Weisni/BatterySentinel-N2K/hardware/altium-r5/enclosure/README.md

# Orion R5 enclosure

The current enclosure uses the 52 x 36 mm Orion R5 PCB, independent PCB supports, screw-fastened service covers, continuous TPU seals and a replaceable cable cartridge.

- [Printing, hardware, assembly and acceptance checks](sealed-print/README.md).
- [Prepared Bambu P2S four-plate project](sealed-print/Orion-R5-P2S-flush-colour.3mf) with a flush two-colour PETG lid and separate PETG/TPU trial plates.
- [Plate and filament setup](sealed-print/flush-colour/README.md).
- [Illustrated assembly manual](../../../output/pdf/Orion-R5-Enclosure-Assembly-Manual-EN.pdf).
- [Optional P2S process presets](sealed-print/awesome-ai-profiles/README.md).

## Progress and open checks

CAD and native slicing checks are complete. Confirm the purchased inserts and screws, measure the delivered cable, print the trial pieces, and check the actual board and USB plug fit. Test cable retention and the empty enclosure for the intended splash exposure before fitting electronics. Closed-case temperature, radio reception and repeated service cycles remain physical acceptance work. No IP rating is claimed.
