Weisni/BatterySentinel-N2K/hardware/altium-r5/procurement/README.md

# PCB customs payment evidence

The [original DHL invoice](2026-09-30-DHL-PCB-customs-invoice.pdf), dated 2026-09-30, was supplied by the user as evidence for the paid PCB customs charge. It describes the shipment as "Layer 2 Printed circuit board" and totals **EUR 23.85**:

- Customs duty: EUR 6.00.
- Duty Tax Processing: EUR 15.00 plus EUR 2.85 VAT, totaling EUR 17.85.

Payment is confirmed by the user's instruction; the PDF itself is an invoice and contains no separate payment confirmation. The original file is preserved unchanged and contains personal billing details.

The EUR 23.85 was already included in the project's **EUR 196.64** recorded costs and is counted once. Confirmed paid costs are now **EUR 122.27**; Amazon costs of EUR 74.37 remain payment-unconfirmed. See the [procurement record](../lcsc-order-2026-09-24.md) and [project cost table](../../../README.md#recorded-procurement-costs).

Completed: archived the original invoice, verified identical SHA-256 hashes, and reconciled payment status on 2026-09-30. No further task remains for this evidence attachment. Delivery inspection, assembly and physical acceptance remain tracked in the [hardware README](../README.md#open-work).
