Weisni/BatterySentinel-N2K/output/internal/engineering/README.md

# Internal engineering exports

These drawings are preserved design studies, not released product documentation or evidence of built hardware. Use the current Orion Bridge manuals under `output/pdf` for installation and assembly.

- [Initial interface and PCB drawing study](orion-bridge-schaltplan-pcb-entwurf.pdf).
- [Project-internal records](../../../docs/internal/README.md).

The drawing PDF was relocated without changing its contents. Its generator now writes here so future engineering runs keep it out of the user-manual folder.
