Weisni/BatterySentinel-N2K/output/firmware/1.1.0/README.md

# Project-internal firmware test archive — 1.1.0

This folder preserves an engineering test state. It is not a current user
release or a record of another hardware product. For installation, use the
[current Orion Bridge download](../1.1.4/README.md).

Preserves the SuperMini HTTPS OTA round-trip test build, including the original file hash and the recorded settings-retention checks.

- Archived SuperMini test artifact: [orion-dongle-1.1.0.bin](orion-dongle-1.1.0.bin).
- File size: 1,768,416 bytes.
- Local artifact checksum: [SHA256SUMS.txt](SHA256SUMS.txt).
- Exact original notes and checksum records: [internal archive index](../../internal/firmware/README.md).

```text
bd076a146cf98d6f0851fad0ee62fd6c4aa47f4bf6652cbbfb0eb98cb3d6e003
```

The original records were retained without editing. Any installation language or
hardware comparisons inside those snapshots are historical internal notes,
not current download instructions or evidence of existing alternative hardware.
