Weisni/BatterySentinel-N2K/output/firmware/1.1.1/README.md

# Project-internal firmware test archive — 1.1.1

This folder preserves an engineering test state. It is not a current user
release or a record of another hardware product. For installation, use the
[current Orion Bridge download](../1.1.4/README.md).

Preserves the SuperMini password-verification and portal-request scheduling test build, including the measured performance and installed-image record.

- Archived SuperMini test artifact: [orion-dongle-1.1.1.bin](orion-dongle-1.1.1.bin).
- File size: 1,773,216 bytes.
- Local artifact checksum: [SHA256SUMS.txt](SHA256SUMS.txt).
- Exact original notes and checksum records: [internal archive index](../../internal/firmware/README.md).

```text
8ff55342b3527455e586c338b41baa7d8ab720cb11f0bdb1c1ce43f1e6752552
```

The original records were retained without editing. Any installation language or
hardware comparisons inside those snapshots are historical internal notes,
not current download instructions or evidence of existing alternative hardware.
