Weisni/BatterySentinel-N2K/output/firmware/1.1.2/README.md

# Project-internal firmware test archive — 1.1.2

This folder preserves an engineering test state. It is not a current user
release or a record of another hardware product. For installation, use the
[current Orion Bridge download](../1.1.4/README.md).

Preserves the SuperMini local-address, certificate and service-Wi-Fi test build. Its recorded LED behavior belongs to that historical firmware state.

- Archived SuperMini test artifact: [orion-dongle-1.1.2.bin](orion-dongle-1.1.2.bin).
- File size: 1,804,992 bytes.
- Local artifact checksum: [SHA256SUMS.txt](SHA256SUMS.txt).
- Exact original notes and checksum records: [internal archive index](../../internal/firmware/README.md).

```text
1db128bc51b3b4618e80536fa53f0aa17adc7aeb643bdfc37645b8c0b04135cc
```

The original records were retained without editing. Any installation language or
hardware comparisons inside those snapshots are historical internal notes,
not current download instructions or evidence of existing alternative hardware.
