Weisni/BatterySentinel-N2K/output/firmware/1.1.3/README.md

# Project-internal firmware test archive — 1.1.3

This folder preserves an engineering test state. It is not a current user
release or a record of another hardware product. For installation, use the
[current Orion Bridge download](../1.1.4/README.md).

Preserves the SuperMini password-change, BOOT-confirmed recovery and service-readiness LED test build. Build-time verification statements remain in the original record; they are not a claim about later installation or acceptance.

- Archived SuperMini test artifact: [orion-dongle-1.1.3.bin](orion-dongle-1.1.3.bin).
- File size: 1,823,184 bytes.
- Local artifact checksum: [SHA256SUMS.txt](SHA256SUMS.txt).
- Exact original notes and checksum records: [internal archive index](../../internal/firmware/README.md).

```text
5c0800e8cf8a0f70b3c1b042846b375c4ac750d5371a18a419056f80fb97735e
```

The original records were retained without editing. Any installation language or
hardware comparisons inside those snapshots are historical internal notes,
not current download instructions or evidence of existing alternative hardware.
