Weisni/BatterySentinel-N2K/docs/enclosure-filament-colours.md

# Enclosure filament colour shortlist

Research date: 2026-09-25. These are purchase candidates, not recorded purchases. Prices below are the displayed web listings, include the listing's VAT and exclude shipping; cached listings and destination tax can differ from checkout. Stock has not been guaranteed.

## Project palette

The current palette in `src/BridgePortalUi.h` and `assets/battery-sentinel-orion-logo.svg` is navy `#071521`, mint/teal `#68E3D1`, light blue `#8ABFFD`, and near-white `#F1F7F8`.

Recommended two-colour arrangement: navy PETG body and lid, mint PETG flush logo and lettering. White is an alternative marking colour. The current lid groups logo and lettering into one contrasting material; independently colouring them would require another artwork split.

## Purchase candidates

All selected variants use 1.75 mm PETG. RAL references are manufacturer declarations, not conversions of the project's HEX codes or measured print matches.

| Role | Product and declared colour | Pack | Displayed price | Purchase link |
| --- | --- | --- | --- | --- |
| Body and lid | Extrudr PETG marine blue, RAL 5003 | 1.1 kg | EUR 19.50 promotional price on the Austrian listing, including Austrian VAT | [Exact manufacturer variant](https://www.extrudr.com/de/at/products/petg/?variant=UHJvZHVjdFZhcmlhbnQ6MTU4NQ%3D%3D) |
| Logo and lettering | Devil Design PETG Mint, RAL 6027 | 1 kg | EUR 21.90 | [Filamentoes](https://filamentoes.de/products/petg-mint-minze-1-kg-devil-design-filament-1-75-mm) |
| Alternative lettering | Devil Design PETG White, RAL 9003 | 1 kg | EUR 21.90 | [Filamentoes](https://filamentoes.de/products/petg-white-weiss-1-kg-devil-design-filament-1-75-mm) |

Extrudr's [German product page](https://extrudr.com/de/de/products/petg/) also offers the marine-blue selection; select marine blue, 1.75 mm and 1.1 kg. The exact Austrian variant identifies SKU 9010241023141. Its displayed price is not a confirmed German checkout total. The [Devil Design product card](https://devildesign.com/download/PET-G_-_product_card.pdf), page 2, identifies Mint as RAL 6027 and White as RAL 9003.

Marine blue and Mint are practical aesthetic approximations. Marine blue is brighter than the nearly black portal navy, and Mint is more muted than the luminous screen teal. No exact printed match is claimed and no unverified filament HEX values are assigned.

## Progress and open checks

- Palette checked against the current project source; manufacturer colour references and purchase listings located.
- Current 3MF remains unchanged. In the existing mapping, rigid PETG is slot 1, TPU is slot 2, and contrasting PETG is slot 3.
- Before printing the full lid, test the chosen PETG combination for adhesion, opacity through the existing 0.4 mm artwork depth, and purge settings. Keep the existing separate TPU gasket workflow.
- Physical colour, print fit, sealing and enclosure acceptance remain unverified.
