Weisni/BatterySentinel-N2K/output/releases/RELEASE-STATUS.md

# Project-internal hardware export archive

This directory contains historical engineering ZIP exports and verification
records for the unbuilt R4 WROOM design. These files are not user downloads,
manufacturing instructions for the actual device, or evidence of an existing or
previously released hardware product. Do not order or assemble these archives.
The ZIP files, checksum list and verification record remain unchanged.

## Current Orion Bridge status — 2026-10-10

Parts were ordered and PCB manufacture commissioned on 2026-09-25. The user
reported the first Orion-R5 assembled on 2026-10-10, with USB, service Wi-Fi and
portal setup working. Initial 12 V operation without CAN is reported; complete
power/isolation, enclosure and NMEA/Garmin acceptance remain open.
See the [current hardware record](../../hardware/altium-r5/README.md) and
[procurement report](../../hardware/altium-r5/lcsc-order-2026-09-24.md).

[Firmware 1.2.0 is officially published](https://github.com/Weisni/BatterySentinel-N2K/releases/tag/v1.2.0)
as Latest; [its publication record](../../docs/releases/1.2.0-verification.md)
records exact-commit CI and six verified public downloads. Software publication
does not complete hardware commissioning. The [current issue status](../../docs/internal/backlog-status-2026-10-10.md)
distinguishes remaining work from superseded concepts. None of this alters or
approves the archived hardware ZIPs.

## Preserved historical status

The exact previous text is retained in
[RELEASE-STATUS-before-cleanup-2026-09-26.txt](RELEASE-STATUS-before-cleanup-2026-09-26.txt).
Its references to withdrawn packages and ongoing planning are historical
internal notes. They must not be read as the current procurement state or as a
list of actual hardware products.
