Weisni/BatterySentinel-N2K/assets/branding/battery-sentinel.png

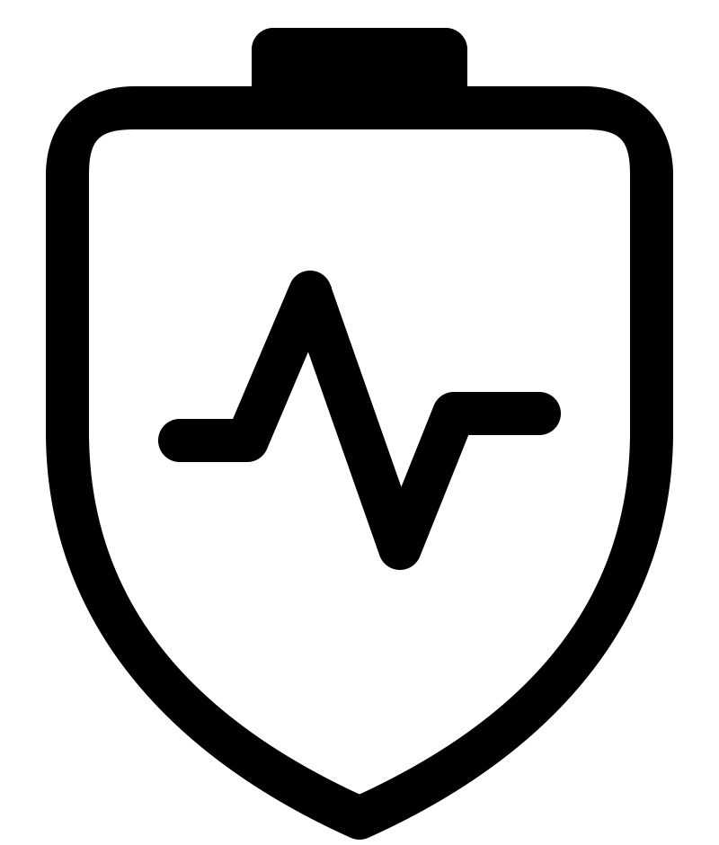
assets/branding/battery-sentinel.png
