Weisni/BatterySentinel-N2K/assets/branding/branding-preview.png

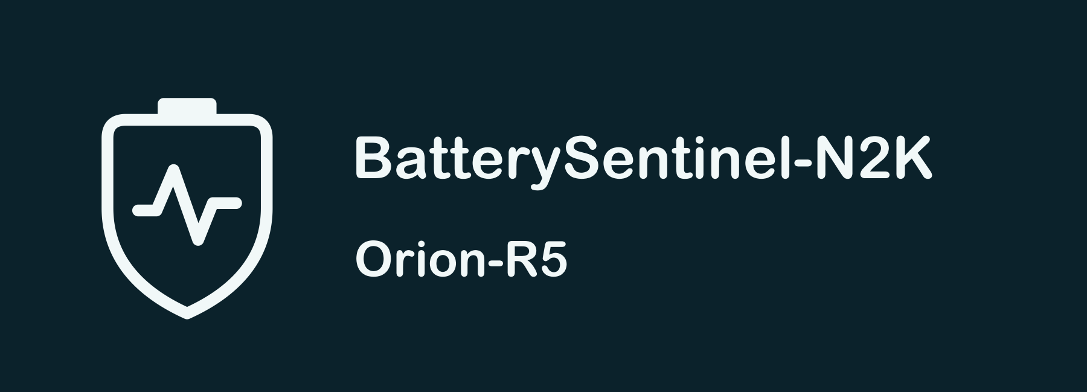
assets/branding/branding-preview.png
