Weisni/BatterySentinel-N2K/docs/manual-assets/portal-overview.png

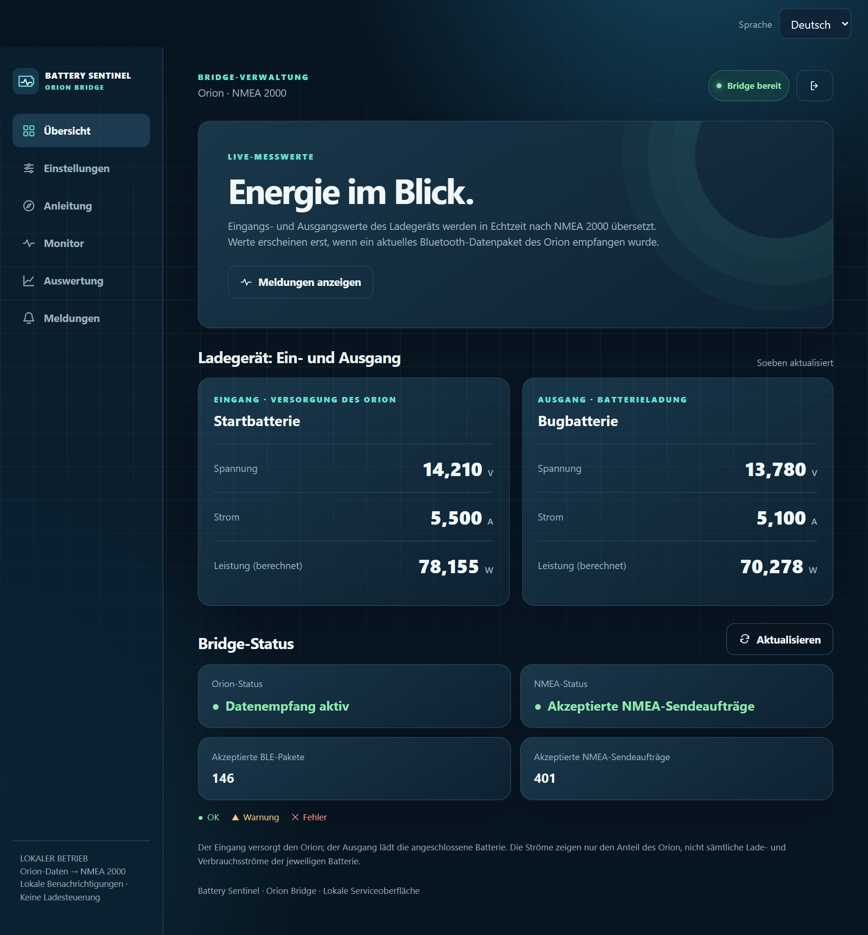
docs/manual-assets/portal-overview.png
