Weisni/BatterySentinel-N2K/hardware/altium-r2/Schaltplan-R2-Vorschau.png

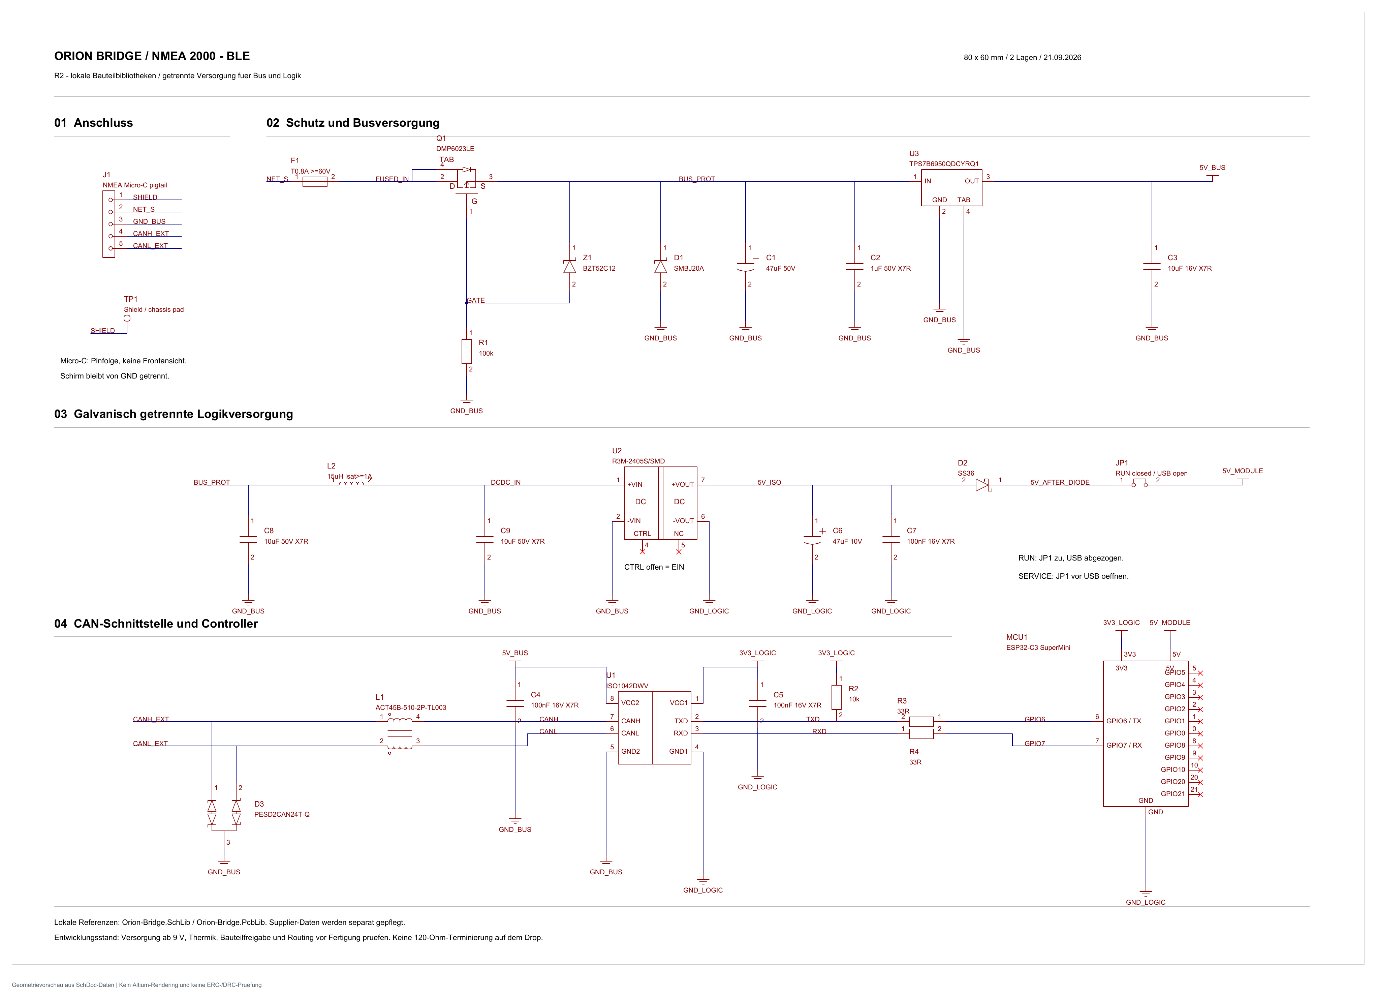
hardware/altium-r2/Schaltplan-R2-Vorschau.png
