Weisni/BatterySentinel-N2K/hardware/altium-r3/Altium-Schaltplan-PCB-Abgleich.png

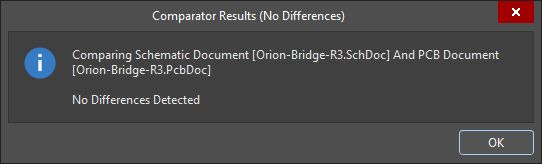
hardware/altium-r3/Altium-Schaltplan-PCB-Abgleich.png
