Weisni/BatterySentinel-N2K/hardware/altium-r3/Leiterplatte-R3-Kupfer.png

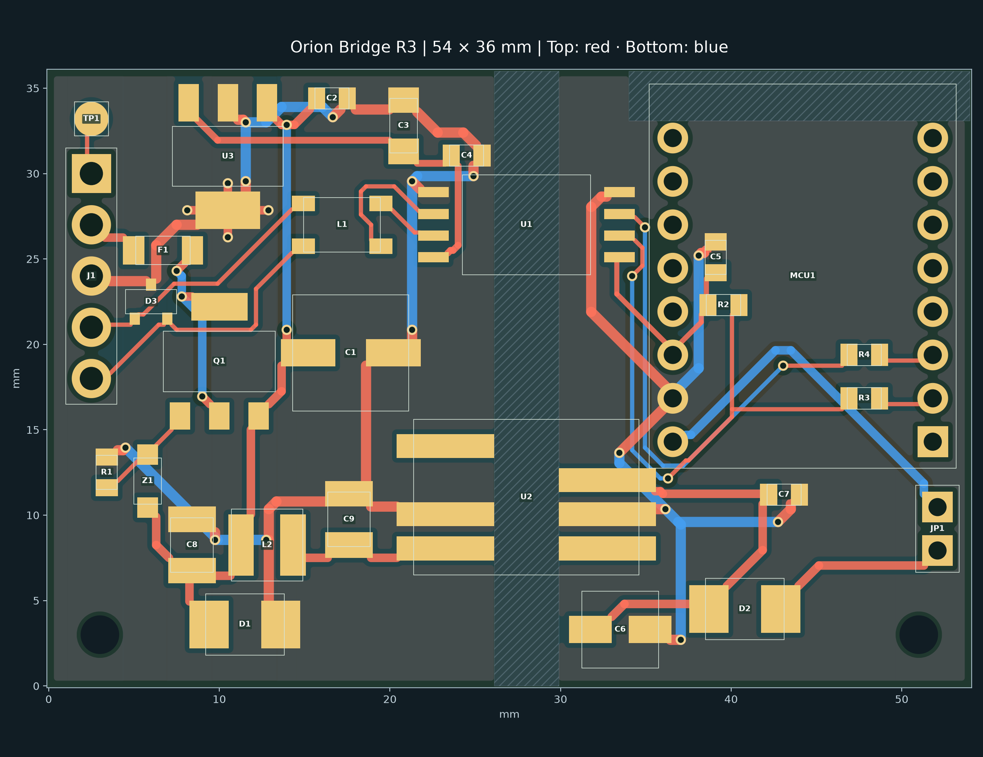
hardware/altium-r3/Leiterplatte-R3-Kupfer.png
