Weisni/BatterySentinel-N2K/hardware/altium-r3/PCB-R3-3D-Draufsicht.png

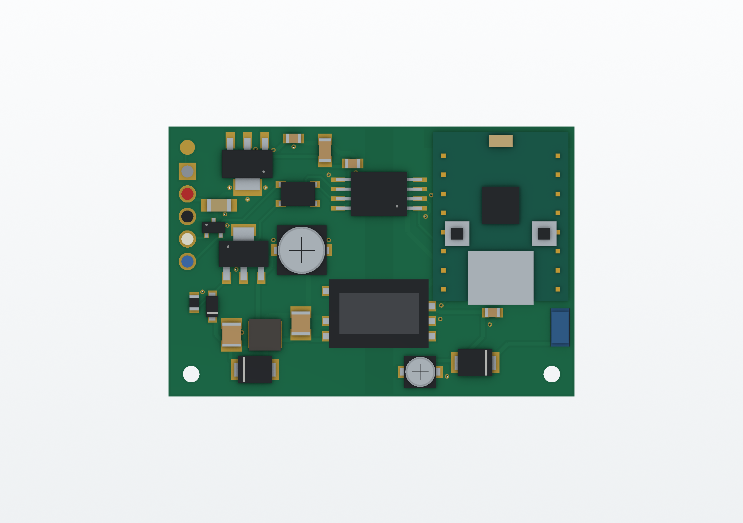
hardware/altium-r3/PCB-R3-3D-Draufsicht.png
