Weisni/BatterySentinel-N2K/hardware/altium-r3/PCB-R3-3D-Unterseite.png

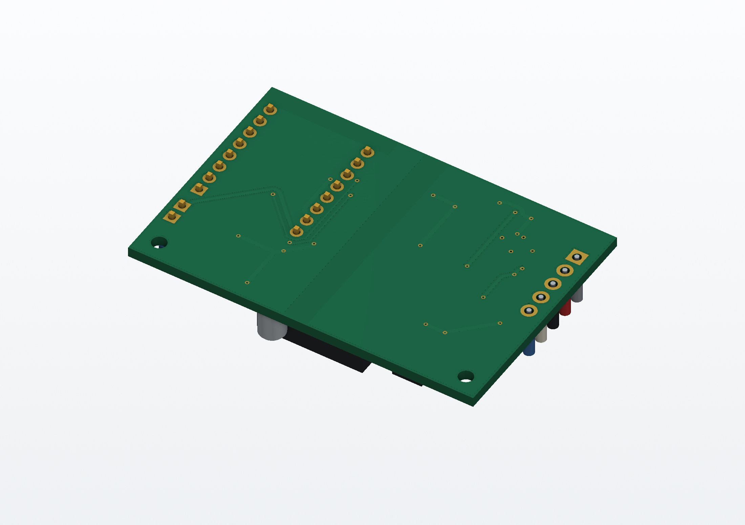
hardware/altium-r3/PCB-R3-3D-Unterseite.png
