Weisni/BatterySentinel-N2K/hardware/altium-r4/3d-views/PCB-R4-3D-Unterseite.png

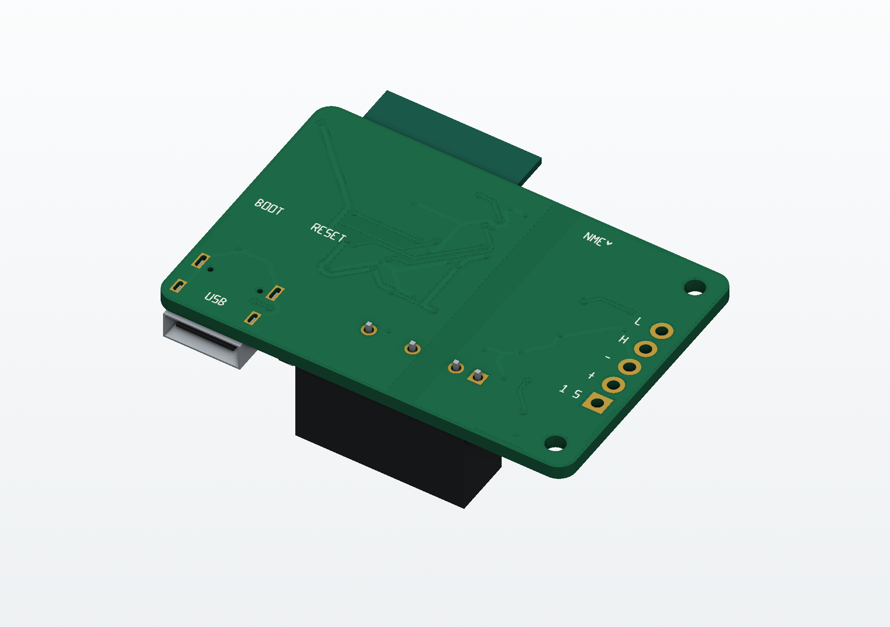
hardware/altium-r4/3d-views/PCB-R4-3D-Unterseite.png
