Weisni/BatterySentinel-N2K/hardware/altium-r4/Schaltplan-R4-Logic.png

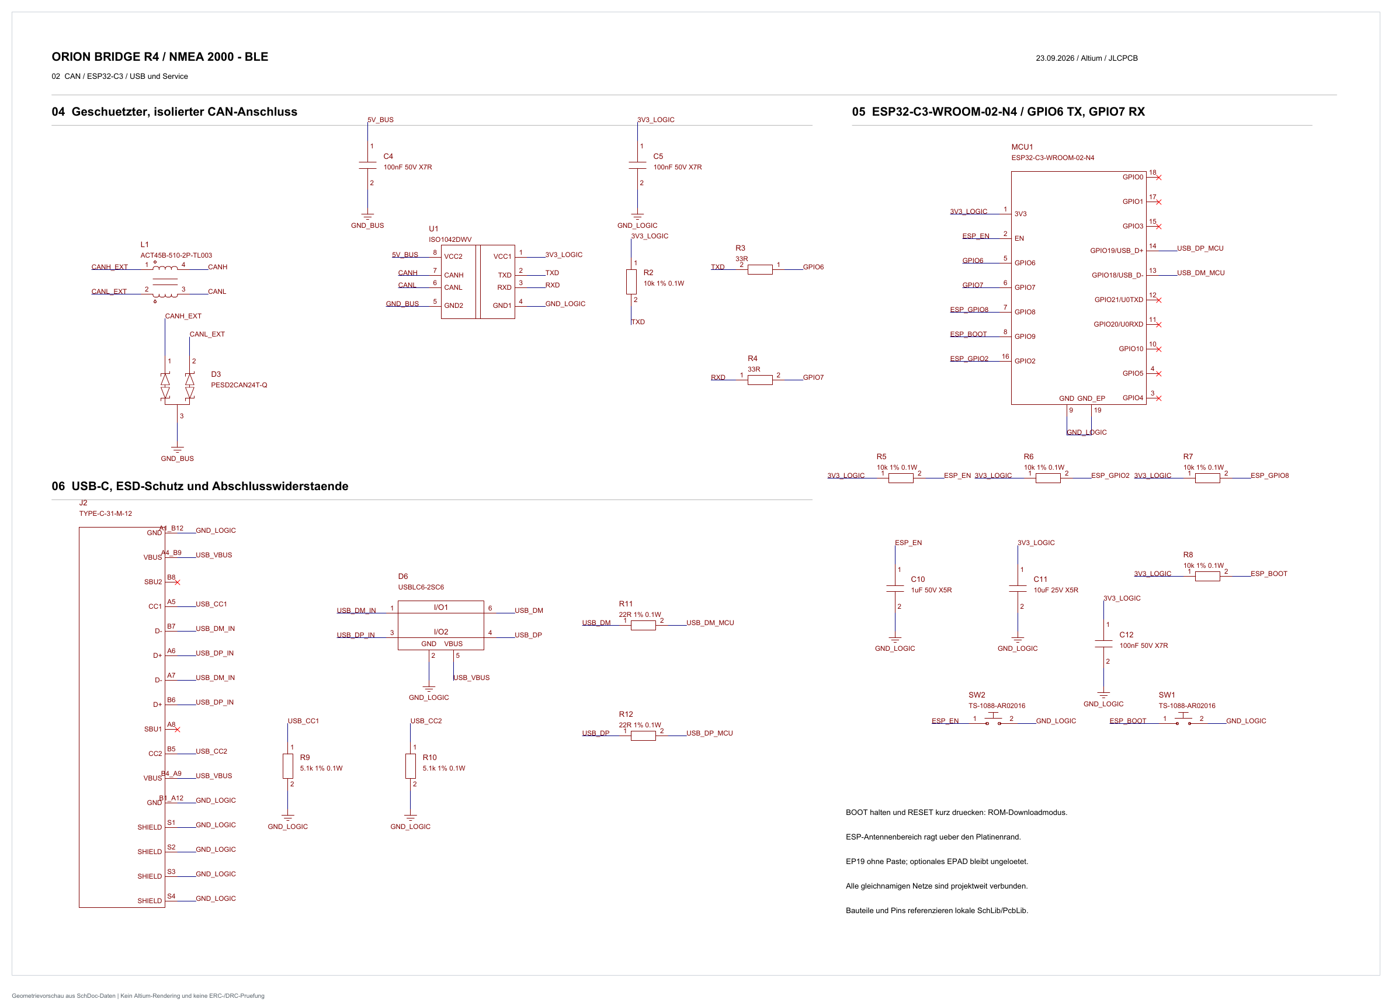
hardware/altium-r4/Schaltplan-R4-Logic.png
