Weisni/BatterySentinel-N2K/hardware/altium-r4/Schaltplan-R4-Power.png

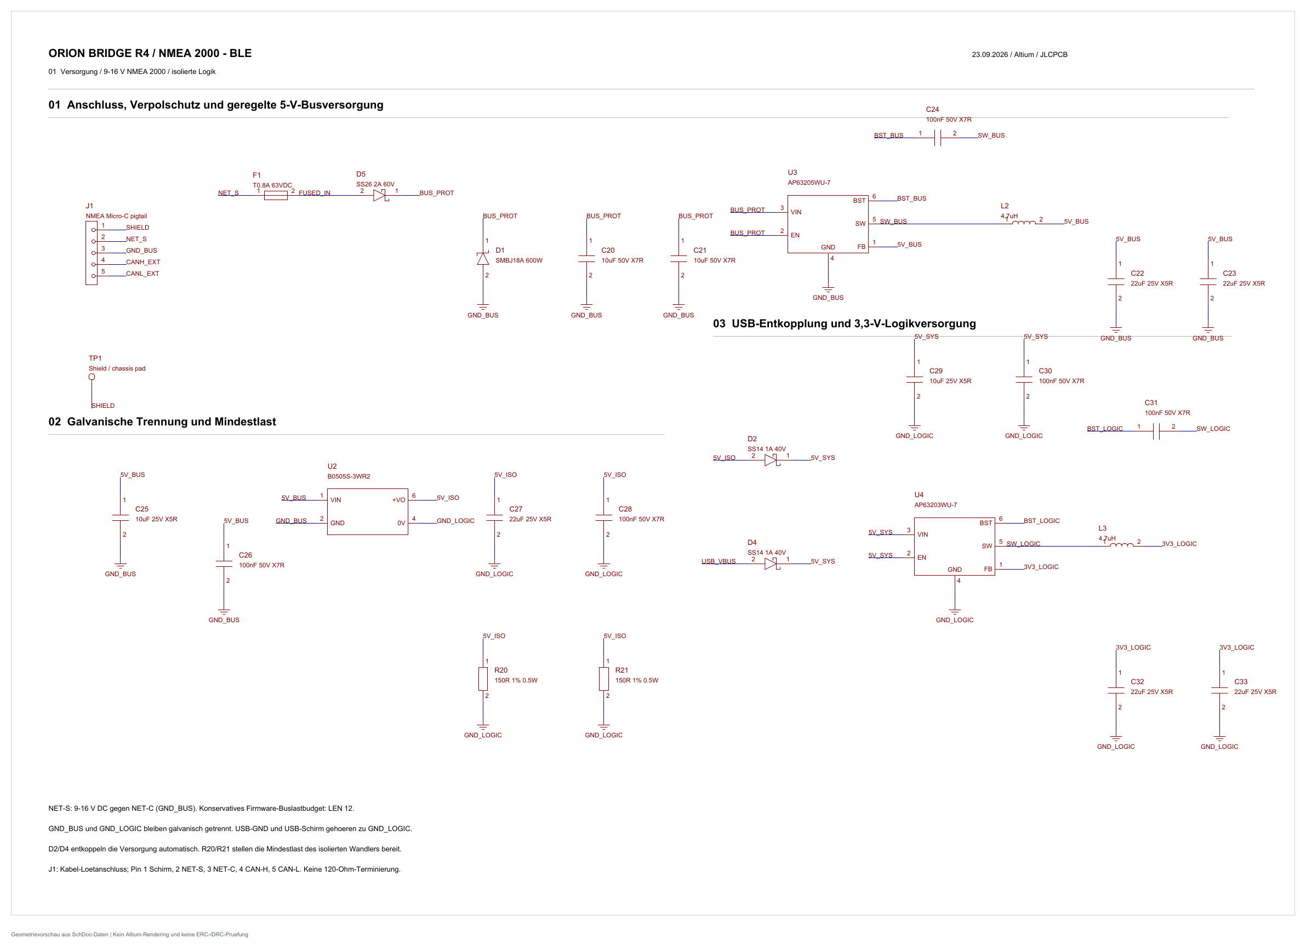
hardware/altium-r4/Schaltplan-R4-Power.png
