Weisni/BatterySentinel-N2K/hardware/altium-r5/enclosure/enclosure-closed.png

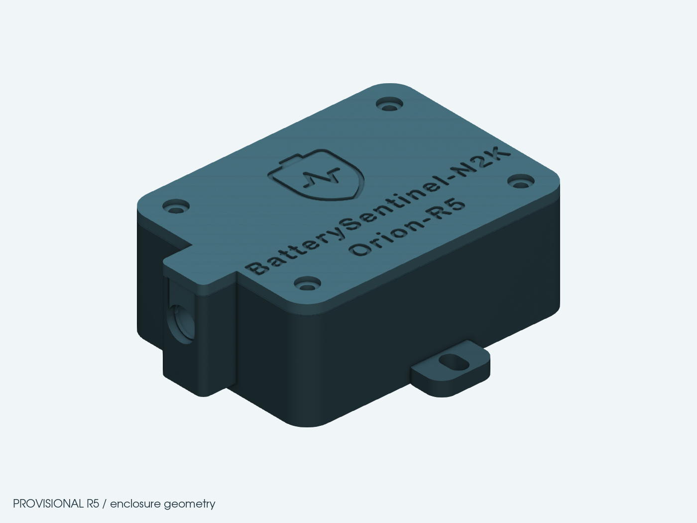
hardware/altium-r5/enclosure/enclosure-closed.png
