Weisni/BatterySentinel-N2K/hardware/altium-r5/enclosure/enclosure-exploded.png

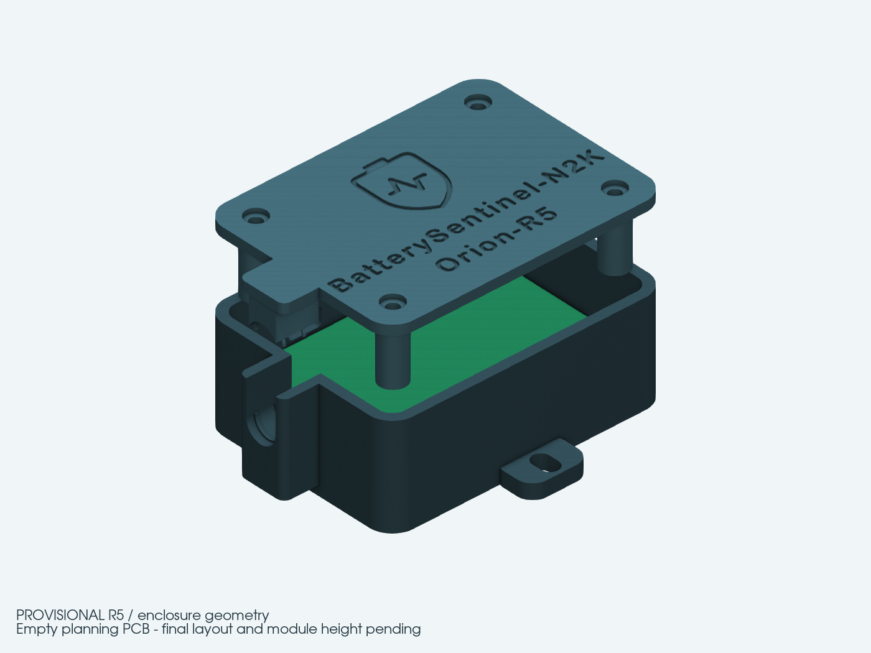
hardware/altium-r5/enclosure/enclosure-exploded.png
