Weisni/BatterySentinel-N2K/hardware/altium-r5/enclosure/enclosure-ports.png

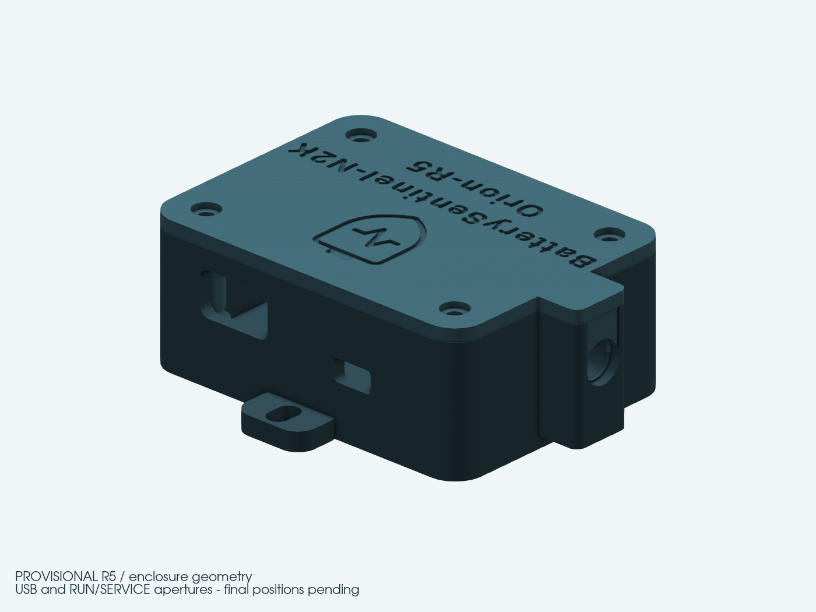
hardware/altium-r5/enclosure/enclosure-ports.png
