Weisni/BatterySentinel-N2K/hardware/altium-r5/references/amazon-B0FN4F6244-main.jpg

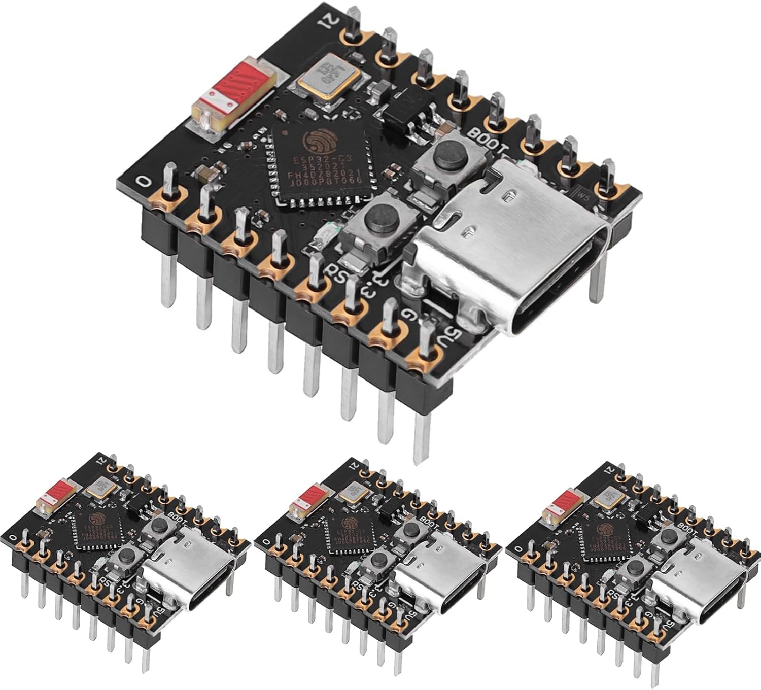
hardware/altium-r5/references/amazon-B0FN4F6244-main.jpg
