Weisni/BatterySentinel-N2K/hardware/altium-r5/references/amazon-B0FN4F6244-rejected-S3-pinout.jpg

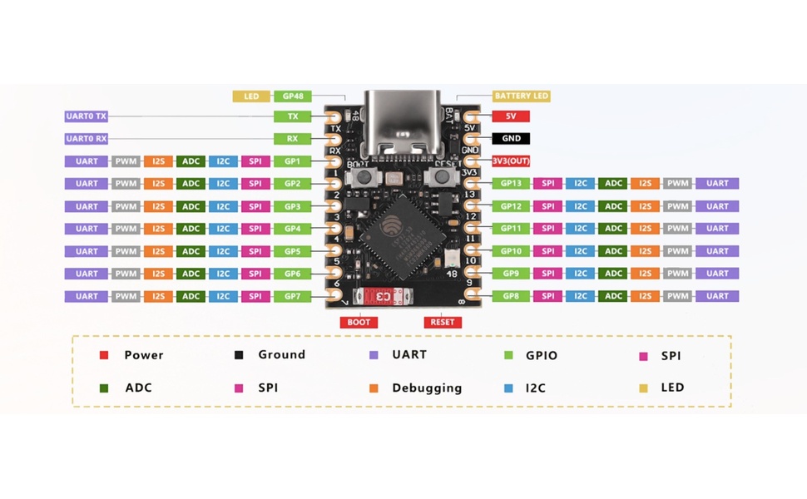
hardware/altium-r5/references/amazon-B0FN4F6244-rejected-S3-pinout.jpg
