Weisni/BatterySentinel-N2K/hardware/altium/PCB-Vorschau.png

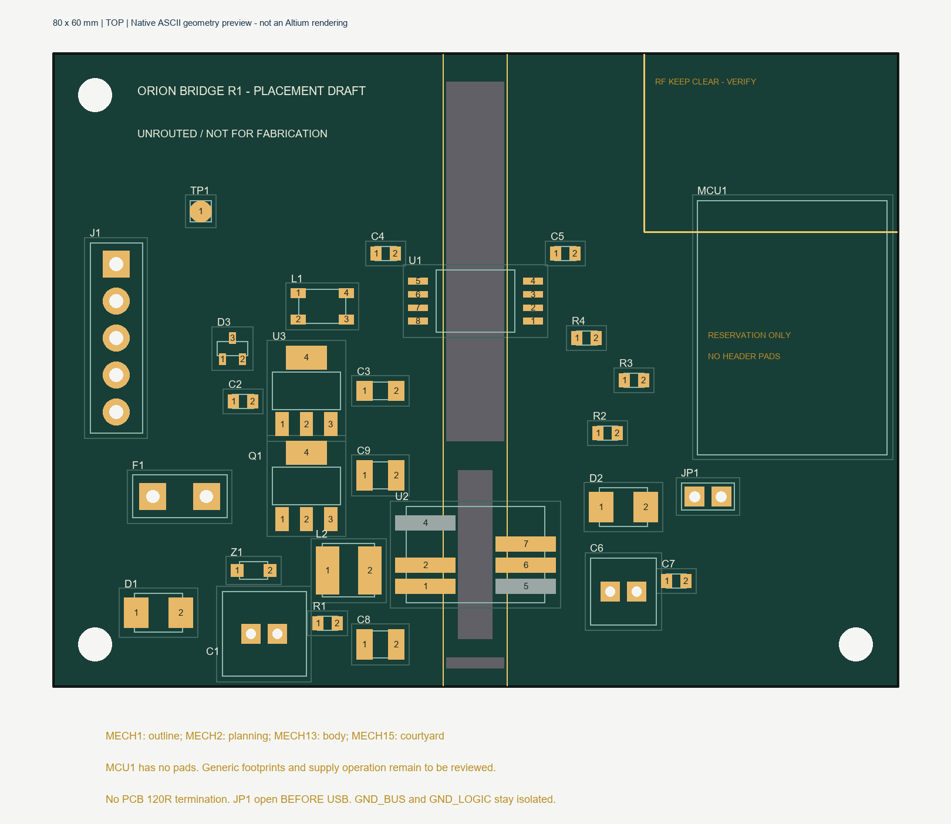
hardware/altium/PCB-Vorschau.png
