Weisni/BatterySentinel-N2K/hardware/altium/Schaltplan-Vorschau.png

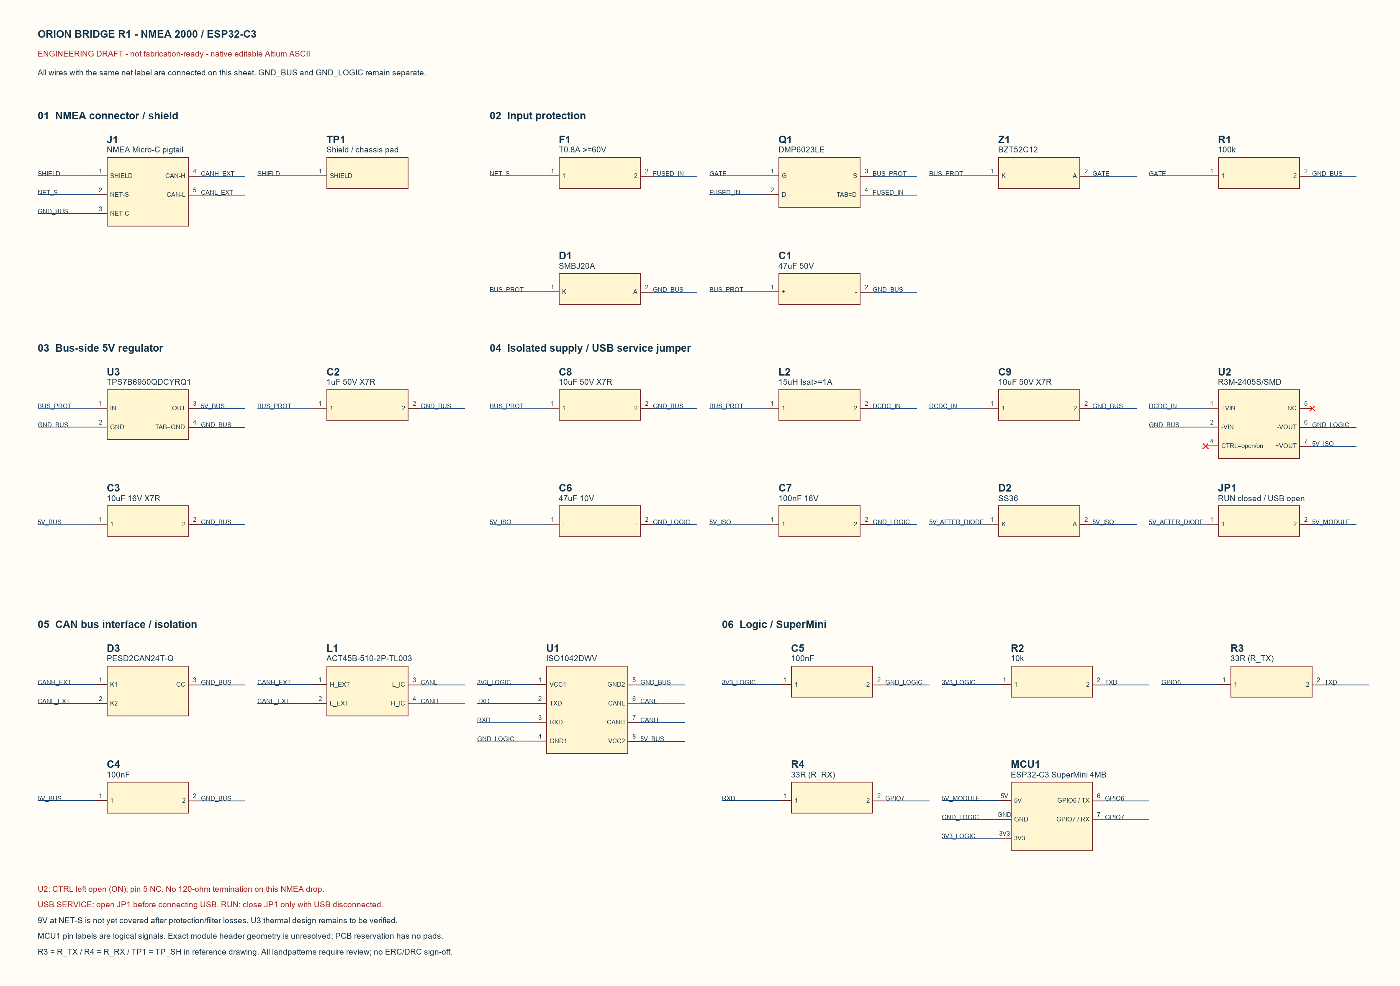
hardware/altium/Schaltplan-Vorschau.png
