Weisni/BatterySentinel-N2K/hardware/orion-dongle-nmea2000-schematic.png

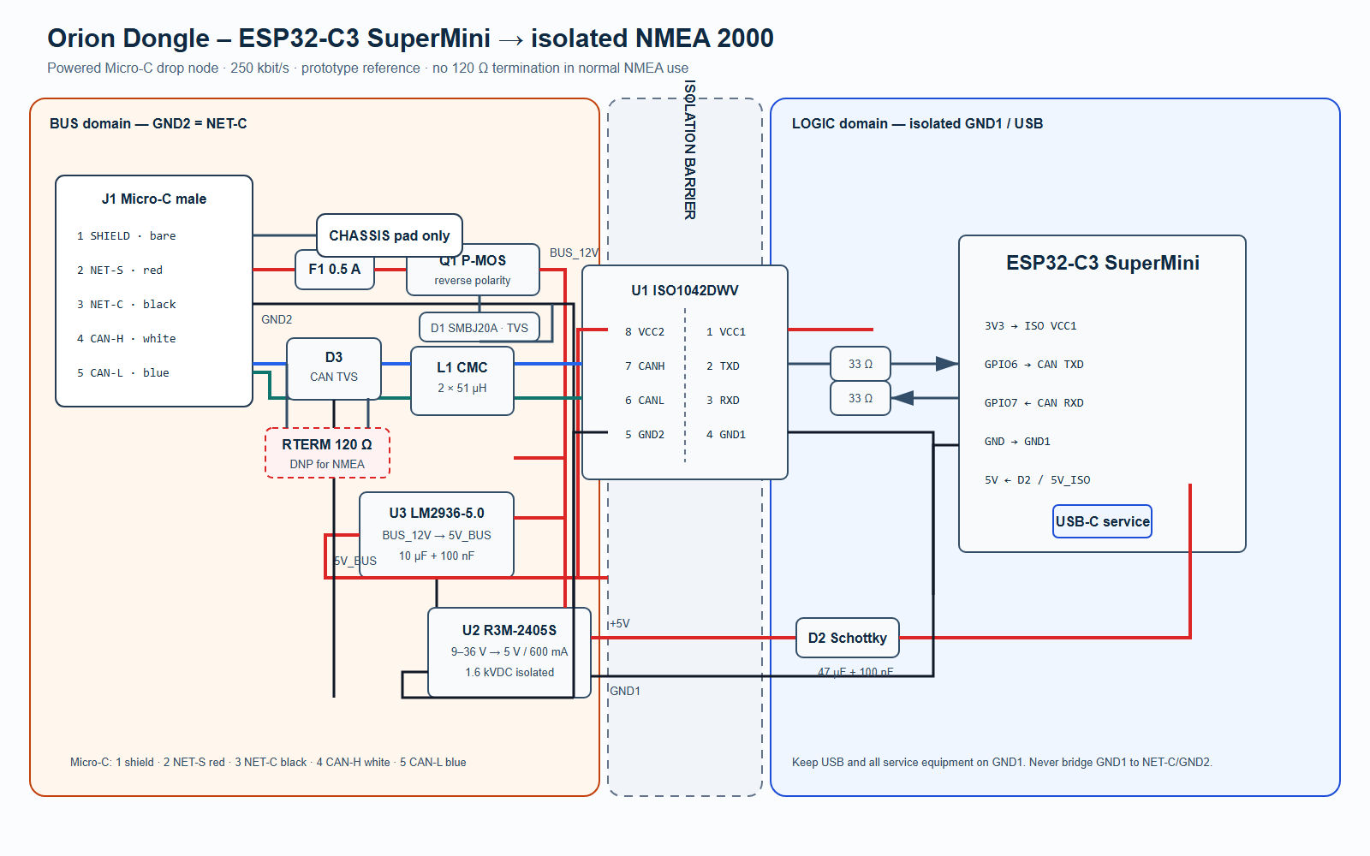
hardware/orion-dongle-nmea2000-schematic.png
