Weisni/BatterySentinel-N2K/output/Kabeltuelle_und_Klemmoberteil_Korrigiert.png

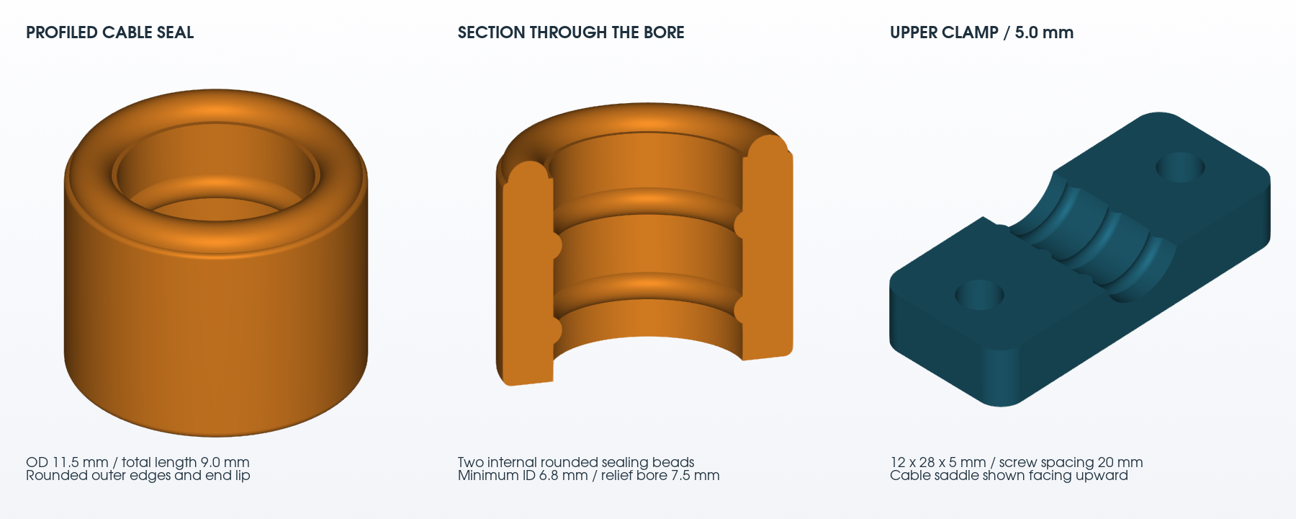
output/Kabeltuelle_und_Klemmoberteil_Korrigiert.png
