Weisni/BatterySentinel-N2K/output/Orion-Enclosure-V2.2-Preview.png

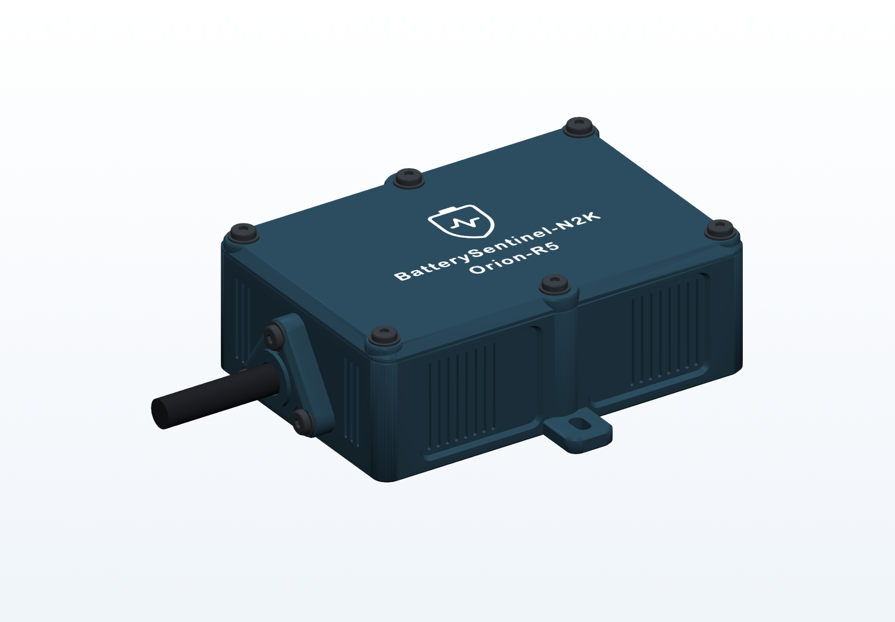
output/Orion-Enclosure-V2.2-Preview.png
