Weisni/BatterySentinel-N2K/output/releases/Orion-Bridge-R4-PCBA/JLCPCB-Panel/Panel-70x70.png

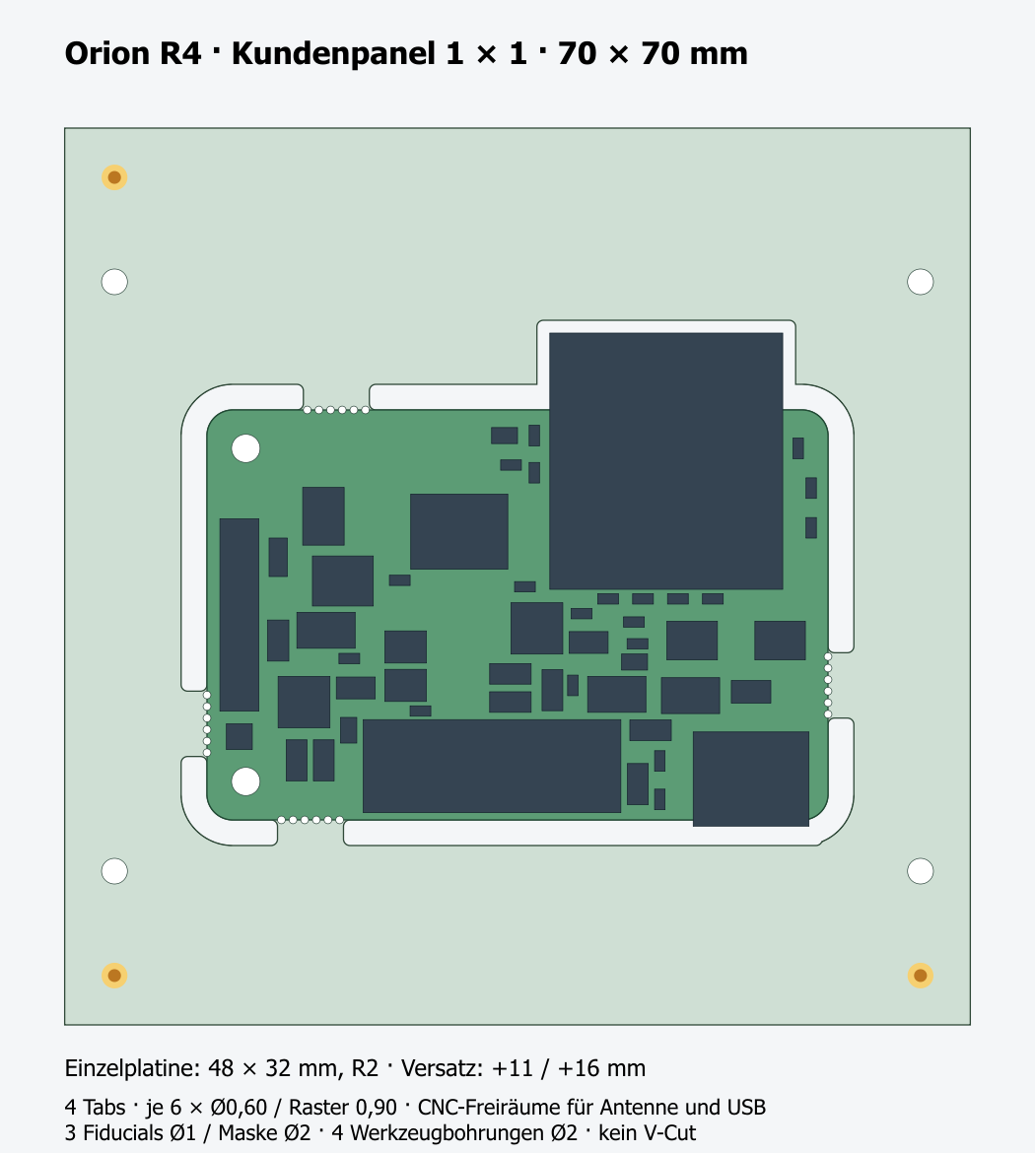
output/releases/Orion-Bridge-R4-PCBA/JLCPCB-Panel/Panel-70x70.png
