Weisni/BatterySentinel-N2K/hardware/altium-r4/manufacturing/BOM-JLCPCB.csv

Comment | Designator | Footprint | LCSC Part #
100nF 50V X7R | C4,C5,C24,C26,C28,C30,C31,C12 | C0603 | C14663
10k 1% 0.1W | R2,R5,R6,R7,R8 | R0603 | C25804
10uF 25V X5R | C25,C29,C11 | C0805 | C15850
10uF 50V X7R | C20,C21 | C1210 | C138687
150R 1% 0.5W | R20,R21 | R1206 | C4258541
1uF 50V X5R | C10 | C0603 | C15849
22R 1% 0.1W | R11,R12 | R0603 | C23345
22uF 25V X5R | C22,C23,C27,C32,C33 | C1206 | C12891
33R | R3,R4 | R0603 | C23140
4.7uH | L2,L3 | SUNLORD_SWPA4030 | C57269
5.1k 1% 0.1W | R9,R10 | R0603 | C23186
ACT45B-510-2P-TL003 | L1 | ACT45B | C76584
AP63203WU-7 | U4 | TSOT26_DIODES | C780769
AP63205WU-7 | U3 | TSOT26_DIODES | C2071056
B0505S-3WR2 | U2 | EVISUN_B0505S_3WR2 | C7500927
ESP32-C3-WROOM-02-N4 | MCU1 | ESP32_C3_WROOM_02 | C2934560
ISO1042DWV | U1 | SOIC8_DWV | C2671714
PESD2CAN24T-Q | D3 | SOT23_NEXPERIA_REFLOW | C28933048
SMBJ18A 600W | D1 | SMB | C152104
SS14 1A 40V | D2,D4 | SMA | C2480
SS26 2A 60V | D5 | SMA | C14238
T0.8A 63VDC | F1 | BOURNS_SF1206S | C3032873
TS-1088-AR02016 | SW1,SW2 | SW_XUNPU_TS1088_AR | C720477
TYPE-C-31-M-12 | J2 | USB_C_HRO_TYPE_C_31_M_12_2020 | C165948
USBLC6-2SC6 | D6 | SOT23_6_ST_USBLC6 | C7519
