Weisni/BatterySentinel-N2K/hardware/altium-r4/manufacturing/BOM-EXCLUDED.csv

Designator | Comment | Reason
J1 | NMEA Micro-C pigtail | Explicitly excluded from assembly
TP1 | Shield / chassis pad | Explicitly excluded from assembly
