Weisni/BatterySentinel-N2K/hardware/altium-r5/Project Outputs/Hand Assembly/source-references/Bill of Materials-BatterySentinel-N2K-Orion-R5.xlsx

Name | Description | Designator | Footprint | LibRef | Quantity
100nF 50V X7R | 100nF 16V X7R - generic specification; manufacturer/MPN not selected, 100nF 50V X7R | C4, C5, C24, C26, C28, C30, C31 | C0603 | R5_C4_100nF, R5_C5_100nF, R5_C24_100nF, R5_C26_100nF, R5_C28_100nF, R5_C30_100nF, R5_C31_100nF | 7
10uF 50V X7R | 10uF 50V X7R | C20, C21 | C1210 | R5_C20_10uF, R5_C21_10uF | 2
22uF 25V X5R | 22uF 25V X5R | C22, C23, C27, C32, C33 | C1206 | R5_C22_22uF, R5_C23_22uF, R5_C27_22uF, R5_C32_22uF, R5_C33_22uF | 5
10uF 25V X5R | 10uF 25V X5R, 10uF local module5V reservoir after RUN/SERVICE switch | C25, C29, C34 | C0805 | R5_C25_10uF, R5_C29_10uF, R5_C34_10uF | 3
SMBJ18A 600W | SMBJ18A 600W | D1 | SMB | R5_D1_SMBJ18A | 1
PESD2CAN24T-Q | PESD2CAN24T-Q | D3 | SOT23_NEXPERIA_REFLOW | R5_D3_PESD2CAN24T_Q | 1
SS26 2A 60V | SS26 2A 60V | D5 | SMA | R5_D5_SS26 | 1
T0.8A 63VDC | 0.8 A slow-blow SMD ceramic fuse, 63 VDC, 50 A interrupt rating | F1 | BOURNS_SF1206S | R5_F1_T0.8A | 1
NMEA Micro-C pigtail | Five direct wire-solder pads for a separately selected Micro-C cable; this is a PCB interface, not an invented connector MPN or face view | J1 | PIGTAIL_5_P3_D1P3 | R5_J1_NMEA | 1
ACT45B-510-2P-TL003 | ACT45B-510-2P-TL003 | L1 | ACT45B | R5_L1_ACT45B_510_2P_TL003 | 1
4.7uH | 4.7uH | L2, L3 | SUNLORD_SWPA4030 | R5_L2_4.7uH, R5_L3_4.7uH | 2
ESP32-C3 SuperMini | User-selected C3 SuperMini; original onboard USB/BOOT/RESET; direct castellated solder mounting | MCU1 | SUPERC3_B0FN4F6244_CAST16_SMD | R5_MCU1_ESP32_C3 | 1
10k 1% 0.1W | 10k - generic specification; manufacturer/MPN not selected | R2 | R0603 | R5_R2_10k | 1
33R | 33R - generic specification; manufacturer/MPN not selected | R3, R4 | R0603 | R5_R3_33R, R5_R4_33R | 2
150R 1% 0.5W | 150R 1% 0.5W | R20, R21 | R1206 | R5_R20_150R, R5_R21_150R | 2
RUN / SERVICE | Side-actuated SPDT service supply disconnect, 1A at6V, original SuperMini USB service | SW3 | GSWITCH_MK12C02_G020 | R5_SW3_RUN | 1
Shield / chassis pad | Shield / chassis pad - generic specification; manufacturer/MPN not selected | TP1 | TESTPOINT_2MM | R5_TP1_Shield | 1
ISO1042DWV | ISO1042DWV | U1 | SOIC8_DWV | R5_U1_ISO1042DWV | 1
B0505S-3WR2 | B0505S-3WR2 | U2 | EVISUN_B0505S_3WR2 | R5_U2_B0505S_3WR2 | 1
AP63205WU-7 | AP63205WU-7, Isolated-side 5V buck / high-duty pass-through, feeding physical RUN/SERVICE disconnect | U3, U4 | TSOT26_DIODES | R5_U3_AP63205WU_7, R5_U4_AP63205WU_7 | 2
