Weisni/BatterySentinel-N2K/hardware/altium-r5/Project Outputs/Hand Assembly/Release-Pad-Netlist.csv

Reference | Pad | Net | X mm | Y mm | Hole mm | Layer | Plated
J1 | 1 | SHIELD | 2.5000 | 10.0000 | 1.3000 | MULTILAYER | TRUE
J1 | 2 | NET_S | 2.5000 | 13.0000 | 1.3000 | MULTILAYER | TRUE
J1 | 3 | GND_BUS | 2.5000 | 16.0000 | 1.3000 | MULTILAYER | TRUE
J1 | 4 | CANH_EXT | 2.5000 | 19.0000 | 1.3000 | MULTILAYER | TRUE
J1 | 5 | CANL_EXT | 2.5000 | 22.0000 | 1.3000 | MULTILAYER | TRUE
U2 | 1 | 5V_BUS | 14.4200 | 6.8000 | 1.0000 | MULTILAYER | TRUE
U2 | 2 | GND_BUS | 16.9600 | 6.8000 | 1.0000 | MULTILAYER | TRUE
U2 | 4 | GND_LOGIC | 22.0400 | 6.8000 | 1.0000 | MULTILAYER | TRUE
U2 | 6 | 5V_ISO | 27.1200 | 6.8000 | 1.0000 | MULTILAYER | TRUE
Board mounting | Mechanical hole | NC | 3.0000 | 3.0000 | 2.2000 | MULTILAYER | FALSE
Board mounting | Mechanical hole | NC | 3.0000 | 33.0000 | 2.2000 | MULTILAYER | FALSE
Board mounting | Mechanical hole | NC | 49.0000 | 3.0000 | 2.2000 | MULTILAYER | FALSE
Board mounting | Mechanical hole | NC | 49.0000 | 33.0000 | 2.2000 | MULTILAYER | FALSE
SW3 | Mechanical hole | NC | 37.5000 | 33.5000 | 1.0000 | MULTILAYER | FALSE
SW3 | Mechanical hole | NC | 40.5000 | 33.5000 | 1.0000 | MULTILAYER | FALSE
TP1 | 1 | SHIELD | 3.0000 | 27.0000 | 0.0000 | TOP | TRUE
D3 | 1 | CANH_EXT | 6.5000 | 19.5500 | 0.0000 | TOP | TRUE
D3 | 2 | CANL_EXT | 6.5000 | 21.4500 | 0.0000 | TOP | TRUE
D3 | 3 | GND_BUS | 4.5000 | 20.5000 | 0.0000 | TOP | TRUE
L1 | 1 | CANH_EXT | 7.7500 | 21.4250 | 0.0000 | TOP | TRUE
L1 | 2 | CANL_EXT | 10.2500 | 21.4250 | 0.0000 | TOP | TRUE
L1 | 3 | CANL | 10.2500 | 25.9750 | 0.0000 | TOP | TRUE
L1 | 4 | CANH | 7.7500 | 25.9750 | 0.0000 | TOP | TRUE
U1 | 1 | 3V3_LOGIC | 24.9500 | 20.5950 | 0.0000 | TOP | TRUE
U1 | 2 | TXD | 24.9500 | 21.8650 | 0.0000 | TOP | TRUE
U1 | 3 | RXD | 24.9500 | 23.1350 | 0.0000 | TOP | TRUE
U1 | 4 | GND_LOGIC | 24.9500 | 24.4050 | 0.0000 | TOP | TRUE
U1 | 5 | GND_BUS | 14.0500 | 24.4050 | 0.0000 | TOP | TRUE
U1 | 6 | CANL | 14.0500 | 23.1350 | 0.0000 | TOP | TRUE
U1 | 7 | CANH | 14.0500 | 21.8650 | 0.0000 | TOP | TRUE
U1 | 8 | 5V_BUS | 14.0500 | 20.5950 | 0.0000 | TOP | TRUE
C4 | 1 | 5V_BUS | 14.1250 | 18.7000 | 0.0000 | TOP | TRUE
C4 | 2 | GND_BUS | 15.6750 | 18.7000 | 0.0000 | TOP | TRUE
C5 | 1 | 3V3_LOGIC | 23.8000 | 18.2000 | 0.0000 | TOP | TRUE
C5 | 2 | GND_LOGIC | 25.3500 | 18.2000 | 0.0000 | TOP | TRUE
R2 | 1 | 3V3_LOGIC | 25.2250 | 30.9000 | 0.0000 | TOP | TRUE
R2 | 2 | TXD | 26.7750 | 30.9000 | 0.0000 | TOP | TRUE
R3 | 1 | GPIO6 | 28.2250 | 30.9000 | 0.0000 | TOP | TRUE
R3 | 2 | TXD | 29.7750 | 30.9000 | 0.0000 | TOP | TRUE
R4 | 1 | RXD | 31.2250 | 32.2000 | 0.0000 | TOP | TRUE
R4 | 2 | GPIO7 | 32.7750 | 32.2000 | 0.0000 | TOP | TRUE
U3 | 1 | 5V_BUS | 10.5500 | 9.2000 | 0.0000 | TOP | TRUE
U3 | 2 | BUS_PROT | 11.5000 | 9.2000 | 0.0000 | TOP | TRUE
U3 | 3 | BUS_PROT | 12.4500 | 9.2000 | 0.0000 | TOP | TRUE
U3 | 4 | GND_BUS | 12.4500 | 11.4000 | 0.0000 | TOP | TRUE
U3 | 5 | SW_BUS | 11.5000 | 11.4000 | 0.0000 | TOP | TRUE
U3 | 6 | BST_BUS | 10.5500 | 11.4000 | 0.0000 | TOP | TRUE
U4 | 1 | 5V_REG | 39.3000 | 5.2500 | 0.0000 | TOP | TRUE
U4 | 2 | 5V_ISO | 40.2500 | 5.2500 | 0.0000 | TOP | TRUE
U4 | 3 | 5V_ISO | 41.2000 | 5.2500 | 0.0000 | TOP | TRUE
U4 | 4 | GND_LOGIC | 41.2000 | 7.4500 | 0.0000 | TOP | TRUE
U4 | 5 | SW_LOGIC | 40.2500 | 7.4500 | 0.0000 | TOP | TRUE
U4 | 6 | BST_LOGIC | 39.3000 | 7.4500 | 0.0000 | TOP | TRUE
L2 | 1 | SW_BUS | 9.0000 | 9.2000 | 0.0000 | TOP | TRUE
L2 | 2 | 5V_BUS | 6.0000 | 9.2000 | 0.0000 | TOP | TRUE
L3 | 1 | SW_LOGIC | 37.7500 | 7.4500 | 0.0000 | TOP | TRUE
L3 | 2 | 5V_REG | 34.7500 | 7.4500 | 0.0000 | TOP | TRUE
C20 | 1 | BUS_PROT | 13.7500 | 10.5000 | 0.0000 | TOP | TRUE
C20 | 2 | GND_BUS | 16.9500 | 10.5000 | 0.0000 | TOP | TRUE
C21 | 1 | BUS_PROT | 13.7500 | 13.5000 | 0.0000 | TOP | TRUE
C21 | 2 | GND_BUS | 16.9500 | 13.5000 | 0.0000 | TOP | TRUE
C22 | 1 | 5V_BUS | 6.9250 | 6.1500 | 0.0000 | TOP | TRUE
C22 | 2 | GND_BUS | 6.9250 | 3.1500 | 0.0000 | TOP | TRUE
C23 | 1 | 5V_BUS | 9.0250 | 6.1500 | 0.0000 | TOP | TRUE
C23 | 2 | GND_BUS | 9.0250 | 3.1500 | 0.0000 | TOP | TRUE
C24 | 1 | BST_BUS | 10.2250 | 12.6000 | 0.0000 | TOP | TRUE
C24 | 2 | SW_BUS | 11.7750 | 12.6000 | 0.0000 | TOP | TRUE
C25 | 1 | 5V_BUS | 10.9500 | 6.0500 | 0.0000 | TOP | TRUE
C25 | 2 | GND_BUS | 10.9500 | 7.9500 | 0.0000 | TOP | TRUE
C26 | 1 | 5V_BUS | 15.7250 | 8.5000 | 0.0000 | TOP | TRUE
C26 | 2 | GND_BUS | 17.2750 | 8.5000 | 0.0000 | TOP | TRUE
C27 | 1 | 5V_ISO | 26.7000 | 8.6250 | 0.0000 | TOP | TRUE
C27 | 2 | GND_LOGIC | 26.7000 | 11.6250 | 0.0000 | TOP | TRUE
C28 | 1 | 5V_ISO | 28.3250 | 9.2000 | 0.0000 | TOP | TRUE
C28 | 2 | GND_LOGIC | 29.8750 | 9.2000 | 0.0000 | TOP | TRUE
C29 | 1 | 5V_ISO | 42.8500 | 4.8250 | 0.0000 | TOP | TRUE
C29 | 2 | GND_LOGIC | 44.7500 | 4.8250 | 0.0000 | TOP | TRUE
C30 | 1 | 5V_ISO | 43.2500 | 6.2500 | 0.0000 | TOP | TRUE
C30 | 2 | GND_LOGIC | 44.8000 | 6.2500 | 0.0000 | TOP | TRUE
C31 | 1 | BST_LOGIC | 38.9250 | 8.6000 | 0.0000 | TOP | TRUE
C31 | 2 | SW_LOGIC | 40.4750 | 8.6000 | 0.0000 | TOP | TRUE
C32 | 1 | 5V_REG | 32.8000 | 3.9000 | 0.0000 | TOP | TRUE
C32 | 2 | GND_LOGIC | 35.8000 | 3.9000 | 0.0000 | TOP | TRUE
C33 | 1 | 5V_REG | 32.8000 | 1.7000 | 0.0000 | TOP | TRUE
C33 | 2 | GND_LOGIC | 35.8000 | 1.7000 | 0.0000 | TOP | TRUE
R20 | 1 | 5V_ISO | 22.1000 | 11.8000 | 0.0000 | TOP | TRUE
R20 | 2 | GND_LOGIC | 25.1000 | 11.8000 | 0.0000 | TOP | TRUE
R21 | 1 | 5V_ISO | 22.1000 | 14.4000 | 0.0000 | TOP | TRUE
R21 | 2 | GND_LOGIC | 25.1000 | 14.4000 | 0.0000 | TOP | TRUE
D1 | 1 | BUS_PROT | 12.5000 | 18.6500 | 0.0000 | TOP | TRUE
D1 | 2 | GND_BUS | 8.5000 | 18.6500 | 0.0000 | TOP | TRUE
D5 | 1 | BUS_PROT | 11.1650 | 14.8000 | 0.0000 | TOP | TRUE
D5 | 2 | FUSED_IN | 7.2350 | 14.8000 | 0.0000 | TOP | TRUE
F1 | 1 | NET_S | 5.5000 | 12.2750 | 0.0000 | TOP | TRUE
F1 | 2 | FUSED_IN | 5.5000 | 15.7250 | 0.0000 | TOP | TRUE
C34 | 1 | 5V_MODULE | 45.8500 | 7.8000 | 0.0000 | TOP | TRUE
C34 | 2 | GND_LOGIC | 47.7500 | 7.8000 | 0.0000 | TOP | TRUE
SW3 | 1 | 5V_REG | 36.7500 | 31.4250 | 0.0000 | TOP | TRUE
SW3 | 2 | 5V_MODULE | 38.2500 | 31.4250 | 0.0000 | TOP | TRUE
SW3 | 3 | NC | 41.2500 | 31.4250 | 0.0000 | TOP | TRUE
SW3 | 4 | GND_LOGIC | 35.2000 | 34.6350 | 0.0000 | TOP | TRUE
SW3 | 5 | GND_LOGIC | 35.2000 | 32.3650 | 0.0000 | TOP | TRUE
SW3 | 6 | GND_LOGIC | 42.8000 | 34.6350 | 0.0000 | TOP | TRUE
SW3 | 7 | GND_LOGIC | 42.8000 | 32.3650 | 0.0000 | TOP | TRUE
MCU1 | 5 | NC | 49.7006 | 28.6000 | 0.0000 | TOP | TRUE
MCU1 | 6 | GPIO6 | 47.1606 | 28.6000 | 0.0000 | TOP | TRUE
MCU1 | 7 | GPIO7 | 44.6206 | 28.6000 | 0.0000 | TOP | TRUE
MCU1 | 8 | NC | 42.0806 | 28.6000 | 0.0000 | TOP | TRUE
MCU1 | 9 | NC | 39.5406 | 28.6000 | 0.0000 | TOP | TRUE
MCU1 | 10 | NC | 37.0006 | 28.6000 | 0.0000 | TOP | TRUE
MCU1 | 20 | NC | 34.4606 | 28.6000 | 0.0000 | TOP | TRUE
MCU1 | 21 | NC | 31.9206 | 28.6000 | 0.0000 | TOP | TRUE
MCU1 | 5V | 5V_MODULE | 49.7006 | 11.4000 | 0.0000 | TOP | TRUE
MCU1 | GND | GND_LOGIC | 47.1606 | 11.4000 | 0.0000 | TOP | TRUE
MCU1 | 3V3 | 3V3_LOGIC | 44.6206 | 11.4000 | 0.0000 | TOP | TRUE
MCU1 | 4 | NC | 42.0806 | 11.4000 | 0.0000 | TOP | TRUE
MCU1 | 3 | NC | 39.5406 | 11.4000 | 0.0000 | TOP | TRUE
MCU1 | 2 | NC | 37.0006 | 11.4000 | 0.0000 | TOP | TRUE
MCU1 | 1 | NC | 34.4606 | 11.4000 | 0.0000 | TOP | TRUE
MCU1 | 0 | NC | 31.9206 | 11.4000 | 0.0000 | TOP | TRUE
