Weisni/BatterySentinel-N2K/docs/enclosure-manual-assets/cad/parts/base.png

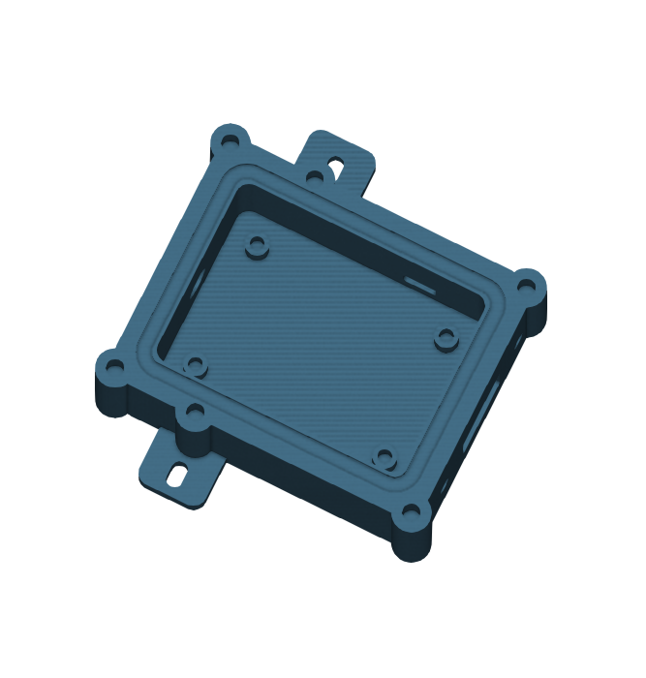
docs/enclosure-manual-assets/cad/parts/base.png
