Weisni/BatterySentinel-N2K/docs/enclosure-manual-assets/cad/parts/cable_blank.png

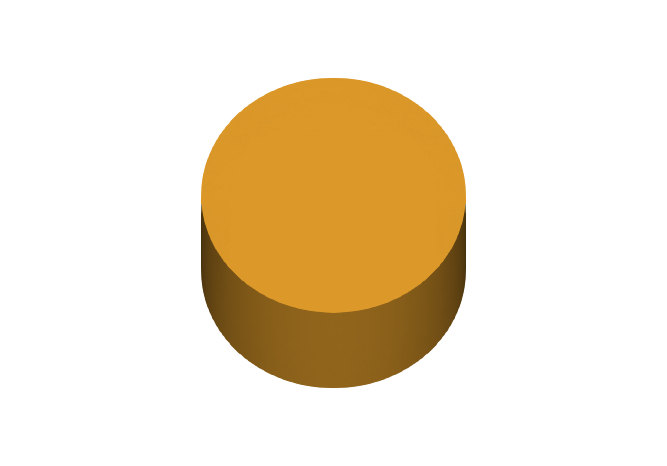
docs/enclosure-manual-assets/cad/parts/cable_blank.png
