Weisni/BatterySentinel-N2K/docs/enclosure-manual-assets/cad/parts/cable_pressure_cap.png

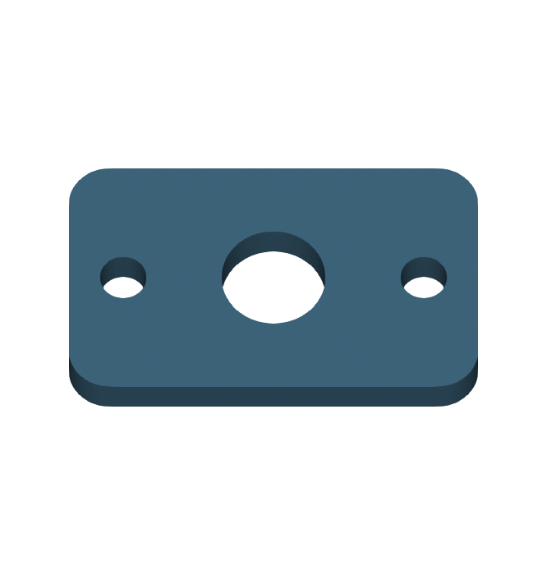
docs/enclosure-manual-assets/cad/parts/cable_pressure_cap.png
