Weisni/BatterySentinel-N2K/docs/enclosure-manual-assets/cad/parts/fit_coupon.png

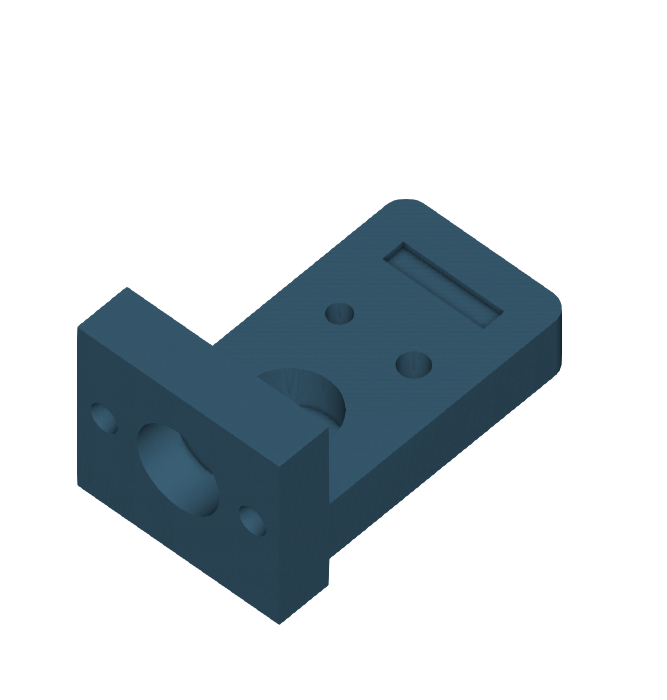
docs/enclosure-manual-assets/cad/parts/fit_coupon.png
