Weisni/BatterySentinel-N2K/docs/enclosure-manual-assets/cad/parts/lid.png

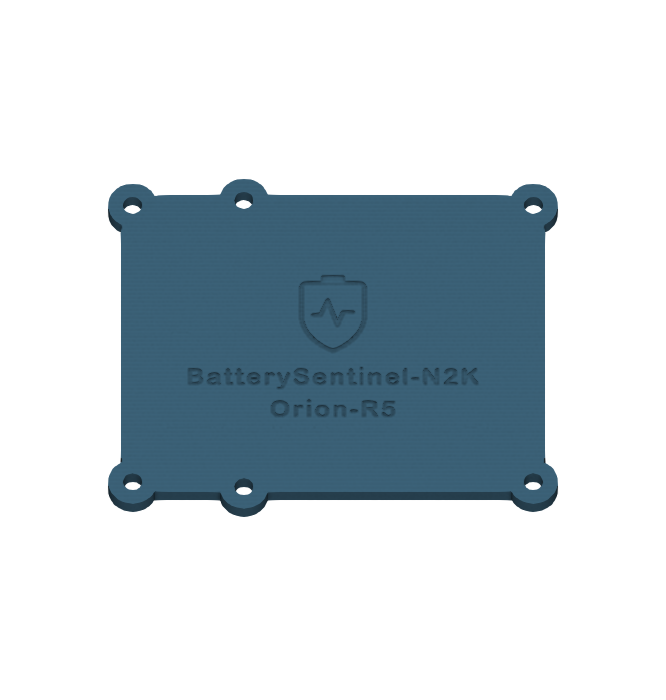
docs/enclosure-manual-assets/cad/parts/lid.png
