Weisni/BatterySentinel-N2K/docs/enclosure-manual-assets/cad/parts/lid_gasket.png

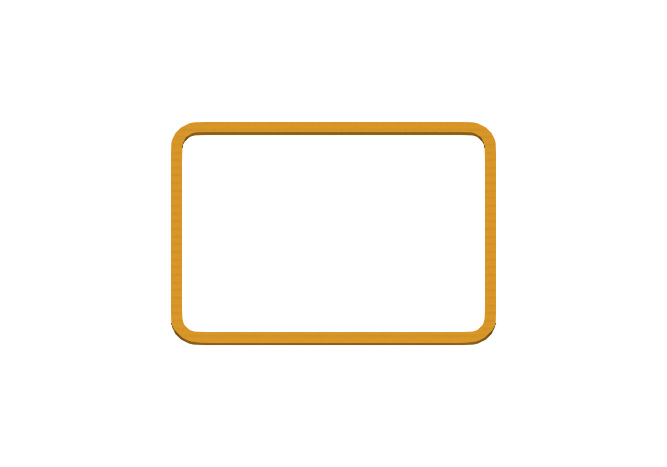
docs/enclosure-manual-assets/cad/parts/lid_gasket.png
