Weisni/BatterySentinel-N2K/docs/enclosure-manual-assets/cad/parts/service_switch_cover.png

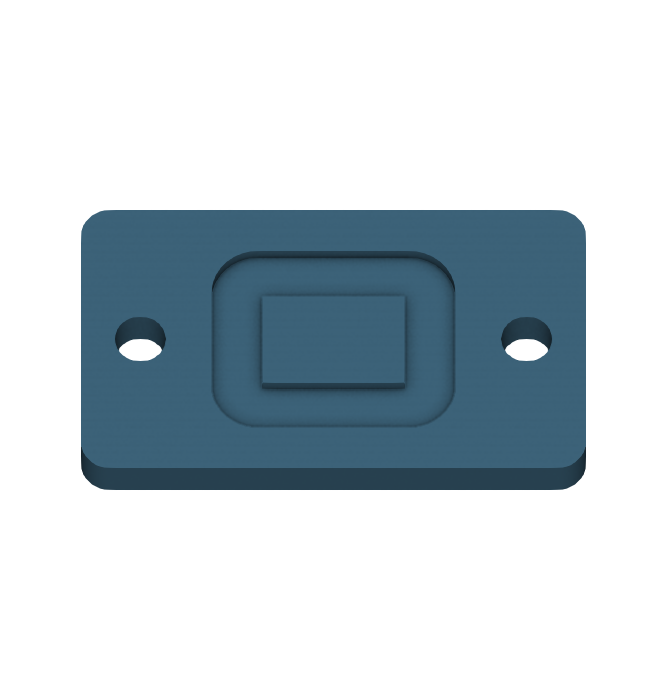
docs/enclosure-manual-assets/cad/parts/service_switch_cover.png
