Weisni/BatterySentinel-N2K/docs/enclosure-manual-assets/cad/parts/service_switch_gasket.png

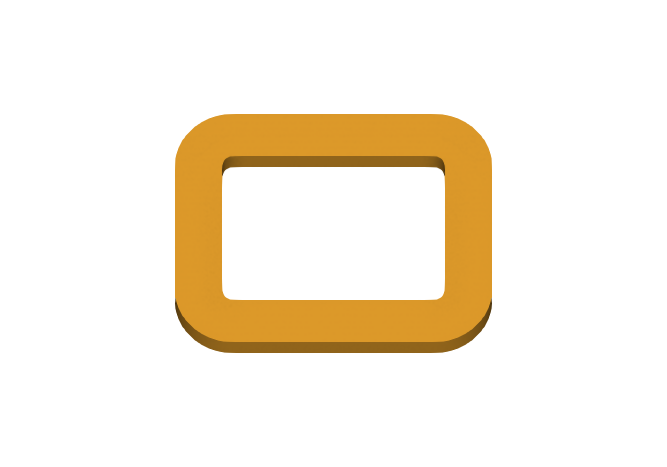
docs/enclosure-manual-assets/cad/parts/service_switch_gasket.png
