Weisni/BatterySentinel-N2K/docs/enclosure-manual-assets/cad/parts/usb_cover.png

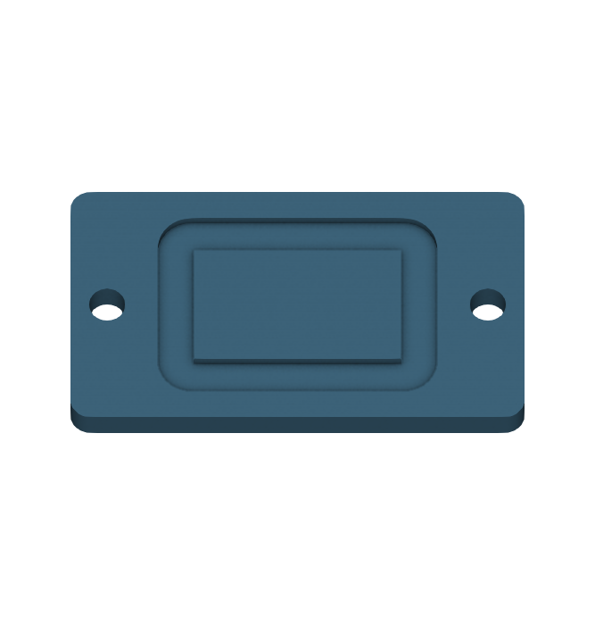
docs/enclosure-manual-assets/cad/parts/usb_cover.png
