Weisni/BatterySentinel-N2K/hardware/altium-r5/enclosure/sealed-v2/preview-parts.png

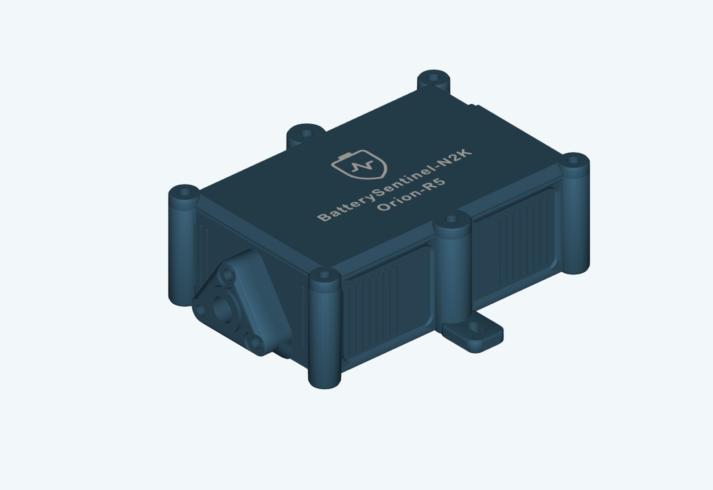
hardware/altium-r5/enclosure/sealed-v2/preview-parts.png
