Weisni/BatterySentinel-N2K/hardware/altium-r5/enclosure/sealed-print/Orion-R5-sealed-assembly.step

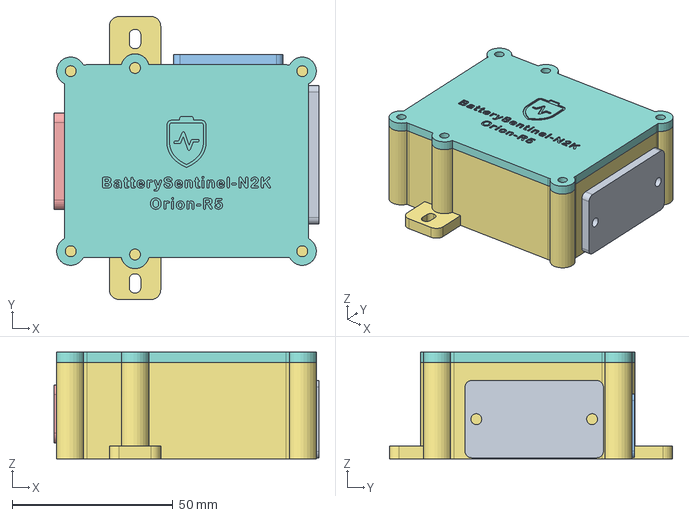
[picture p46: CAD file, 2026-10-10]
hardware/altium-r5/enclosure/sealed-print/Orion-R5-sealed-assembly.step
82.4 x 88.0 x 33.2 mm
