Weisni/BatterySentinel-N2K/output/Orion-Enclosure-V2-Print-Package/enclosure/Orion-Enclosure-V2-assembly.step

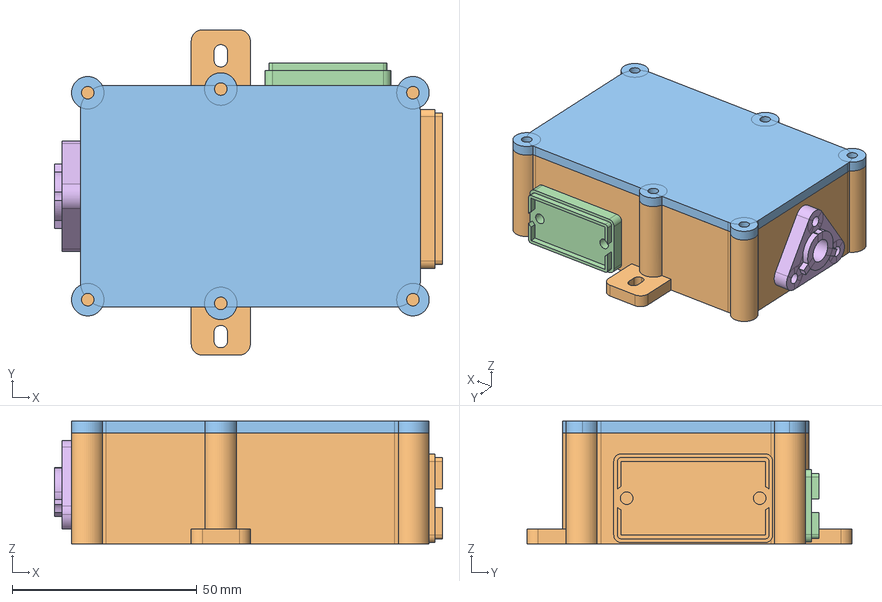
[picture p47: CAD file, 2026-10-10]
output/Orion-Enclosure-V2-Print-Package/enclosure/Orion-Enclosure-V2-assembly.step
105.0 x 88.0 x 33.2 mm
