Weisni/BatterySentinel-N2K/hardware/altium-r5/enclosure/sealed-v2/Orion-V2-Complete-P2S.3mf

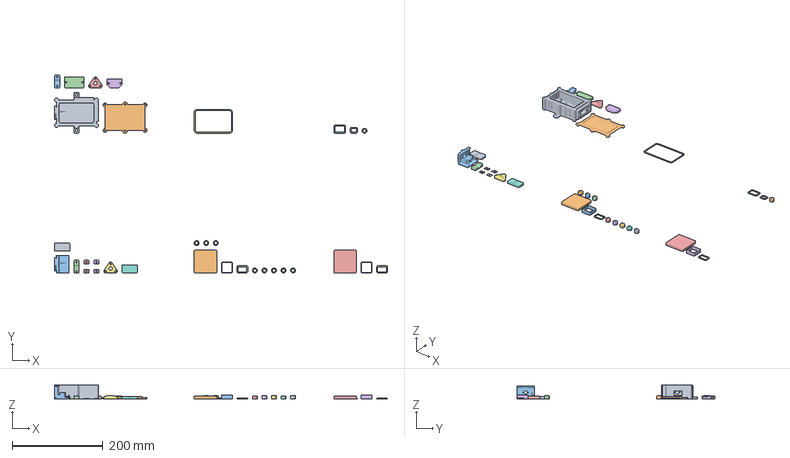
[picture p48: CAD file, 2026-10-10]
hardware/altium-r5/enclosure/sealed-v2/Orion-V2-Complete-P2S.3mf
732.4 x 435.2 x 30.0 mm
base
lid_body
strain_relief_upper x 2
usb_cover
cable_pressure_cap x 2
service_switch_cover
lid_gasket
usb_gasket
service_switch_gasket
cable_seal_b6p8_L6p8
entry_fit_coupon
clamp_shims_0p2
clamp_shims_0p4
face_stop_coupon_1p4
face_stop_coupon_1p6
shore_comparison_pad x 2
flow_wall_coupon x 2
face_test_gasket x 2
cable_seal_b6p7_L6p6
cable_seal_b6p7_L6p8
cable_seal_b6p7_L7p0
cable_seal_b6p8_L6p6
cable_seal_b6p8_L7p0
cable_seal_b6p9_L6p6
cable_seal_b6p9_L6p8
cable_seal_b6p9_L7p0
