Weisni/BatterySentinel-N2K/hardware/altium-r3/models/Orion-Bridge-assembly.step

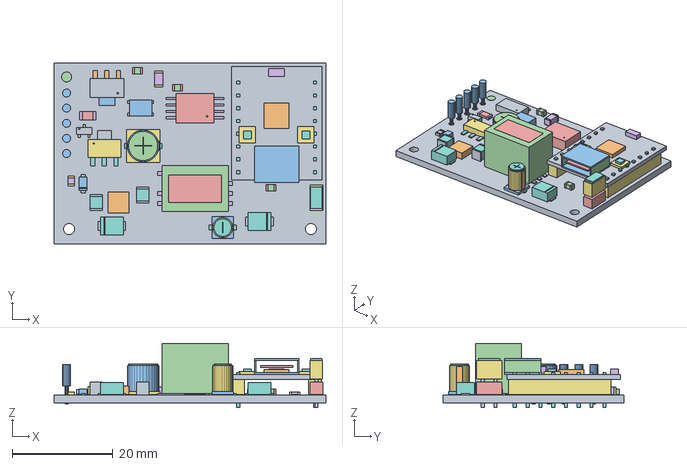
[picture p49: CAD file, 2026-10-10]
hardware/altium-r3/models/Orion-Bridge-assembly.step
54.0 x 36.0 x 12.7 mm
