Weisni/BatterySentinel-N2K/hardware/altium-r5/enclosure/sealed-v2/Orion-Enclosure-V2-assembly.step

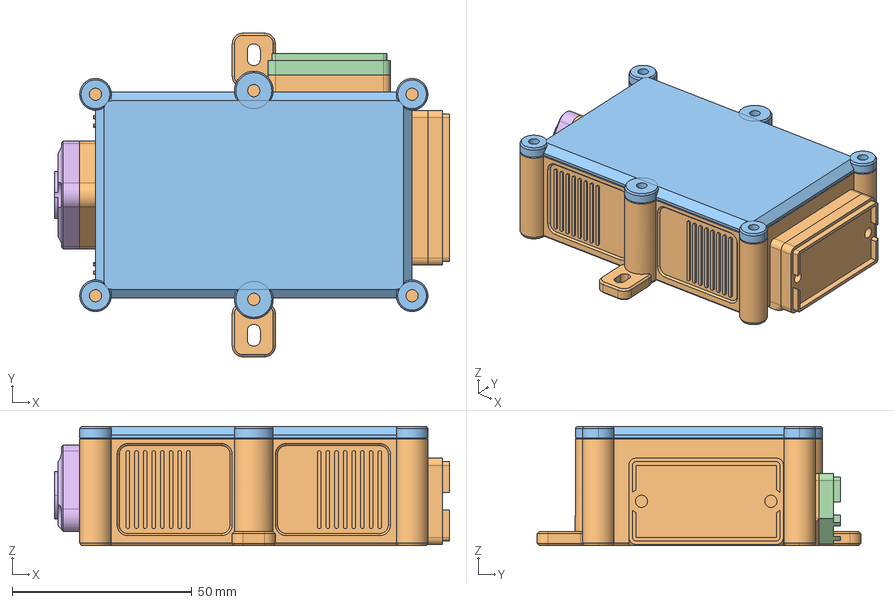
[picture p50: CAD file, 2026-10-10]
hardware/altium-r5/enclosure/sealed-v2/Orion-Enclosure-V2-assembly.step
109.8 x 90.0 x 33.2 mm
