Weisni/BatterySentinel-N2K/hardware/altium-r5/enclosure/sealed-print/Orion-R5-P2S-complete.3mf

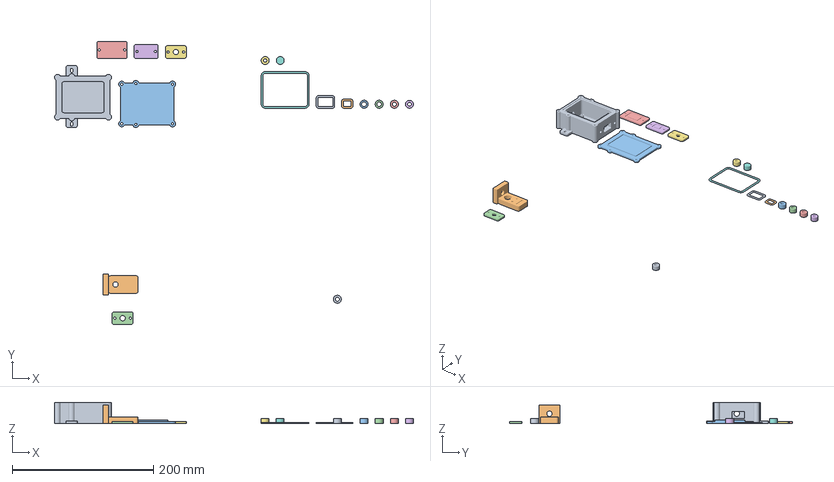
[picture p51: CAD file, 2026-10-10]
hardware/altium-r5/enclosure/sealed-print/Orion-R5-P2S-complete.3mf
508.6 x 401.0 x 30.0 mm
base
fit_coupon
lid
cable_pressure_cap x 2
usb_cover
service_switch_cover
lid_gasket
usb_gasket
service_switch_gasket
cable_seal_7p0mm
cable_seal_6p5mm
cable_seal_6p0mm x 2
cable_seal_5p5mm
cable_seal_5p0mm
cable_blank
