Weisni/BatterySentinel-N2K/hardware/altium-r4/models/Orion-Bridge-assembly.step

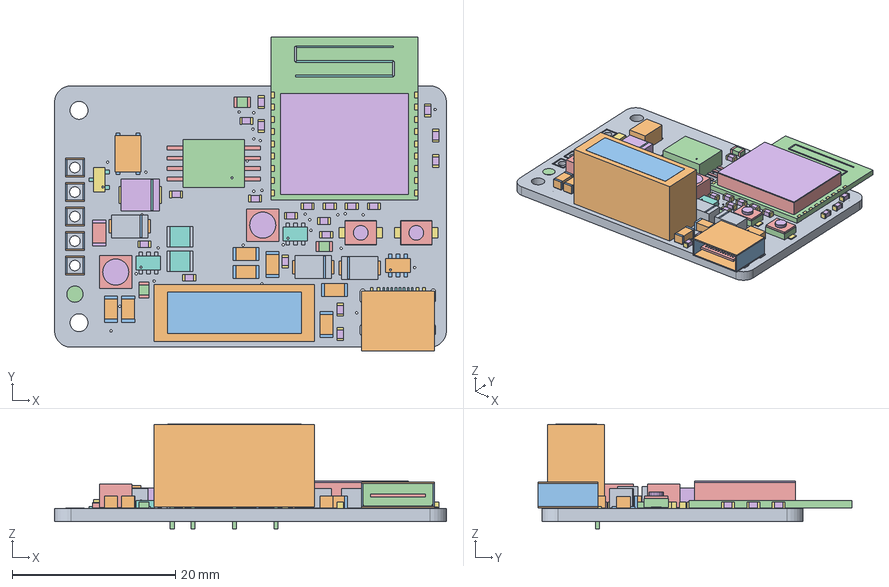
[picture p52: CAD file, 2026-10-10]
hardware/altium-r4/models/Orion-Bridge-assembly.step
48.0 x 38.5 x 12.8 mm
