Weisni/BatterySentinel-N2K/hardware/altium-r3/models/D3.step

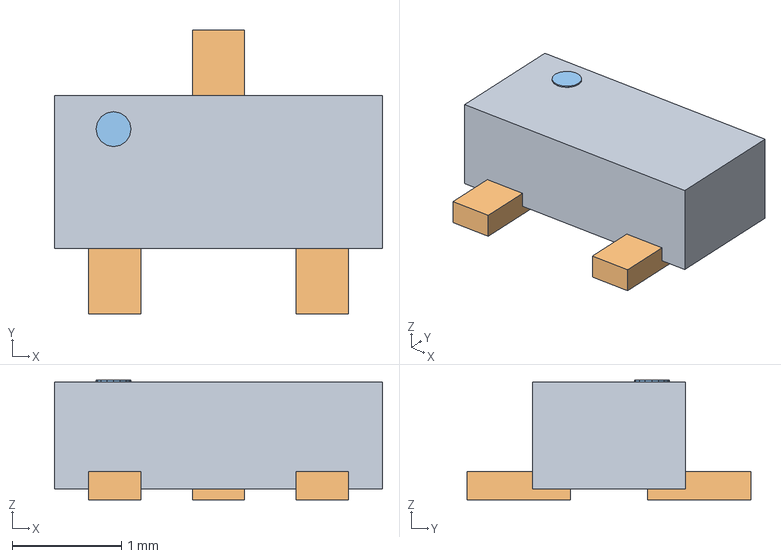
[picture p53: CAD file, 2026-10-10]
hardware/altium-r3/models/D3.step
3.00 x 2.60 x 1.09 mm
