Weisni/BatterySentinel-N2K/hardware/altium-r4/models/C30.step

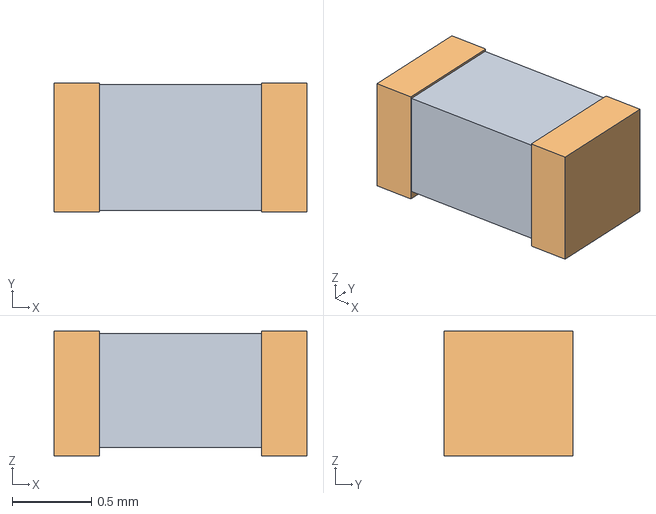
[picture p54: CAD file, 2026-10-10]
hardware/altium-r4/models/C30.step
1.60 x 0.815 x 0.79 mm
