Weisni/BatterySentinel-N2K/hardware/altium-r5/BatterySentinel-N2K-Orion-R5.step

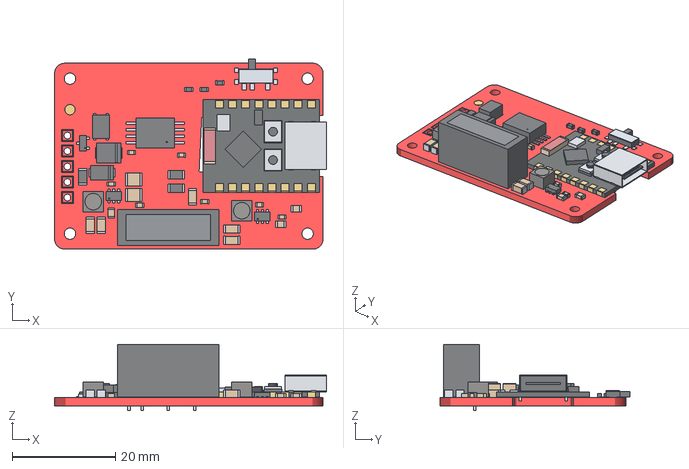
[picture p55: CAD file, 2026-10-10]
hardware/altium-r5/BatterySentinel-N2K-Orion-R5.step
52.6 x 36.8 x 12.8 mm
