Weisni/BatterySentinel-N2K/hardware/altium-r5/enclosure/PROVISIONAL-enclosure.FCStd

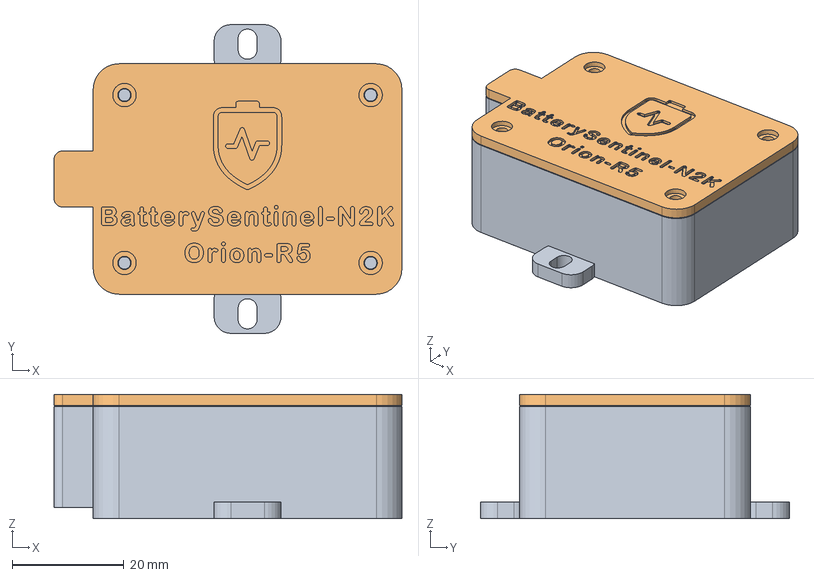
[picture p56: CAD file, 2026-10-10]
hardware/altium-r5/enclosure/PROVISIONAL-enclosure.FCStd
62.2 x 55.2 x 22.3 mm
Base
Lid
Pcb
