Weisni/BatterySentinel-N2K/hardware/altium-r5/enclosure/sealed-print/awesome-ai-profiles/validation/quack-012/validation.3mf

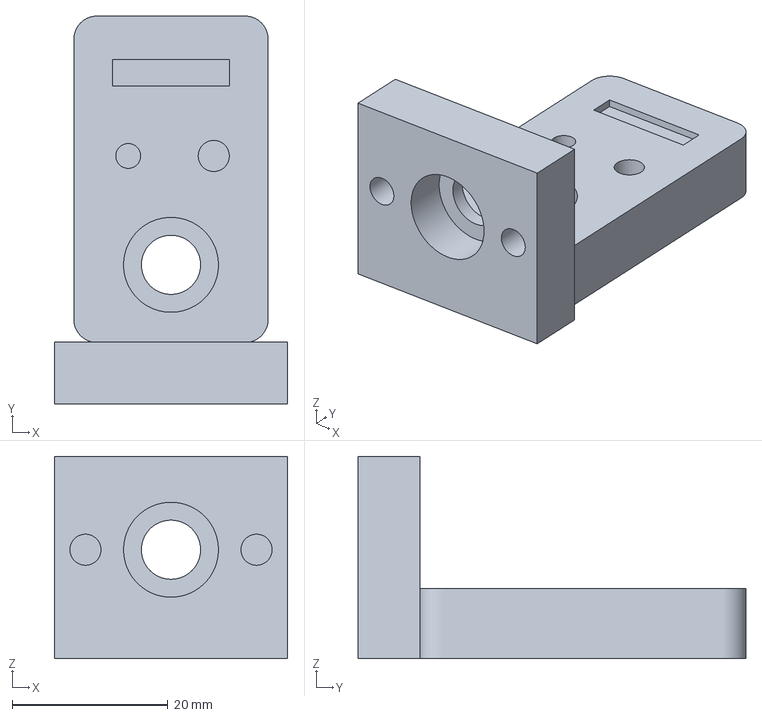
[picture p57: CAD file, 2026-10-10]
hardware/altium-r5/enclosure/sealed-print/awesome-ai-profiles/validation/quack-012/validation.3mf
30.0 x 49.9 x 26.0 mm
