Weisni/BatterySentinel-N2K/hardware/altium-r5/enclosure/sealed-print/flush-colour/Orion-R5-flush-enclosure.FCStd

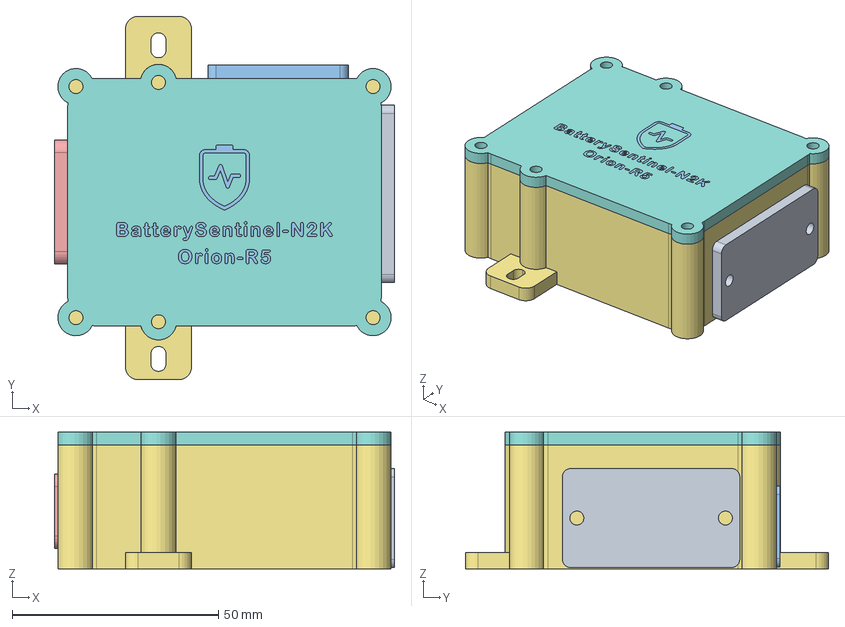
[picture p58: CAD file, 2026-10-10]
hardware/altium-r5/enclosure/sealed-print/flush-colour/Orion-R5-flush-enclosure.FCStd
82.4 x 88.0 x 33.2 mm
usb cover
usb gasket
service switch cover
service switch gasket
cable pressure cap
cable blank
base
lid
lid gasket
PCB
Component 0 J1
Component 1 J1
Component 2 J1
Component 3 J1
Component 4 J1
Component 5 J1
Component 6 J1
Component 7 J1
Component 8 J1
Component 9 J1
Component 10 J1
Component 11 J1
Component 12 J1
Component 13 J1
Component 14 J1
Component 15 J1
Component 16 J1
Component 17 J1
Component 18 J1
Component 19 J1
Component 20 TP1
Component 21 D3
Component 22 D3
Component 23 D3
Component 24 D3
Component 25 D3
Component 26 L1
Component 27 L1
Component 28 L1
Component 29 L1
Component 30 L1
Component 31 U1
Component 32 U1
Component 33 U1
Component 34 U1
Component 35 U1
Component 36 U1
Component 37 U1
Component 38 U1
Component 39 U1
Component 40 U1
Component 41 C4
Component 42 C4
Component 43 C4
Component 44 C5
Component 45 C5
Component 46 C5
Component 47 R2
Component 48 R2
Component 49 R2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
