Weisni/BatterySentinel-N2K/hardware/altium-r5/enclosure/sealed-print/flush-colour/slicer-baseline-compatible/disposable-baseline.3mf

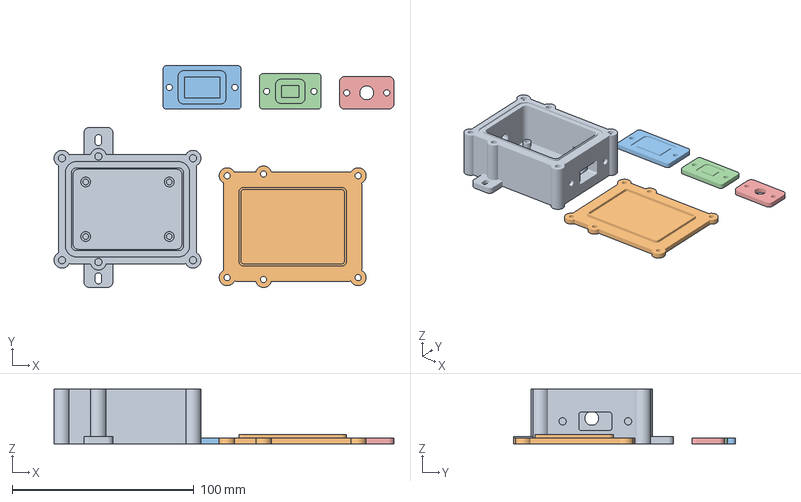
[picture p59: CAD file, 2026-10-10]
hardware/altium-r5/enclosure/sealed-print/flush-colour/slicer-baseline-compatible/disposable-baseline.3mf
186.9 x 122.0 x 30.0 mm
base
lid
usb_cover
service_switch_cover
cable_pressure_cap
