Weisni/BatterySentinel-N2K/hardware/altium-r5/enclosure/sealed-print/lid.stl

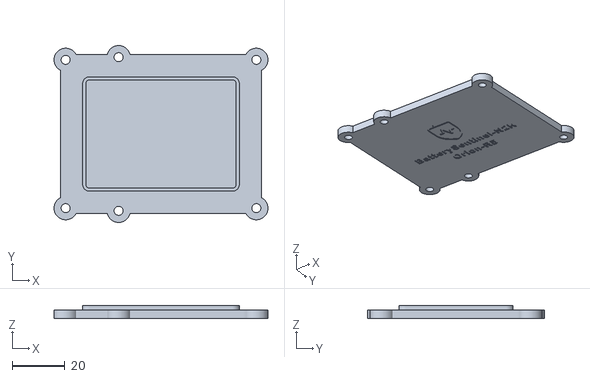
[picture p60: CAD file, 2026-10-10]
hardware/altium-r5/enclosure/sealed-print/lid.stl
80.8 x 66.8 x 5.00
