Weisni/BatterySentinel-N2K/hardware/altium-r5/enclosure/sealed-v2/cable_seal_b6p8_L6p8.stl

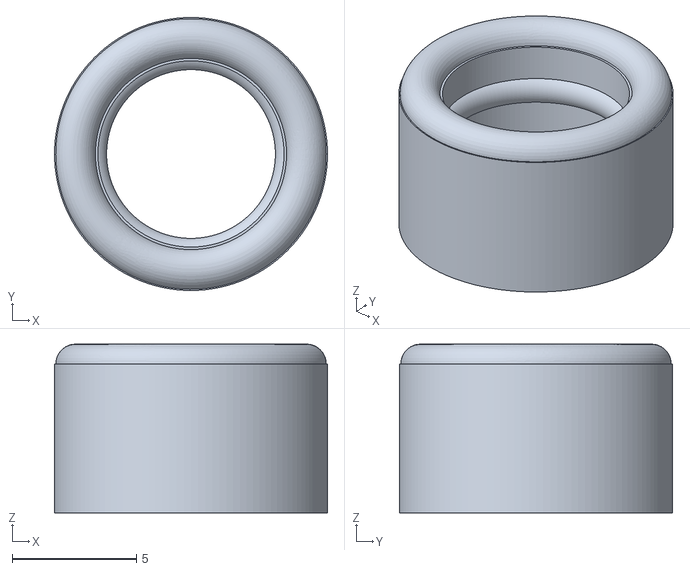
[picture p61: CAD file, 2026-10-10]
hardware/altium-r5/enclosure/sealed-v2/cable_seal_b6p8_L6p8.stl
11.0 x 11.0 x 6.80
