Weisni/BatterySentinel-N2K/hardware/altium-r5/enclosure/sealed-v2/combined-validation/input-1.3mf

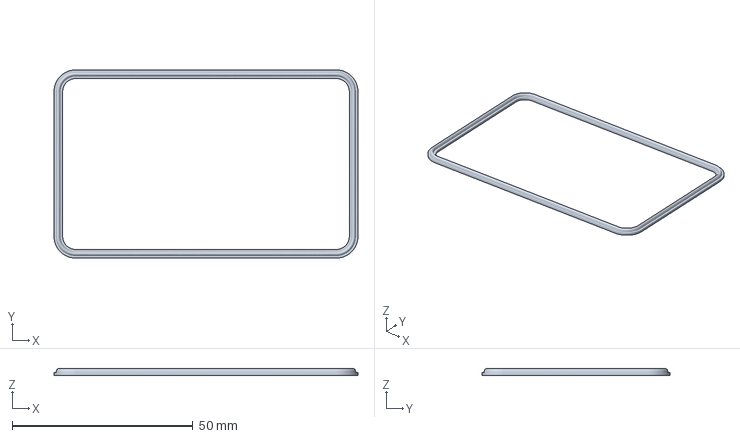
[picture p62: CAD file, 2026-10-10]
hardware/altium-r5/enclosure/sealed-v2/combined-validation/input-1.3mf
84.0 x 52.0 x 1.80 mm
