Weisni/BatterySentinel-N2K/hardware/altium-r5/enclosure/sealed-v2/native-validation/Orion-V2-PETG-Coupons/verified.3mf

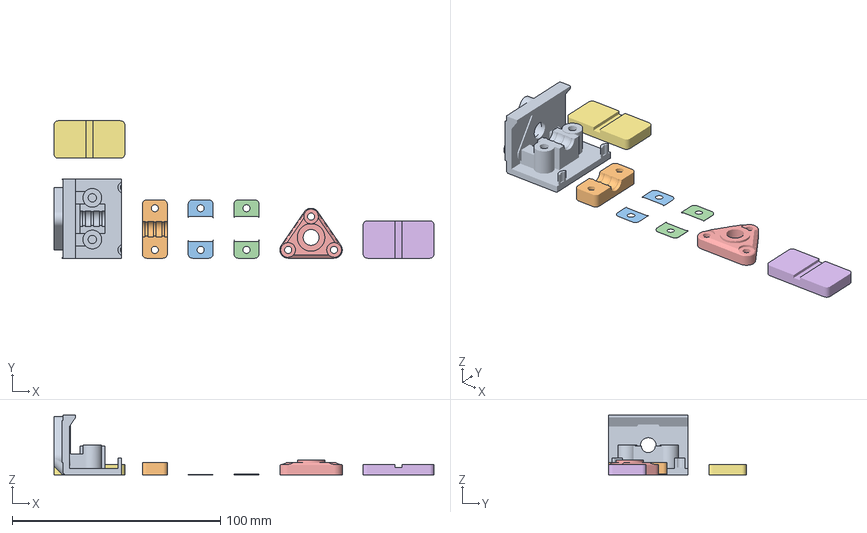
[picture p63: CAD file, 2026-10-10]
hardware/altium-r5/enclosure/sealed-v2/native-validation/Orion-V2-PETG-Coupons/verified.3mf
182.4 x 66.0 x 28.6 mm
entry_fit_coupon
strain_relief_upper
clamp_shims_0p2
clamp_shims_0p4
cable_pressure_cap
face_stop_coupon_1p4
face_stop_coupon_1p6
