Weisni/BatterySentinel-N2K/hardware/altium-r5/enclosure/sealed-v2/native-validation/Orion-V2-PETG/verified.3mf

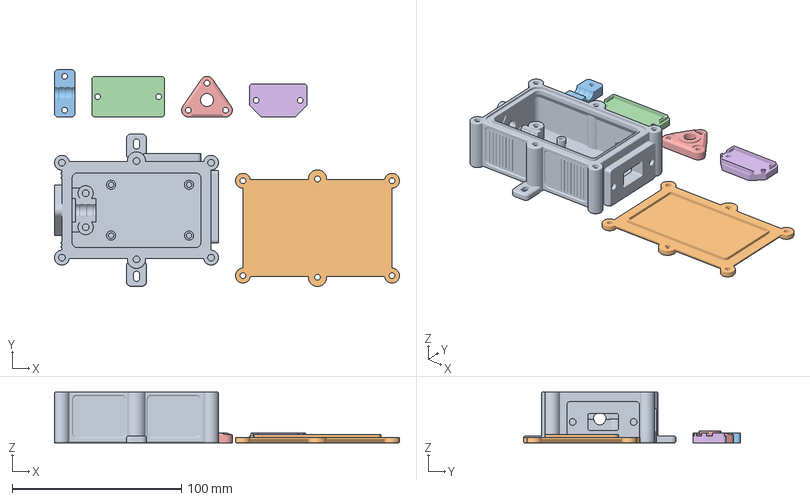
[picture p64: CAD file, 2026-10-10]
hardware/altium-r5/enclosure/sealed-v2/native-validation/Orion-V2-PETG/verified.3mf
203.6 x 128.0 x 30.0 mm
base
lid_body
strain_relief_upper
usb_cover
cable_pressure_cap
service_switch_cover
