Weisni/BatterySentinel-N2K/hardware/altium-r5/enclosure/sealed-v2/native-validation/Orion-V2-TPU-Air-235C/verified.3mf

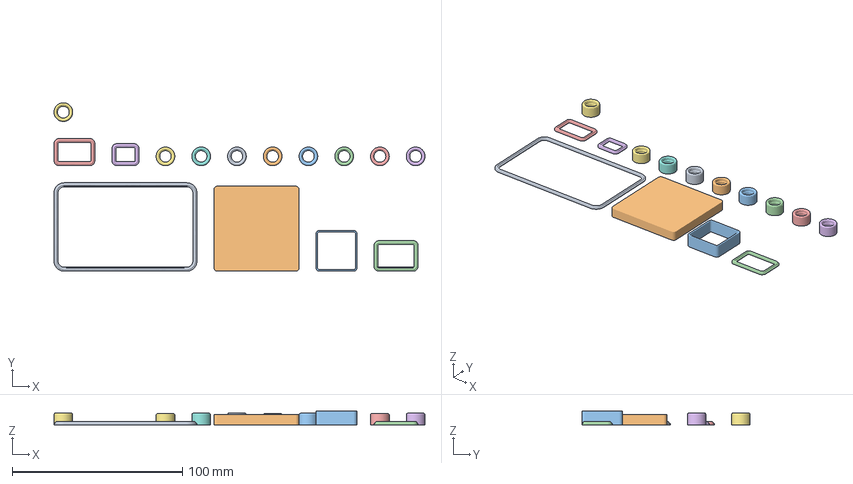
[picture p65: CAD file, 2026-10-10]
hardware/altium-r5/enclosure/sealed-v2/native-validation/Orion-V2-TPU-Air-235C/verified.3mf
218.0 x 99.0 x 8.00 mm
lid_gasket
shore_comparison_pad
flow_wall_coupon
usb_gasket
face_test_gasket
service_switch_gasket
cable_seal_b6p7_L6p6
cable_seal_b6p7_L6p8
cable_seal_b6p7_L7p0
cable_seal_b6p8_L6p6
cable_seal_b6p8_L6p8
cable_seal_b6p8_L7p0
cable_seal_b6p9_L6p6
cable_seal_b6p9_L6p8
cable_seal_b6p9_L7p0
