Weisni/BatterySentinel-N2K/hardware/altium-r5/enclosure/sealed-v2/step-probe/strain_relief_upper.step

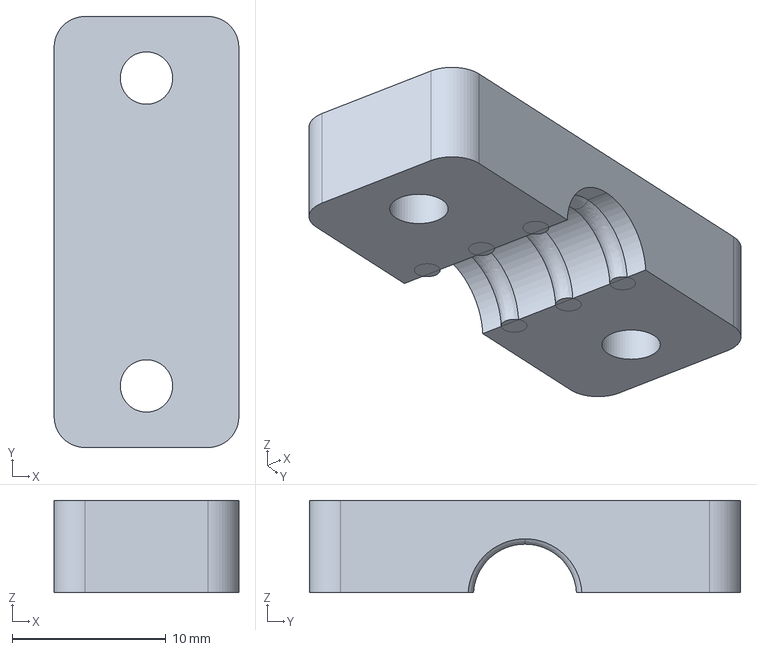
[picture p66: CAD file, 2026-10-10]
hardware/altium-r5/enclosure/sealed-v2/step-probe/strain_relief_upper.step
12.0 x 28.0 x 6.00 mm
