Weisni/BatterySentinel-N2K/output/Orion-Enclosure-V2.3-Onshape/latest-variants/cable_seal_ID6p8_OD11p5_L9mm_profiled.step

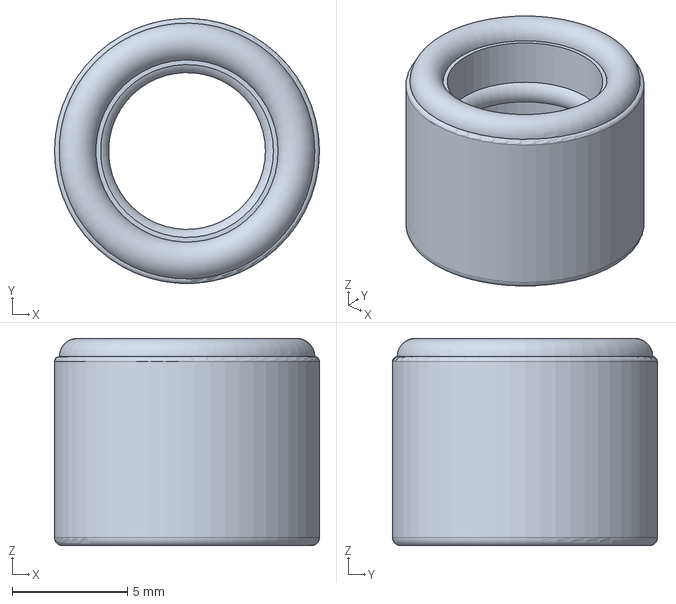
[picture p68: CAD file, 2026-10-10]
output/Orion-Enclosure-V2.3-Onshape/latest-variants/cable_seal_ID6p8_OD11p5_L9mm_profiled.step
11.5 x 11.5 x 9.00 mm
