Weisni/BatterySentinel-N2K/hardware/altium-r3/models/TP1.step

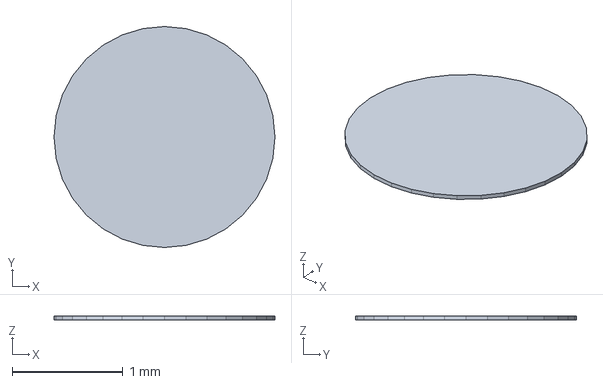
[picture p69: CAD file, 2026-10-10]
hardware/altium-r3/models/TP1.step
2.00 x 2.00 x 0.035 mm
