Weisni/BatterySentinel-N2K/hardware/altium-r4/models/C23.step

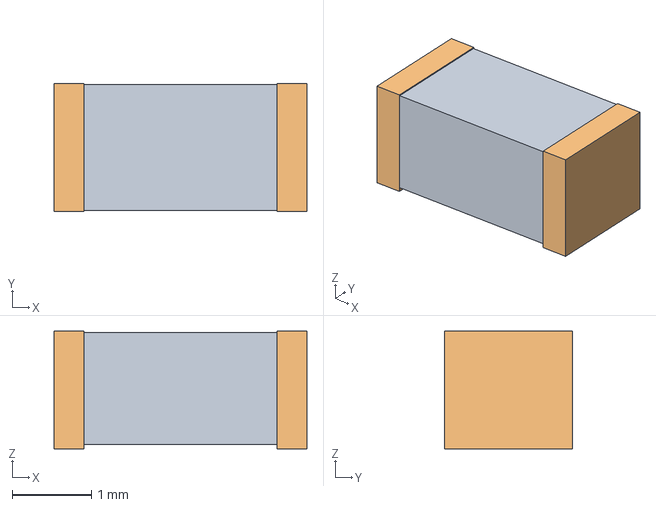
[picture p70: CAD file, 2026-10-10]
hardware/altium-r4/models/C23.step
3.20 x 1.61 x 1.49 mm
