Weisni/BatterySentinel-N2K/hardware/altium-r5/enclosure/sealed-print/usb_cover.stl

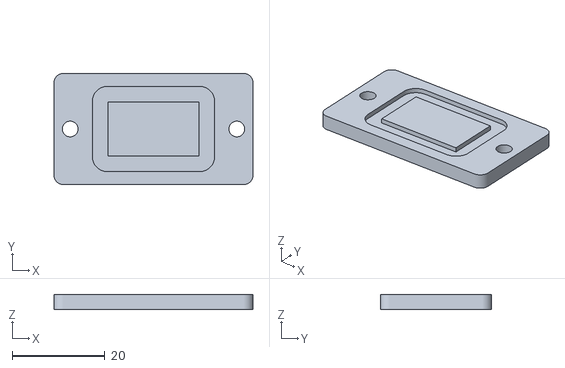
[picture p71: CAD file, 2026-10-10]
hardware/altium-r5/enclosure/sealed-print/usb_cover.stl
43.0 x 24.0 x 3.20
