Weisni/BatterySentinel-N2K/hardware/altium-r5/enclosure/sealed-v2/combined-validation/input-2.3mf

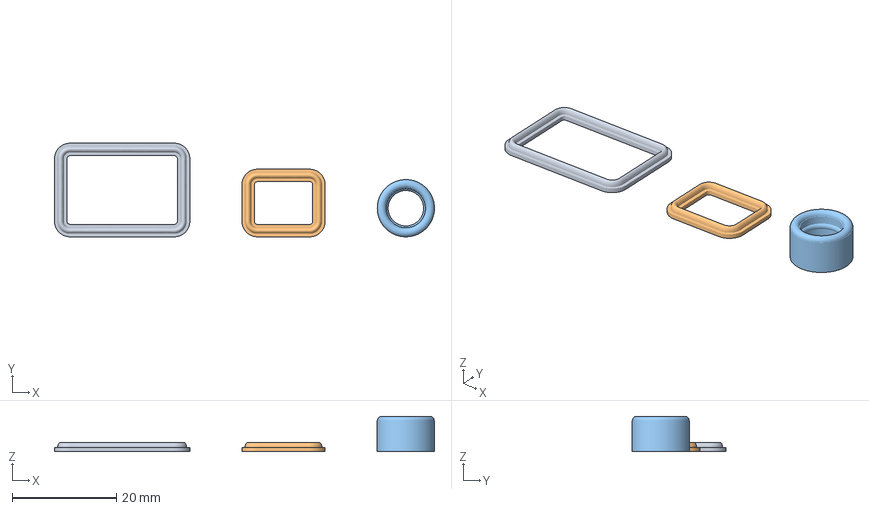
[picture p72: CAD file, 2026-10-10]
hardware/altium-r5/enclosure/sealed-v2/combined-validation/input-2.3mf
73.0 x 18.0 x 6.80 mm
usb_gasket
service_switch_gasket
cable_seal_b6p8_L6p8
