Weisni/BatterySentinel-N2K/hardware/altium-r5/enclosure/sealed-v2/step-probe/cable_pressure_cap-import.step

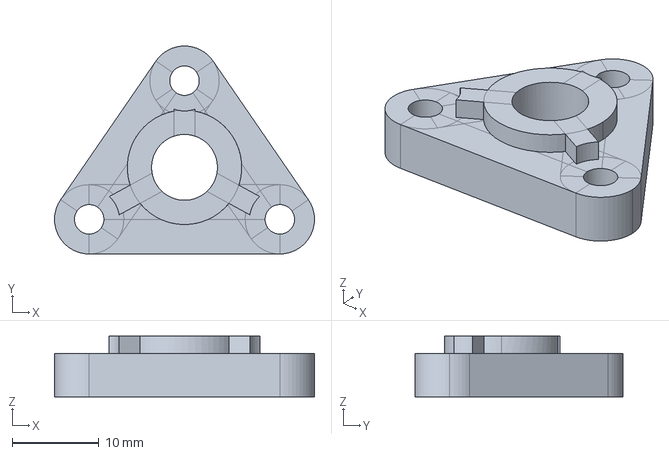
[picture p73: CAD file, 2026-10-10]
hardware/altium-r5/enclosure/sealed-v2/step-probe/cable_pressure_cap-import.step
30.0 x 24.0 x 7.00 mm
