Weisni/BatterySentinel-N2K/hardware/altium-r5/enclosure/sealed-v2/usb_gasket.stl

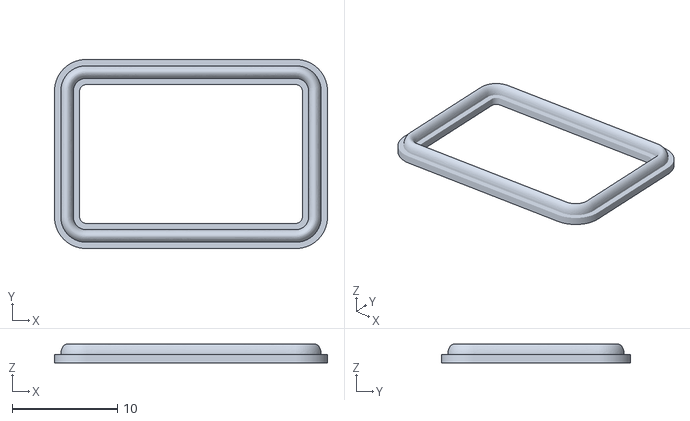
[picture p74: CAD file, 2026-10-10]
hardware/altium-r5/enclosure/sealed-v2/usb_gasket.stl
26.0 x 18.0 x 1.80
