Weisni/BatterySentinel-N2K/output/Kabeldichtung_ID6p8_AD11p5_L9mm.stl

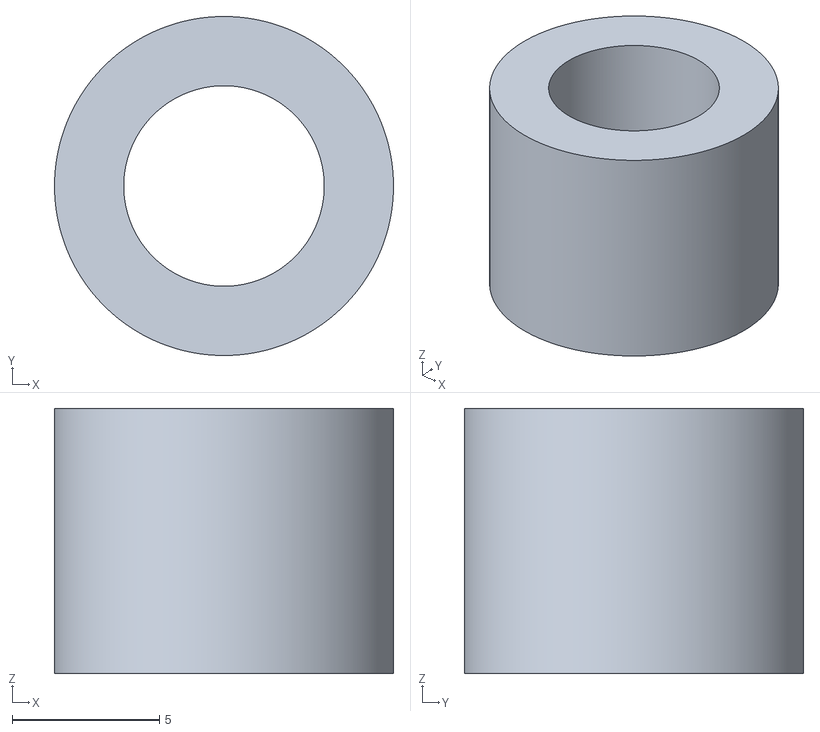
[picture p75: CAD file, 2026-10-10]
output/Kabeldichtung_ID6p8_AD11p5_L9mm.stl
11.5 x 11.5 x 9.00
