Weisni/BatterySentinel-N2K/output/Orion-Enclosure-V2-Print-Package/enclosure/service_switch_cover.stl

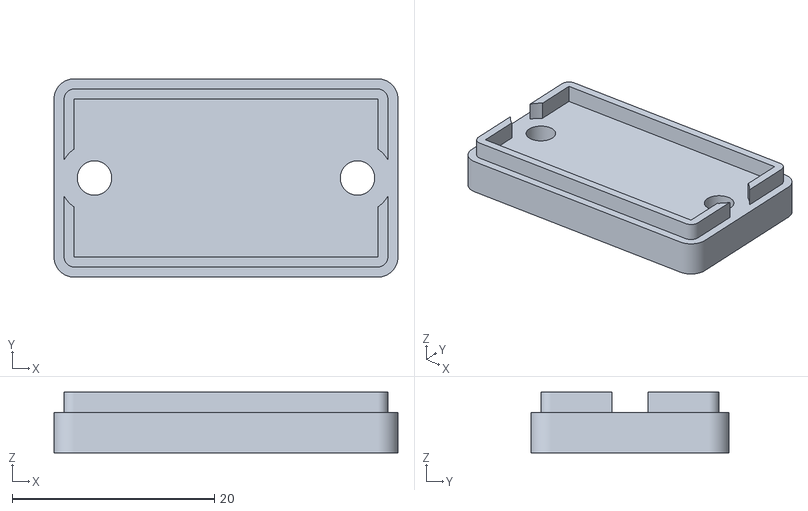
[picture p76: CAD file, 2026-10-10]
output/Orion-Enclosure-V2-Print-Package/enclosure/service_switch_cover.stl
34.0 x 19.6 x 6.00
