Weisni/BatterySentinel-N2K/output/Orion-Enclosure-V2.3-Onshape/latest-variants/strain_relief_upper_5mm.step

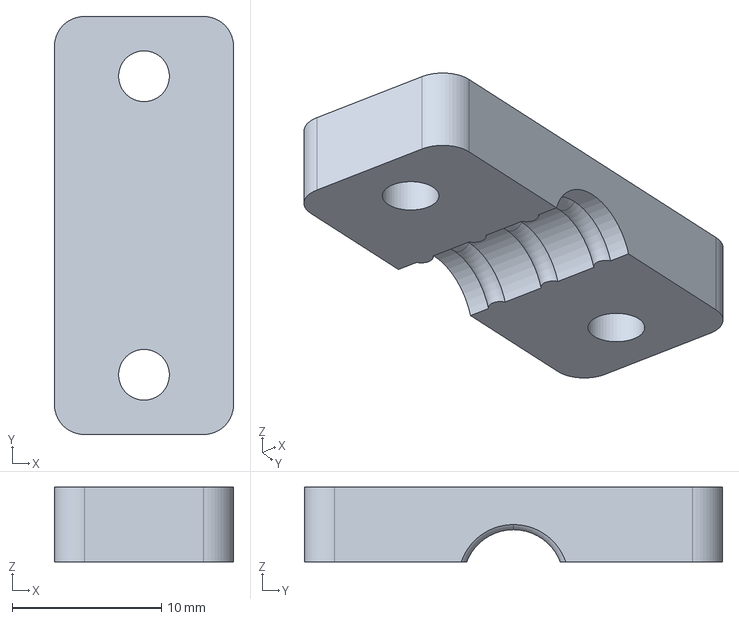
[picture p77: CAD file, 2026-10-10]
output/Orion-Enclosure-V2.3-Onshape/latest-variants/strain_relief_upper_5mm.step
12.0 x 28.0 x 5.00 mm
