Weisni/BatterySentinel-N2K/output/Orion-Enclosure-V2.3-Onshape/parts/usb_cover.step

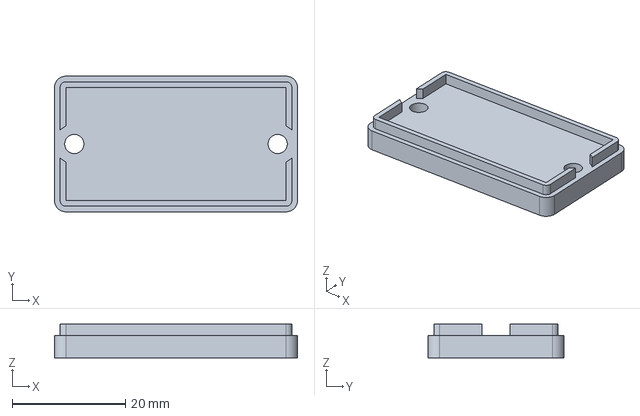
[picture p78: CAD file, 2026-10-10]
output/Orion-Enclosure-V2.3-Onshape/parts/usb_cover.step
43.0 x 24.0 x 6.00 mm
