Weisni/BatterySentinel-N2K/hardware/altium-r3/models/L2.step

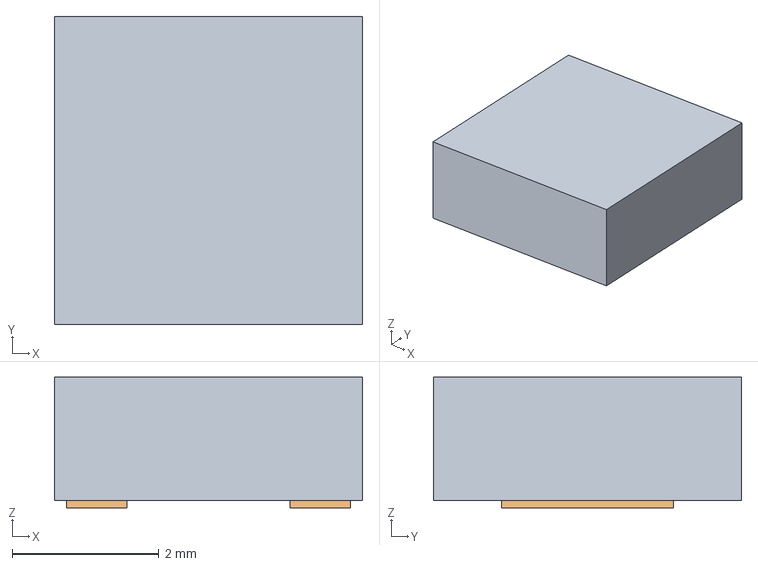
[picture p79: CAD file, 2026-10-10]
hardware/altium-r3/models/L2.step
4.20 x 4.20 x 1.78 mm
