Weisni/BatterySentinel-N2K/hardware/altium-r5/enclosure/sealed-print/flush-colour/lid_markings.stl

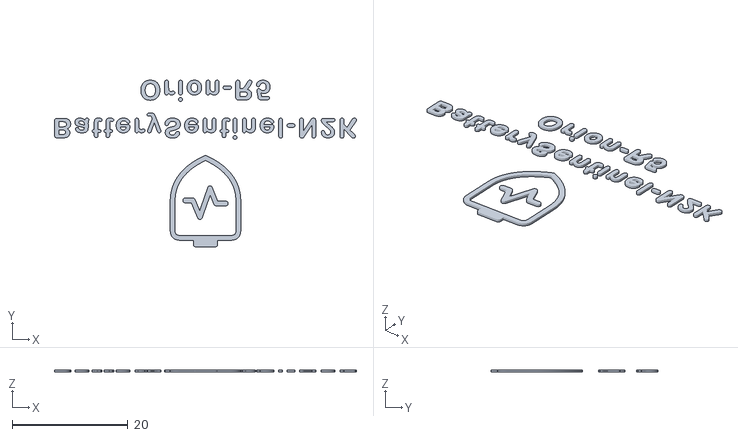
[picture p80: CAD file, 2026-10-10]
hardware/altium-r5/enclosure/sealed-print/flush-colour/lid_markings.stl
52.2 x 28.8 x 0.4
