Weisni/BatterySentinel-N2K/hardware/altium-r5/enclosure/sealed-v2/combined-validation/input-5.3mf

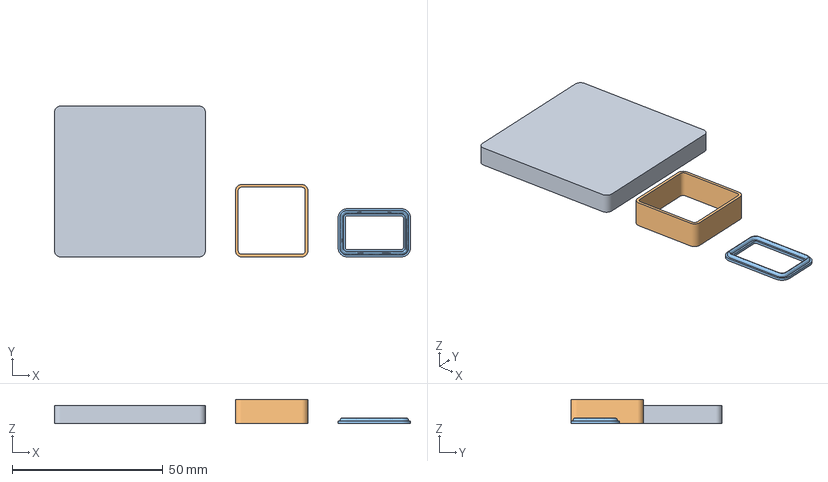
[picture p81: CAD file, 2026-10-10]
hardware/altium-r5/enclosure/sealed-v2/combined-validation/input-5.3mf
118.0 x 50.0 x 8.00 mm
shore_comparison_pad
flow_wall_coupon
face_test_gasket
