Weisni/BatterySentinel-N2K/hardware/altium-r5/enclosure/sealed-v2/Orion-Enclosure-V2.FCStd

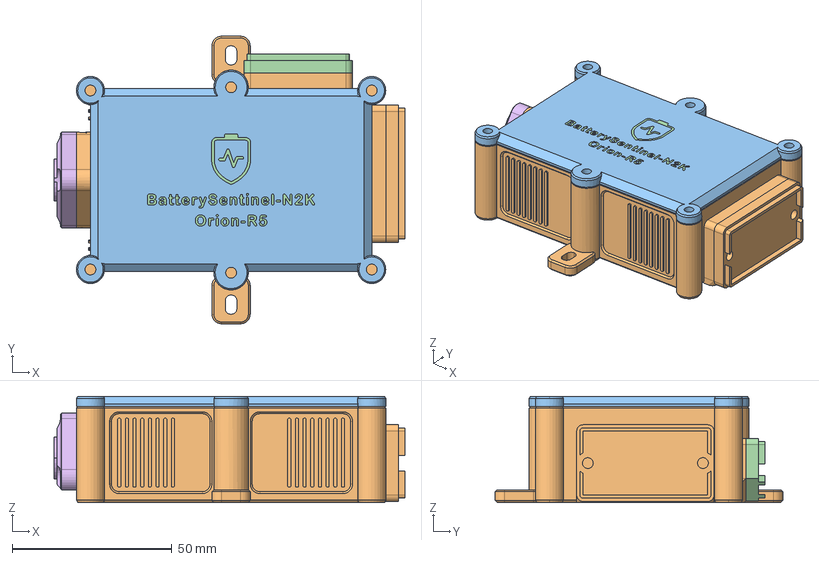
[picture p82: CAD file, 2026-10-10]
hardware/altium-r5/enclosure/sealed-v2/Orion-Enclosure-V2.FCStd
109.8 x 90.0 x 33.2 mm
lid_gasket
usb_cover
usb_gasket
service_switch_cover
service_switch_gasket
cable_pressure_cap
cable_seal_b6p8_L6p8
strain_relief_upper
clamp_shims
base
lid_body
lid_markings
PCB
Component_0_J1
Component_1_J1
Component_2_J1
Component_3_J1
Component_4_J1
Component_5_J1
Component_6_J1
Component_7_J1
Component_8_J1
Component_9_J1
Component_10_J1
Component_11_J1
Component_12_J1
Component_13_J1
Component_14_J1
Component_15_J1
Component_16_J1
Component_17_J1
Component_18_J1
Component_19_J1
Component_20_TP1
Component_21_D3
Component_22_D3
Component_23_D3
Component_24_D3
Component_25_D3
Component_26_L1
Component_27_L1
Component_28_L1
Component_29_L1
Component_30_L1
Component_31_U1
Component_32_U1
Component_33_U1
Component_34_U1
Component_35_U1
Component_36_U1
Component_37_U1
Component_38_U1
Component_39_U1
Component_40_U1
Component_41_C4
Component_42_C4
Component_43_C4
Component_44_C5
Component_45_C5
Component_46_C5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
