Weisni/BatterySentinel-N2K/output/Orion-Enclosure-V2-Print-Package/enclosure/shore_comparison_pad.stl

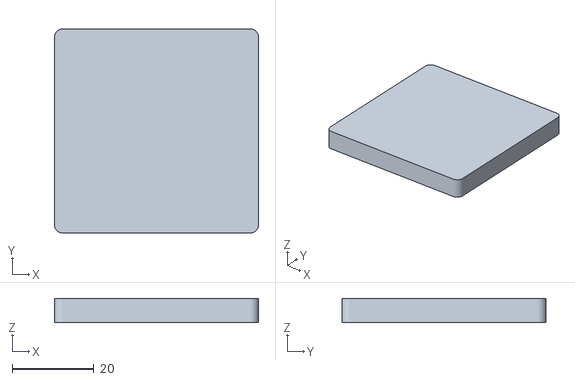
[picture p83: CAD file, 2026-10-10]
output/Orion-Enclosure-V2-Print-Package/enclosure/shore_comparison_pad.stl
50.0 x 50.0 x 6.00
