Weisni/BatterySentinel-N2K/output/strain_relief_upper_flat_0p4mm.stl

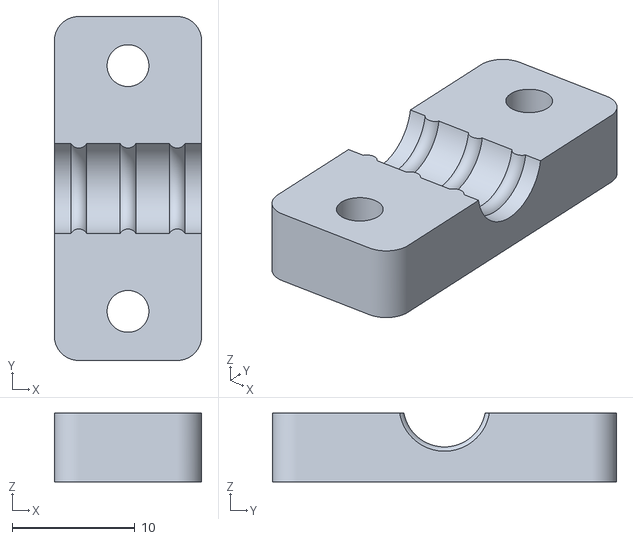
[picture p84: CAD file, 2026-10-10]
output/strain_relief_upper_flat_0p4mm.stl
12.0 x 28.0 x 5.60
