Weisni/BatterySentinel-N2K/hardware/altium-r3/models/D1.step

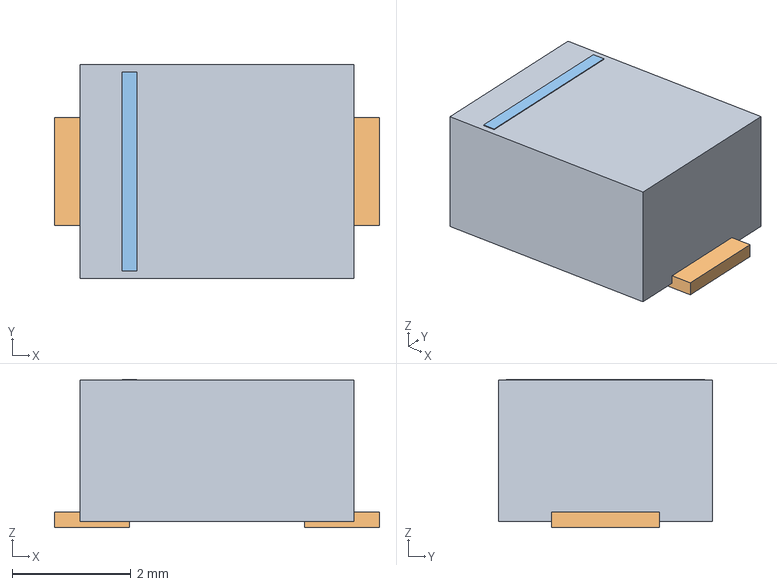
[picture p85: CAD file, 2026-10-10]
hardware/altium-r3/models/D1.step
5.46 x 3.60 x 2.50 mm
