Weisni/BatterySentinel-N2K/hardware/altium-r4/models/J1.step

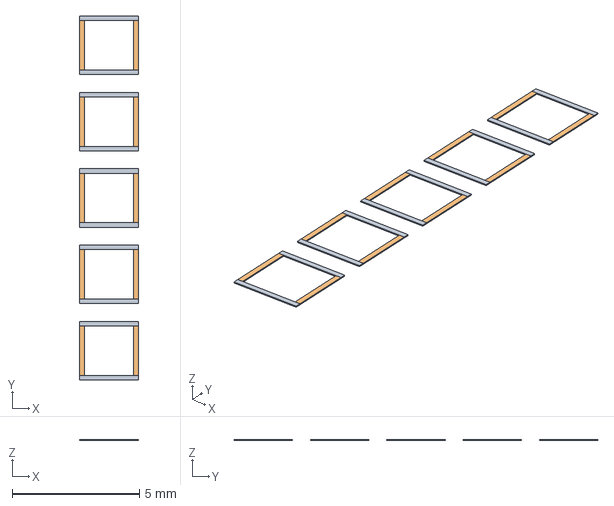
[picture p86: CAD file, 2026-10-10]
hardware/altium-r4/models/J1.step
2.30 x 14.3 x 0.035 mm
