Weisni/BatterySentinel-N2K/hardware/altium-r5/enclosure/sealed-print/Orion-R5-plate-1-PETG-portable.3mf

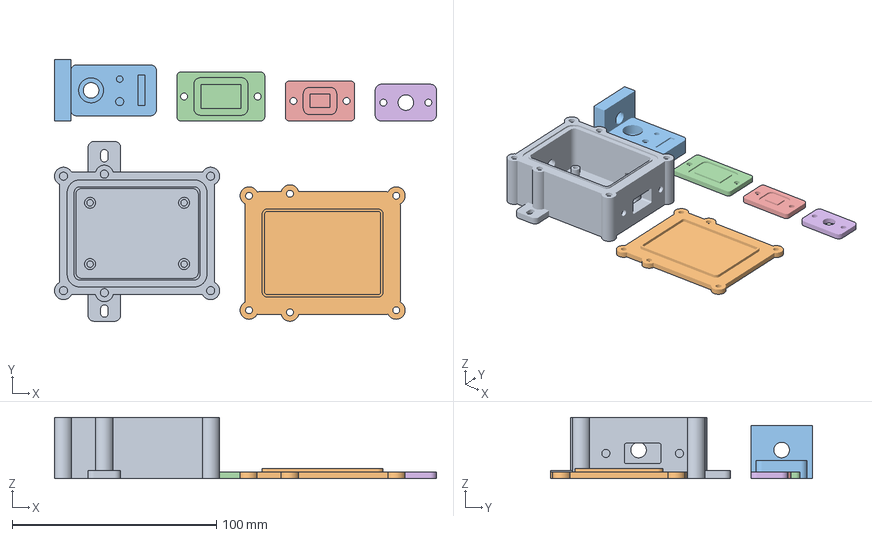
[picture p87: CAD file, 2026-10-10]
hardware/altium-r5/enclosure/sealed-print/Orion-R5-plate-1-PETG-portable.3mf
186.9 x 128.0 x 30.0 mm
base
lid
fit_coupon
usb_cover
service_switch_cover
cable_pressure_cap
