Weisni/BatterySentinel-N2K/output/Orion-Enclosure-V2-Print-Package/enclosure/face_stop_coupon_1p6.stl

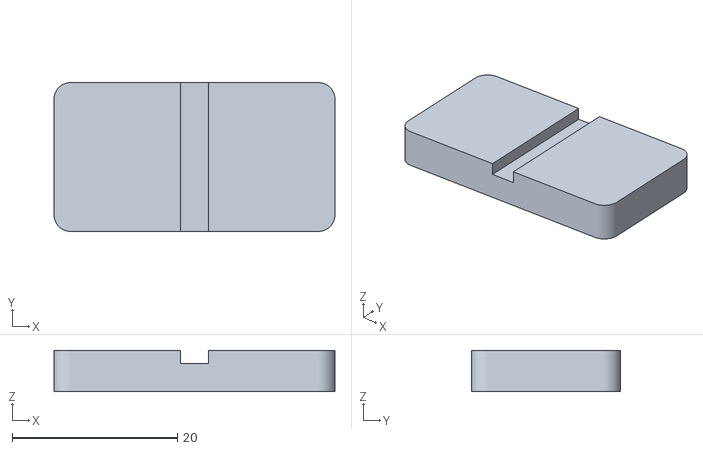
[picture p88: CAD file, 2026-10-10]
output/Orion-Enclosure-V2-Print-Package/enclosure/face_stop_coupon_1p6.stl
34.0 x 18.0 x 5.00
