Weisni/BatterySentinel-N2K/output/Orion-Enclosure-V2.3-P2S.3mf

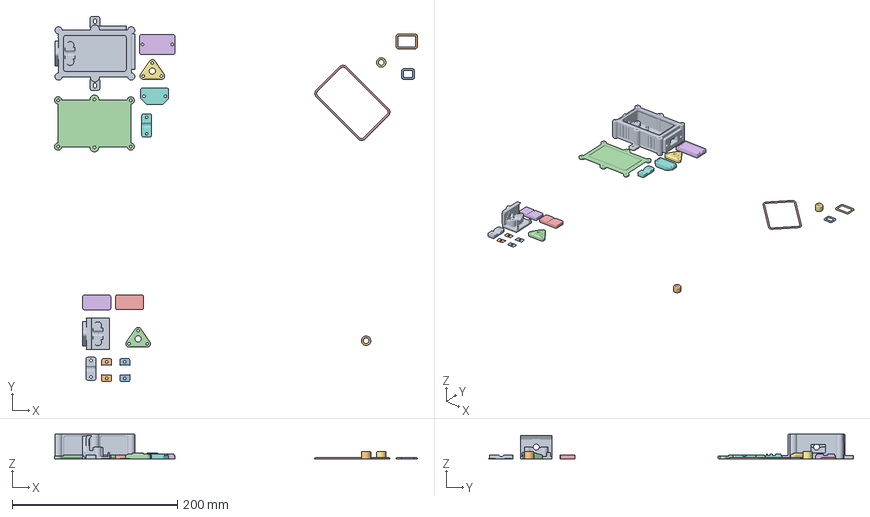
[picture p89: CAD file, 2026-10-10]
output/Orion-Enclosure-V2.3-P2S.3mf
439.9 x 442.8 x 30.0 mm
base
usb_gasket
service_switch_gasket
lid_body
lid_gasket
usb_cover
cable_pressure_cap x 2
service_switch_cover
entry_fit_coupon
clamp_shims_0p2
clamp_shims_0p4
face_stop_coupon_1p4
face_stop_coupon_1p6
Kabeltuelle_ID6p8_AD11p5_L9mm_Profiliert.stl x 2
strain_relief_upper_5mm.stl x 2
