Weisni/BatterySentinel-N2K/hardware/altium-r3/models/C1.step

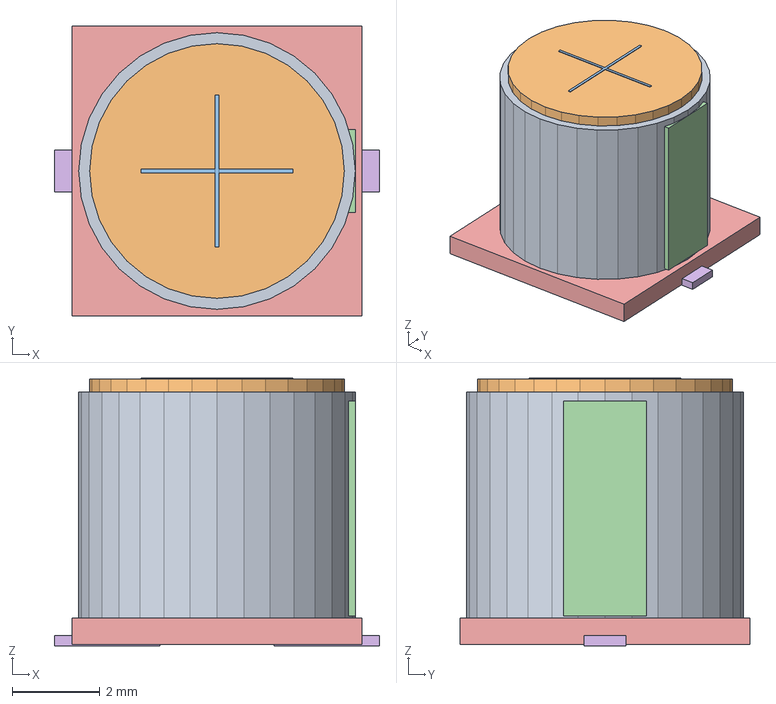
[picture p90: CAD file, 2026-10-10]
hardware/altium-r3/models/C1.step
7.40 x 6.60 x 6.10 mm
