Weisni/BatterySentinel-N2K/hardware/altium-r5/enclosure/sealed-print/service_switch_cover.stl

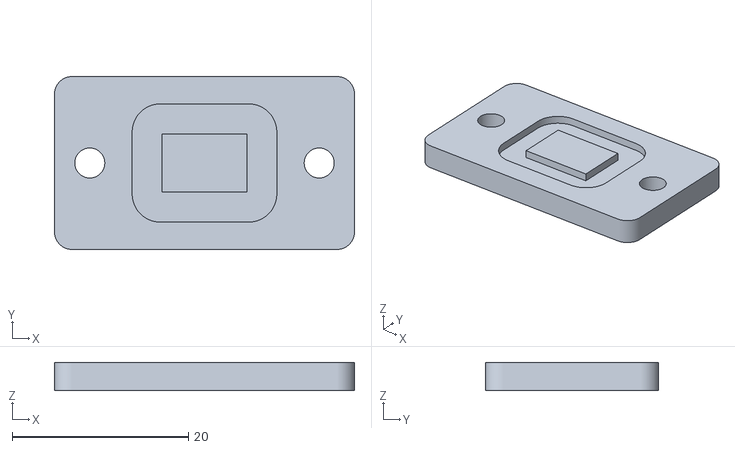
[picture p91: CAD file, 2026-10-10]
hardware/altium-r5/enclosure/sealed-print/service_switch_cover.stl
34.0 x 19.6 x 3.20
