Weisni/BatterySentinel-N2K/hardware/altium-r5/enclosure/sealed-v2/cable_seal_b6p7_L6p6.stl

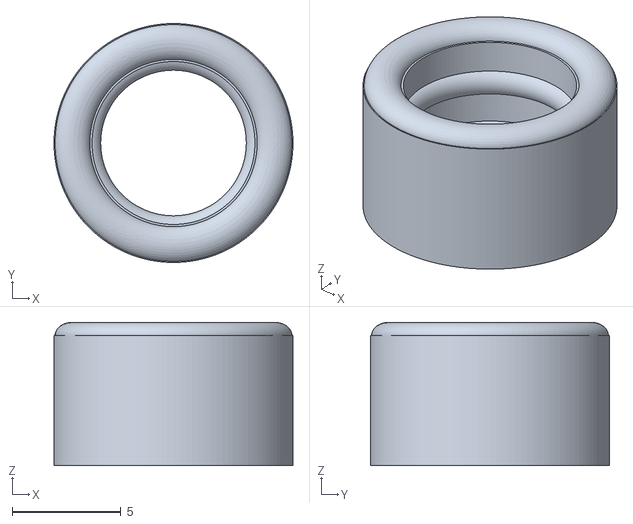
[picture p92: CAD file, 2026-10-10]
hardware/altium-r5/enclosure/sealed-v2/cable_seal_b6p7_L6p6.stl
11.0 x 11.0 x 6.60
