Weisni/BatterySentinel-N2K/hardware/altium-r5/enclosure/sealed-v2/combined-validation/input-4.3mf

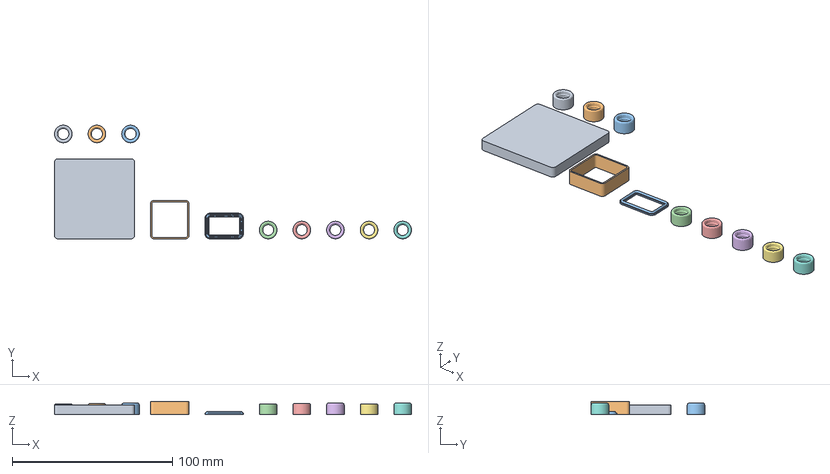
[picture p93: CAD file, 2026-10-10]
hardware/altium-r5/enclosure/sealed-v2/combined-validation/input-4.3mf
223.0 x 71.0 x 8.00 mm
shore_comparison_pad
flow_wall_coupon
face_test_gasket
cable_seal_b6p7_L6p6
cable_seal_b6p7_L6p8
cable_seal_b6p7_L7p0
cable_seal_b6p8_L6p6
cable_seal_b6p8_L7p0
cable_seal_b6p9_L6p6
cable_seal_b6p9_L6p8
cable_seal_b6p9_L7p0
