Weisni/BatterySentinel-N2K/output/Kabeltuelle_ID6p8_AD11p5_L9mm_Profiliert.stl

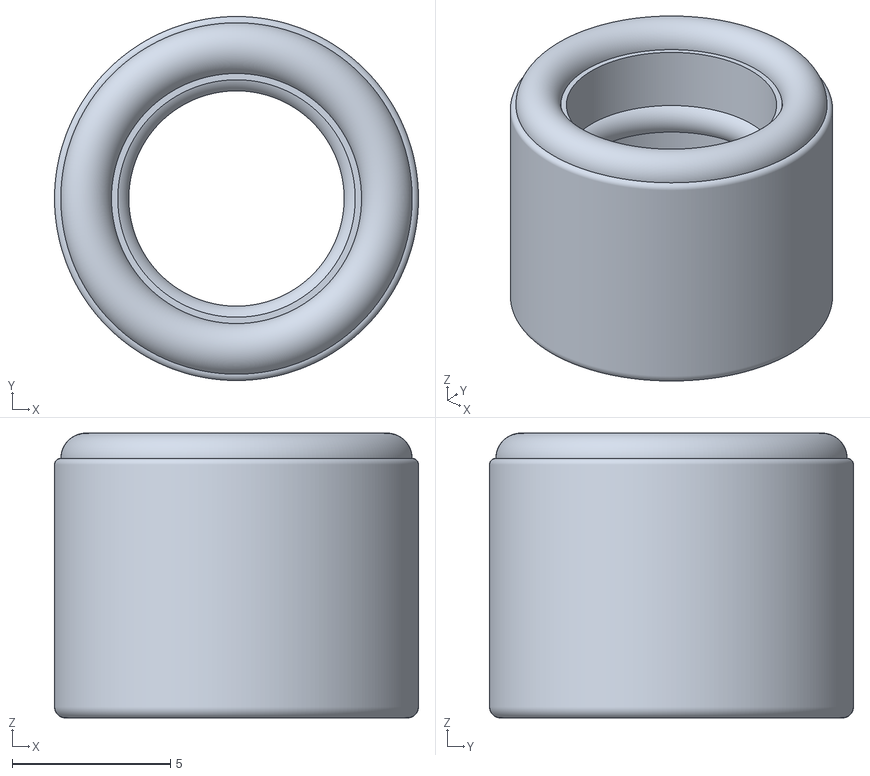
[picture p94: CAD file, 2026-10-10]
output/Kabeltuelle_ID6p8_AD11p5_L9mm_Profiliert.stl
11.5 x 11.5 x 9.00
