Weisni/BatterySentinel-N2K/output/Orion-Enclosure-V2-Print-Package/enclosure/cable_seal_b6p8_L7p0.stl

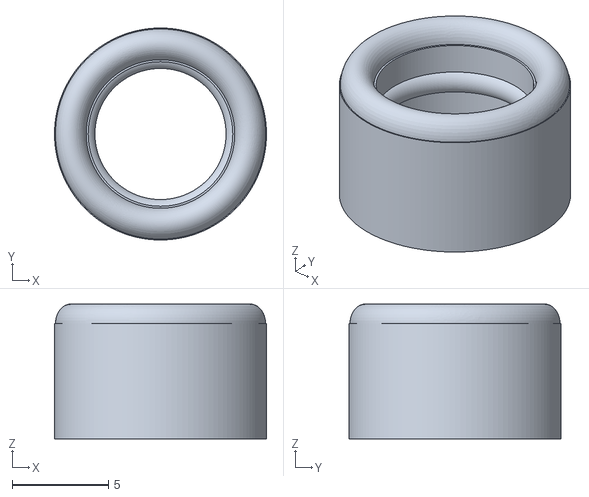
[picture p95: CAD file, 2026-10-10]
output/Orion-Enclosure-V2-Print-Package/enclosure/cable_seal_b6p8_L7p0.stl
11.0 x 11.0 x 7.00
