Weisni/BatterySentinel-N2K/hardware/altium-r3/models/J1.step

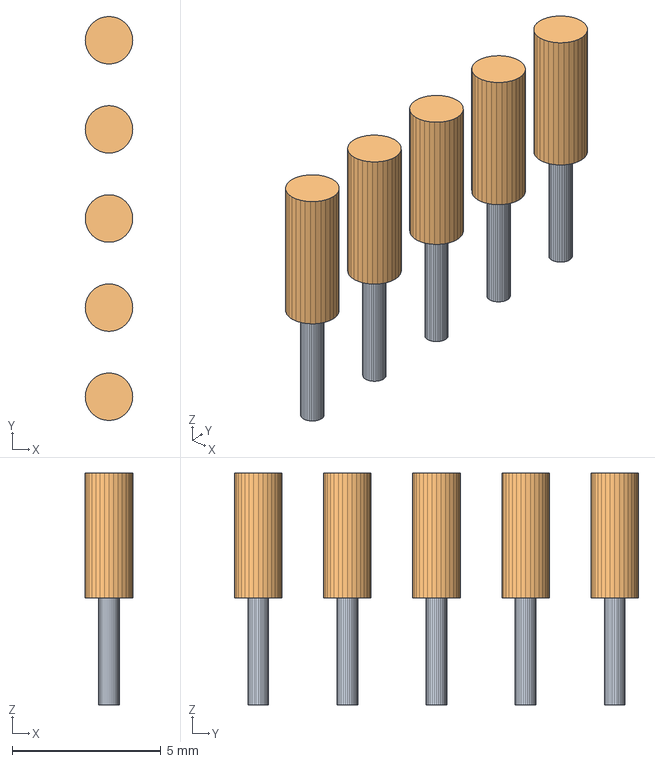
[picture p96: CAD file, 2026-10-10]
hardware/altium-r3/models/J1.step
1.60 x 13.6 x 7.80 mm
