Weisni/BatterySentinel-N2K/hardware/altium-r4/models/L1.step

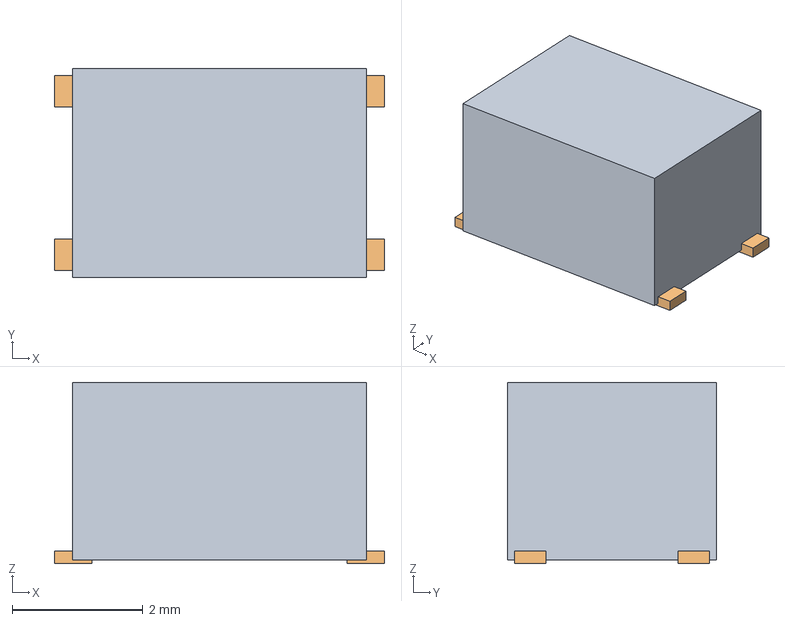
[picture p97: CAD file, 2026-10-10]
hardware/altium-r4/models/L1.step
5.05 x 3.20 x 2.77 mm
