Weisni/BatterySentinel-N2K/output/Orion-Enclosure-V2.3-Onshape/parts/cable_pressure_cap.step

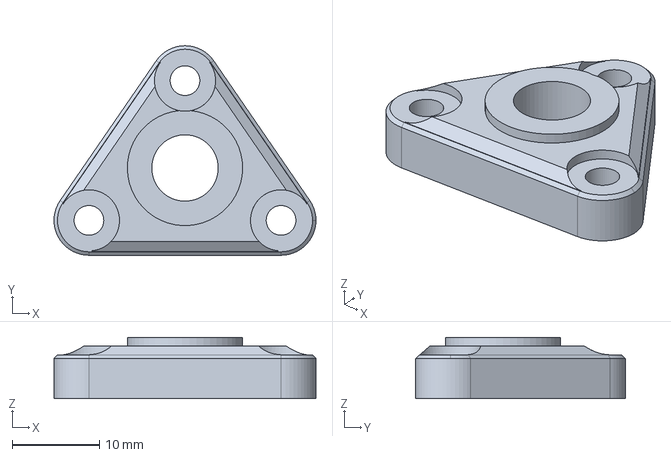
[picture p99: CAD file, 2026-10-10]
output/Orion-Enclosure-V2.3-Onshape/parts/cable_pressure_cap.step
30.0 x 24.0 x 7.00 mm
