Weisni/BatterySentinel-N2K/hardware/altium-r3/models/R2.step

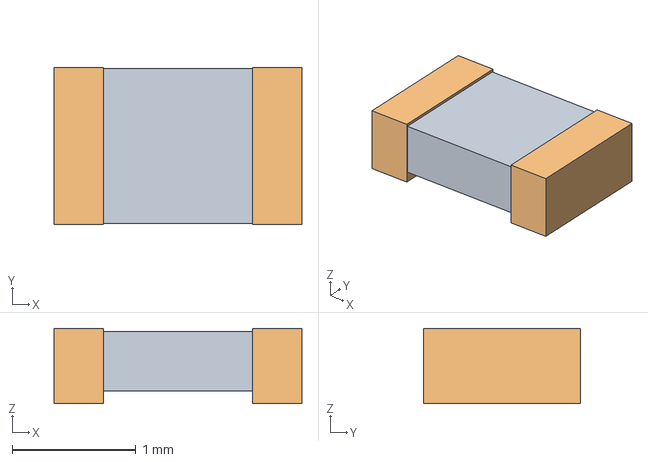
[picture p100: CAD file, 2026-10-10]
hardware/altium-r3/models/R2.step
2.00 x 1.27 x 0.605 mm
