Weisni/BatterySentinel-N2K/output/Orion-Enclosure-V2.3-Onshape/parts/entry_fit_coupon.step

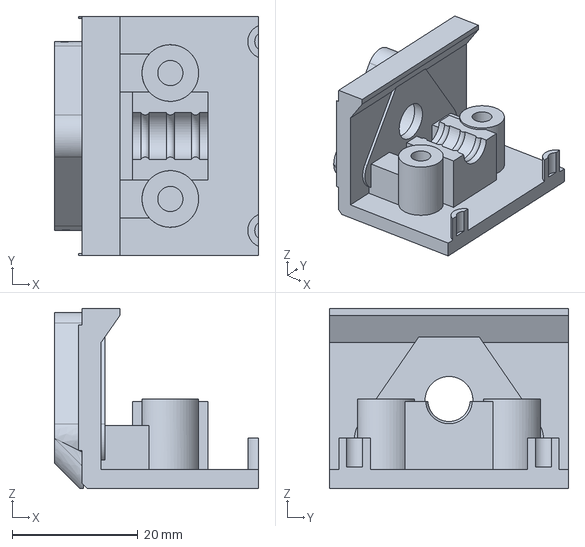
[picture p102: CAD file, 2026-10-10]
output/Orion-Enclosure-V2.3-Onshape/parts/entry_fit_coupon.step
32.4 x 38.0 x 28.6 mm
