Weisni/BatterySentinel-N2K/hardware/altium-r3/models/U2.step

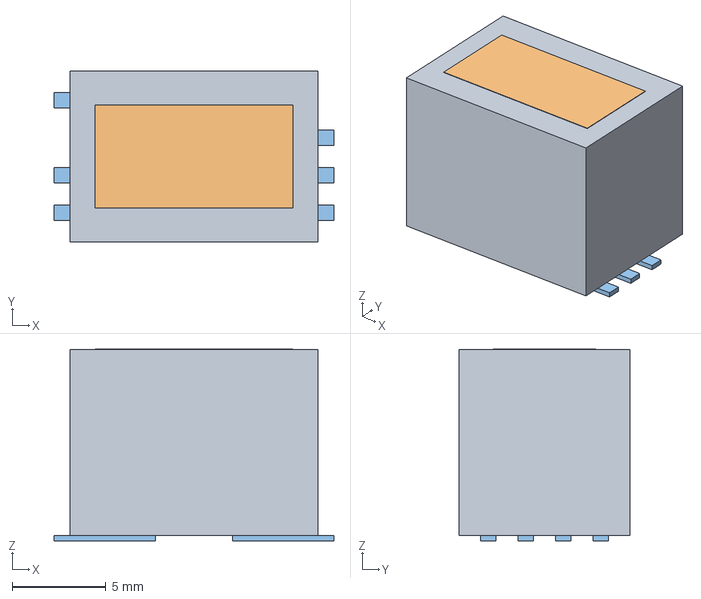
[picture p103: CAD file, 2026-10-10]
hardware/altium-r3/models/U2.step
14.9 x 9.10 x 10.2 mm
