Weisni/BatterySentinel-N2K/hardware/altium-r5/enclosure/sealed-print/base.stl

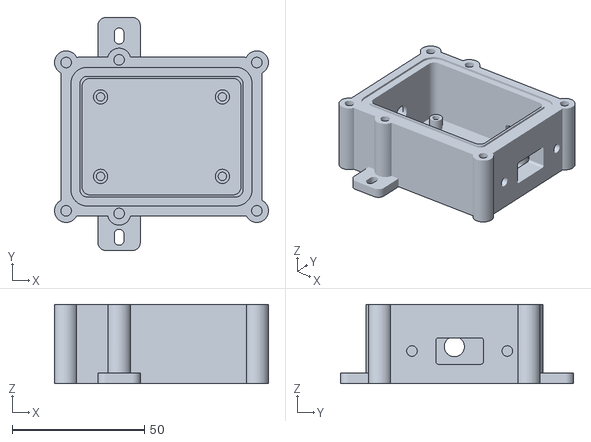
[picture p104: CAD file, 2026-10-10]
hardware/altium-r5/enclosure/sealed-print/base.stl
80.8 x 88.0 x 30.0
