Weisni/BatterySentinel-N2K/output/Orion-Enclosure-V2-Print-Package/enclosure/entry_fit_coupon.stl

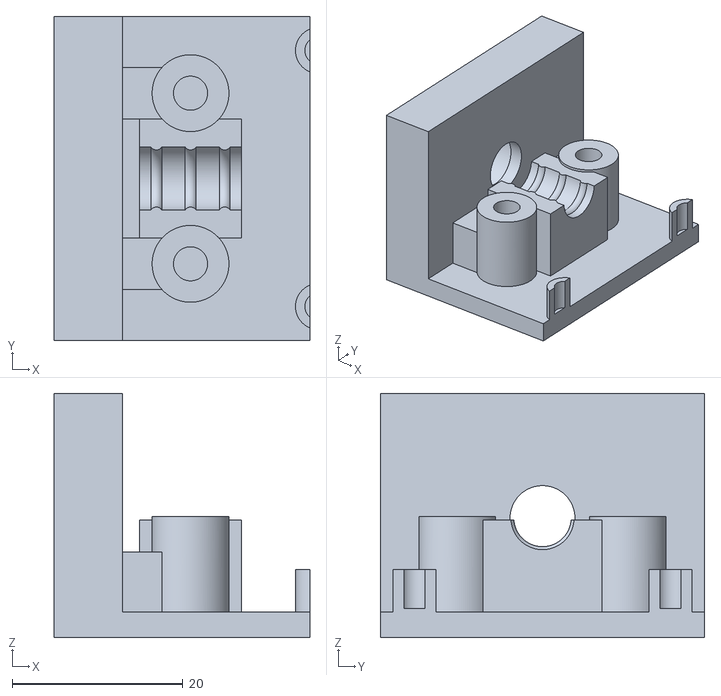
[picture p105: CAD file, 2026-10-10]
output/Orion-Enclosure-V2-Print-Package/enclosure/entry_fit_coupon.stl
30.0 x 38.0 x 28.6
