Weisni/BatterySentinel-N2K/output/Orion-Enclosure-V2.3-Onshape/parts/clamp_shims_0p4.step

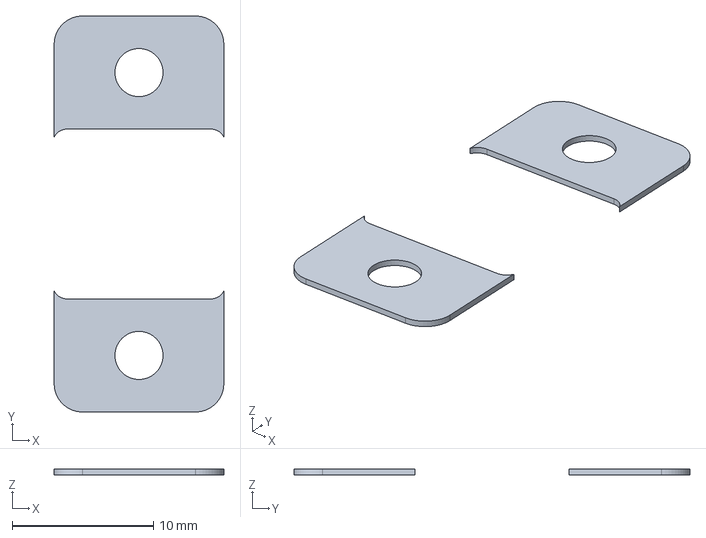
[picture p106: CAD file, 2026-10-10]
output/Orion-Enclosure-V2.3-Onshape/parts/clamp_shims_0p4.step
12.0 x 28.0 x 0.4 mm
