Weisni/BatterySentinel-N2K/hardware/altium-r3/models/Q1.step

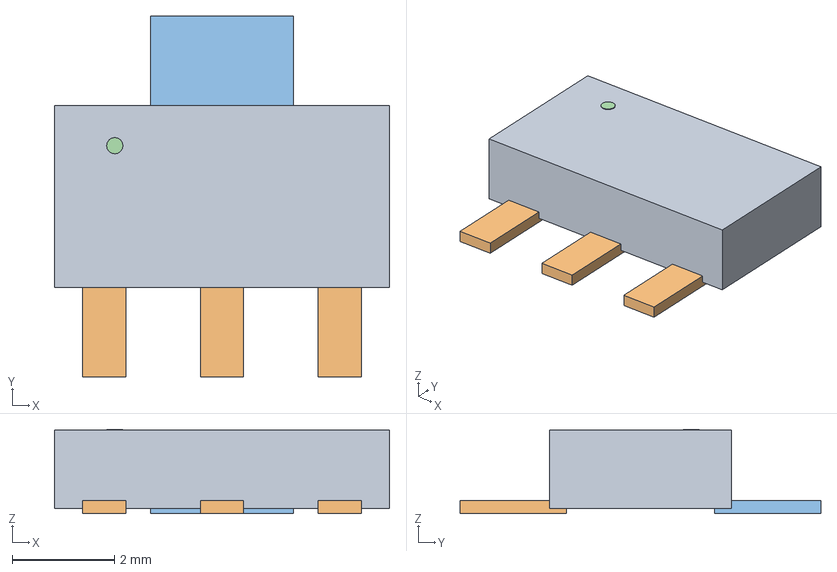
[picture p107: CAD file, 2026-10-10]
hardware/altium-r3/models/Q1.step
6.55 x 7.05 x 1.65 mm
