Weisni/BatterySentinel-N2K/hardware/altium-r4/models/D1.step

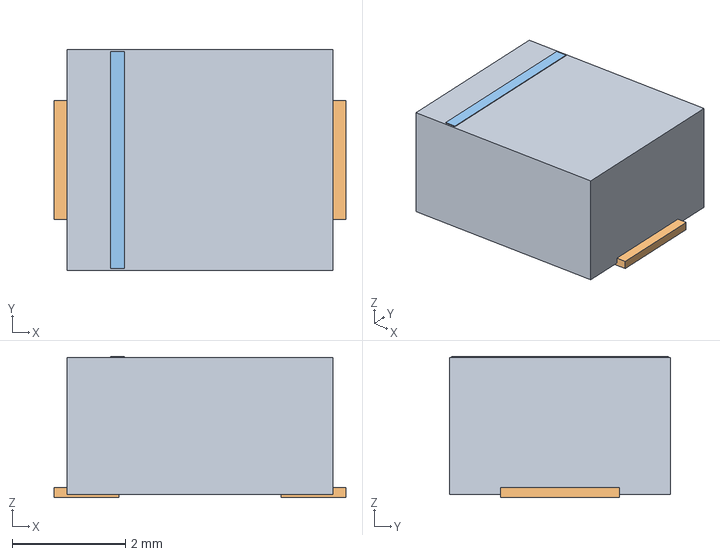
[picture p108: CAD file, 2026-10-10]
hardware/altium-r4/models/D1.step
5.15 x 3.90 x 2.49 mm
