Weisni/BatterySentinel-N2K/hardware/altium-r5/enclosure/sealed-print/Orion-R5-all-parts-portable.3mf

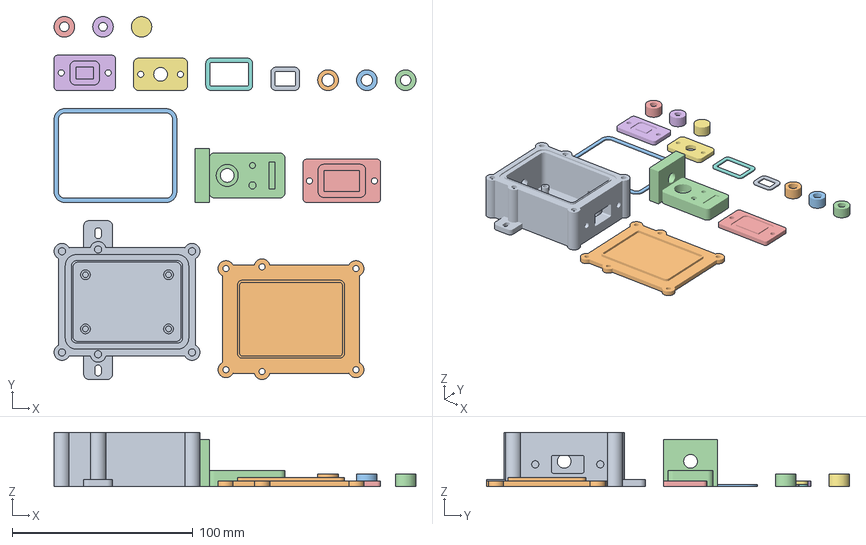
[picture p109: CAD file, 2026-10-10]
hardware/altium-r5/enclosure/sealed-print/Orion-R5-all-parts-portable.3mf
200.4 x 201.0 x 30.0 mm
base
lid
lid_gasket
fit_coupon
usb_cover
service_switch_cover
cable_pressure_cap
usb_gasket
service_switch_gasket
cable_seal_7p0mm
cable_seal_6p5mm
cable_seal_6p0mm
cable_seal_5p5mm
cable_seal_5p0mm
cable_blank
