Weisni/BatterySentinel-N2K/hardware/altium-r3/models/C6.step

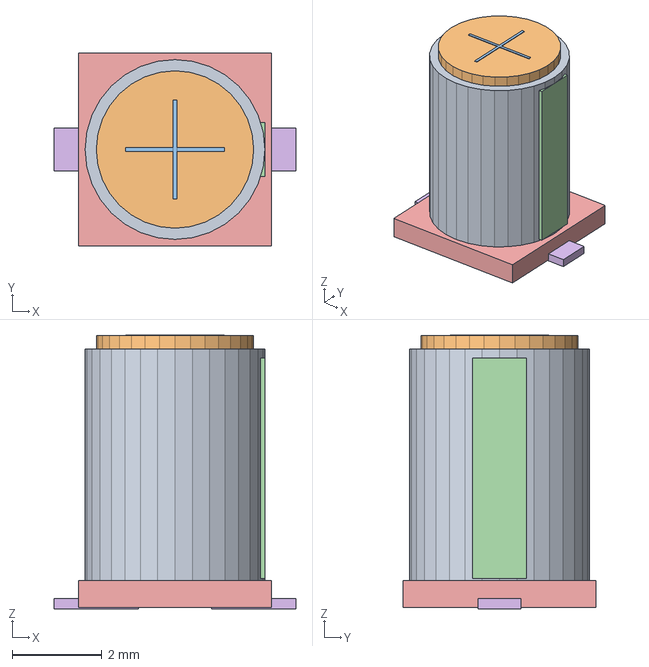
[picture p110: CAD file, 2026-10-10]
hardware/altium-r3/models/C6.step
5.38 x 4.30 x 6.10 mm
