Weisni/BatterySentinel-N2K/hardware/altium-r5/enclosure/sealed-print/cable_seal_5p0mm.stl

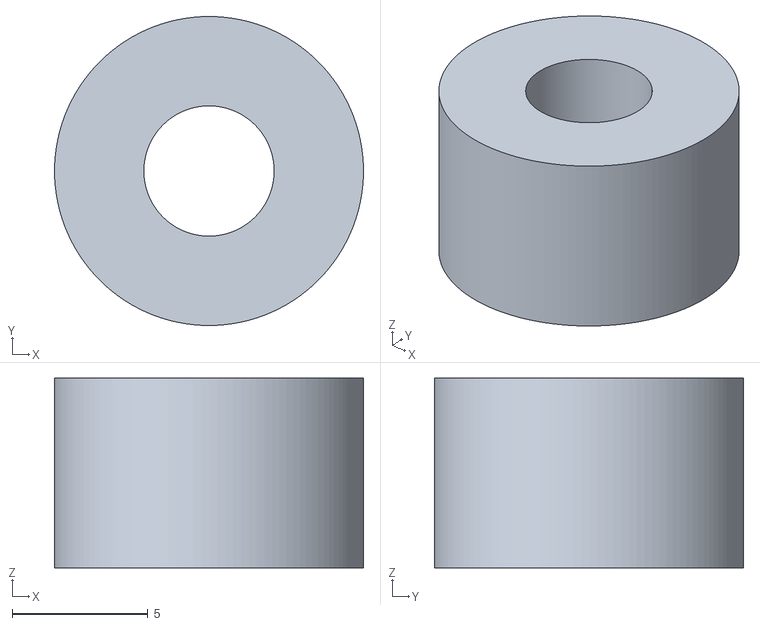
[picture p111: CAD file, 2026-10-10]
hardware/altium-r5/enclosure/sealed-print/cable_seal_5p0mm.stl
11.4 x 11.4 x 7.00
