Weisni/BatterySentinel-N2K/output/Orion-Enclosure-V2-Print-Package/enclosure/lid_body.stl

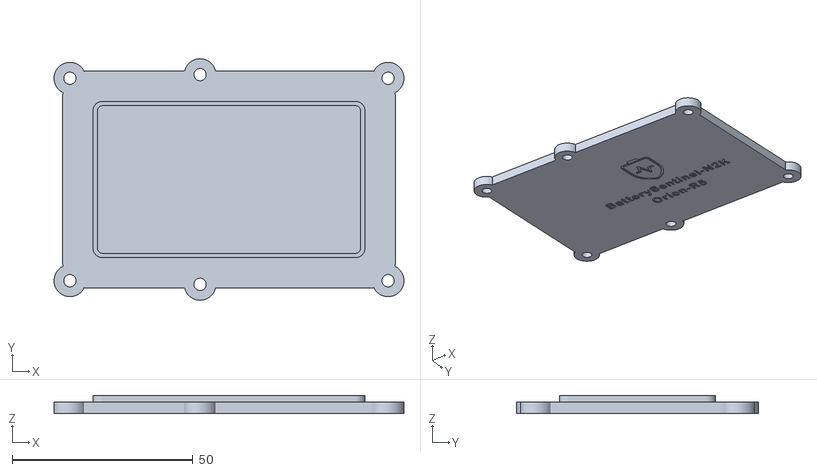
[picture p112: CAD file, 2026-10-10]
output/Orion-Enclosure-V2-Print-Package/enclosure/lid_body.stl
96.8 x 66.8 x 5.00
