Weisni/BatterySentinel-N2K/hardware/altium-r3/models/Z1.step

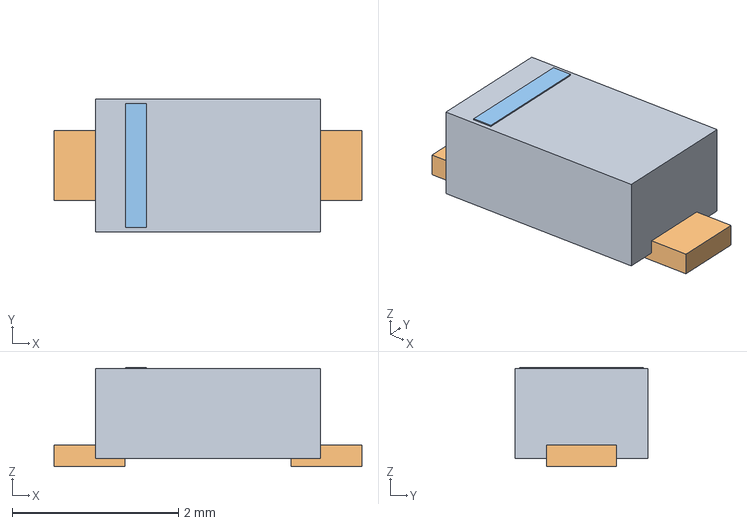
[picture p113: CAD file, 2026-10-10]
hardware/altium-r3/models/Z1.step
3.70 x 1.60 x 1.20 mm
