Weisni/BatterySentinel-N2K/hardware/altium-r5/enclosure/sealed-print/Orion-R5-plate-2-TPU-portable.3mf

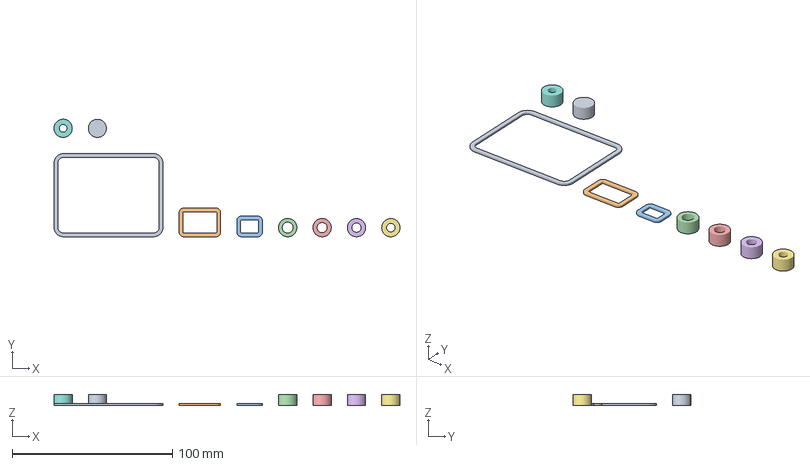
[picture p114: CAD file, 2026-10-10]
hardware/altium-r5/enclosure/sealed-print/Orion-R5-plate-2-TPU-portable.3mf
215.8 x 73.4 x 7.00 mm
lid_gasket
usb_gasket
service_switch_gasket
cable_seal_7p0mm
cable_seal_6p5mm
cable_seal_6p0mm
cable_seal_5p5mm
cable_seal_5p0mm
cable_blank
