Weisni/BatterySentinel-N2K/hardware/altium-r5/enclosure/sealed-v2/cable_seal_b6p9_L7p0.stl

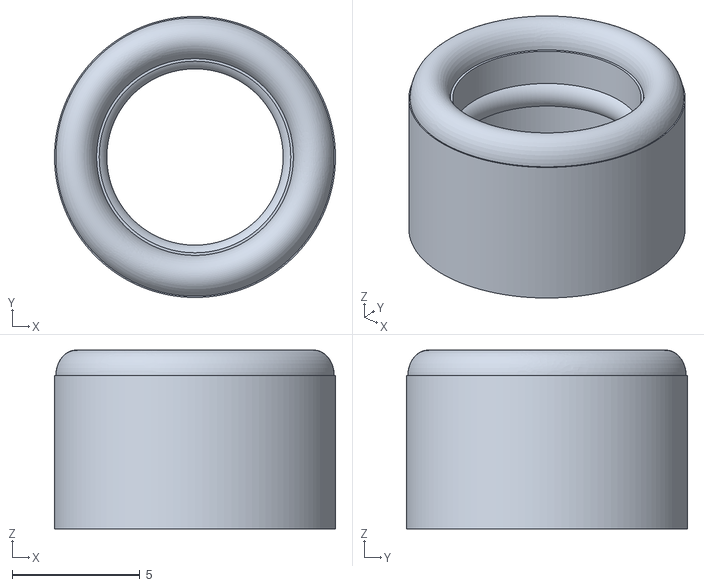
[picture p115: CAD file, 2026-10-10]
hardware/altium-r5/enclosure/sealed-v2/cable_seal_b6p9_L7p0.stl
11.0 x 11.0 x 7.00
