Weisni/BatterySentinel-N2K/output/Orion-Enclosure-V2-Print-Package/enclosure/base.stl

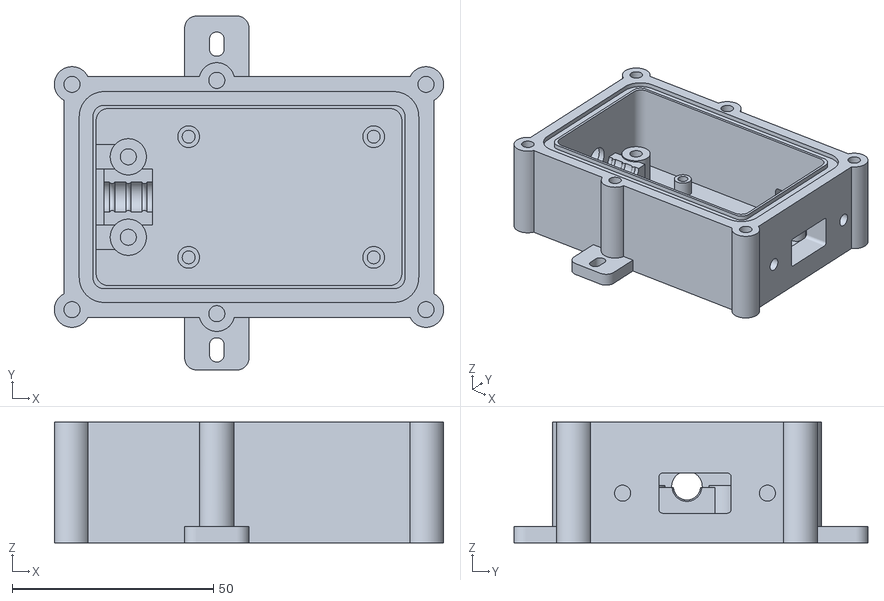
[picture p116: CAD file, 2026-10-10]
output/Orion-Enclosure-V2-Print-Package/enclosure/base.stl
96.8 x 88.0 x 30.0
