Weisni/BatterySentinel-N2K/hardware/altium-r5/enclosure/sealed-v2/service_switch_cover.stl

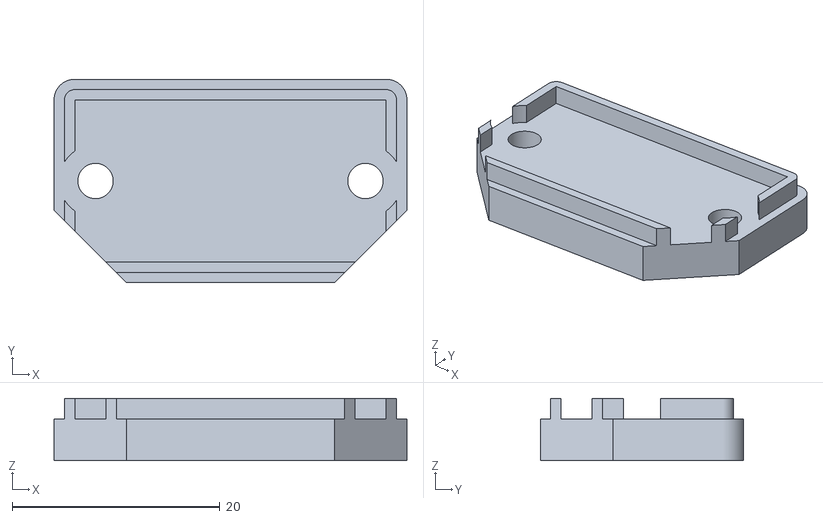
[picture p117: CAD file, 2026-10-10]
hardware/altium-r5/enclosure/sealed-v2/service_switch_cover.stl
34.0 x 19.6 x 6.00
