Weisni/BatterySentinel-N2K/hardware/altium-r3/models/MCU1.step

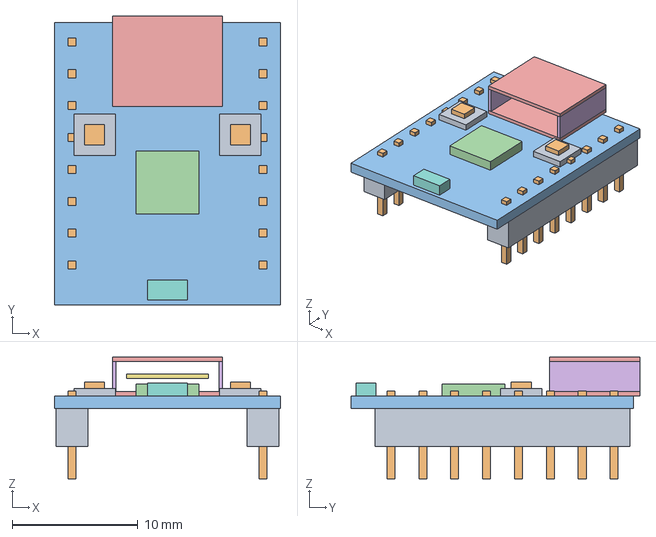
[picture p118: CAD file, 2026-10-10]
hardware/altium-r3/models/MCU1.step
18.0 x 23.0 x 9.70 mm
