Weisni/BatterySentinel-N2K/hardware/altium-r5/enclosure/sealed-print/cable_blank.stl

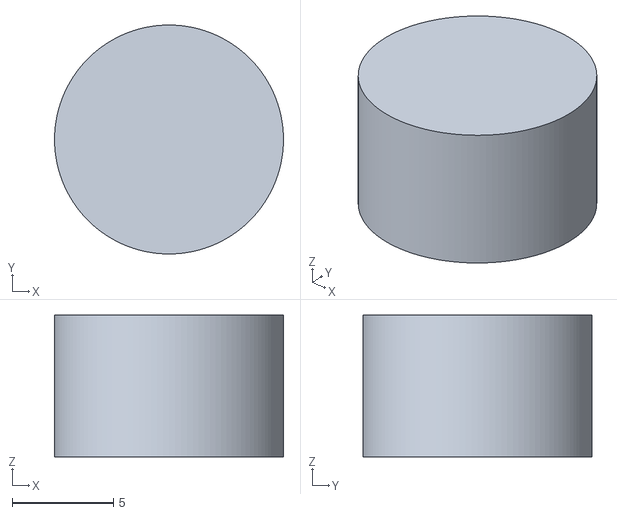
[picture p119: CAD file, 2026-10-10]
hardware/altium-r5/enclosure/sealed-print/cable_blank.stl
11.3 x 11.3 x 7.00
