Weisni/BatterySentinel-N2K/hardware/altium-r3/models/U3.step

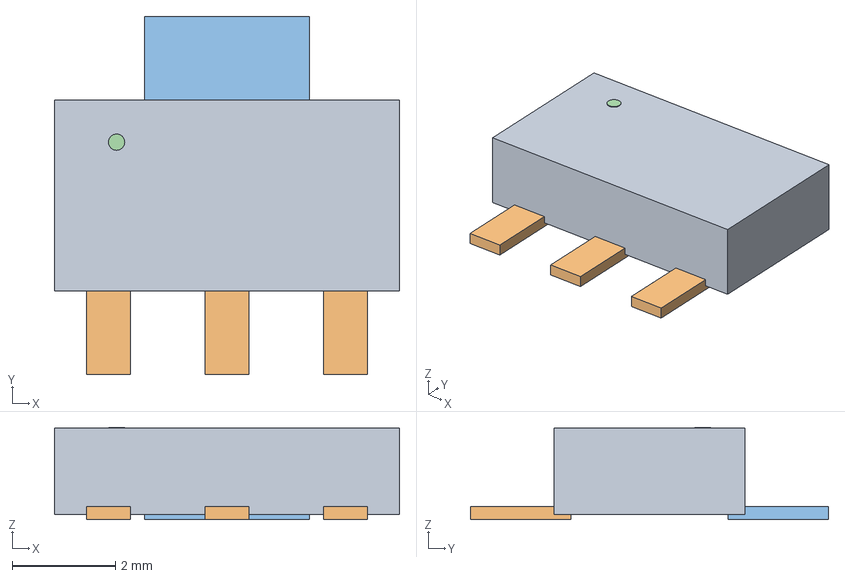
[picture p120: CAD file, 2026-10-10]
hardware/altium-r3/models/U3.step
6.70 x 6.95 x 1.79 mm
