Weisni/BatterySentinel-N2K/hardware/altium-r4/models/D6.step

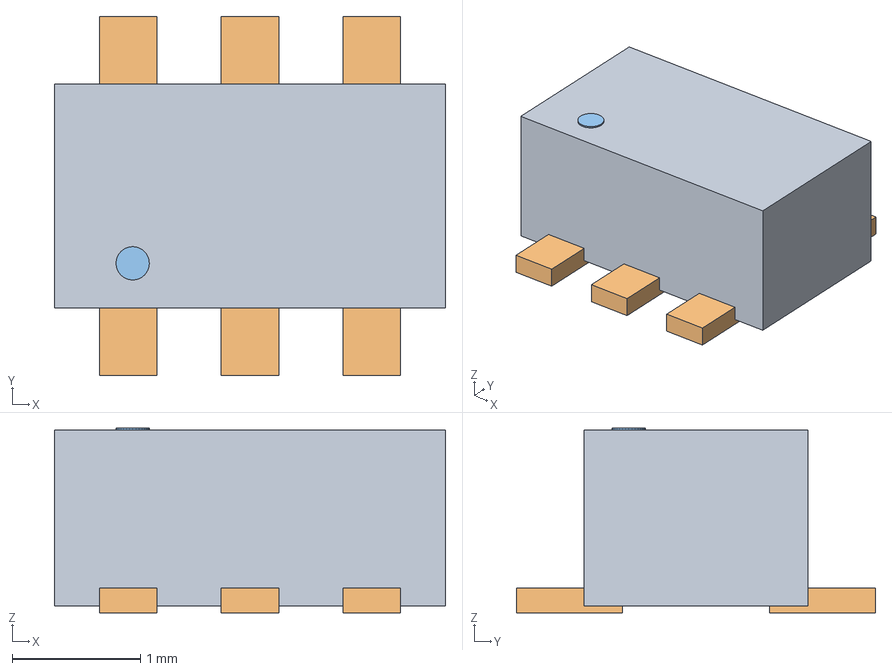
[picture p121: CAD file, 2026-10-10]
hardware/altium-r4/models/D6.step
3.05 x 2.80 x 1.44 mm
