Weisni/BatterySentinel-N2K/hardware/altium-r5/enclosure/sealed-v2/service_switch_gasket.stl

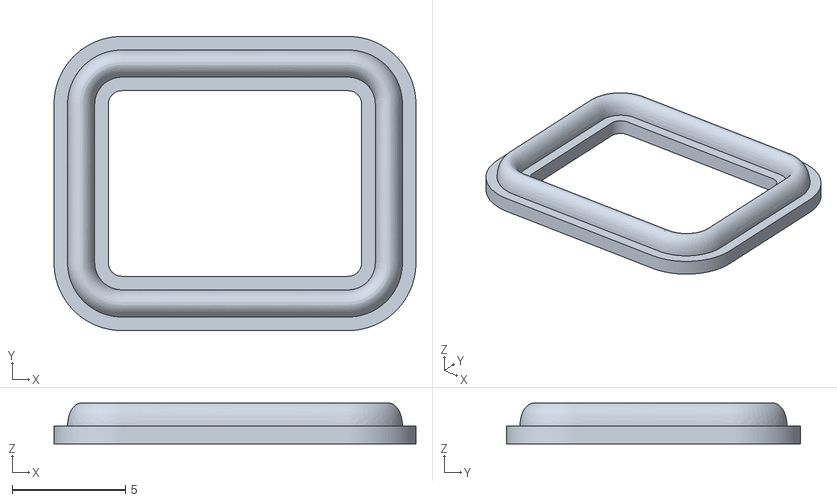
[picture p122: CAD file, 2026-10-10]
hardware/altium-r5/enclosure/sealed-v2/service_switch_gasket.stl
16.0 x 13.0 x 1.80
