Weisni/BatterySentinel-N2K/output/Orion-Enclosure-V2.3-Onshape/parts/flow_wall_coupon.step

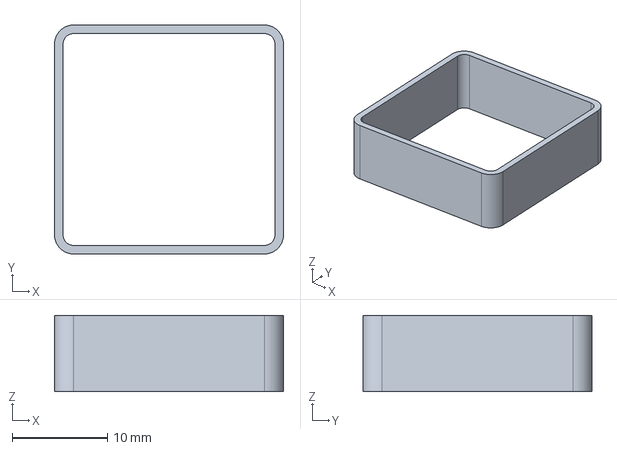
[picture p123: CAD file, 2026-10-10]
output/Orion-Enclosure-V2.3-Onshape/parts/flow_wall_coupon.step
24.0 x 24.0 x 8.00 mm
