Weisni/BatterySentinel-N2K/hardware/altium-r5/enclosure/sealed-print/Orion-R5-P2S-flush-colour.3mf

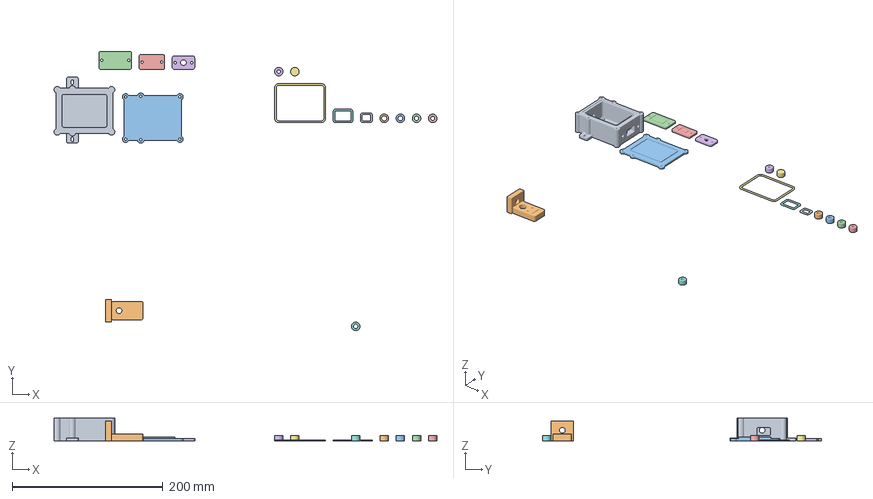
[picture p124: CAD file, 2026-10-10]
hardware/altium-r5/enclosure/sealed-print/Orion-R5-P2S-flush-colour.3mf
508.6 x 370.9 x 30.0 mm
base
fit_coupon
lid
usb_cover
service_switch_cover
cable_pressure_cap
lid_gasket
usb_gasket
service_switch_gasket
cable_seal_7p0mm
cable_seal_6p5mm
cable_seal_6p0mm x 2
cable_seal_5p5mm
cable_seal_5p0mm
cable_blank
