Weisni/BatterySentinel-N2K/output/Orion-Enclosure-V2-Print-Package/enclosure/clamp_shims_0p2.stl

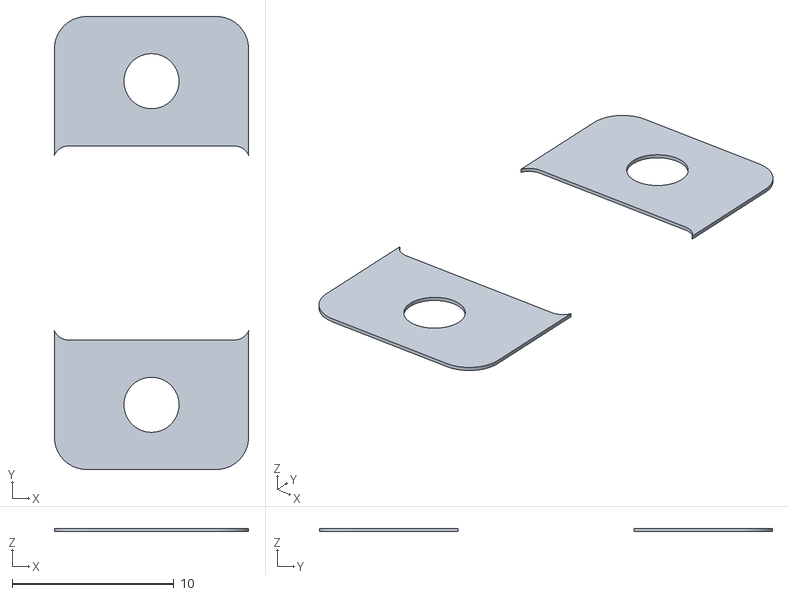
[picture p125: CAD file, 2026-10-10]
output/Orion-Enclosure-V2-Print-Package/enclosure/clamp_shims_0p2.stl
12.0 x 28.0 x 0.2
