Weisni/BatterySentinel-N2K/hardware/altium-r3/models/JP1.step

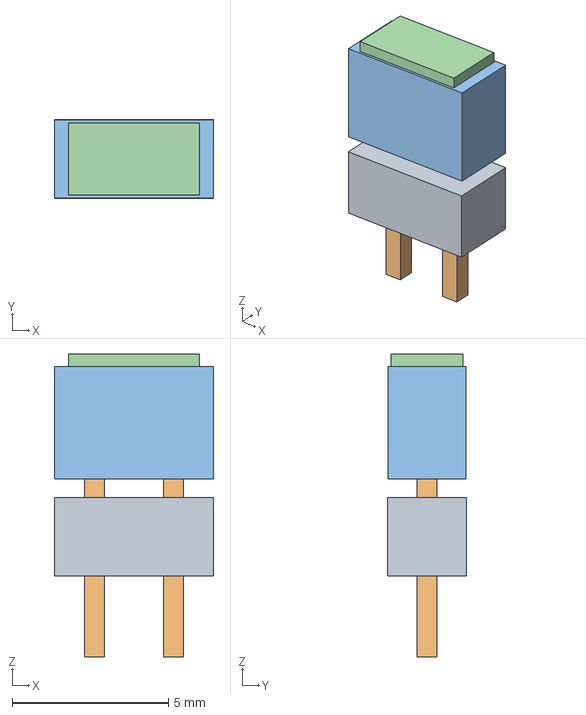
[picture p126: CAD file, 2026-10-10]
hardware/altium-r3/models/JP1.step
5.10 x 2.54 x 9.70 mm
