Weisni/BatterySentinel-N2K/hardware/altium-r4/models/MCU1.step

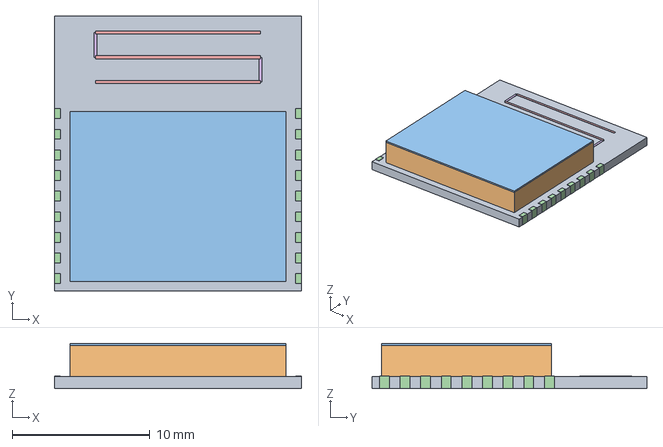
[picture p127: CAD file, 2026-10-10]
hardware/altium-r4/models/MCU1.step
18.0 x 20.0 x 3.29 mm
