Weisni/BatterySentinel-N2K/hardware/altium-r5/enclosure/sealed-print/lid_gasket.stl

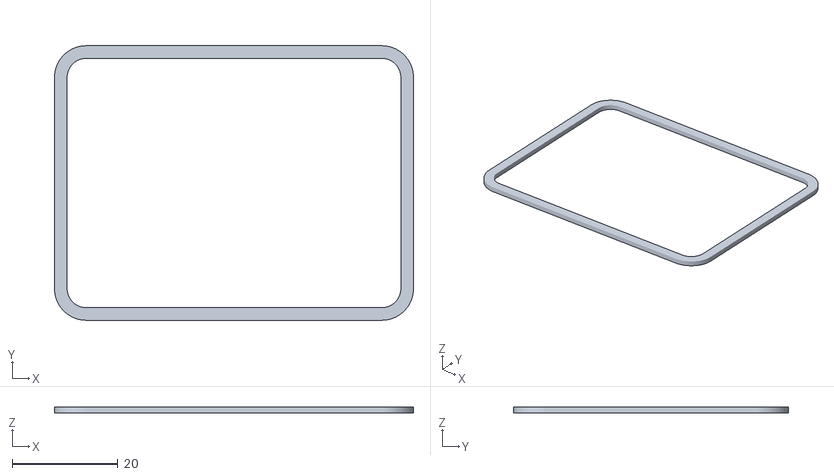
[picture p128: CAD file, 2026-10-10]
hardware/altium-r5/enclosure/sealed-print/lid_gasket.stl
68.0 x 52.0 x 1.20
