Weisni/BatterySentinel-N2K/hardware/altium-r3/models/C8.step

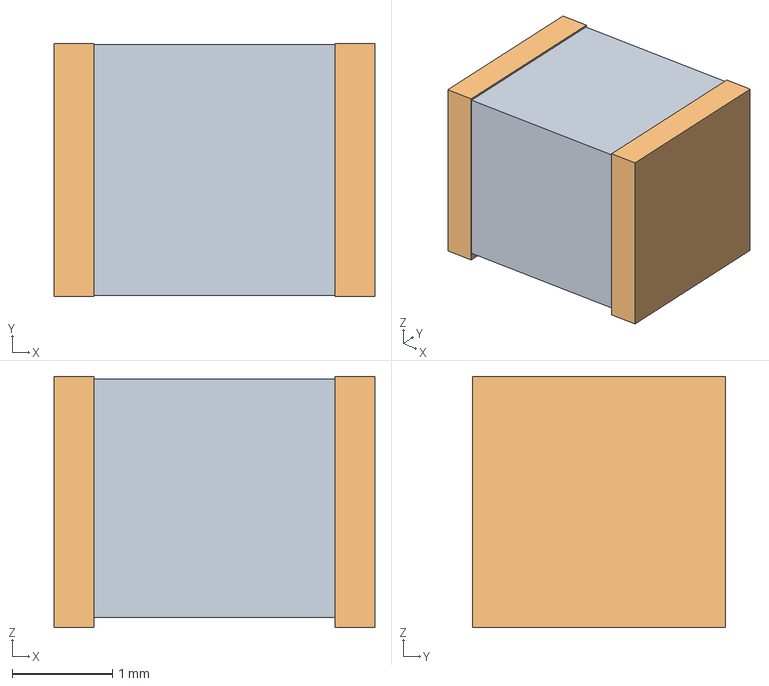
[picture p129: CAD file, 2026-10-10]
hardware/altium-r3/models/C8.step
3.20 x 2.52 x 2.50 mm
