Weisni/BatterySentinel-N2K/hardware/altium-r4/models/L3.step

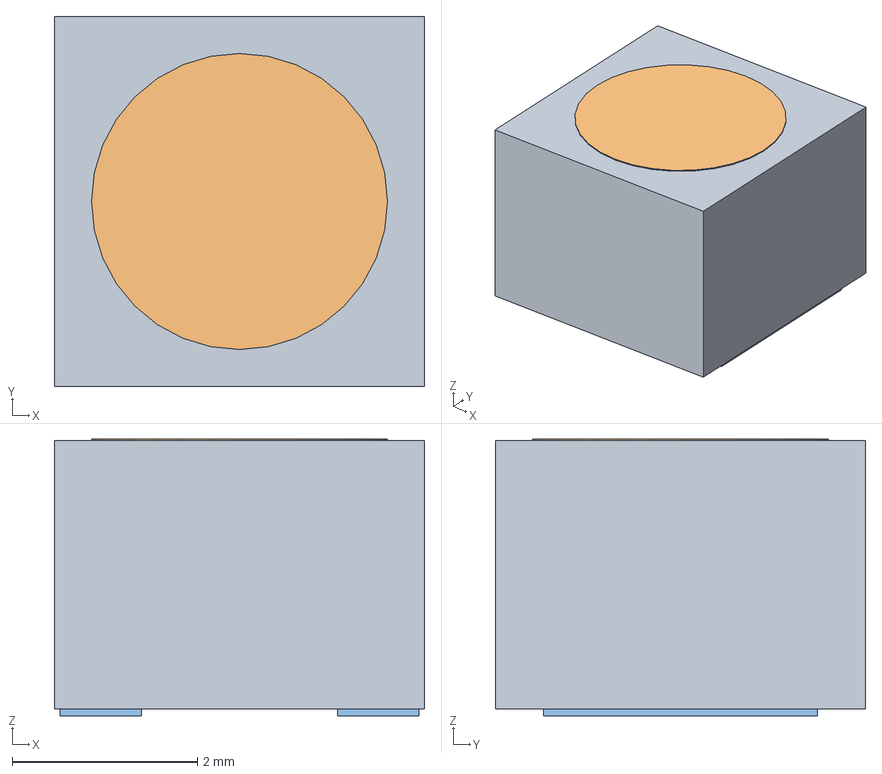
[picture p130: CAD file, 2026-10-10]
hardware/altium-r4/models/L3.step
4.00 x 4.00 x 2.99 mm
