Weisni/BatterySentinel-N2K/hardware/altium-r5/enclosure/sealed-print/cable_pressure_cap.stl

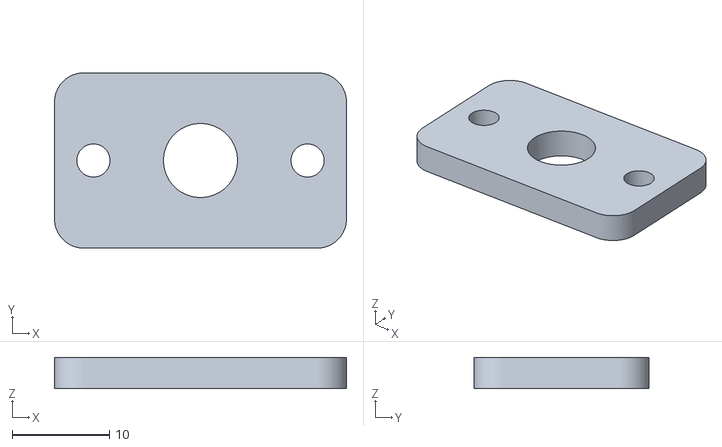
[picture p131: CAD file, 2026-10-10]
hardware/altium-r5/enclosure/sealed-print/cable_pressure_cap.stl
30.0 x 18.0 x 3.20
