Weisni/BatterySentinel-N2K/output/Orion-Enclosure-V2.3-Onshape/parts/cable_seal_b6p9_L6p8.step

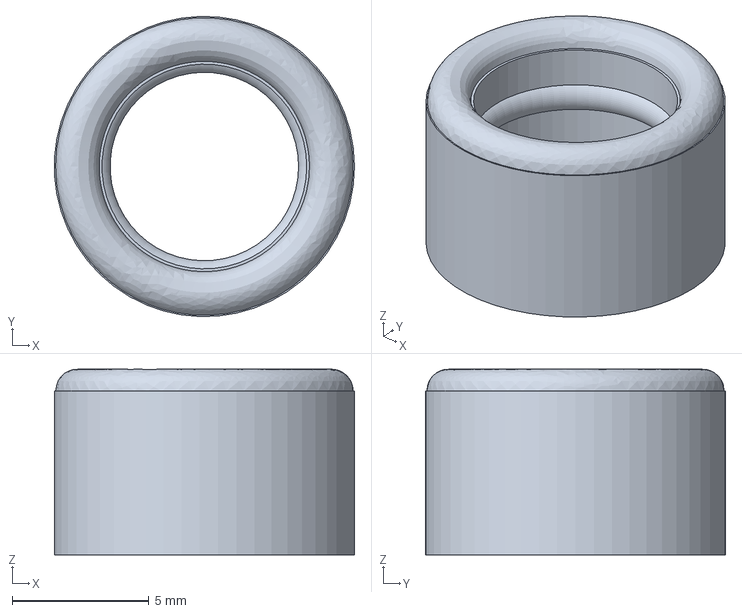
[picture p132: CAD file, 2026-10-10]
output/Orion-Enclosure-V2.3-Onshape/parts/cable_seal_b6p9_L6p8.step
11.0 x 11.0 x 6.80 mm
