Weisni/BatterySentinel-N2K/hardware/altium-r5/enclosure/sealed-print/cable_seal_7p0mm.stl

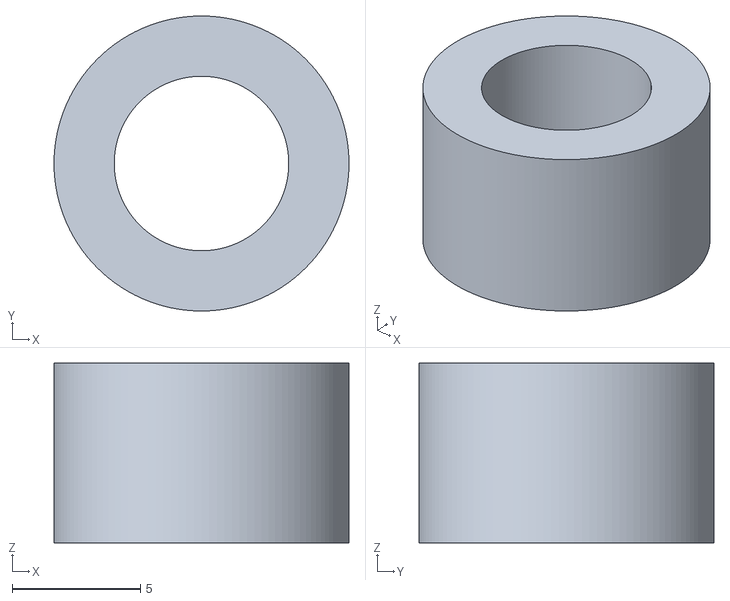
[picture p133: CAD file, 2026-10-10]
hardware/altium-r5/enclosure/sealed-print/cable_seal_7p0mm.stl
11.5 x 11.5 x 7.00
