Weisni/BatterySentinel-N2K/output/Orion-Enclosure-V2-Print-Package/enclosure/face_test_gasket.stl

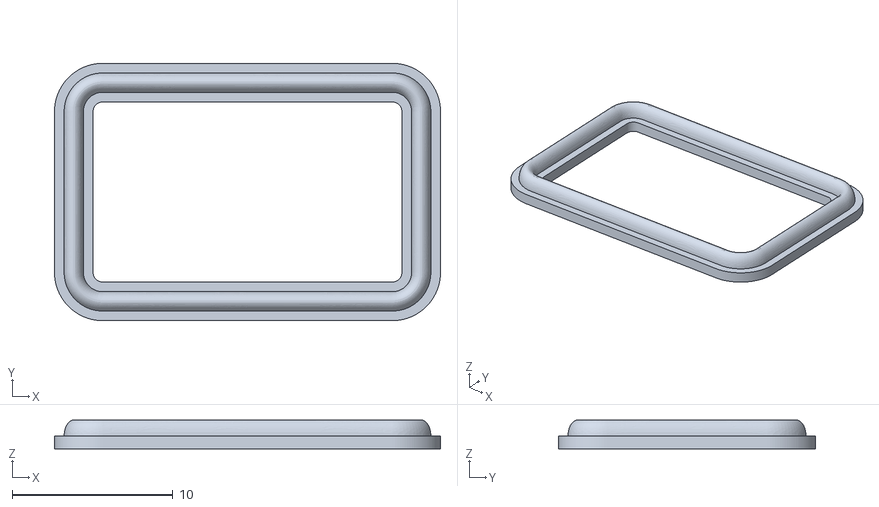
[picture p134: CAD file, 2026-10-10]
output/Orion-Enclosure-V2-Print-Package/enclosure/face_test_gasket.stl
24.0 x 16.0 x 1.80
