Weisni/BatterySentinel-N2K/output/Orion-Enclosure-V2.3-Onshape/parts/base.step

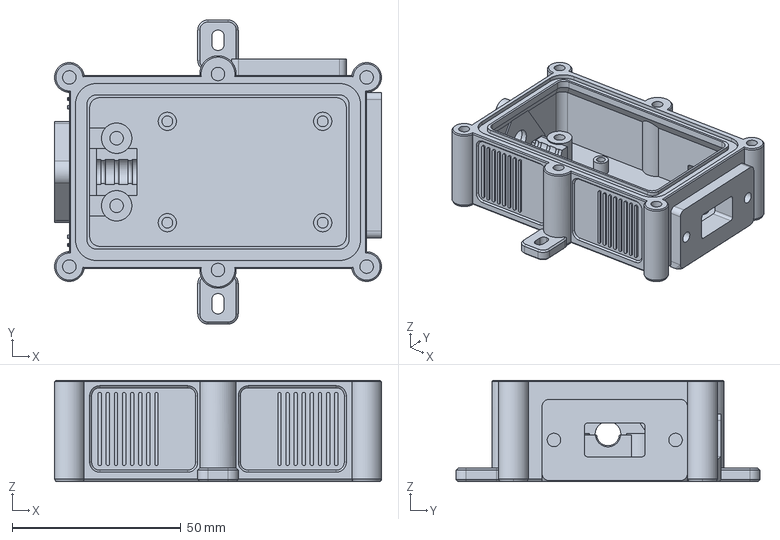
[picture p135: CAD file, 2026-10-10]
output/Orion-Enclosure-V2.3-Onshape/parts/base.step
96.8 x 90.0 x 30.0 mm
