Weisni/BatterySentinel-N2K/hardware/altium-r3/models/C5.step

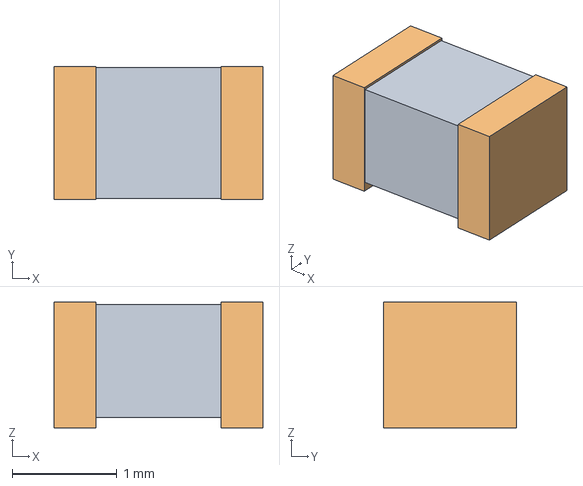
[picture p136: CAD file, 2026-10-10]
hardware/altium-r3/models/C5.step
2.00 x 1.27 x 1.21 mm
