Weisni/BatterySentinel-N2K/hardware/altium-r4/models/U1.step

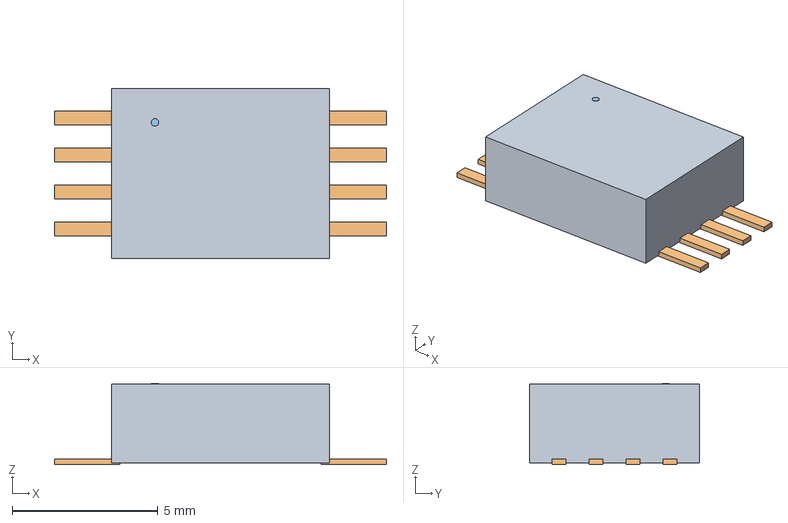
[picture p137: CAD file, 2026-10-10]
hardware/altium-r4/models/U1.step
11.4 x 5.85 x 2.79 mm
