Weisni/BatterySentinel-N2K/(list of files, cad)

Other CAD files:
hardware/altium-r5/enclosure/sealed-print/awesome-ai-profiles/validation/quack-020/validation.3mf
hardware/altium-r5/enclosure/sealed-print/flush-colour/native-reopen/disposable-reopened.3mf
hardware/altium-r5/enclosure/sealed-print/flush-colour/native-validation/disposable-native.3mf
hardware/altium-r5/enclosure/sealed-print/native-validation/packaging-input.3mf
hardware/altium-r5/enclosure/sealed-v2/native-validation/Orion-V2-TPU-Air-245C/verified.3mf
hardware/altium-r5/enclosure/sealed-v2/native-validation/Orion-V2-TPU-Air-255C/verified.3mf
output/Orion-Enclosure-V2.3-Onshape/parts/cable_seal_b6p8_L6p8.step
hardware/altium-r5/enclosure/sealed-print/flush-colour/lid_body.stl
hardware/altium-r5/enclosure/sealed-print/native-validation/Orion-R5-enclosure-P2S-verified.3mf
hardware/altium-r4/models/R12.step
hardware/altium-r5/enclosure/sealed-v2/step-probe/cable_pressure_cap.step
output/Orion-Enclosure-V2.3-Onshape/parts/strain_relief_upper.step
hardware/altium-r5/enclosure/sealed-v2/combined-validation/input-0.3mf
hardware/altium-r5/enclosure/sealed-v2/Orion-V2-TPU-Air-255C.3mf
hardware/altium-r5/enclosure/sealed-v2/step-probe/strain_relief_upper-import.step
output/Orion-Enclosure-V2.3-Onshape/parts/shore_comparison_pad.step
hardware/altium-r4/models/C27.step
output/Orion-Enclosure-V2.3-Onshape/parts/cable_seal_b6p7_L7p0.step
hardware/altium-r5/enclosure/sealed-v2/combined-validation/combined-input.3mf
hardware/altium-r5/enclosure/sealed-v2/Orion-V2-PETG-Coupons.3mf
output/strain_relief_upper_5mm.stl
hardware/altium-r4/models/C5.step
hardware/altium-r5/enclosure/sealed-v2/combined-validation/roundtrip.3mf
hardware/altium-r5/enclosure/sealed-v2/lid_gasket.stl
output/Orion-Enclosure-V2-Print-Package/enclosure/face_stop_coupon_1p4.stl
hardware/altium-r4/models/C22.step
hardware/altium-r5/enclosure/sealed-v2/cable_seal_b6p9_L6p6.stl
hardware/altium-r5/enclosure/sealed-v2/combined-validation/input-3.3mf
output/Orion-Enclosure-V2-Print-Package/enclosure/cable_seal_b6p7_L7p0.stl
output/Orion-Enclosure-V2.3-Onshape/parts/cable_seal_b6p8_L7p0.step
hardware/altium-r4/models/C33.step
hardware/altium-r5/enclosure/sealed-v2/entry_fit_coupon.stl
output/Orion-Enclosure-V2.3-Onshape/parts/usb_gasket.step
hardware/altium-r4/models/R9.step
output/Orion-Enclosure-V2.3-Onshape/parts/cable_seal_b6p7_L6p6.step
hardware/altium-r4/models/C12.step
hardware/altium-r5/enclosure/sealed-print/fit_coupon.stl
output/Orion-Enclosure-V2-Print-Package/enclosure/Orion-V2-TPU-Air-245C.3mf
output/Orion-Enclosure-V2.3-Onshape/parts/lid_markings.step
hardware/altium-r4/models/C31.step
hardware/altium-r5/enclosure/sealed-v2/cable_seal_b6p7_L6p8.stl
output/Orion-Enclosure-V2-Print-Package/enclosure/Orion-V2-TPU-Air-255C.3mf
output/Orion-Enclosure-V2.3-Onshape/parts/face_stop_coupon_1p6.step
hardware/altium-r5/enclosure/sealed-print/cable_seal_6p5mm.stl
output/Orion-Enclosure-V2-Print-Package/enclosure/usb_cover.stl
hardware/altium-r3/models/R3.step
hardware/altium-r4/models/R4.step
hardware/altium-r5/enclosure/sealed-v2/flow_wall_coupon.stl
output/Orion-Enclosure-V2.3-Onshape/parts/cable_seal_b6p8_L6p6.step
hardware/altium-r5/enclosure/sealed-v2/Orion-V2-TPU-Air-235C.3mf
output/Orion-Enclosure-V2-Print-Package/enclosure/cable_pressure_cap.stl
output/Orion-Enclosure-V2.3-Onshape/parts/clamp_shims_0p2.step
hardware/altium-r5/enclosure/sealed-v2/cable_seal_b6p8_L6p6.stl
output/Orion-Enclosure-V2-Print-Package/enclosure/strain_relief_upper.stl
hardware/altium-r3/models/R1.step
hardware/altium-r4/models/C26.step
hardware/altium-r5/enclosure/sealed-v2/cable_seal_b6p9_L6p8.stl
hardware/altium-r3/models/C2.step
hardware/altium-r3/models/C3.step
hardware/altium-r3/models/C4.step
hardware/altium-r3/models/C7.step
hardware/altium-r3/models/C9.step
hardware/altium-r3/models/D2.step
hardware/altium-r3/models/F1.step
hardware/altium-r3/models/L1.step
hardware/altium-r3/models/R4.step
hardware/altium-r3/models/U1.step
hardware/altium-r4/models/C10.step
hardware/altium-r4/models/C11.step
hardware/altium-r4/models/C20.step
hardware/altium-r4/models/C21.step
hardware/altium-r4/models/C24.step
hardware/altium-r4/models/C25.step
hardware/altium-r4/models/C28.step
hardware/altium-r4/models/C29.step
hardware/altium-r4/models/C32.step
hardware/altium-r4/models/C4.step
hardware/altium-r4/models/D2.step
hardware/altium-r4/models/D3.step
hardware/altium-r4/models/D4.step
hardware/altium-r4/models/D5.step
hardware/altium-r4/models/F1.step
hardware/altium-r4/models/J2.step
hardware/altium-r4/models/L2.step
hardware/altium-r4/models/R10.step
hardware/altium-r4/models/R11.step
hardware/altium-r4/models/R2.step
hardware/altium-r4/models/R20.step
hardware/altium-r4/models/R21.step
hardware/altium-r4/models/R3.step
hardware/altium-r4/models/R5.step
hardware/altium-r4/models/R6.step
hardware/altium-r4/models/R7.step
hardware/altium-r4/models/R8.step
hardware/altium-r4/models/SW1.step
hardware/altium-r4/models/SW2.step
hardware/altium-r4/models/TP1.step
hardware/altium-r4/models/U2.step
hardware/altium-r4/models/U3.step
hardware/altium-r4/models/U4.step
hardware/altium-r5/enclosure/sealed-print/Orion-R5-sealed-enclosure.FCStd
hardware/altium-r5/enclosure/sealed-print/cable_seal_5p5mm.stl
hardware/altium-r5/enclosure/sealed-print/usb_gasket.stl
hardware/altium-r5/enclosure/sealed-v2/Orion-V2-PETG.3mf
hardware/altium-r5/enclosure/sealed-v2/Orion-V2-TPU-Air-245C.3mf
hardware/altium-r5/enclosure/sealed-v2/base.stl
hardware/altium-r5/enclosure/sealed-v2/cable_pressure_cap.stl
hardware/altium-r5/enclosure/sealed-v2/clamp_shims_0p4.stl
hardware/altium-r5/enclosure/sealed-v2/lid_body.stl
hardware/altium-r5/enclosure/sealed-v2/lid_markings.stl
output/Orion-Enclosure-V2-Print-Package/enclosure/Orion-V2-PETG-Coupons.3mf
output/Orion-Enclosure-V2-Print-Package/enclosure/Orion-V2-PETG.3mf
output/Orion-Enclosure-V2-Print-Package/enclosure/Orion-V2-TPU-Air-235C.3mf
output/Orion-Enclosure-V2-Print-Package/enclosure/lid_markings.stl
output/Orion-Enclosure-V2.2-P2S.3mf
output/Orion-Enclosure-V2.3-Onshape/parts/cable_seal_b6p7_L6p8.step
output/Orion-Enclosure-V2.3-Onshape/parts/cable_seal_b6p9_L6p6.step
output/Orion-Enclosure-V2.3-Onshape/parts/cable_seal_b6p9_L7p0.step
output/Orion-Enclosure-V2.3-Onshape/parts/face_stop_coupon_1p4.step
output/Orion-Enclosure-V2.3-Onshape/parts/face_test_gasket.step
output/Orion-Enclosure-V2.3-Onshape/parts/lid_body.step
output/Orion-Enclosure-V2.3-Onshape/parts/lid_gasket.step
output/Orion-Enclosure-V2.3-Onshape/parts/service_switch_cover.step
output/Orion-Enclosure-V2.3-Onshape/parts/service_switch_gasket.step
