Weisni/BatterySentinel-N2K/WORKING_GUIDELINES.md

# Working guidelines

- The 2026-10-10 issue-status update is documentation only. Reconcile GitHub issue descriptions/status and current Markdown with verified Orion Bridge 1.2.0 behavior. Preserve original issue requirements as history; distinguish completed work, superseded concepts, duplicates and remaining work. Do not implement features, change firmware/hardware/build workflows, regenerate released artifacts or move the published tag for this request.

- The user explicitly authorized official publication of Orion Bridge 1.2.0 and separate release-candidate/official channels. Publish `vX.Y.Z-rc.N` as a prerelease, never Latest; publish `vX.Y.Z` as official Latest. Require exact tag/version/source matching, complete CI success, verified uploaded/downloaded draft assets and preserved NVS layout. Do not overwrite published tags/assets or include internal debug images, discarded experiments or private Wi-Fi access labels. Preserve standard Wi-Fi/BLE/CPU behavior; physical commissioning remains separate from release status.

- The user's final thermal assessment on 2026-10-10 supersedes the earlier investigation: Wi-Fi causes the observed heating, and cooling after shutdown takes considerable time. The user reports no improvement from the reduced-power test and explicitly discards that version, accepting the existing behavior. Retain the standard firmware and remove the experimental build/artifacts from the current project. Record this as the user's practical finding and decision, not a calibrated temperature or completed closed-case/boat acceptance. Do not continue radio-free diagnostic work or change BLE/CPU behavior for this resolved concern.

- The first Orion-R5 assembly was reported complete on 2026-10-10. Record this as user-reported assembly, not electrical, thermal or boat-network acceptance. Before boat connection, distinguish isolated-board resistance from powered behavior and terminated-backbone resistance. Preserve galvanic isolation when measuring with USB, supplies and an oscilloscope.
- Service Wi-Fi QR labels must contain the actual device SSID and stored individual AP password. A generic portal URL QR does not join Wi-Fi. Keep private labels outside tracked/public artifacts; do not replace the random device password or use a shared default to simplify setup. End users can set up without a console only after installer provisioning of their device label.

- For the R5 hand-assembly package, use the user's `hardware/altium-r5/Project Outputs/BatterySentinel-N2K-Orion-R5.zip` as the release authority for placement, pad numbering and connectivity. Preserve the archive and native design. Apply the documented purchased L1 and L2/L3 replacements only in a separately labelled manual-assembly BOM; distinguish J1 wire termination and bare TP1 from purchased components. Include top-view orientation, polarity, module mounting, cable mapping, assembly checklists and outstanding physical acceptance in the package README.

- Archive supplied procurement evidence unchanged and link it from the project records. The 2026-09-30 PCB customs payment of EUR 23.85 was already included in recorded costs; adding its invoice must not count it again. Distinguish user-confirmed payment from invoice evidence.

- Write software and project documentation in English unless explicitly requested otherwise.
- Maintain a project README with open tasks, progress, and findings.
- Persist working guidelines in this file and consider them for every command.
- The requested OLED debug firmware is a separate 4 MB ESP32-C3 target for Amazon ASIN B0FP81HMYB. Its built-in display uses SDA5/SCL6; move debug CAN TX to GPIO4 and retain RX7, with separate wiring rather than a carrier-board substitution. Keep connectivity visible above diagnostic pages that advance every 2 seconds without a page delay. Use actual service readiness, recent bus reception and fresh Orion records; queued sends do not prove connectivity or Garmin delivery. Keep OLED failure bounded and independent of bridge operation, and mark unverified controller/geometry and physical acceptance explicitly.
- For the enclosure seal revision, account for the user's failed 95A TPU trial (insufficient cable grip and bending pressure plate) and the confirmed 7 mm cable jacket diameter. Develop separate internal jacket strain relief and an independently compressed seal with a stiff three-screw pressure plate. SainSmart Flex TPU Air 77A–93A is ordered; distinguish proposed calibration settings from verified hardness and sealing. Keep concept drawings separate from released CAD/3MF and preserve existing test plates and profiles.
- The approved V2 enclosure implementation includes assembly and manufacturing instructions, with per-seal Shore A trial targets and SainSmart TPU Air print/calibration settings. Keep measured hardness distinct from engineering targets and temperature trials; use a separate hardness specimen and physical sealing/creep checks. Deliver the new revision separately from the previous user project.
- Enclosure printing targets the user's Bambu P2S. Check the project's purchased-item records before asking for cable or connector details. Close service openings with removable screw-fastened covers and continuous seals; keep mounting and lid fasteners outside the sealed cavity where possible. Deliver print-oriented rigid and TPU parts in a prepared 3MF, with digital checks and outstanding physical sealing/fit tests recorded separately.
- Preserve user-added test plates and slicer settings when revising the enclosure project. Lid lettering and logo use contrasting filament with a flush outer surface, not raised or recessed lettering. Record purchases at the evidenced order total; do not invent per-item prices or assume substitute hardware matches the designed inserts.
- When merging print profiles, identify the exact same-name source variant, preserve the user's successful enclosure core settings, and copy its chosen surface settings into separately named process presets. Keep filament calibration independent, preserve physical shell thickness when changing layer height, and distinguish native slicing checks from physical surface/fit validation.
- Always compare against the profile actually loaded by the user's currently used installed slicer version. Verify the executable/version, active data directory and account, and resolve inheritance from that installation before comparing or merging. A matching profile name in another installation, default folder, account or snapshot is not sufficient evidence. Include applicable project/object overrides when comparing effective print settings; if the active source cannot be verified, clarify it rather than selecting a different copy by assumption.
- Enclosure assembly instructions use the final sealed-print model and include generated illustrations. Use CAD-derived views for part positions and sealing details, keep illustrative product images distinct from dimensional evidence, thread the unsplit cable cartridge before soldering, and complete wet tests with the electronics removed. Document physical acceptance separately from digital validation.
- Preserve the user's completed Altium design and unrelated changes. Verify replacement components against electrical requirements, pinout, and the existing footprint before selecting them.
- The German operating and installation manual targets Orion-R5 / Orion Bridge, not the original shunt battery monitor. Match the portal palette and battery/shield/lightning identity, explain operation for beginners, and distinguish verified firmware behavior from pending physical acceptance checks.
- For R5 documentation, use the current module-selection and power-review records rather than superseded R1/R4 supply notes: SERVICE before USB, USB disconnected before RUN; do not invent switch travel direction or enclosure protection ratings.
- Orion portal OTA updates use a firmware file already stored on the phone, require administrator authentication and CSRF protection, and validate device compatibility and complete image integrity before activating the inactive application slot. Keep firmware and documentation in English, with German portal translations. Record hardware-only acceptance checks explicitly.
- The Orion service Wi-Fi indicator uses the SuperMini's active-low blue LED on GPIO8, excluding the R4 WROOM board. Keep local service discovery and certificate names consistent, preserve direct HTTPS IP access as a fallback, and stop discovery when the service Wi-Fi closes.
- Administrator password changes and physical BOOT-confirmed recovery must preserve all saved data and assignments. Recovery uses the randomly generated default published in the user manual, never a factory reset. Keep the default and instructions synchronized with firmware. Drive the blue Wi-Fi LED from actual access-point/service readiness, initialize it off before lengthy startup work, and never replace status feedback with a fixed delay.
- For the one-slot Orion HTTPS server, match advertised connection closure with actual transport cleanup after the complete response. Keep login/reload routes usable, prevent duplicate credential submissions, and distinguish browser-preview checks from physical radio/TLS acceptance.
- User-facing documentation, manuals, portal text and firmware download instructions describe only the current Orion Bridge built around the ESP32-C3 SuperMini. Do not mention R4 or earlier hardware revisions, or compare against the never-built shunt/measurement variant. Those designs, source targets, historical artifacts and engineering comparisons remain project-internal; they are not existing or previously released products. Keep current operating limits, setup instructions and physical-acceptance status accurate. Preserve internal engineering history without exposing it as alternate products in user guides.
- Implement the explicitly authorized Orion observations and configurable notifications, including a configurable 12 V warning. Distinguish Orion channel current from complete battery current; do not invent SOC, internal resistance, remaining runtime or service life from incomplete measurements. Treat charging and post-charge relaxation separately from battery assessment, while keeping configured voltage warnings active. Use monotonic time for calculations and validated network UTC only for calendar timestamps, backdating log entries from the current boot when time becomes available. Preserve settings and assignments during updates. Verify Garmin delivery independently of local alert generation; document unsupported receiver features and physical acceptance separately.

- Deliver the V2 enclosure also as one multi-plate 3MF with embedded P2S profiles, material assignments and preserved print orientations. Keep optional fit/calibration plates distinct from the enclosure set; validate reopening and slicing with embedded settings alone. TPU Air flow and Shore hardness remain physically uncalibrated.

- Centre the complete lid logo/text group on the current lid face after enclosure size changes. Translate the inlay and matching cutout together; verify equal artwork margins and preserve flush two-colour registration.
- For the enclosure styling revision, centre both middle lid/base screw axes and opposing mounting tabs on the current body midpoint. Develop chamfers, rounded transitions and restrained external rib texture while preserving sealing, separate strain relief and flush centred branding. Treat the requested styling preview as a proposal until CAD and printability are verified.

- The user approved the styling preview for implementation. Integrate the boss envelope into the shell, centre fasteners/tabs, add modest printable bevels and external rib texture, and update the CAD, six-plate 3MF and manuals. Verify sealing lands, washer seats and extended service access. Preserve the preceding package as a separate snapshot.
- After the V2.1 visual mismatch, match the approved preview with actual geometry: broad 2.4 mm lid bevel, distinct rounded screw shoulders, recessed side fields with visible rib bands, and a smooth cable-cap shoulder. Compare real CAD renders to the reference before delivery; lighting alone is not a design correction.
- Reduce the unnecessarily continuous 11.4 mm enclosure walls. Use nominal 3 mm free wall fields, with shallow external texture and visibly projecting symmetric screw bosses. Retain extra material only locally for the continuous lid sealing rim, blind inserts, cable sealing shoulder and clamp load paths. Verify actual CAD wall sections, seal support and the regenerated six-plate project; preserve the V2.2 package.
- The corrected cable-seal request specifies a standalone STL retaining the original profiled shape: two internal sealing beads, rounded outer edges and an annular rounded end bead. The 6.8 mm bore is the minimum at the internal bead crests; maximum outer diameter is 11.5 mm and overall free length including the end bead is 9 mm. The plain tube was an incorrect simplification and is superseded. Do not silently resize the sample to the existing enclosure pocket.
- The separately requested flatter strain_relief_upper should increase cable compression while retaining the existing lower clamp. Change the upper contact profile relative to its mounting seats, preserve screw alignment and roof strength, and export a separate STL. A thinner outer roof alone does not increase clamping pressure; report reduced clearance separately from unmeasured contact force.
- The latest requested strain_relief_upper total height is exactly 5.0 mm, superseding the 5.6 mm trial. Retain the lower clamp and verify the resulting local rib gap and screw engagement without claiming a measured clamp force.
- For the Onshape export, use the actual V2.3 CAD boundary representation to create STEP solids with native planes and curved surfaces; never convert the STL/3MF mesh into faceted solids. Supply separate named parts and one combined editing layout, retain the original lid/inlay geometry, and distinguish imported-solid editing from a native parametric feature history. Include the latest 5 mm clamp and 6.8/11.5/9 mm profiled sleeve as separate variants without silently replacing the V2.3 assembly. Reimport exported STEP files locally and report any unverified Onshape-specific behavior.
- The latest Onshape instruction supersedes the loose production-part layout: deliver one STEP with the V2.3 enclosure fully assembled and all element variants clearly named. Preserve a coherent primary assembly and put mutually exclusive free variants in separate named groups beside it, rather than overlapping them in installed positions. STEP is not a native configurable Onshape document; explain the named assembly/variant groups and retained free versus seated seal states.
