Weisni/BatterySentinel-N2K/docs/german-manual-production.md

> **Project-internal engineering record.** Historical designs, unbuilt concepts and test targets in this file are development material, not existing or released product variants. Use the current operating and assembly guides for the Orion Bridge. [Internal index](internal/README.md).

# German Orion-R5 manual: production and verification

Output: `output/pdf/BatterySentinel-N2K-Orion-R5-Betriebs-und-Installationsanleitung-DE.pdf`.

Edition 1.5, 2026-10-10, for firmware 1.2.0; 30 A4 pages, German, aimed at nontechnical owners of the Orion Bridge with the ESP32-C3 SuperMini and R5 assembly. The PDF uses the portal palette with light body pages for printing, readable portal detail captures, vector connection diagrams and a document-specific shield/lightning mark based on the project's shield silhouette. Existing brand assets, the page 22 handover form and unrelated chapters were preserved. The enclosure PDF is unchanged.

Edition 1.5 adds QR setup on page 28 and bench/fault guidance on pages 29-30. Pages 8-9 point owners to the supplied device access page for setup without a console. The generic manual contains only a working portal URL QR; actual Wi-Fi credentials are inserted into a separate private device manual by `tools/create_service_wifi_manual.py`. The appended page preserves interactive handover fields and existing page references. See `docs/service-wifi-qr.md` and `docs/orion-r5-commissioning.md`. User-reported assembly and USB/Wi-Fi setup do not close bus-side acceptance.

Edition 1.4 adds three pages covering channel observations, notification settings and local acknowledgment, network UTC and experimental Garmin delivery. Existing capability, Monitor and update instructions were reconciled with firmware 1.2.0. The appendix explains gaps and covered integration, resets on boot, actual defaults and delays, same-boot event backdating, and receiver acceptance still needed. Plotter clearing is never confirmed by local send acceptance; shutdown withdrawal attempts are bounded. The portal capacity warning is not a general delivery-receipt report.

Edition 1.3 is a documentation-only revision that keeps the published instructions focused on the actual product. Scope, update-file selection and source explanations describe the current assembly directly. Internal hardware history and unrealized product concepts are not part of the user manual. Actual Orion voltage/current telemetry, derived power, and truthful capability limits remain documented.

Edition 1.2 updates firmware/version references after the login follow-up fix. The access troubleshooting table tells readers to wait for credential checking without repeated submission, then reload once or open the portal root if the next page is temporarily unavailable. It does not expose HTTP implementation details. The user's observation that firmware 1.1.3 exposes Wi-Fi earlier is recorded by the release documentation; physical acceptance of the new 1.1.4 login behavior remains separate.

The revision documents changing the signed-in administrator's password, the login-page recovery form with explicit confirmation and BOOT held from submission until the response, and the fixed randomly generated recovery password. Recovery changes only the administrator password and ends existing sessions; the username, Wi-Fi credentials, TLS identity, Orion key, aliases, NMEA assignments and saved data remain intact. Page 10 contains the full procedure and public recovery default, followed by the instruction to choose a personal password immediately. Pages 18-19 no longer recommend erasing NVS for a forgotten password. Pages 7 and 9 explain event-based blue LED readiness and the separate phone scan refresh. Page 12 also corrects stale key-handling instructions: an unchanged Orion MAC can retain its stored key when the field is left empty.

## Rebuild

- `tools/build_german_manual.py` contains the complete German copy and deterministic ReportLab layout. It uses installed Segoe UI fonts without distributing font files.
- `tools/capture_manual_portal.cjs` captures the real portal with synthetic data and headless Edge. It starts and stops its own preview server on an available local port. Set `MANUAL_PREVIEW_URL` to use an existing preview. Requires Playwright; override its package path with `MANUAL_PLAYWRIGHT` if needed.
- Run the builder with the Codex bundled Python runtime containing ReportLab, Pillow and pypdf.
- Render with `pdftoppm -scale-to 1100 -png output/pdf/BatterySentinel-N2K-Orion-R5-Betriebs-und-Installationsanleitung-DE.pdf tmp/pdfs/manual`.
- Run `tools/check_german_manual.py`, then inspect the five contact sheets and detailed page PNGs under `tmp/pdfs/`.

All screenshots are synthetic and labeled accordingly. No private credentials, device keys or personal boat data were used. The published recovery default is deliberately public. Captures in `docs/manual-assets/` include updated overview/Monitor details and the new Insights, notification settings and active-incident views. The Insights capture uses a continuous, bounded history; the main preview's intentional gap fixture is a rendering test, not an example of retained firmware history across gaps. The builder writes SHA-256 references for locally inspected sources, production scripts and used screenshots to `docs/manual-assets/source-manifest.json`; source files can contain uncommitted changes. Notification, observation, clock and NMEA alert sources are included alongside the recovery and version headers.

## Verification completed

- Current snapshot, 2026-10-10: thermal records reflect the user-accepted Wi-Fi heating and slow cooling; the reduced-power trial is discarded. All four standard/internal firmware profiles build, 165 native cases pass, and Python plus production C++ validators accept the current images. The refreshed standard SuperMini download is 1,902,064 bytes with 64,016 bytes of slot headroom; complete-file SHA-256 `8f14e3480ce6b0f8768657601d1f04fda5600d0f1214d4cf547e867e3599e979`. Earlier local build figures below remain historical.

- Edition 1.5: 30 pages rendered with Poppler and visually reviewed in five contact sheets; QR/setup page 28, hardware pages 29-30 and the synthetic private access page were also reviewed at full render size. No clipping or overlap was found. Extraction reports 7,504 words, 30 outline entries, 15 preserved interactive fields on page 22, zero replacement glyphs, valid text bounds and 36 matching source hashes.
- `tools/check_service_wifi_manual.py --decoder-dir tmp/qr-qa` generated a 31-page private manual with synthetic credentials and verified all 15 original form fields and 31 outline entries. Independent zxing-cpp decoding recovered both device-page QR payloads and the generic portal QR, including reserved-character escaping. Existing-file refusal, invalid credentials and private Git ignore rules passed. Actual phone association and portal access remain physical handover tests.
- The manual checker now selects the normal firmware-version branch in `BridgeFirmwareIdentity.h`; the first definition belongs to the separate OLED debug target and is not the version described by this manual. Firmware is unchanged.

- Edition 1.1: 24 pages rendered with Poppler and visually reviewed in four contact sheets; revised pages 7, 9, 10, 12, 18, 19 and 24 additionally reviewed at full render size. Edition 1.2: all pages rendered again; the changed cover, orientation, access troubleshooting and document-status pages received detailed visual review.
- Edition 1.3: all 24 pages rendered; the changed cover, scope, update instructions, technical summary and source page visually reviewed. Extracted-text checks reject out-of-scope hardware history and unrealized product references.
- Edition 1.4: all 27 pages rendered with Poppler and reviewed in five contact sheets. Changed pages 4, 13, 15, 18, 24 and appendix pages 25-27 were also inspected at full render size. Final page images were regenerated after the final PDF build; no clipping, overlap or unreadable blocks were found.
- Consistent page headers/footers, readable tables, no overlapping blocks or clipped text. Builder fails on content overflow.
- Edition 1.4 extraction reports 27 nonempty pages and 6,672 words, with embedded German text and no replacement glyphs. All 32 source hashes match the final manifest.
- The QA script extracts the recovery default and firmware version directly from the C++ headers and requires them in the PDF. It also checks for the byte-based password limit, preservation/session wording, and absence of the obsolete destructive recovery directions.
- pypdf validates 27 navigation outline entries and 15 interactive fields: six blank text fields and nine unchecked checkboxes, all on page 22. Every widget has an appearance stream and agrees with the canonical AcroForm field value. The checker also validates current source hashes and the appendix's essential settings and limitations.
- pdfplumber confirms all text character bounds stay within page bounds.
- External Garmin and Victron instructions were checked against manufacturer documentation. The PDF includes clickable sources on pages 24 and 27; project implementation remains authoritative for device behavior.
- Firmware 1.2.0 validation is recorded in the release package: 147 native cases, 175 extracted HTTP-handler checks with two regression mutations, the portal/preview/OTA and Edge browser checks, final builds and independent Python/production C++ image checks passed. The packaged SuperMini image is 1,901,648 bytes with 64,432 bytes of application-slot headroom. Document production does not install it on hardware.

## Findings and physical acceptance still open

- Follow the R5 power-review/module-selection data. SERVICE must physically disconnect the external module-positive supply before USB; disconnect USB before selecting RUN. Do not invent a left/right switch direction or an enclosure IP rating.
- Phone-file OTA is included on page 18. Older installed firmware may lack that section or the password controls added in 1.1.3. Real device upload/abort/restart acceptance is not asserted by this manual.
- Password change/recovery and blue LED timing require physical acceptance on the target hardware. The indicator follows AP-start state, a usable local IP and the HTTPS task, with no artificial readiness delay. A phone's Wi-Fi scan refresh and ROM/bootloader behavior before application setup are outside this indication.
- The R5 hardware plan reserves 12 LEN; the `orion_dongle` firmware currently uses `0xff` in `include/config.h`. The manual describes 12 as a planning budget, not a verified bus declaration. Reconcile this before a hardware release.
- No finished-board electrical/thermal, isolation, enclosure fit, RF or Garmin acceptance was performed during document creation. The handover form records these remaining checks without implying certification.
- Actual voltage warning timing, missing-data recovery, network UTC acquisition/conflicts and Garmin activation, repeats, local acknowledgment, clearing, interruption and restart require physical acceptance. The built-in Garmin Unit Voltage alarm does not establish separate warnings for arbitrary received battery instances.
- Recheck content, screenshots, source hashes and the completed hardware when releasing a new manual edition. Firmware and CAD changes remain outside this documentation task.
