Weisni/BatterySentinel-N2K/docs/enclosure-manual-assets/image-generation.md

# Enclosure manual cover image

Mode: built-in image generation tool, reference-based product illustration.

Output: `cover-generated.png`.

Reference: `hardware/altium-r5/enclosure/sealed-print/preview-assembled.png`.

The illustration is used on the cover. Instructional part placement and sealing dimensions use CAD-derived renders and vector diagrams. The generated cover is not dimensional evidence.

## Prompt

Use case: product-mockup. Asset type: cover illustration for an accurate English assembly manual for the BatterySentinel-N2K Orion-R5 enclosure. Use the input CAD render as the exact design reference, not as a loose concept. Create a beautiful clean studio product illustration of this same deep navy FDM-printed enclosure on a pale cool gray background. Preserve the exact proportions, six cylindrical lid screw lobes, two separate rectangular service covers with two screw positions each, and the external mounting ears as depicted. Same three-quarter camera angle. Include small flush-looking stainless button head M3 screws only in the existing six lid holes and four visible service cover holes; never add holes or openings. Keep the closed seams subtle; do not expose orange gaskets. Finely visible PETG layer texture, smooth corners, soft directional studio illumination that clearly reveals all faces and the actual engraved logo. Improve the brightness and form legibility of the reference without redesigning the object. Center the enclosure with generous clean margins, landscape 3:2 composition. Remove all reference caption text. No added labels, dimensions, people, tools, scenery, splashing water, connector or cable. The image is illustrative and not a new CAD design.
