Weisni/BatterySentinel-N2K/docs/enclosure-manual-assets/cad/base-inserts.png

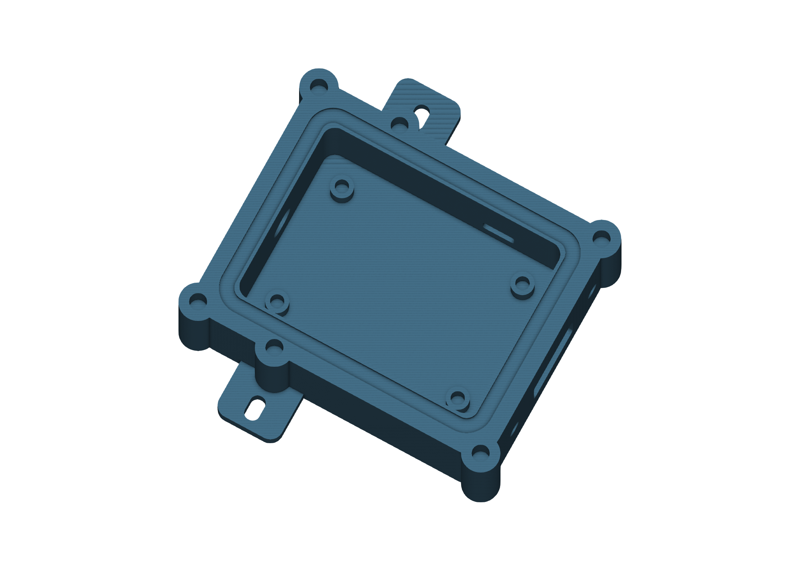
docs/enclosure-manual-assets/cad/base-inserts.png
