Weisni/BatterySentinel-N2K/docs/enclosure-manual-assets/cad/cable-exploded.png

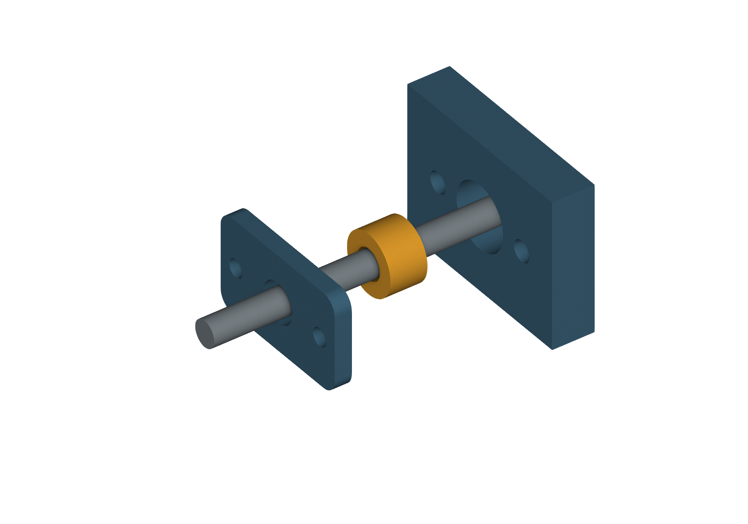
docs/enclosure-manual-assets/cad/cable-exploded.png
