Weisni/BatterySentinel-N2K/docs/enclosure-manual-assets/cad/flexible-kit.png

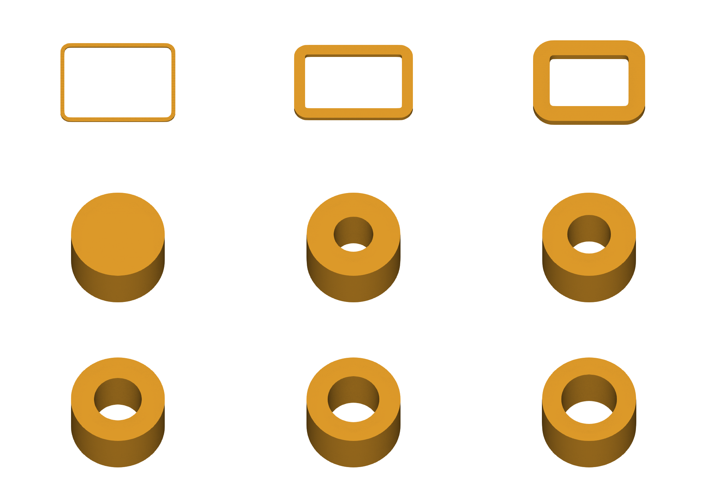
docs/enclosure-manual-assets/cad/flexible-kit.png
