Weisni/BatterySentinel-N2K/docs/enclosure-manual-assets/cad/lid-exploded.png

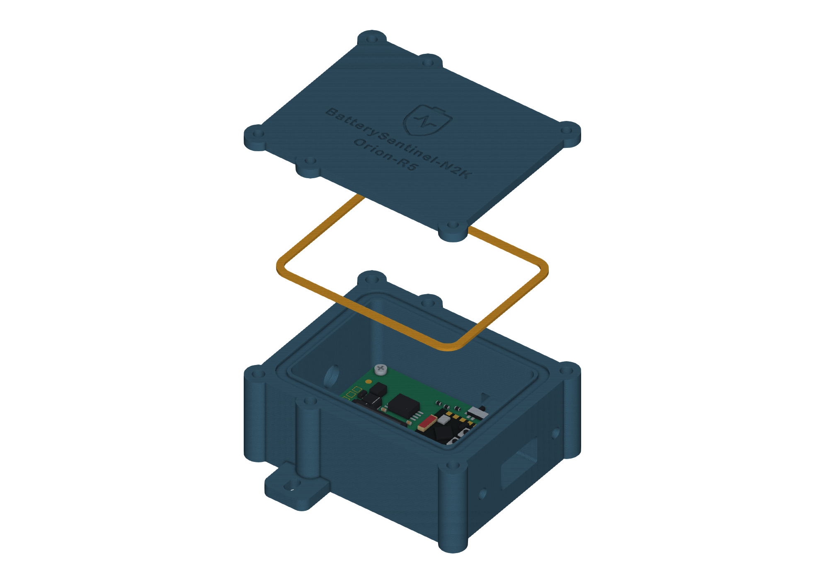
docs/enclosure-manual-assets/cad/lid-exploded.png
