Weisni/BatterySentinel-N2K/docs/enclosure-manual-assets/cad/rigid-kit.png

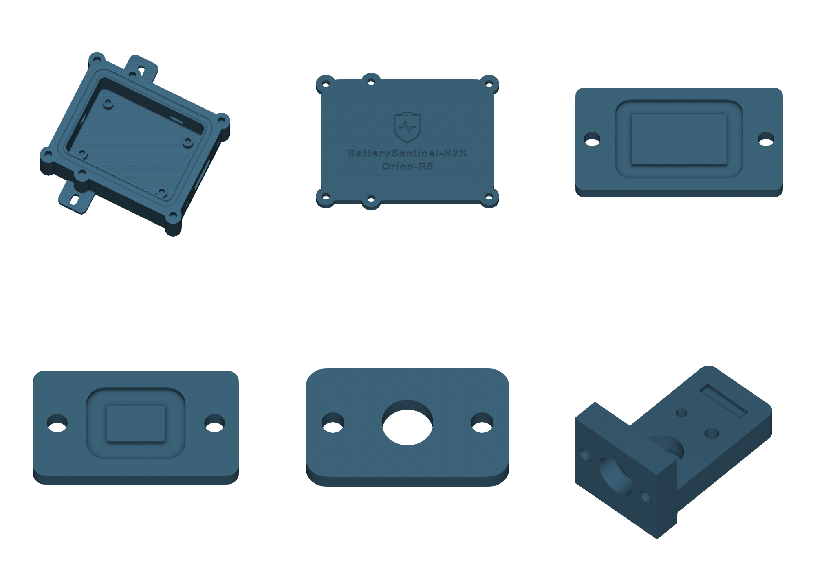
docs/enclosure-manual-assets/cad/rigid-kit.png
