Weisni/BatterySentinel-N2K/docs/manual-assets/portal-channels.png

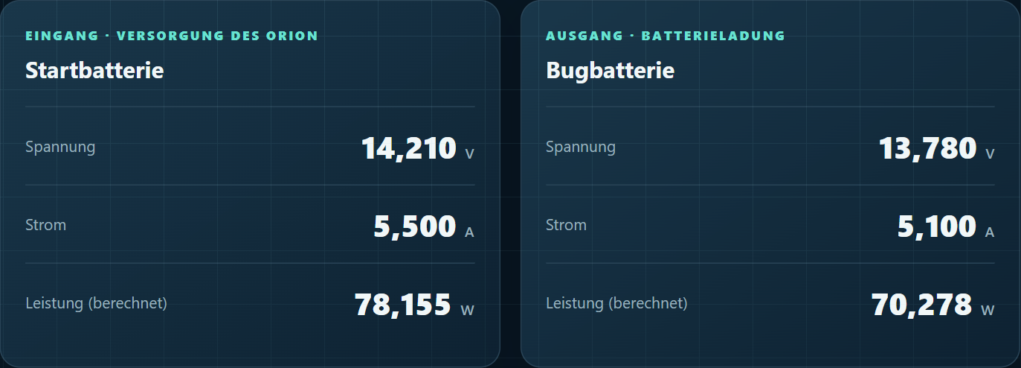
docs/manual-assets/portal-channels.png
