Weisni/BatterySentinel-N2K/docs/manual-assets/portal-monitor.png

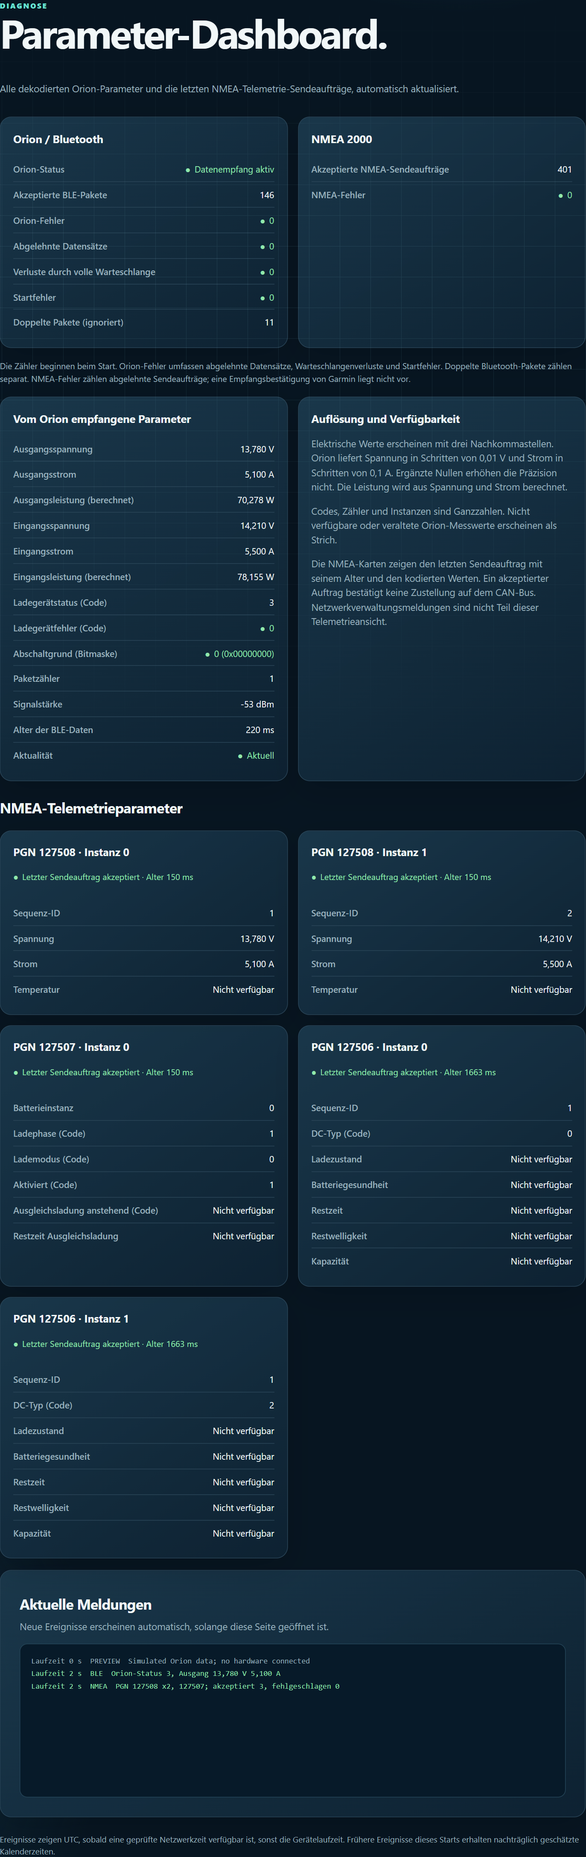
docs/manual-assets/portal-monitor.png
