Weisni/BatterySentinel-N2K/docs/manual-assets/portal-notification-settings.png

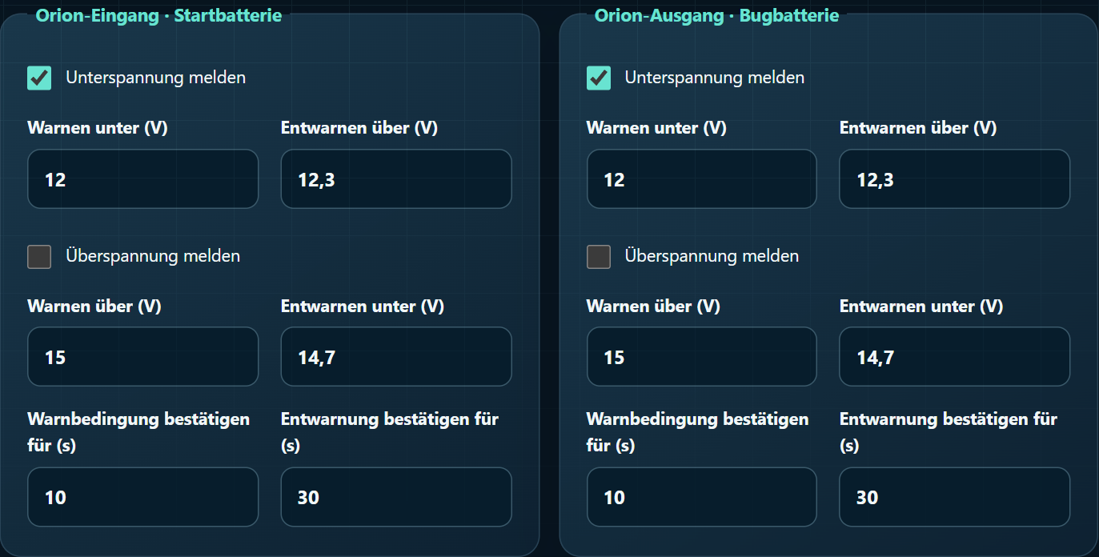
docs/manual-assets/portal-notification-settings.png
