Weisni/BatterySentinel-N2K/docs/manual-assets/portal-setup.png

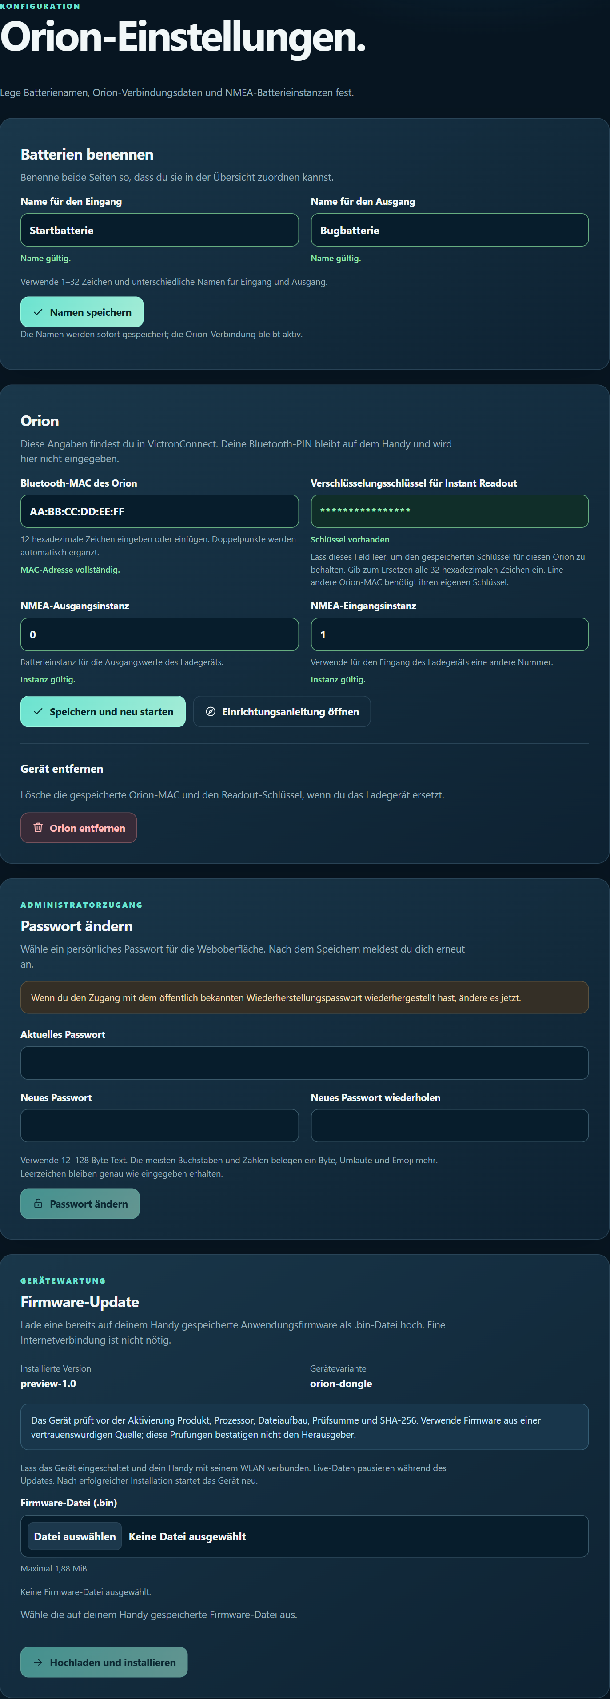
docs/manual-assets/portal-setup.png
