Weisni/BatterySentinel-N2K/hardware/altium-r5/enclosure/sealed-print/flush-colour/lid-flush-preview.png

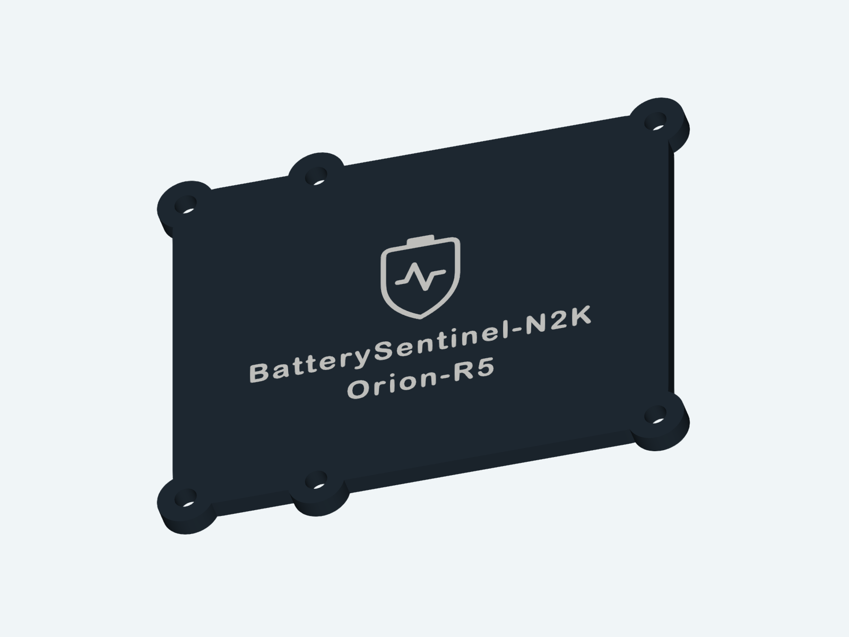
hardware/altium-r5/enclosure/sealed-print/flush-colour/lid-flush-preview.png
