Weisni/BatterySentinel-N2K/hardware/altium-r5/enclosure/sealed-print/preview-assembled.png

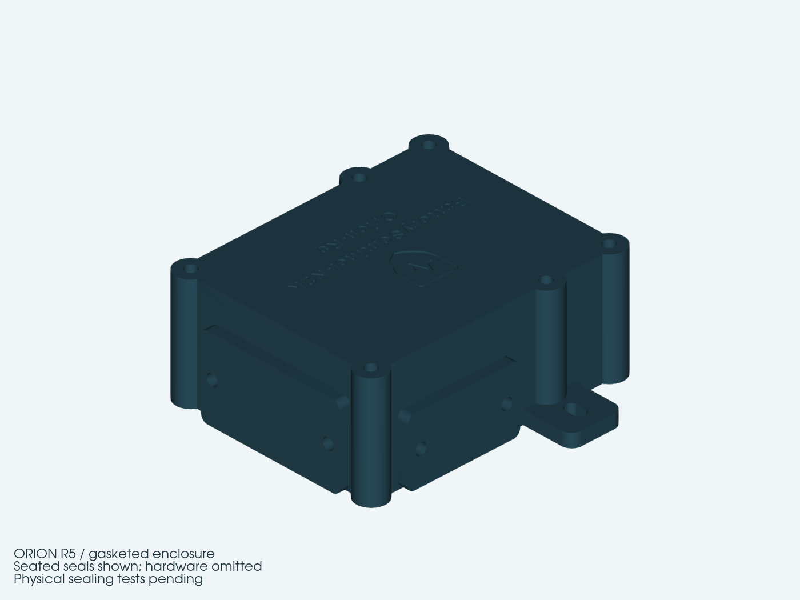
hardware/altium-r5/enclosure/sealed-print/preview-assembled.png
