Weisni/BatterySentinel-N2K/hardware/altium-r5/enclosure/sealed-print/preview-exploded.png

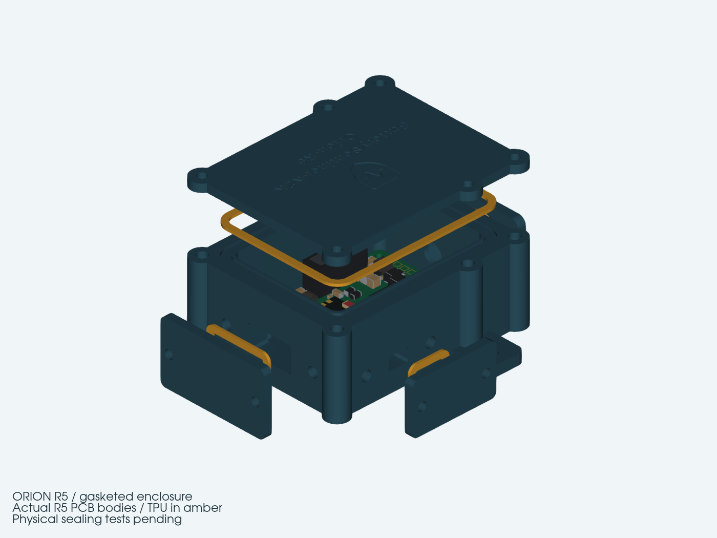
hardware/altium-r5/enclosure/sealed-print/preview-exploded.png
