Weisni/BatterySentinel-N2K/hardware/altium-r5/enclosure/sealed-print/print-plate-1-PETG.png

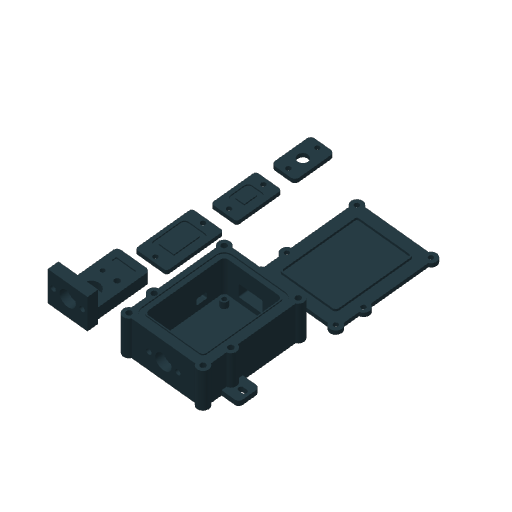
hardware/altium-r5/enclosure/sealed-print/print-plate-1-PETG.png
