Weisni/BatterySentinel-N2K/hardware/altium-r5/enclosure/sealed-print/print-plate-2-TPU.png

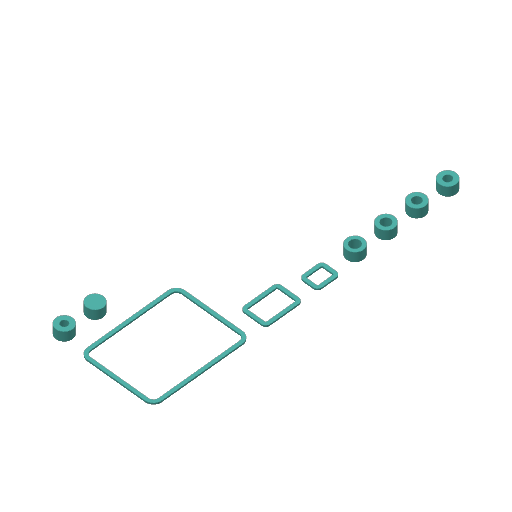
hardware/altium-r5/enclosure/sealed-print/print-plate-2-TPU.png
