Weisni/BatterySentinel-N2K/hardware/altium-r5/enclosure/sealed-v2/assembly-overview.png

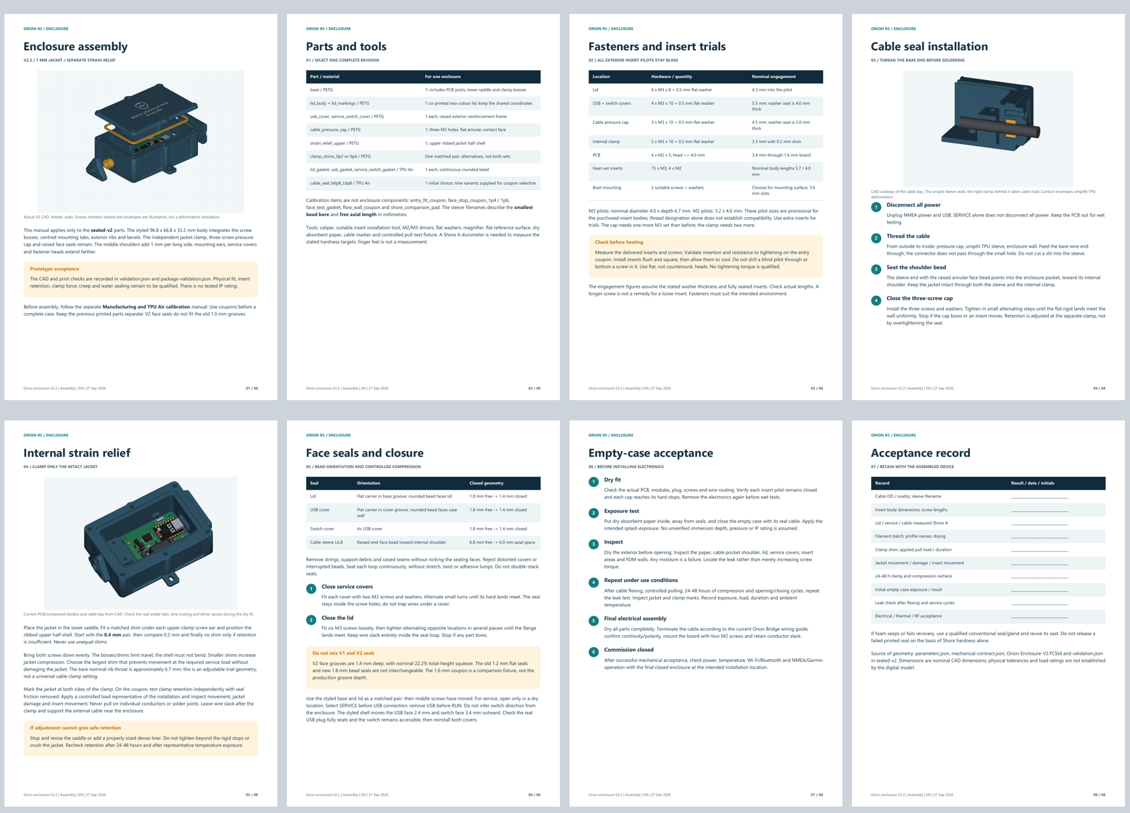
hardware/altium-r5/enclosure/sealed-v2/assembly-overview.png
