Weisni/BatterySentinel-N2K/hardware/altium-r5/enclosure/sealed-v2/manufacturing-overview.png

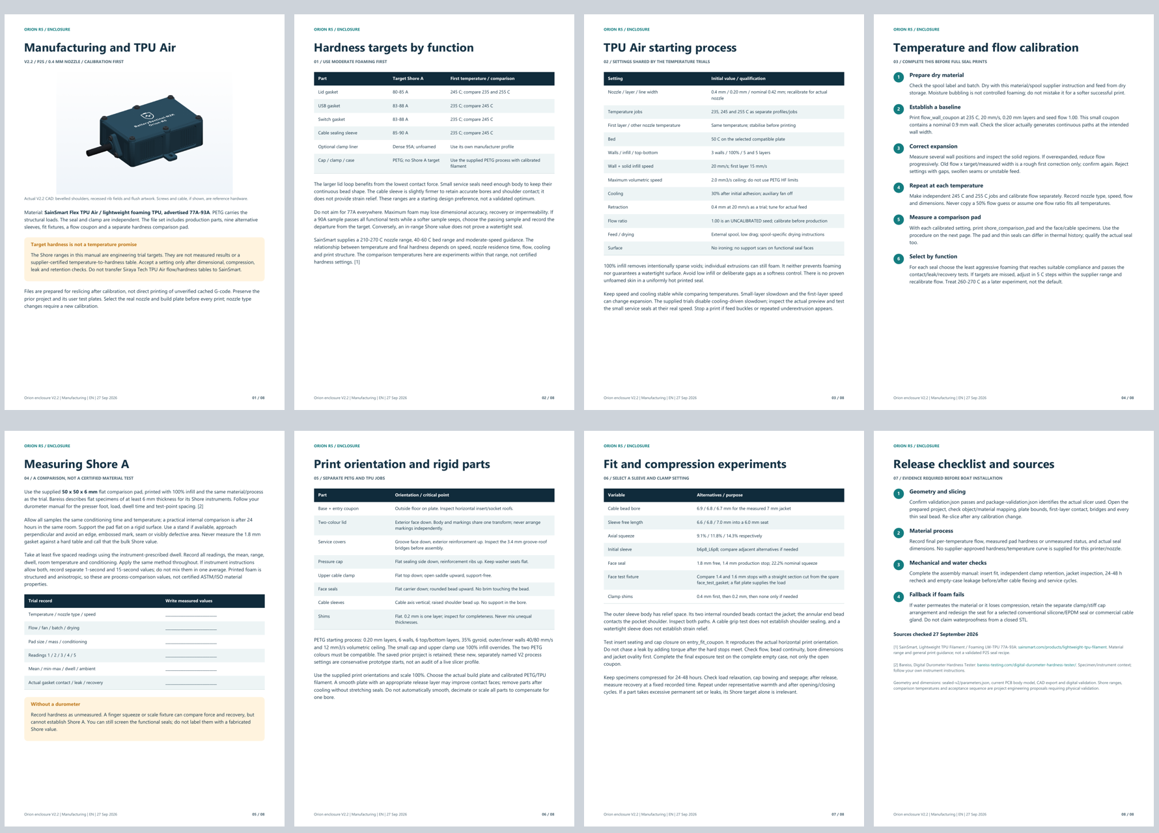
hardware/altium-r5/enclosure/sealed-v2/manufacturing-overview.png
