Weisni/BatterySentinel-N2K/hardware/altium-r5/enclosure/sealed-v2/manufacturing-page-5.png

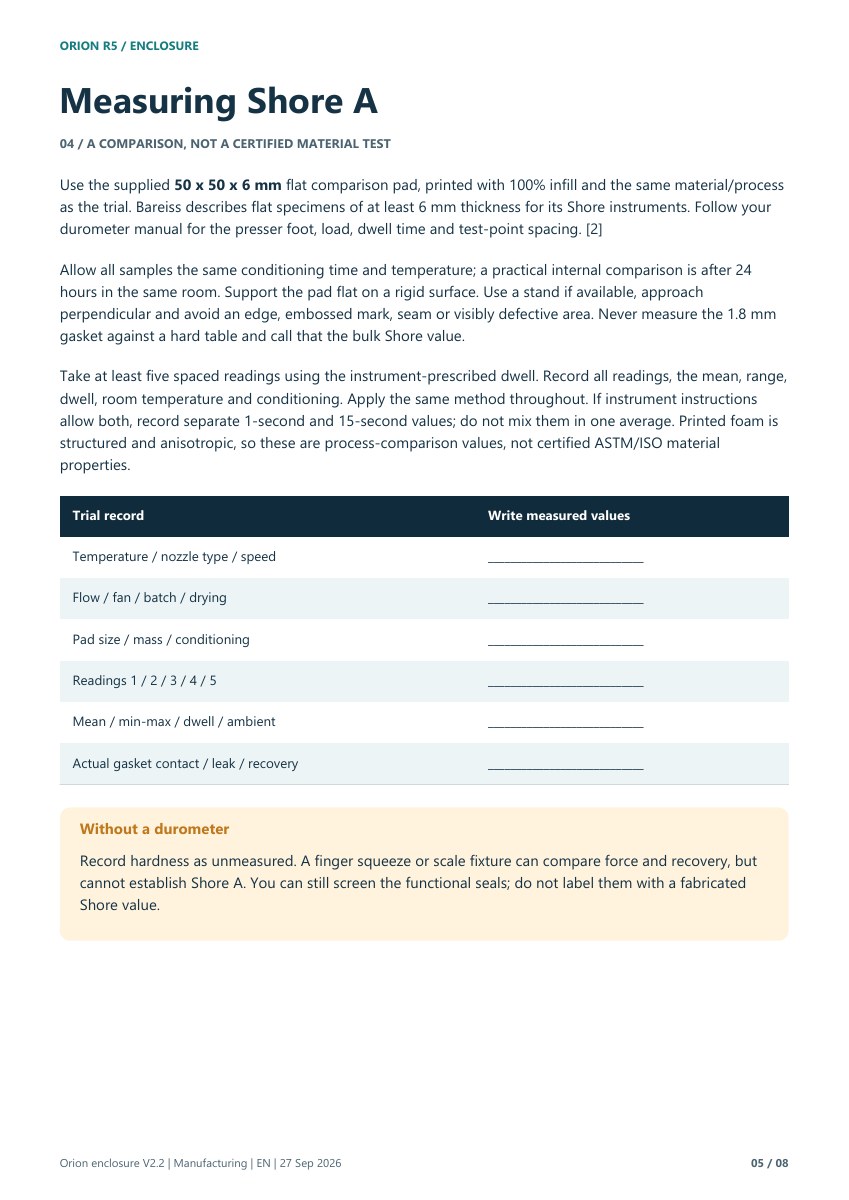
hardware/altium-r5/enclosure/sealed-v2/manufacturing-page-5.png
