Weisni/BatterySentinel-N2K/hardware/altium-r5/enclosure/sealed-v2/manufacturing-page-6.png

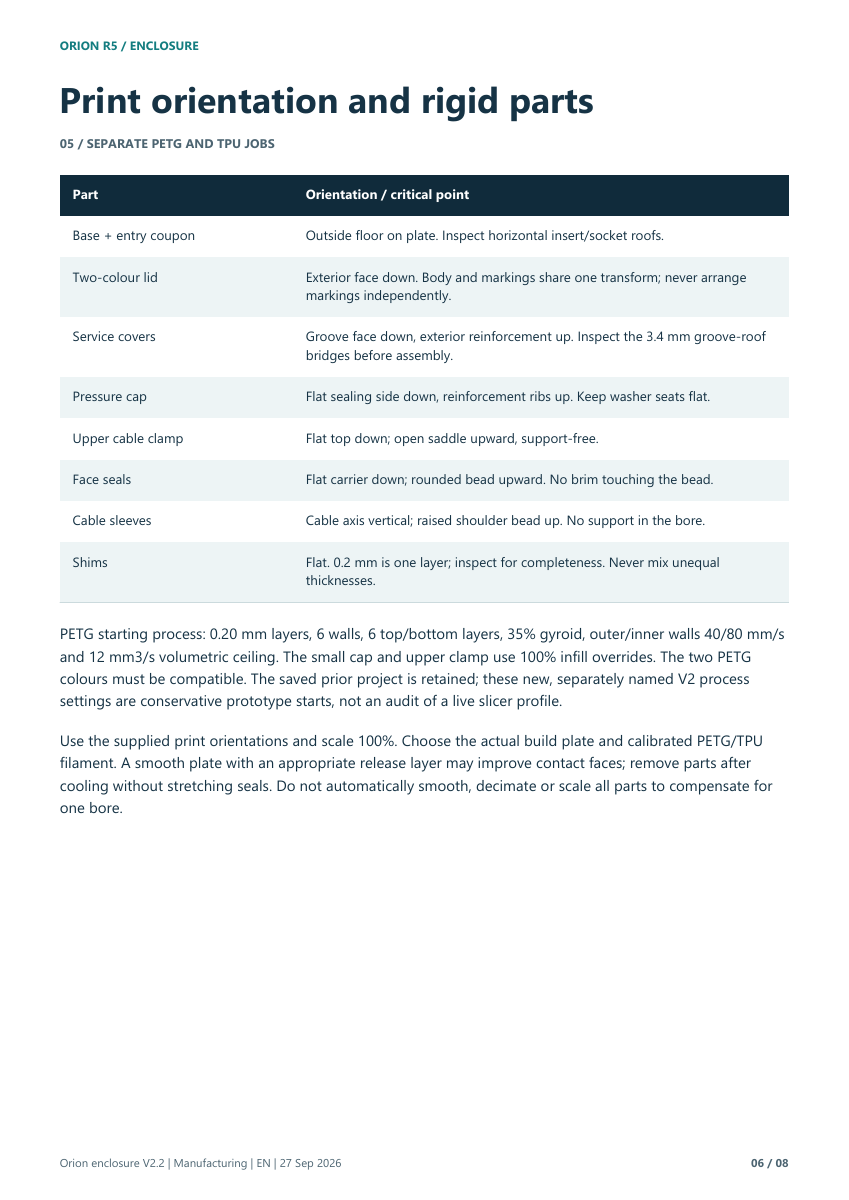
hardware/altium-r5/enclosure/sealed-v2/manufacturing-page-6.png
