Weisni/BatterySentinel-N2K/output/releases/Orion-Bridge-R4-PCBA/assembly/Bestueckung-R4.png

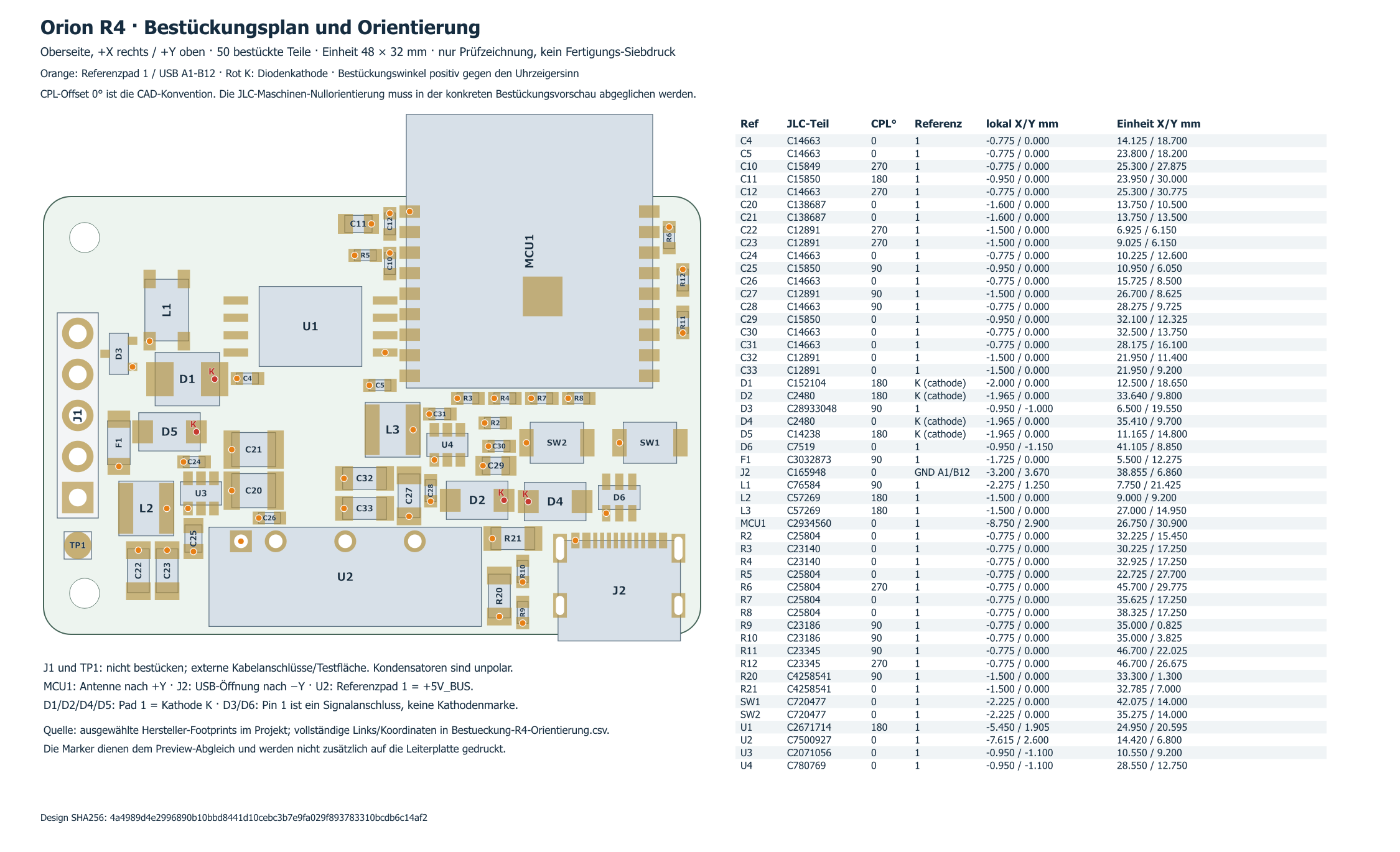
output/releases/Orion-Bridge-R4-PCBA/assembly/Bestueckung-R4.png
