Weisni/BatterySentinel-N2K/docs/releases/1.2.0-verification.md

# Orion Bridge 1.2.0 publication verification

Verified on 2026-10-10 after publication. The official release is public, is not
a prerelease or draft, and is GitHub's Latest release.

- [Official release](https://github.com/Weisni/BatterySentinel-N2K/releases/tag/v1.2.0), release ID `409020516`.
- Published at `2026-10-10T15:07:22Z`.
- Tag `v1.2.0` resolves to `b01e69173c046cca40553fc73405ac5defc018ee`.
- [Main CI](https://github.com/Weisni/BatterySentinel-N2K/actions/runs/38061665892) passed at that exact commit before tagging.
- [Release CI and publication](https://github.com/Weisni/BatterySentinel-N2K/actions/runs/38062062476) passed at the same commit. The publisher downloaded and verified every draft asset before publishing.
- A separate post-publication download confirmed all six asset names, sizes and
  SHA-256 digests against GitHub metadata and the packaged checksum list.

The application is `orion-dongle` version `1.2.0`, 1,901,952 bytes, within the
1,966,080-byte OTA slot. Both the independent Python image inspector and the
production C++ OTA validator accepted the downloaded image. The USB ZIP contains
the same application and verified partition/offset metadata; its segments do not
overlap the saved NVS settings partition. The downloaded German PDF is byte-for-byte
identical to the validated project manual.

## Published asset digests

These are SHA-256 hashes of complete download files, including the ESP image's
embedded digest when applicable.

| Asset | Bytes | SHA-256 |
| --- | ---: | --- |
| `orion-dongle-1.2.0.bin` | 1901952 | `0650ed92a309dff93e67cd7961057979829afc200fdd51228fc38fbcc8269143` |
| `orion-dongle-1.2.0-usb.zip` | 1059990 | `b17cd877067038b086cae5e1a940f0d027d2ae83f84fa0bb17c9f507428e61b1` |
| `BatterySentinel-N2K-Orion-R5-Betriebs-und-Installationsanleitung-DE.pdf` | 925842 | `0b641fc8e6de0172f96bf6ffebd1a742a999b380012350621e8b6b8c8b397da7` |
| `RELEASE-NOTES.md` | 2570 | `ce7047ba2aa77bb6f18eb9c92dc5f2d026188b1fb096ba15f5fc5bce283a5bdf` |
| `release-manifest.json` | 967 | `d774a4e36d6bf5e83fe6075a7345fcbd3b079f0bcd502005f1fa682d394ed7ee` |
| `SHA256SUMS.txt` | 491 | `8a57762b21e6ea67f99ea88532595276d2d7c385229cb5aee18cce077052202b` |

Standard Wi-Fi settings remain in the release. The discarded reduced-power
experiment and internal debug images are excluded. Publication did not flash a
device; hardware and boat commissioning retain their separately tracked status.

This verification record was committed after publication. The release tag and
published assets remain fixed at the source commit recorded above.
