Weisni/BatterySentinel-N2K/hardware/altium-r3/models/step-validation.txt

{"components": 28, "valid_solids": 153, "assembly": "Orion-Bridge-assembly.step"}
