Weisni/BatterySentinel-N2K/output/firmware/debug-oled/1.2.0-debug.1/oled-preview.gif

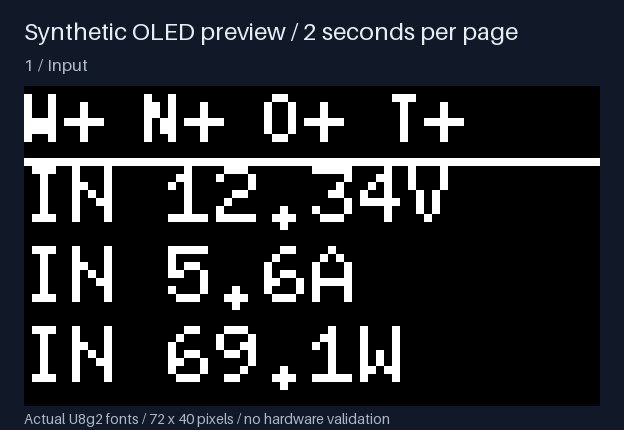
output/firmware/debug-oled/1.2.0-debug.1/oled-preview.gif
