Weisni/BatterySentinel-N2K/hardware/altium-r2/Schaltplan-R2-Vorschau.pdf

# ORION BRIDGE / NMEA 2000 - BLE

01 Anschluss | 02 Schutz und Busversorgung

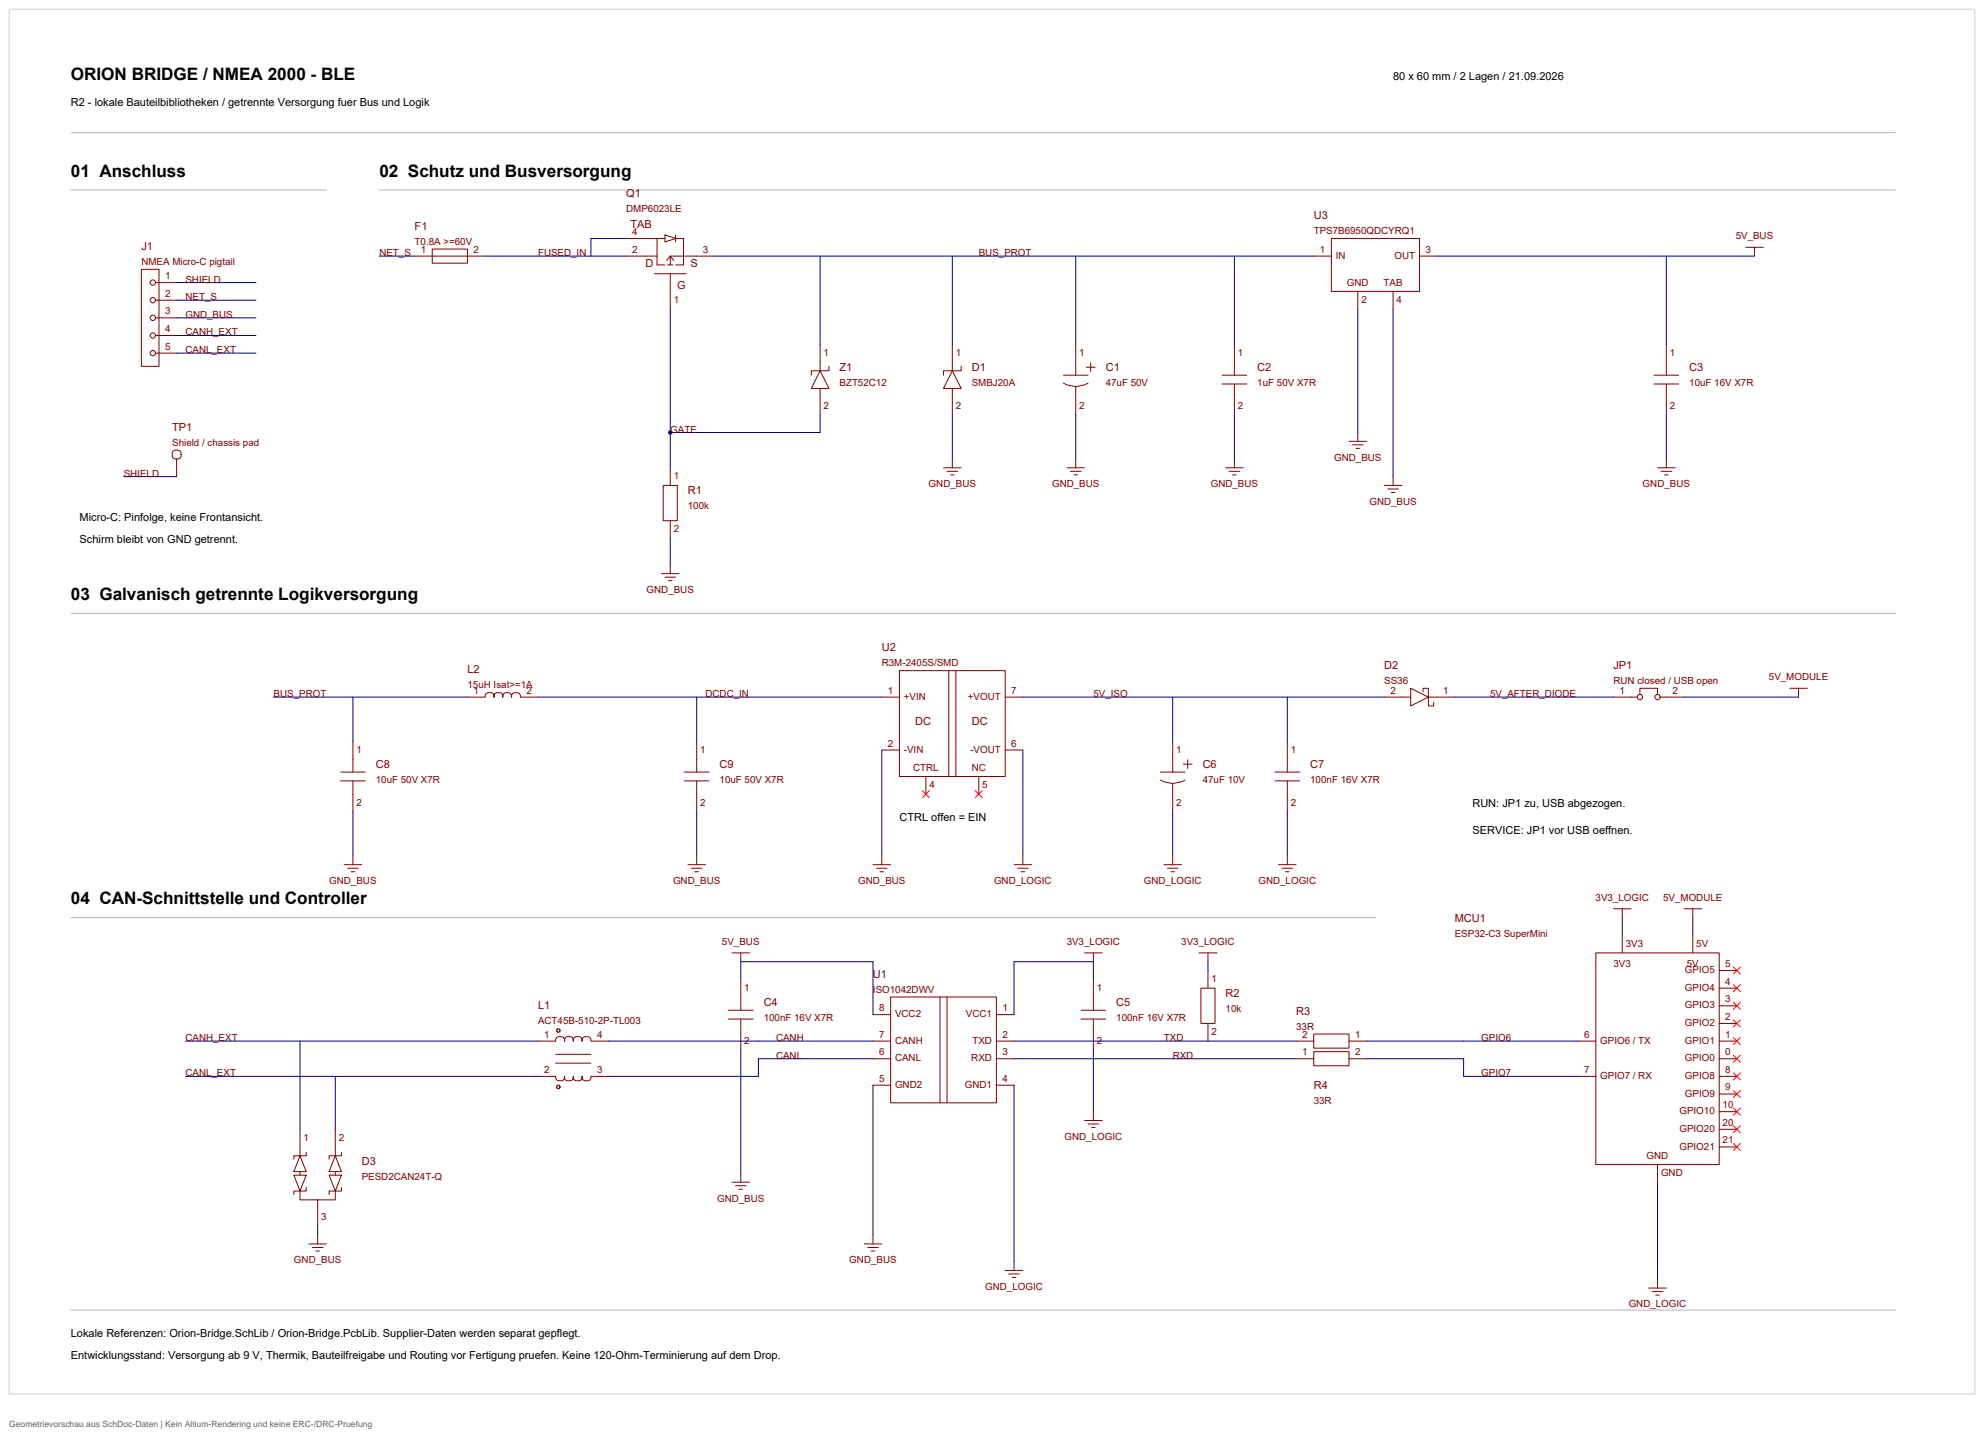
[picture p233: page 1]

R2 - lokale Bauteilbibliotheken / getrennte Versorgung fuer Bus und Logik

Micro-C: Pinfolge, keine Frontansicht.

Schirm bleibt von GND getrennt.

RUN closed / USB open

RUN: JP1 zu, USB abgezogen.

SERVICE: JP1 vor USB oeffnen.

04 CAN-Schnittstelle und Controller

Lokale Referenzen: Orion-Bridge.SchLib / Orion-Bridge.PcbLib. Supplier-Daten werden separat gepflegt.

Entwicklungsstand: Versorgung ab 9 V, Thermik, Bauteilfreigabe und Routing vor Fertigung pruefen. Keine 120-Ohm-Terminierung auf dem Drop.

Geometrievorschau aus SchDoc-Daten | Kein Altium-Rendering und keine ERC-/DRC-Pruefung
