Weisni/BatterySentinel-N2K/hardware/altium-r4/Schaltplan-R4-Logic.pdf

# ORION BRIDGE R4 / NMEA 2000 - BLE

04 Geschuetzter, isolierter CAN-Anschluss | 05 ESP32-C3-WROOM-02-N4 / GPIO6 TX, GPIO7 RX

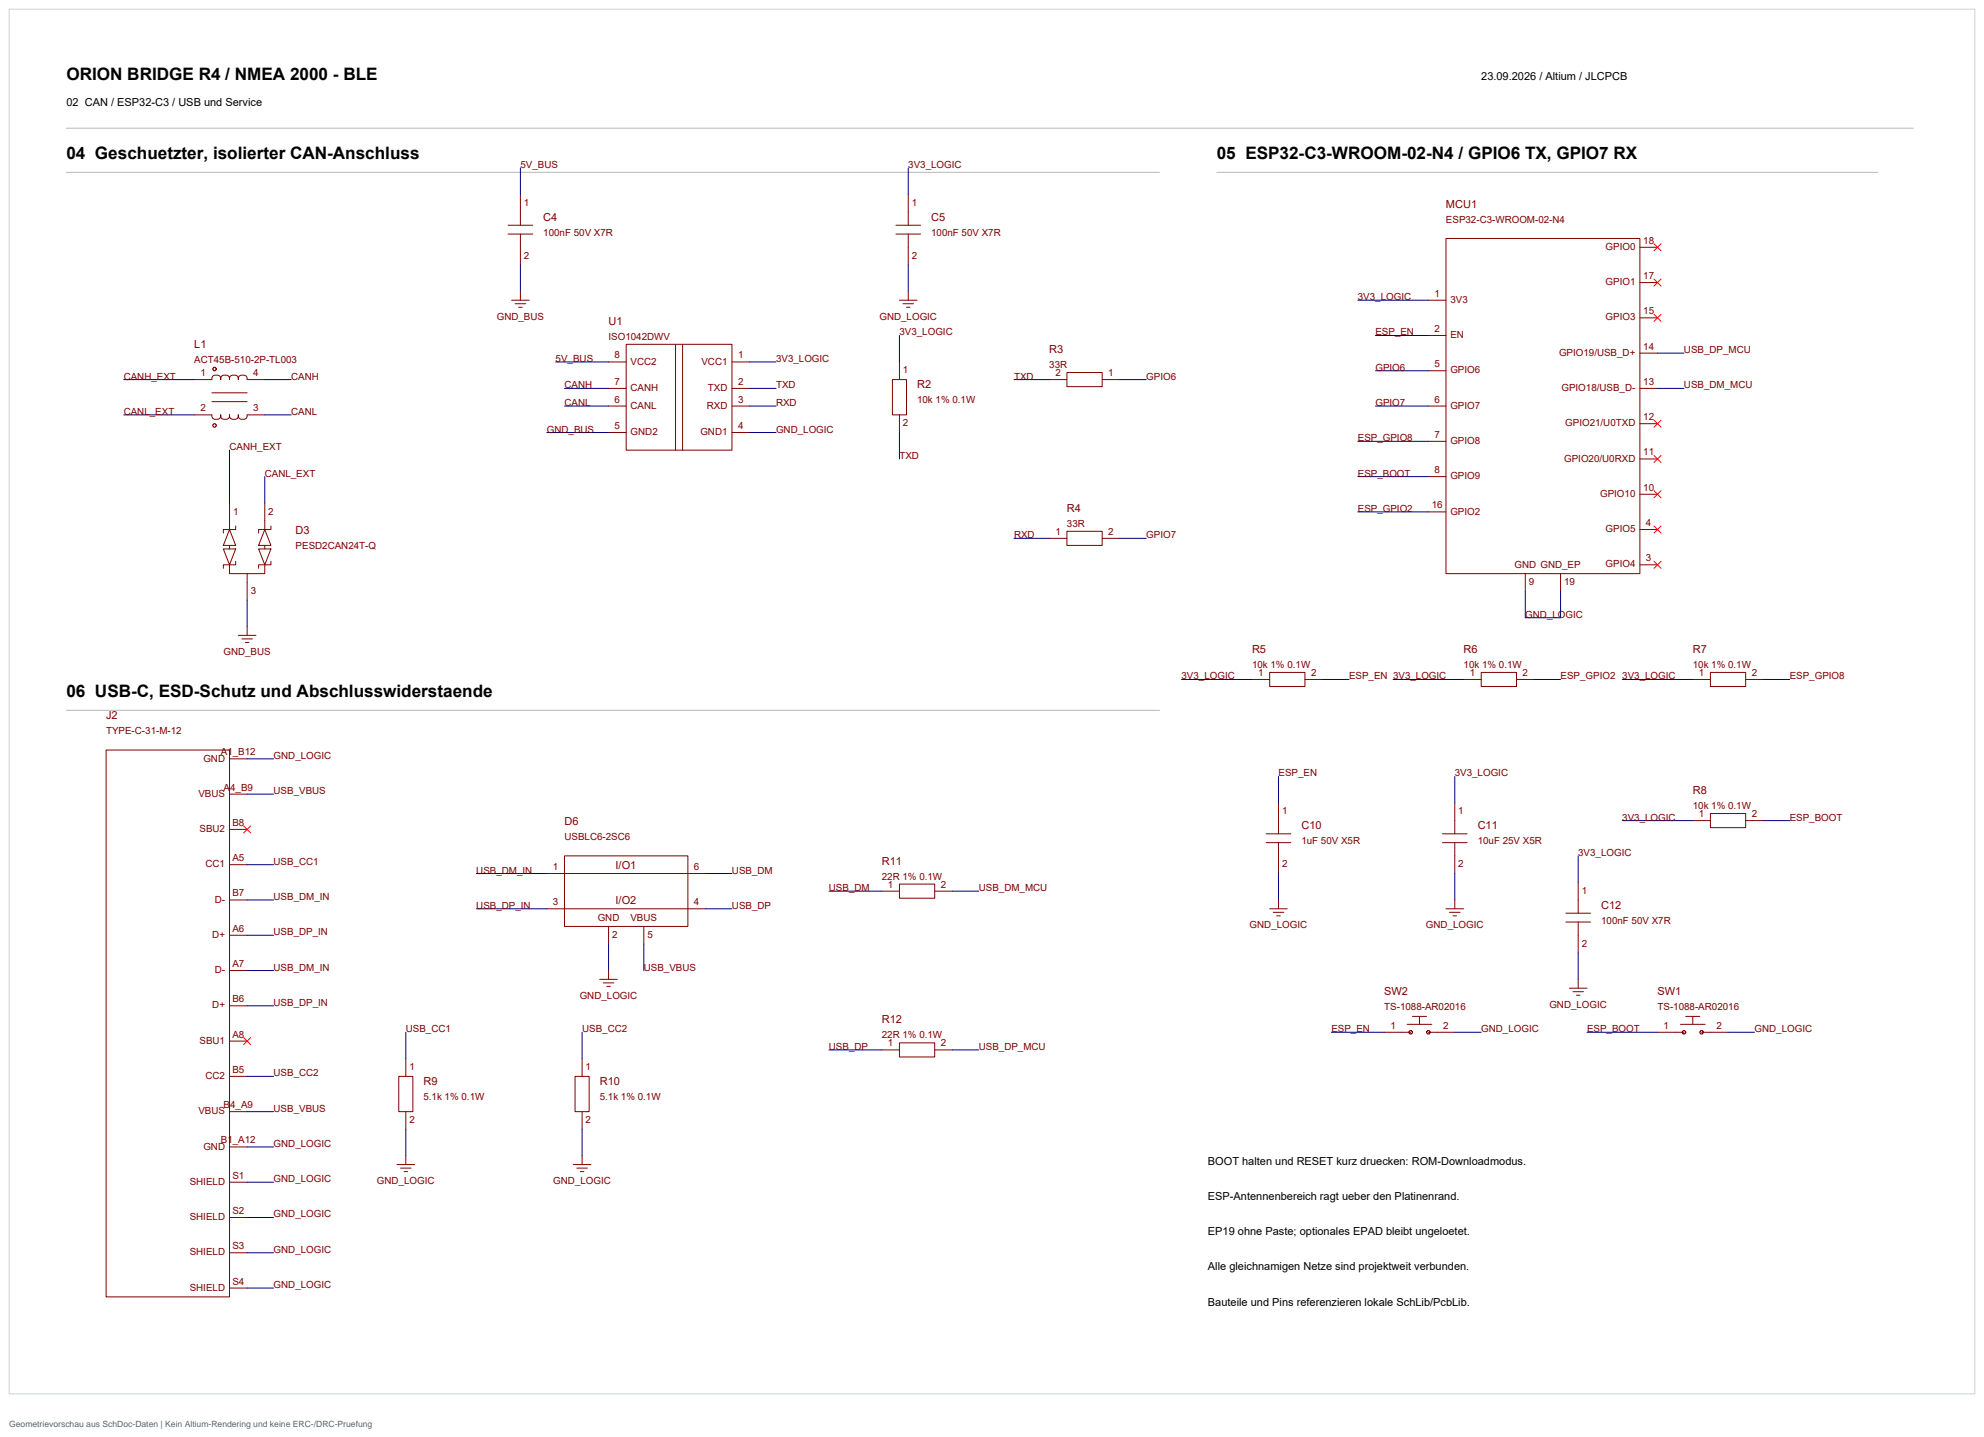
[picture p234: page 1]

02 CAN / ESP32-C3 / USB und Service

06 USB-C, ESD-Schutz und Abschlusswiderstaende

BOOT halten und RESET kurz druecken: ROM-Downloadmodus.

ESP-Antennenbereich ragt ueber den Platinenrand.

EP19 ohne Paste; optionales EPAD bleibt ungeloetet.

Alle gleichnamigen Netze sind projektweit verbunden.

Bauteile und Pins referenzieren lokale SchLib/PcbLib.

Geometrievorschau aus SchDoc-Daten | Kein Altium-Rendering und keine ERC-/DRC-Pruefung
