Weisni/BatterySentinel-N2K/output/internal/engineering/orion-bridge-schaltplan-pcb-entwurf.pdf

# Schaltplan 01 - Versorgung und Schutz

### A NET-S / Verpolung / Transienten

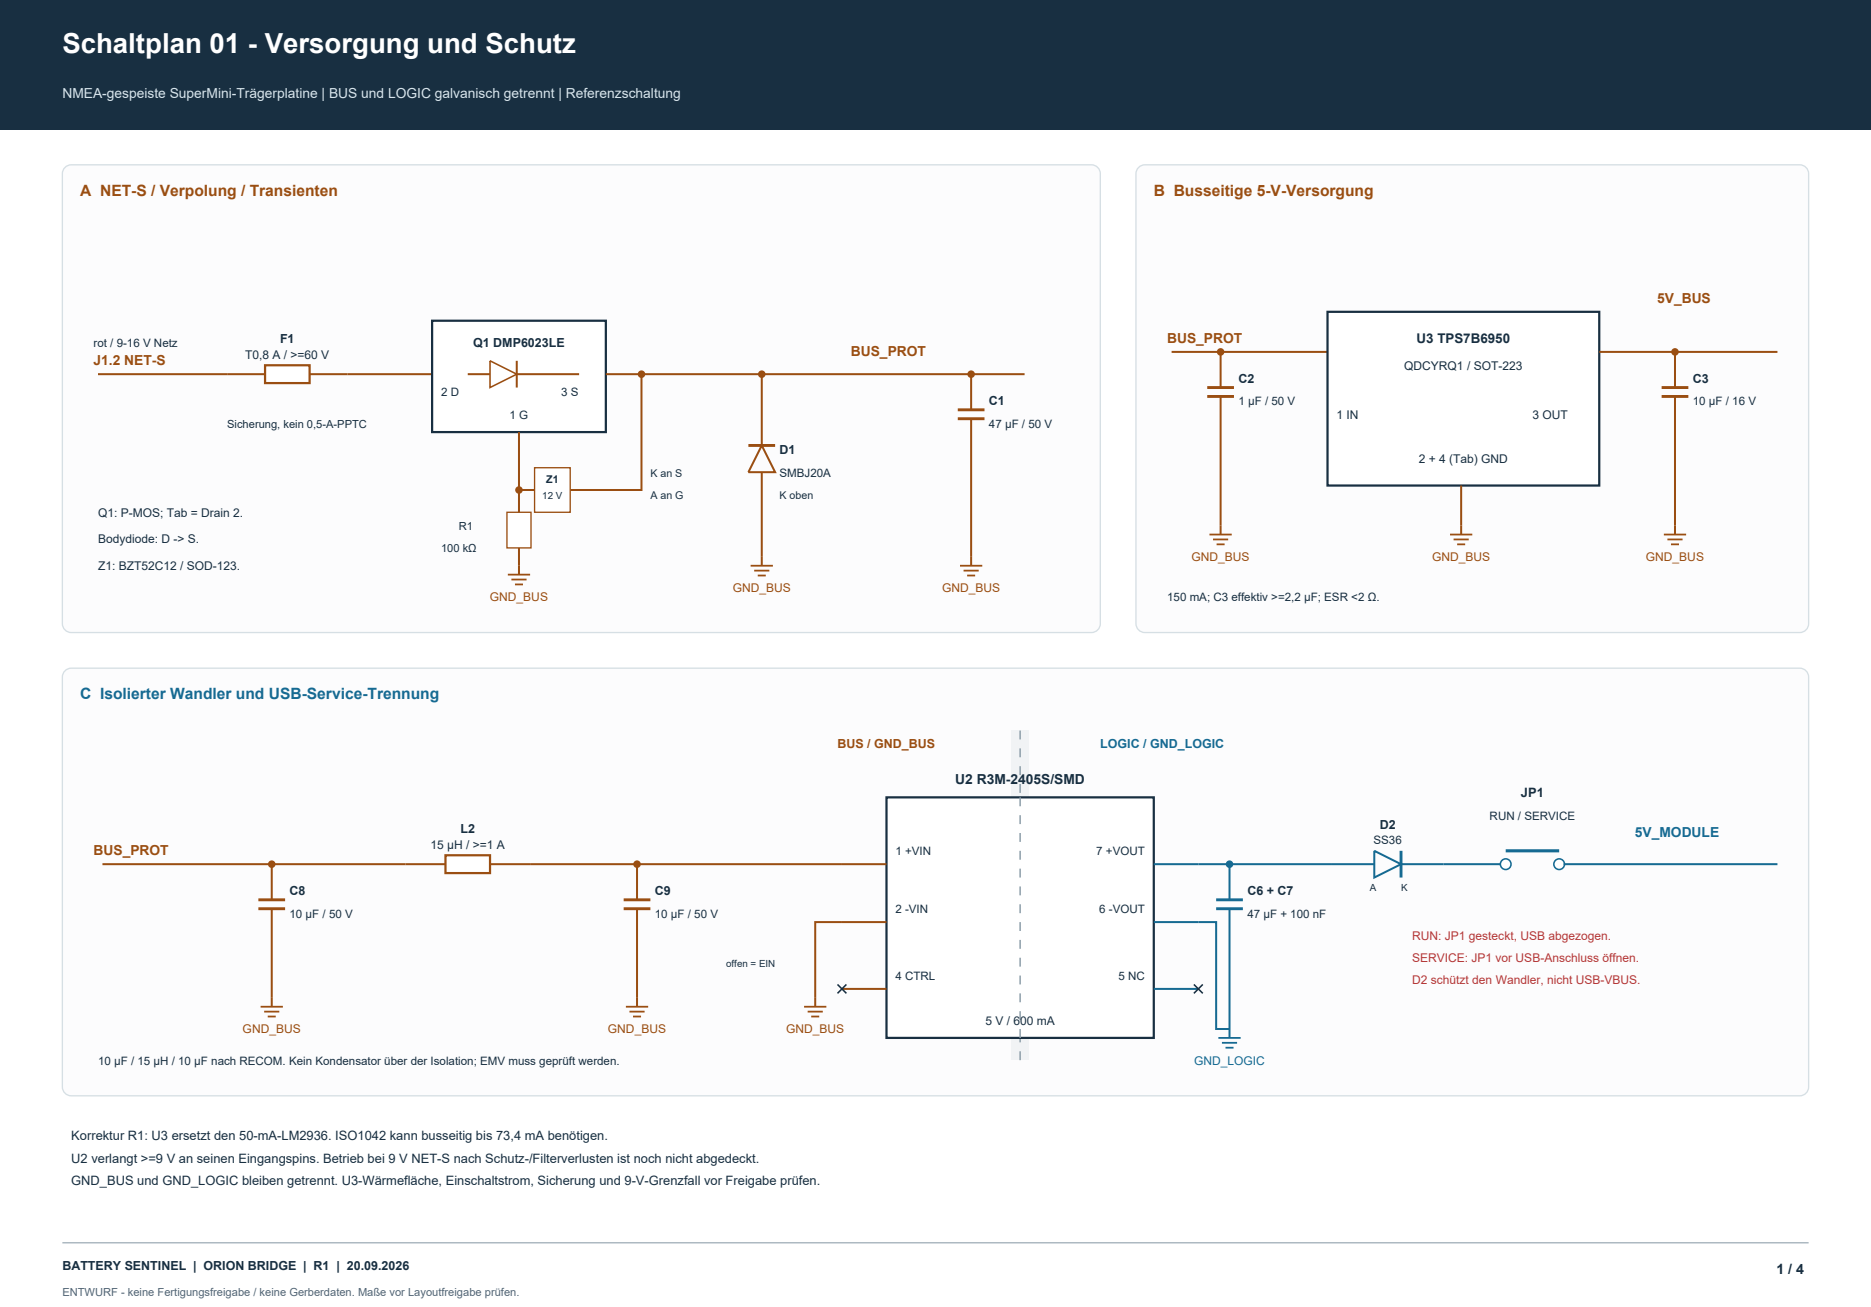
[picture p236: page 1]

NMEA-gespeiste SuperMini-Trägerplatine | BUS und LOGIC galvanisch getrennt | Referenzschaltung

150 mA; C3 effektiv >=2,2 µF; ESR <2 Ω.

C Isolierter Wandler und USB-Service-Trennung

RUN: JP1 gesteckt, USB abgezogen.

SERVICE: JP1 vor USB-Anschluss öffnen.

D2 schützt den Wandler, nicht USB-VBUS.

10 µF / 15 µH / 10 µF nach RECOM. Kein Kondensator über der Isolation; EMV muss geprüft werden.

Korrektur R1: U3 ersetzt den 50-mA-LM2936. ISO1042 kann busseitig bis 73,4 mA benötigen.
U2 verlangt >=9 V an seinen Eingangspins. Betrieb bei 9 V NET-S nach Schutz-/Filterverlusten ist noch nicht abgedeckt.
GND_BUS und GND_LOGIC bleiben getrennt. U3-Wärmefläche, Einschaltstrom, Sicherung und 9-V-Grenzfall vor Freigabe prüfen.

BATTERY SENTINEL | ORION BRIDGE | R1 | 20.09.2026

ENTWURF - keine Fertigungsfreigabe / keine Gerberdaten. Maße vor Layoutfreigabe prüfen.

# Schaltplan 02 - CAN und Controller

BUS / GND_BUS = NET-C | LOGIC / GND_LOGIC = SuperMini-GND

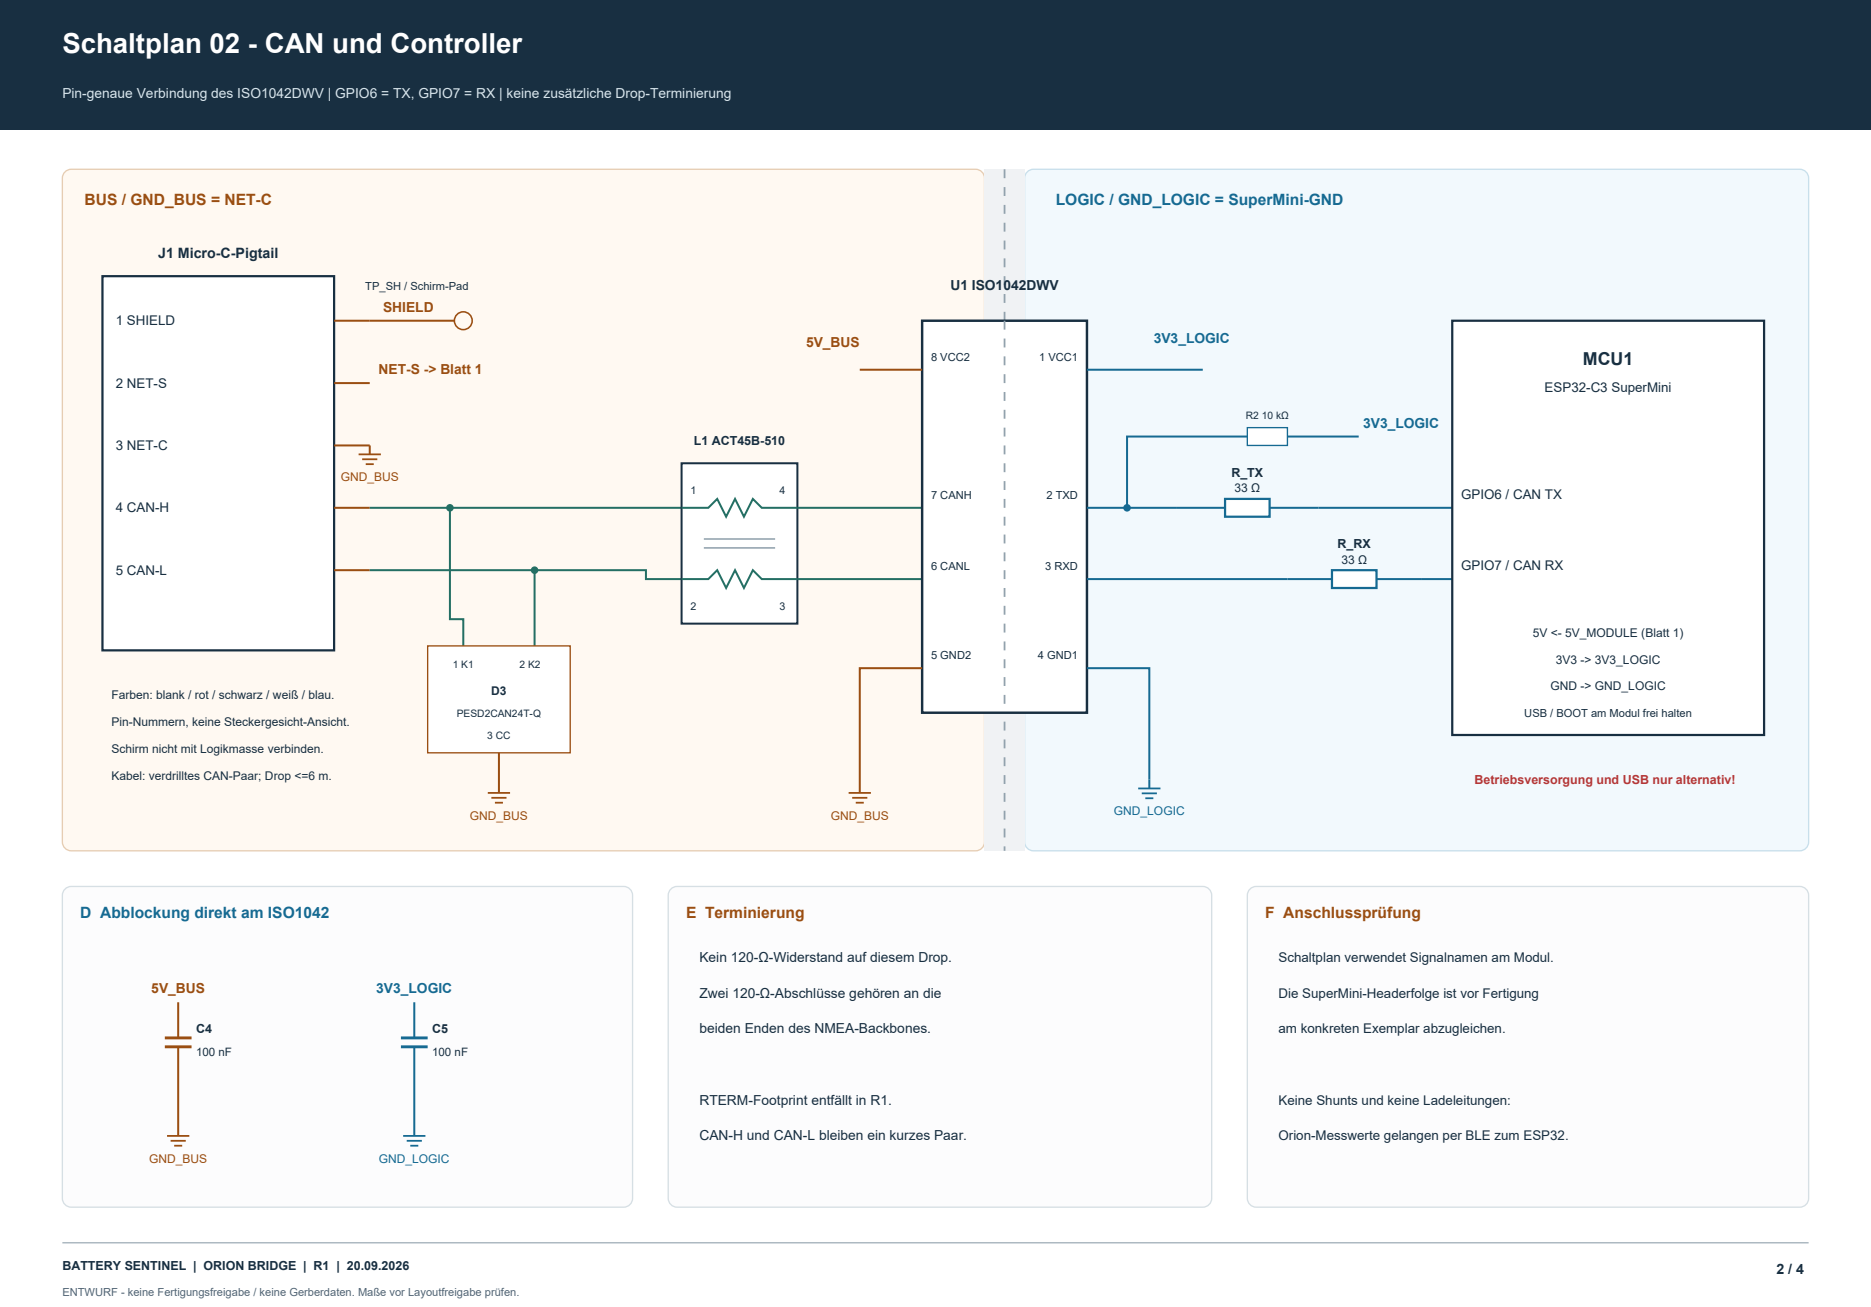
[picture p237: page 2]
J1 Micro-C-Pigtail; 1 SHIELD; 2 NET-S; 3 NET-C; 4 CAN-H; 5 CAN-L; SHIELD; TP_SH / Schirm-Pad; NET-S -> Blatt 1; GND_BUS; PESD2CAN24T-Q; L1 ACT45B-510; U1 ISO1042DWV; 8 VCC2; 7 CANH; 6 CANL; 5 GND2; 1 VCC1; 2 TXD; 3 RXD; 4 GND1; 5V_BUS; 3V3_LOGIC; GND_LOGIC; 3V3_LOGIC R2 10 kΩ; MCU1; ESP32-C3 SuperMini; GPIO6 / CAN TX; GPIO7 / CAN RX; 5V <- 5V_MODULE (Blatt 1); 3V3 -> 3V3_LOGIC; GND -> GND_LOGIC; E Terminierung; F Anschlussprüfung

Pin-genaue Verbindung des ISO1042DWV | GPIO6 = TX, GPIO7 = RX | keine zusätzliche Drop-Terminierung

Farben: blank / rot / schwarz / weiß / blau.

USB / BOOT am Modul frei halten

Pin-Nummern, keine Steckergesicht-Ansicht.

Schirm nicht mit Logikmasse verbinden.

Kabel: verdrilltes CAN-Paar; Drop <=6 m.

Betriebsversorgung und USB nur alternativ!

D Abblockung direkt am ISO1042

Kein 120-Ω-Widerstand auf diesem Drop.

Schaltplan verwendet Signalnamen am Modul.

Zwei 120-Ω-Abschlüsse gehören an die

Die SuperMini-Headerfolge ist vor Fertigung

beiden Enden des NMEA-Backbones.

am konkreten Exemplar abzugleichen.

RTERM-Footprint entfällt in R1.

Keine Shunts und keine Ladeleitungen:

CAN-H und CAN-L bleiben ein kurzes Paar.

Orion-Messwerte gelangen per BLE zum ESP32.

# PCB-Layoutzeichnung - 80 x 60 mm

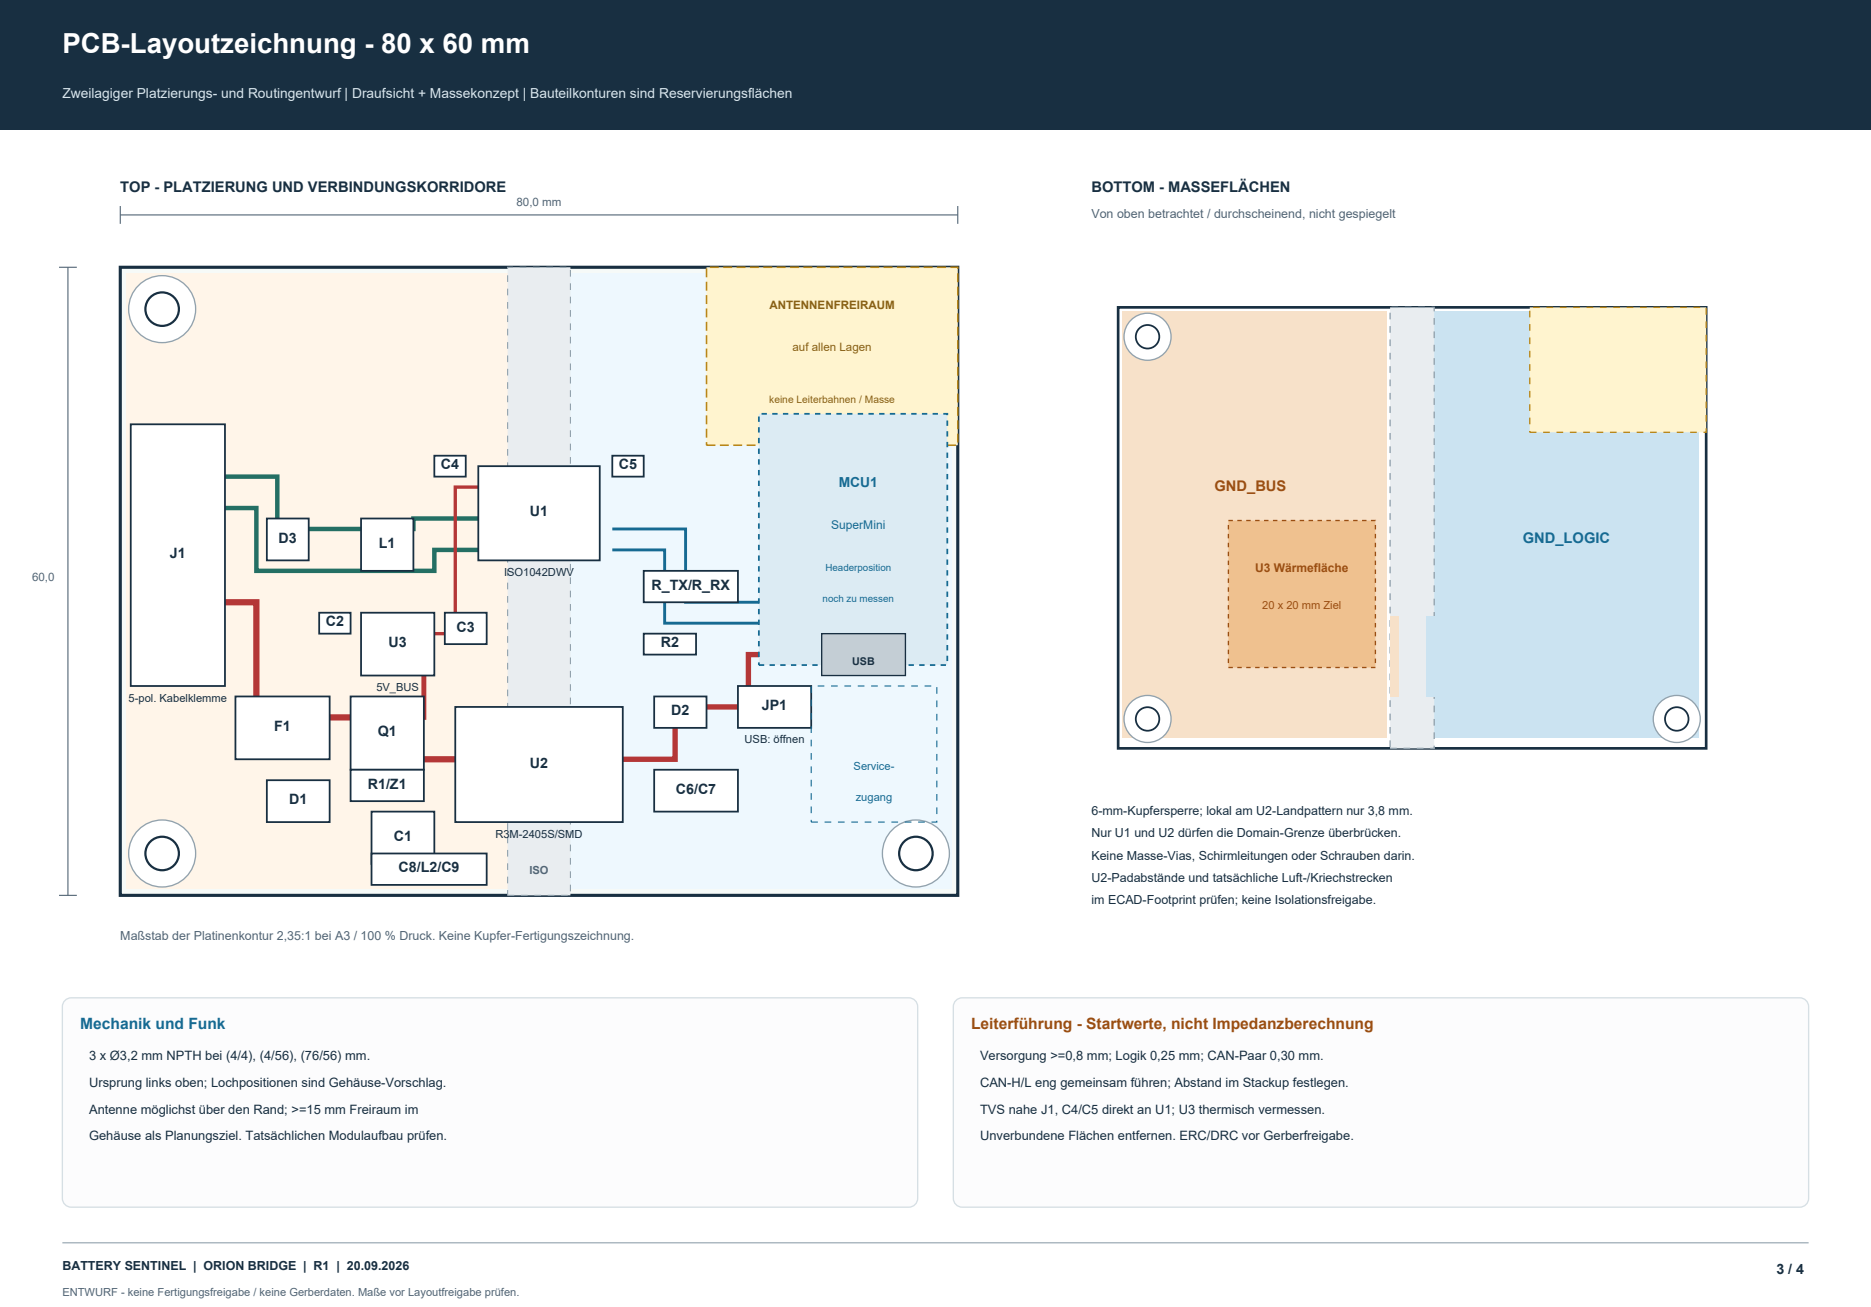
[picture p238: page 3]

Zweilagiger Platzierungs- und Routingentwurf | Draufsicht + Massekonzept | Bauteilkonturen sind Reservierungsflächen

TOP - PLATZIERUNG UND VERBINDUNGSKORRIDORE

Von oben betrachtet / durchscheinend, nicht gespiegelt

6-mm-Kupfersperre; lokal am U2-Landpattern nur 3,8 mm.
Nur U1 und U2 dürfen die Domain-Grenze überbrücken.
Keine Masse-Vias, Schirmleitungen oder Schrauben darin.
U2-Padabstände und tatsächliche Luft-/Kriechstrecken
im ECAD-Footprint prüfen; keine Isolationsfreigabe.

Maßstab der Platinenkontur 2,35:1 bei A3 / 100 % Druck. Keine Kupfer-Fertigungszeichnung.

Leiterführung - Startwerte, nicht Impedanzberechnung

3 x Ø3,2 mm NPTH bei (4/4), (4/56), (76/56) mm.

Versorgung >=0,8 mm; Logik 0,25 mm; CAN-Paar 0,30 mm.

Ursprung links oben; Lochpositionen sind Gehäuse-Vorschlag.

CAN-H/L eng gemeinsam führen; Abstand im Stackup festlegen.

Antenne möglichst über den Rand; >=15 mm Freiraum im

TVS nahe J1, C4/C5 direkt an U1; U3 thermisch vermessen.

Gehäuse als Planungsziel. Tatsächlichen Modulaufbau prüfen.

Unverbundene Flächen entfernen. ERC/DRC vor Gerberfreigabe.

# Bauteile, Prüfstellen und Quellen

### BAUTEILAUSWAHL

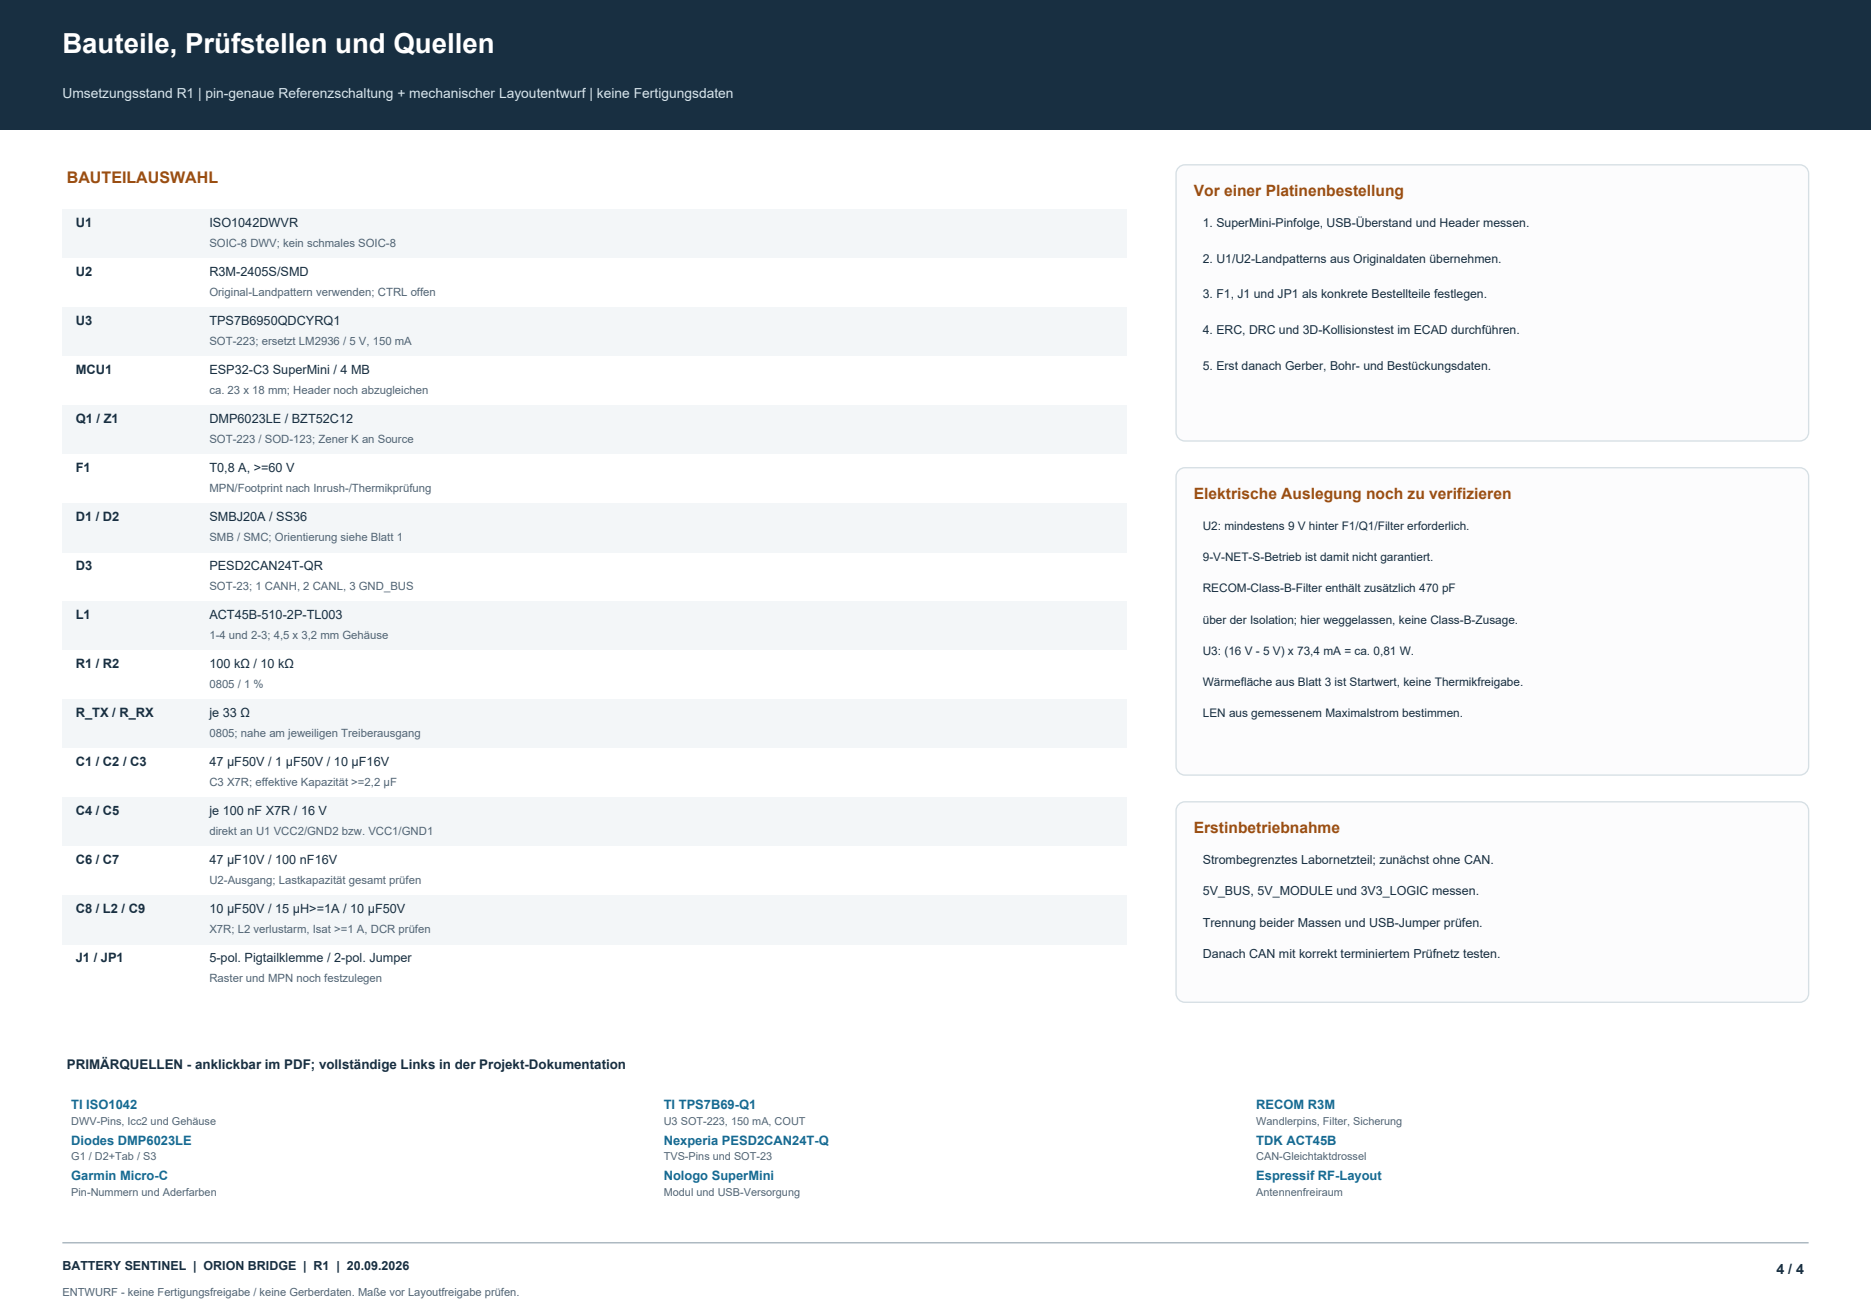
[picture p239: page 4]

Umsetzungsstand R1 | pin-genaue Referenzschaltung + mechanischer Layoutentwurf | keine Fertigungsdaten

1. SuperMini-Pinfolge, USB-Überstand und Header messen.

SOIC-8 DWV; kein schmales SOIC-8

2. U1/U2-Landpatterns aus Originaldaten übernehmen.

Original-Landpattern verwenden; CTRL offen

3. F1, J1 und JP1 als konkrete Bestellteile festlegen.

4. ERC, DRC und 3D-Kollisionstest im ECAD durchführen.

5. Erst danach Gerber, Bohr- und Bestückungsdaten.

ca. 23 x 18 mm; Header noch abzugleichen

SOT-223 / SOD-123; Zener K an Source

MPN/Footprint nach Inrush-/Thermikprüfung

Elektrische Auslegung noch zu verifizieren

U2: mindestens 9 V hinter F1/Q1/Filter erforderlich.

SMB / SMC; Orientierung siehe Blatt 1

9-V-NET-S-Betrieb ist damit nicht garantiert.

RECOM-Class-B-Filter enthält zusätzlich 470 pF

über der Isolation; hier weggelassen, keine Class-B-Zusage.

Wärmefläche aus Blatt 3 ist Startwert, keine Thermikfreigabe.

LEN aus gemessenem Maximalstrom bestimmen.

0805; nahe am jeweiligen Treiberausgang

Strombegrenztes Labornetzteil; zunächst ohne CAN.

U2-Ausgang; Lastkapazität gesamt prüfen

Trennung beider Massen und USB-Jumper prüfen.

X7R; L2 verlustarm, Isat >=1 A, DCR prüfen

Danach CAN mit korrekt terminiertem Prüfnetz testen.

Raster und MPN noch festzulegen

PRIMÄRQUELLEN - anklickbar im PDF; vollständige Links in der Projekt-Dokumentation

TI ISO1042
DWV-Pins, Icc2 und Gehäuse (https://www.ti.com/lit/ds/symlink/iso1042.pdf)
Diodes DMP6023LE
G1 / D2+Tab / S3 (https://www.diodes.com/datasheet/download/DMP6023LE.pdf)
Garmin Micro-C
Pin-Nummern und Aderfarben (https://static.garmin.com/pumac/N2k_Field-install_Connector_Wiring_ML.pdf)

TI TPS7B69-Q1
U3 SOT-223, 150 mA, COUT (https://www.ti.com/lit/ds/symlink/tps7b69-q1.pdf)
Nexperia PESD2CAN24T-Q
TVS-Pins und SOT-23 (https://assets.nexperia.com/documents/data-sheet/PESD2CAN24T-Q.pdf)
Nologo SuperMini
Modul und USB-Versorgung (https://www.nologo.tech/product/esp32/esp32c3/esp32c3supermini/esp32C3SuperMini.html)
