Weisni/BatterySentinel-N2K/hardware/altium-r5/Project Outputs/Hand Assembly/source-references/AssemblyDrawing.pdf

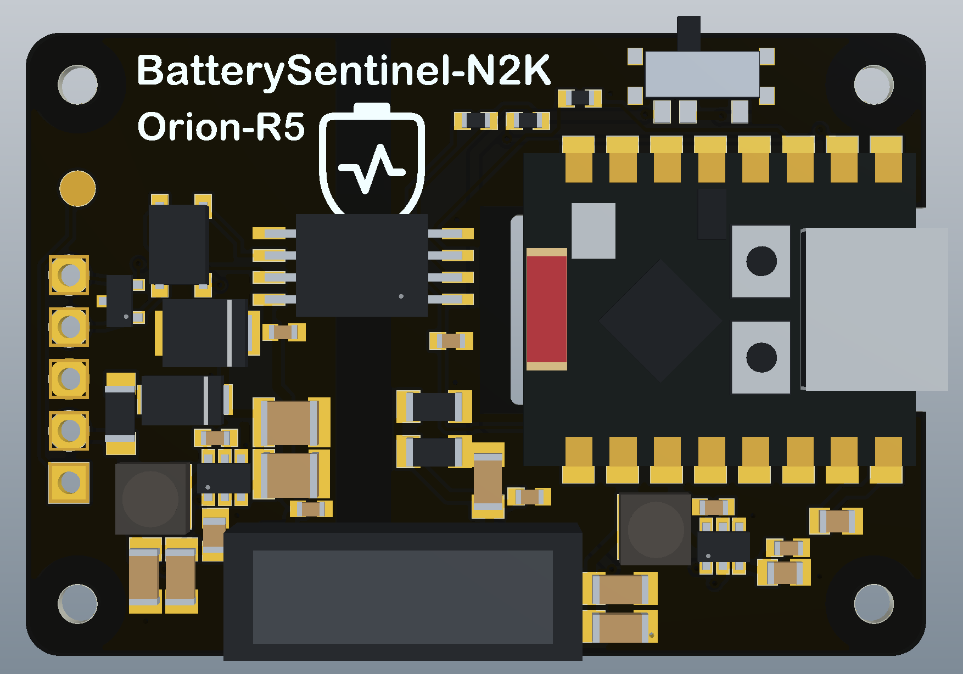
[picture p240: page 1]

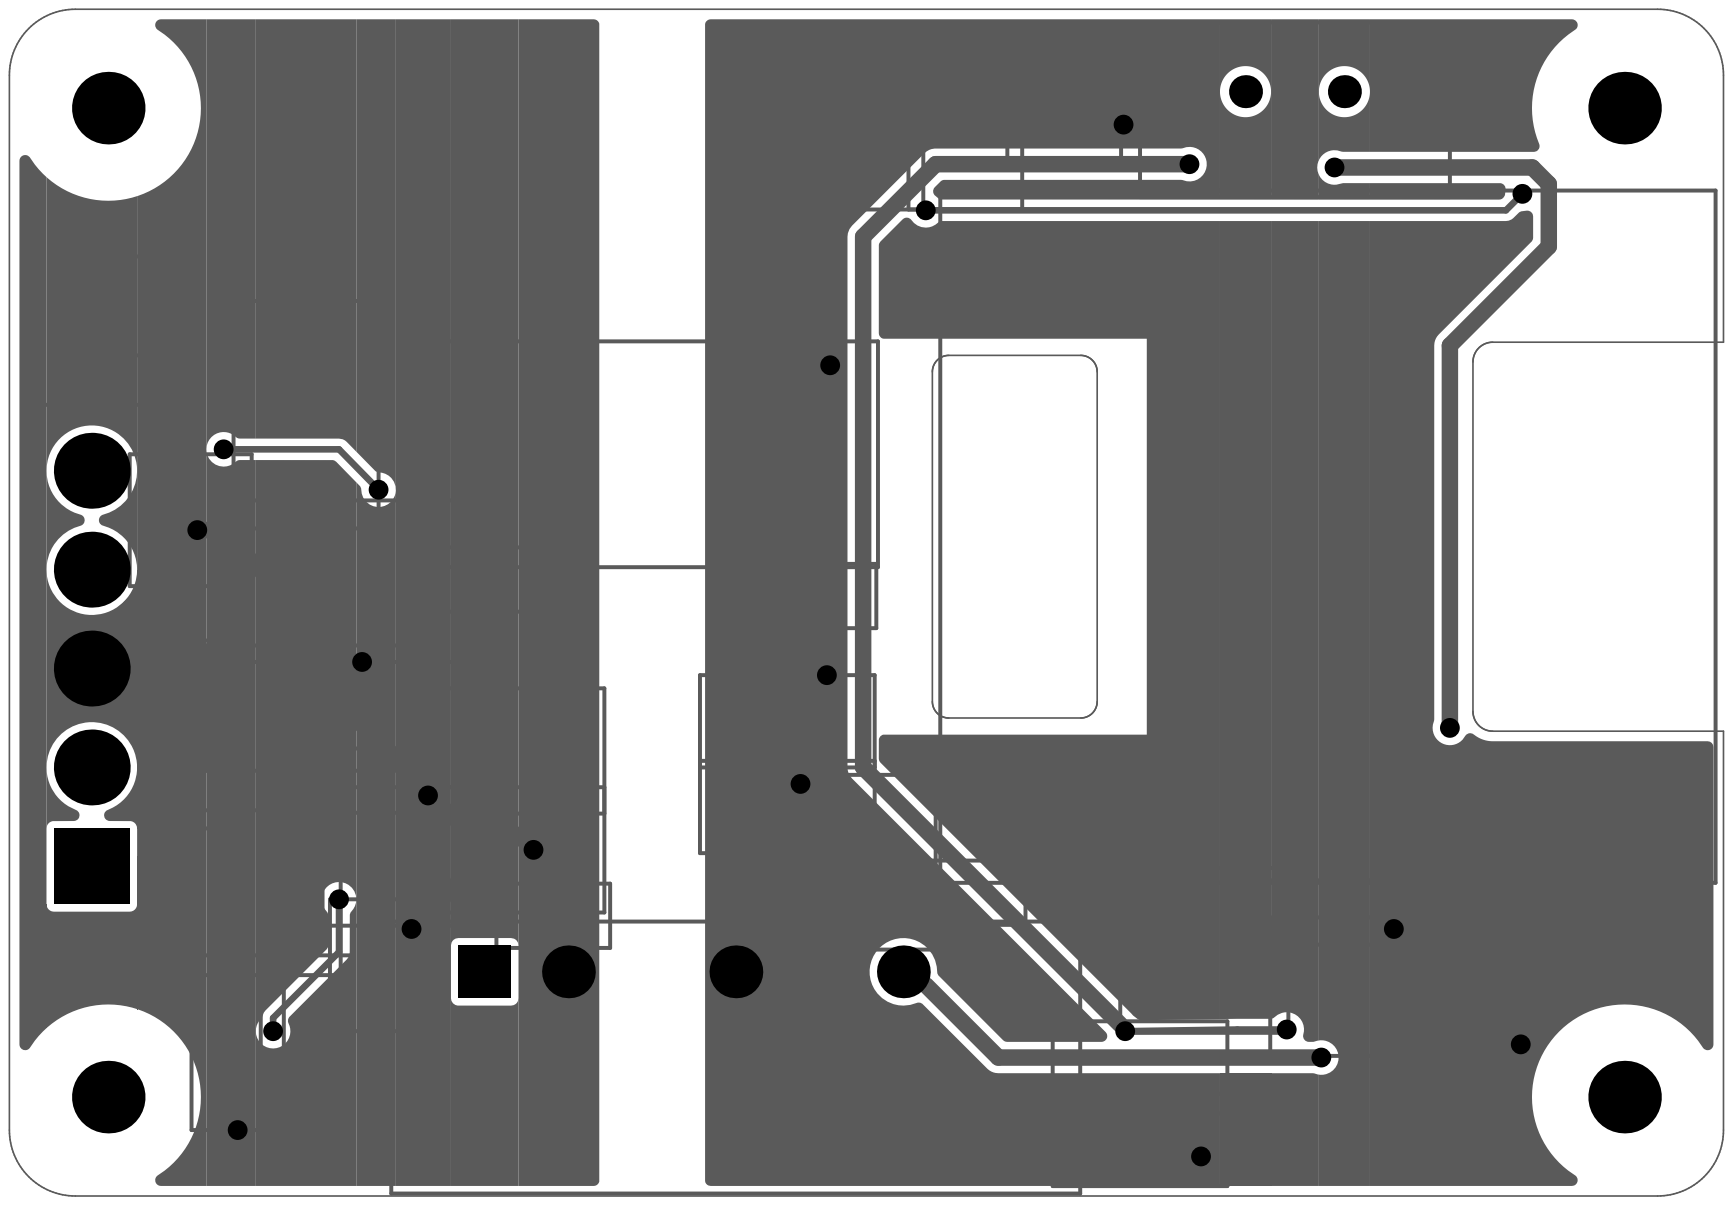
[picture p241: page 2]

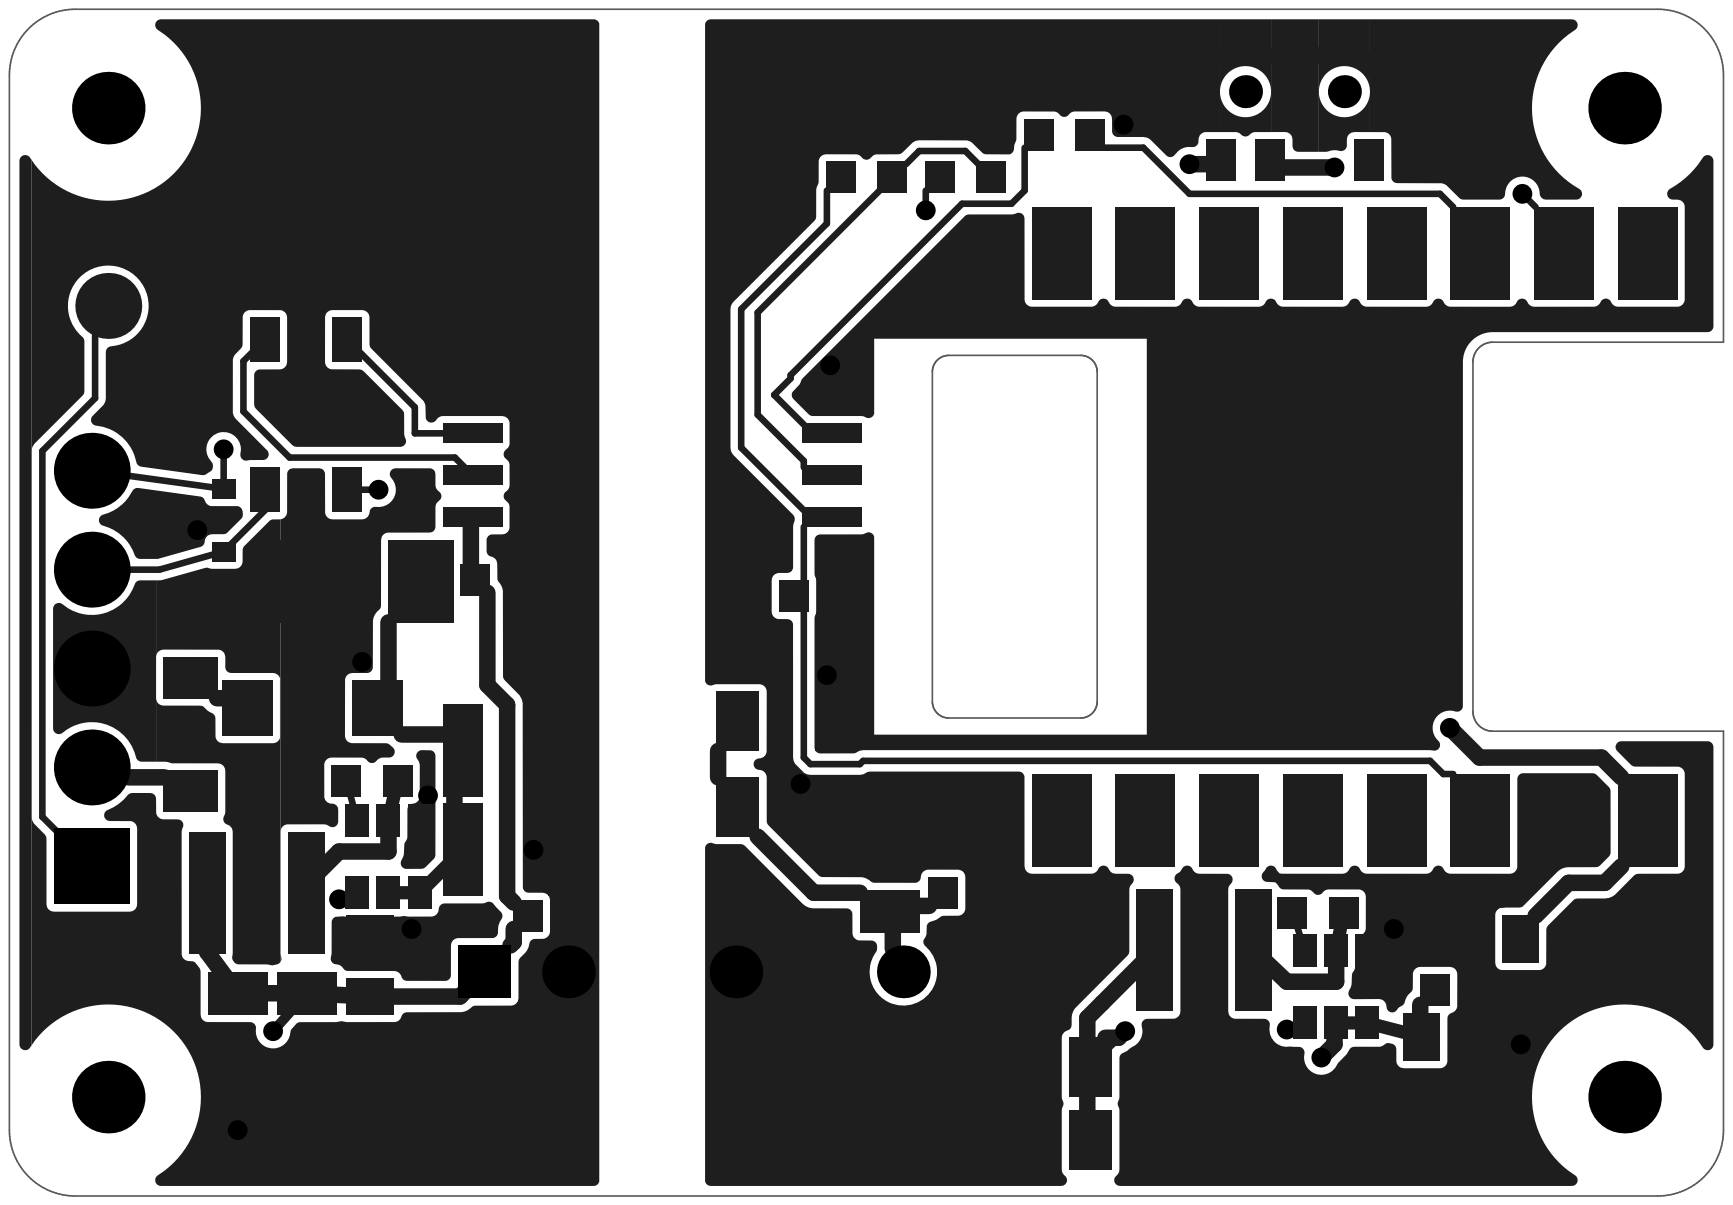
[picture p242: page 3]
