Weisni/BatterySentinel-N2K/(list of files, drawings)

Other design files:
hardware/altium-r2/Orion-Bridge-R2.PcbDoc
hardware/altium-r2/Orion-Bridge-R2.PrjPcb
hardware/altium-r2/Orion-Bridge-R2.SchDoc
hardware/altium-r2/Orion-Bridge.PcbLib
hardware/altium-r2/Orion-Bridge.SchLib
hardware/altium-r3/Orion-Bridge-R3.PcbDoc
hardware/altium-r3/Orion-Bridge-R3.PrjPcb
hardware/altium-r3/Orion-Bridge-R3.SchDoc
hardware/altium-r3/Orion-Bridge.PcbLib
hardware/altium-r3/Orion-Bridge.SchLib
hardware/altium-r3/source/Orion-Bridge-R3.PcbDoc
hardware/altium-r4/Orion-Bridge-R4-Logic.SchDoc
hardware/altium-r4/Orion-Bridge-R4-Power.SchDoc
hardware/altium-r4/Orion-Bridge-R4.PcbDoc
hardware/altium-r4/Orion-Bridge-R4.PrjPcb
hardware/altium-r4/Orion-Bridge.PcbLib
hardware/altium-r4/Orion-Bridge.SchLib
hardware/altium-r4/schematic-library-verification.json
hardware/altium-r4/schematic-render-validation.json
hardware/altium-r4/source/Orion-Bridge-R4.PcbDoc
hardware/altium-r5/BatterySentinel-N2K-Orion-R5-Logic.SchDoc
hardware/altium-r5/BatterySentinel-N2K-Orion-R5-Power.SchDoc
hardware/altium-r5/BatterySentinel-N2K-Orion-R5.PcbDoc
hardware/altium-r5/BatterySentinel-N2K-Orion-R5.PrjPcb
hardware/altium-r5/Orion-Bridge.PcbLib
hardware/altium-r5/Orion-Bridge.SchLib
hardware/altium-r5/Project Outputs/Hand Assembly/source-references/BatterySentinel-N2K-Orion-R5.PcbDoc
hardware/altium-r5/schematic-library-verification.json
hardware/altium-r5/source/BatterySentinel-N2K-Orion-R5.PcbDoc
hardware/altium-r5/typography/R5-Beschriftungsprobe.PcbDoc
hardware/altium/Orion-Bridge-R1.PcbDoc
hardware/altium/Orion-Bridge-R1.PrjPcb
hardware/altium/Orion-Bridge-R1.SchDoc
tools/altium_defaults/pcb_library_header.json
