Weisni/BatterySentinel-N2K/src/BridgePortalTranslations.h

#pragma once

// English source text is the canonical key; protocol identifiers stay unchanged.
namespace bs::ui {

inline constexpr char kTranslations[] = R"I18N(<script>window.bridgeGerman={
"Forgot password?":"Passwort vergessen?",
"Recover access.":"Zugang wiederherstellen.",
"Reset only the administrator password with physical access to the bridge.":"Setze nur das Administratorpasswort zurück. Dafür brauchst du Zugriff auf die BOOT-Taste der Bridge.",
"Your username, Wi-Fi password, Orion connection, battery names, NMEA assignments and saved data stay unchanged.":"Dein Benutzername, WLAN-Passwort, die Orion-Verbindung, Batterienamen, NMEA-Zuweisungen und gespeicherte Daten bleiben unverändert.",
"Reset password":"Passwort zurücksetzen",
"Find the recovery password in the saved user manual or docs/erstverbindung.md from the project README.":"Das Wiederherstellungspasswort steht in der gespeicherten Bedienungsanleitung oder in docs/erstverbindung.md, verlinkt in der README des Projekts.",
"Keep the physical BOOT button pressed while selecting Reset password below.":"Halte die BOOT-Taste am Gerät gedrückt, während du unten „Passwort zurücksetzen“ auswählst.",
"Sign in with your existing username and the documented recovery password. Then choose a new personal password in Settings.":"Melde dich mit deinem bisherigen Benutzernamen und dem Wiederherstellungspasswort aus der Anleitung an. Vergib danach in den Einstellungen ein neues persönliches Passwort.",
"The recovery password is public. Change it immediately after signing in.":"Das Wiederherstellungspasswort ist öffentlich bekannt. Ändere es sofort nach der Anmeldung.",
"I want to reset only the administrator password.":"Ich möchte ausschließlich das Administratorpasswort zurücksetzen.",
"Back to sign in":"Zurück zur Anmeldung",
"The reset can take a few seconds. Keep BOOT pressed until the result appears and leave this page open.":"Das Zurücksetzen kann einige Sekunden dauern. Halte BOOT gedrückt, bis das Ergebnis erscheint, und lasse diese Seite geöffnet.",
"Resetting password…":"Passwort wird zurückgesetzt…",
"Continue to sign in":"Weiter zur Anmeldung",
"Use your existing username and your updated password.":"Verwende deinen bisherigen Benutzernamen und dein aktualisiertes Passwort.",
"Change password":"Passwort ändern",
"Choose a personal password for the web interface. You will sign in again after saving.":"Wähle ein persönliches Passwort für die Weboberfläche. Nach dem Speichern meldest du dich erneut an.",
"If you recovered access using the public recovery password, replace it now.":"Wenn du den Zugang mit dem öffentlich bekannten Wiederherstellungspasswort wiederhergestellt hast, ändere es jetzt.",
"Current password":"Aktuelles Passwort",
"New password":"Neues Passwort",
"Repeat new password":"Neues Passwort wiederholen",
"Use 12–128 bytes of text. Most letters and numbers use one byte; accents and emoji use more. Spaces are kept exactly as entered.":"Verwende 12–128 Byte Text. Die meisten Buchstaben und Zahlen belegen ein Byte, Umlaute und Emoji mehr. Leerzeichen bleiben genau wie eingegeben erhalten.",
"Enter your current administrator password.":"Gib dein aktuelles Administratorpasswort ein.",
"Use 12–128 bytes for the new password.":"Verwende 12–128 Byte für das neue Passwort.",
"Enter the same new password in both fields.":"Gib in beiden Feldern dasselbe neue Passwort ein.",
"Wait for the firmware operation to finish, then try again.":"Warte, bis der Firmwarevorgang abgeschlossen ist, und versuche es erneut.",
"Changing the password can take a few seconds. Keep this page open.":"Die Passwortänderung kann einige Sekunden dauern. Lass diese Seite geöffnet.",
"Changing password…":"Passwort wird geändert…",
"Password changed":"Passwort geändert",
"Sign in with your new password. All saved data and assignments are unchanged.":"Melde dich mit deinem neuen Passwort an. Alle gespeicherten Daten und Zuweisungen bleiben unverändert.",
"Password reset":"Passwort zurückgesetzt",
"Sign in with your existing username and the recovery password printed in the manual. Then change it in Settings.":"Melde dich mit deinem bisherigen Benutzernamen und dem Wiederherstellungspasswort aus der Anleitung an. Ändere es danach in den Einstellungen.",
"Check the new password":"Neues Passwort prüfen",
"Use 12–128 UTF-8 bytes for the new password and enter it identically in both fields.":"Verwende 12–128 UTF-8-Byte für das neue Passwort und gib es in beiden Feldern identisch ein.",
"Current password incorrect":"Aktuelles Passwort falsch",
"Enter your current administrator password and try again.":"Gib dein aktuelles Administratorpasswort ein und versuche es erneut.",
"Could not save password":"Passwort konnte nicht gespeichert werden",
"The password could not be saved. Your previous password remains valid. Try again.":"Das Passwort konnte nicht gespeichert werden. Dein bisheriges Passwort bleibt gültig. Versuche es erneut.",
"Confirm password recovery":"Passwort-Wiederherstellung bestätigen",
"Open Forgot password again, confirm the reset, and hold BOOT while submitting.":"Öffne „Passwort vergessen“ erneut, bestätige das Zurücksetzen und halte BOOT beim Absenden gedrückt.",
"Administrator password changed":"Administratorpasswort geändert",
"Administrator password reset with BOOT":"Administratorpasswort mit BOOT zurückgesetzt",
"Language":"Sprache",
"Battery Sentinel logo":"Battery-Sentinel-Logo",
"Local service portal":"Lokales Serviceportal",
"Clear power data.":"Energiedaten im Blick.",
"One trusted bridge.":"Eine zuverlässige Verbindung.",
"Monitor Orion XS charger telemetry and send it to your NMEA 2000 network. Configuration stays on this device.":"Behalte die Messwerte des Orion XS im Blick und übertrage sie in dein NMEA-2000-Netzwerk. Die Einstellungen bleiben auf diesem Gerät.",
"Service Wi-Fi active":"Service-WLAN aktiv",
"Administrator access":"Administratorzugang",
"Welcome back":"Willkommen zurück",
"Sign in to view live data and manage the bridge.":"Melde dich an, um Live-Daten zu sehen und die Bridge einzurichten.",
"Username":"Benutzername",
"Password":"Passwort",
"Sign in":"Anmelden",
"Password verification can take a few seconds. Keep this page open after submitting.":"Die Passwortprüfung kann einige Sekunden dauern. Lass die Seite nach dem Absenden geöffnet.",
"Connected locally to the dongle. If the service Wi-Fi is missing, hold BOOT on the device for two seconds.":"Du bist lokal mit dem Dongle verbunden. Falls das Service-WLAN nicht angezeigt wird, halte BOOT am Gerät zwei Sekunden lang gedrückt.",
"First installation · Step 1 of 4":"Erstinstallation · Schritt 1 von 4",
"Let's set up":"Richte",
"your bridge.":"deine Bridge ein.",
"Start with a local administrator account. The guided setup will then show where to find Orion Bluetooth information and how to map it to Garmin.":"Erstelle zuerst ein lokales Administratorkonto. Der Einrichtungsassistent zeigt dir anschließend, wo du die Bluetooth-Daten des Orion findest und wie du die Werte Garmin zuordnest.",
"Your data stays on the dongle":"Deine Daten bleiben auf dem Dongle",
"Protect local access":"Lokalen Zugang schützen",
"Create administrator":"Administrator erstellen",
"This account secures the dongle's web interface. It is separate from your Orion Bluetooth PIN.":"Dieses Konto schützt die Weboberfläche des Dongles. Es ist unabhängig von der Bluetooth-PIN deines Orion.",
"3–32 letters, numbers, underscores or hyphens.":"3–32 Zeichen: Buchstaben A–Z, Zahlen, Unterstriche oder Bindestriche.",
"At least 12 characters. Keep it somewhere safe.":"Mindestens 12 Zeichen. Bewahre das Passwort sicher auf.",
"Hold the physical BOOT button on the C3 while you select Create administrator.":"Halte die BOOT-Taste am C3 gedrückt, während du „Administrator erstellen“ auswählst.",
"Next: use VictronConnect on your phone to find the Orion XS MAC address and Instant Readout encryption key.":"Als Nächstes: Finde in VictronConnect auf deinem Handy die MAC-Adresse des Orion XS und den Verschlüsselungsschlüssel für Instant Readout.",
"Configuration updated":"Einstellungen gespeichert",
"Bridge":"Bridge",
"restarting.":"startet neu.",
"Your change was saved on the dongle. The service page will be available again after it starts.":"Deine Änderung wurde auf dem Dongle gespeichert. Nach dem Neustart ist das Serviceportal wieder erreichbar.",
"One moment":"Einen Moment",
"Keep your phone on the OrionBridge Wi-Fi. If it disconnects, rejoin it and reopen the local portal.":"Lass dein Handy mit dem OrionBridge-WLAN verbunden. Falls die Verbindung getrennt wird, verbinde dich erneut und öffne das lokale Portal.",
"Open dashboard":"Dashboard öffnen",
"Action needed":"Aktion erforderlich",
"Let's try again":"Versuche es erneut",
"Return to the local portal, review the details, and submit once more.":"Kehre zum lokalen Portal zurück, prüfe deine Angaben und sende sie erneut ab.",
"Return to portal":"Zurück zum Portal",
"Main menu":"Hauptmenü",
"Overview":"Übersicht",
"Setup":"Einrichtung",
"Guide":"Anleitung",
"Monitor":"Monitor",
"LOCAL MODE":"LOKALER BETRIEB",
"Orion data → NMEA 2000":"Orion-Daten → NMEA 2000",
"No alarms or charger control":"Keine Alarme oder Ladesteuerung",
"Bridge control":"Bridge-Verwaltung",
"Connecting…":"Verbindung wird hergestellt…",
"Sign out":"Abmelden",
"Your session has expired.":"Deine Sitzung ist abgelaufen.",
"Sign in again":"Melde dich erneut an,",
"to resume live data.":"um wieder Live-Daten zu sehen.",
"Live telemetry":"Live-Messwerte",
"Power, in focus.":"Energie im Blick.",
"Real-time charger input and output values translated to NMEA 2000. Values appear only when a fresh Orion advertisement has been received.":"Eingangs- und Ausgangswerte des Ladegeräts werden in Echtzeit nach NMEA 2000 übersetzt. Werte erscheinen erst, wenn ein aktuelles Bluetooth-Datenpaket des Orion empfangen wurde.",
"Configure Orion":"Orion einrichten",
"View messages":"Meldungen anzeigen",
"Charger channels":"Ladegerät: Ein- und Ausgang",
"Waiting for data":"Warte auf Daten",
"Output voltage":"Ausgangsspannung",
"Output current":"Ausgangsstrom",
"Input voltage":"Eingangsspannung",
"Input current":"Eingangsstrom",
"Bridge health":"Bridge-Status",
"Refresh":"Aktualisieren",
"Orion status":"Orion-Status",
"Waiting":"Warte auf Daten",
"BLE frames accepted":"Akzeptierte BLE-Pakete",
"NMEA messages sent":"Gesendete NMEA-Meldungen",
"Input is the charger supply; output is the charger-to-battery side. No battery state of charge or alarm is inferred.":"Der Eingang ist die Versorgung des Ladegeräts, der Ausgang die Verbindung zur Batterie. Daraus werden weder ein Batterieladezustand noch Alarme abgeleitet.",
"Configuration":"Konfiguration",
"Connect your Orion.":"Verbinde deinen Orion.",
"Enter the Bluetooth Instant Readout identity and choose distinct NMEA battery instances.":"Gib die Bluetooth-Daten für Instant Readout ein und wähle unterschiedliche NMEA-Batterieinstanzen.",
"Find these values in VictronConnect. Your Bluetooth PIN remains on the phone and is never entered here.":"Diese Angaben findest du in VictronConnect. Deine Bluetooth-PIN bleibt auf dem Handy und wird hier nicht eingegeben.",
"Orion Bluetooth MAC":"Bluetooth-MAC des Orion",
"Six hexadecimal pairs from the Orion device information.":"Sechs hexadezimale Zeichenpaare aus den Geräteinformationen des Orion.",
"Instant Readout encryption key":"Verschlüsselungsschlüssel für Instant Readout",
"32 hexadecimal characters":"32 hexadezimale Zeichen",
"Paste all 32 characters each time you save. This is not the Bluetooth PIN; the saved key is never shown.":"Füge bei jedem Speichern alle 32 Zeichen ein. Gemeint ist nicht die Bluetooth-PIN. Der gespeicherte Schlüssel wird niemals angezeigt.",
"NMEA output instance":"NMEA-Ausgangsinstanz",
"Battery instance used for charger output values.":"Batterieinstanz für die Ausgangswerte des Ladegeräts.",
"NMEA input instance":"NMEA-Eingangsinstanz",
"Use a different number for the charger input.":"Verwende für den Eingang des Ladegeräts eine andere Nummer.",
"Save and restart":"Speichern und neu starten",
"Open setup guide":"Einrichtungsanleitung öffnen",
"Remove a device":"Gerät entfernen",
"Erase the saved Orion MAC and readout key if you replace the charger.":"Lösche die gespeicherte Orion-MAC und den Readout-Schlüssel, wenn du das Ladegerät ersetzt.",
"Forget Orion":"Orion entfernen",
"Guided installation":"Geführte Installation",
"From first boot to Garmin.":"Vom ersten Start zu Garmin.",
"Follow these steps in order. You can return to this guide at any time.":"Führe diese Schritte der Reihe nach aus. Du kannst jederzeit zu dieser Anleitung zurückkehren.",
"Step 1 of 4":"Schritt 1 von 4",
"Step {step} of 4":"Schritt {step} von 4",
"Local access":"Lokaler Zugang",
"Connect to the dongle":"Mit dem Dongle verbinden",
"Power the ESP32-C3, join its":"Schalte den ESP32-C3 ein, verbinde dich mit seinem WLAN",
"Wi-Fi, and open":"und öffne",
". Stay on the Wi-Fi if your phone warns that it has no Internet.":". Bleibe mit dem WLAN verbunden, auch wenn dein Handy vor fehlendem Internetzugang warnt.",
"For the Wi-Fi password, open the USB serial monitor at 115200 baud and hold BOOT for two seconds after startup. Read the":"Für das WLAN-Passwort öffne den seriellen USB-Monitor mit 115200 Baud und halte BOOT nach dem Start zwei Sekunden lang gedrückt. Lies das Passwort aus der Zeile",
"line.":"ab.",
"The device uses a self-signed HTTPS certificate; your browser may ask you to inspect and accept it.":"Das Gerät verwendet ein selbstsigniertes HTTPS-Zertifikat. Dein Browser fordert dich möglicherweise auf, es zu prüfen und zu akzeptieren.",
"Create an administrator on first use while holding BOOT. On later visits, sign in with that account.":"Erstelle beim ersten Aufruf einen Administrator und halte dabei BOOT gedrückt. Melde dich später mit diesem Konto an.",
"Hold BOOT for two seconds to reopen the service Wi-Fi if it has timed out.":"Halte BOOT zwei Sekunden lang gedrückt, um das Service-WLAN nach einer automatischen Abschaltung wieder zu öffnen.",
"Collect Orion readout details":"Orion-Readout-Daten ermitteln",
"On your phone, connect to the Orion XS in VictronConnect using its Bluetooth PIN. Enable Instant Readout and note the charger's Bluetooth MAC and its 32-character Instant Readout encryption key from device information.":"Verbinde dein Handy in VictronConnect über die Bluetooth-PIN mit dem Orion XS. Aktiviere Instant Readout und notiere aus den Geräteinformationen die Bluetooth-MAC des Ladegeräts sowie seinen 32-stelligen Verschlüsselungsschlüssel für Instant Readout.",
"Keep the PIN in VictronConnect. The dongle needs the readout key and MAC, not the PIN. Do not store them in the project source.":"Die PIN bleibt in VictronConnect. Der Dongle benötigt den Readout-Schlüssel und die MAC-Adresse, nicht die PIN. Speichere diese Angaben nicht im Projektquelltext.",
"Map the two NMEA channels":"Die beiden NMEA-Kanäle zuordnen",
"Open Setup, enter the Orion MAC and readout key, then choose different battery instance numbers for charger output and input. Both numbers must be between 0 and 252. The defaults are output 0 and input 1; change them if those numbers already represent another battery on your NMEA network.":"Öffne „Einrichtung“, gib die Orion-MAC und den Readout-Schlüssel ein und wähle unterschiedliche Batterieinstanznummern für Ausgang und Eingang. Beide Nummern müssen zwischen 0 und 252 liegen. Vorgabe sind Ausgang 0 und Eingang 1. Ändere sie, wenn diese Nummern in deinem NMEA-Netzwerk bereits einer anderen Batterie zugeordnet sind.",
"Save and let the dongle restart. Rejoin its service Wi-Fi if needed.":"Speichere die Einstellungen und warte auf den Neustart des Dongles. Verbinde dich bei Bedarf erneut mit seinem Service-WLAN.",
"Go to setup":"Zur Einrichtung",
"Verify before sailing":"Vor der Fahrt prüfen",
"Compare Overview values with VictronConnect. Monitor shows BLE reception, stale data, and NMEA transmission results. On the Garmin GPSMAP 723xsv, select the intended battery source or data instances.":"Vergleiche die Werte der „Übersicht“ mit VictronConnect. Der Monitor zeigt BLE-Empfang, veraltete Daten und die Ergebnisse der NMEA-Übertragung. Wähle auf dem Garmin GPSMAP 723xsv die gewünschte Batteriequelle bzw. die passenden Dateninstanzen aus.",
"A bare ESP32-C3 can test the web interface and Bluetooth reception, but needs a CAN transceiver and protected NMEA 2000 connection before Garmin can receive messages.":"Mit einem ESP32-C3 allein kannst du die Weboberfläche und den Bluetooth-Empfang testen. Damit Garmin Meldungen empfangen kann, sind zusätzlich ein CAN-Transceiver und eine geschützte NMEA-2000-Anbindung nötig.",
"This bridge translates Orion telemetry only. It does not create SOC estimates, alarms, or charger commands.":"Diese Bridge übersetzt ausschließlich Orion-Messwerte. Sie erzeugt keine SOC-Schätzungen, Alarme oder Steuerbefehle für das Ladegerät.",
"Open live monitor":"Live-Monitor öffnen",
"Previous":"Zurück",
"Next step":"Nächster Schritt",
"Diagnostics":"Diagnose",
"Message monitor.":"Meldungsmonitor.",
"Recent local events from Bluetooth reception, NMEA output, setup, and portal access. No keys or passwords are shown.":"Aktuelle lokale Ereignisse zu Bluetooth-Empfang, NMEA-Ausgabe, Einrichtung und Portalzugriff. Schlüssel und Passwörter werden nicht angezeigt.",
"BLE age":"Alter der BLE-Daten",
"Output power":"Ausgangsleistung",
"Input power":"Eingangsleistung",
"Charger state":"Ladegerätstatus",
"Charger error":"Ladegerätfehler",
"Off reason":"Abschaltgrund",
"Rejected / failed":"Verworfen / fehlgeschlagen",
"Recent messages":"Aktuelle Meldungen",
"New events appear automatically while this page is open.":"Neue Ereignisse erscheinen automatisch, solange diese Seite geöffnet ist.",
"Waiting for device events…":"Warte auf Geräteereignisse…",
"The timestamps are device uptime in milliseconds. A missing value means the latest Orion data is unavailable or stale.":"Die Zeitstempel geben die Gerätelaufzeit in Millisekunden an. Fehlende Werte bedeuten, dass keine aktuellen Orion-Daten verfügbar sind.",
"Battery Sentinel · Orion Bridge · Local service interface":"Battery Sentinel · Orion Bridge · Lokale Serviceoberfläche",
"Checking credentials…":"Zugangsdaten werden geprüft…",
"Creating account…":"Konto wird erstellt…",
"Saving settings…":"Einstellungen werden gespeichert…",
"Open overview":"Übersicht öffnen",
"Orion details":"Orion-Daten",
"NMEA mapping":"NMEA-Zuordnung",
"Verification":"Prüfung",
"Setup needed":"Einrichtung erforderlich",
"Portal online":"Portal erreichbar",
"Connection interrupted":"Verbindung unterbrochen",
"Sign-in required":"Anmeldung erforderlich",
"Sign in to resume":"Zum Fortfahren anmelden",
"Waiting to reconnect":"Warte auf erneute Verbindung",
"Updated just now":"Soeben aktualisiert",
"Unavailable":"Nicht verfügbar",
"Choose a different instance for input and output.":"Wähle für Eingang und Ausgang unterschiedliche Instanzen.",
"Forget the saved Orion identity and key?":"Gespeicherte Orion-MAC und Readout-Schlüssel löschen?",
"Hold BOOT to continue":"Zum Fortfahren BOOT gedrückt halten",
"Hold the physical BOOT button while creating the administrator account.":"Halte die BOOT-Taste am Gerät gedrückt, während du das Administratorkonto erstellst.",
"Check account details":"Kontodaten prüfen",
"Use a 3–32 character username and a password of at least 12 characters.":"Verwende einen Benutzernamen mit 3–32 Zeichen und ein Passwort mit mindestens 12 Zeichen.",
"Sign-in did not work":"Anmeldung fehlgeschlagen",
"Check the administrator username and password, then try again.":"Prüfe den Benutzernamen und das Passwort des Administrators und versuche es erneut.",
"Session expired":"Sitzung abgelaufen",
"Reload the portal and try your change again.":"Lade das Portal neu und versuche erneut, deine Änderung zu speichern.",
"Could not forget Orion":"Orion konnte nicht entfernt werden",
"The saved identity could not be erased. Restart the dongle and try again.":"Die gespeicherten Gerätedaten konnten nicht gelöscht werden. Starte den Dongle neu und versuche es erneut.",
"Check Orion settings":"Orion-Einstellungen prüfen",
"Enter a valid MAC, a 32-digit Instant Readout key, and two different NMEA instances.":"Gib eine gültige MAC-Adresse, einen 32-stelligen Schlüssel für Instant Readout und zwei unterschiedliche NMEA-Instanzen ein.",
"Login required":"Anmeldung erforderlich",
"Administrator created":"Administrator erstellt",
"Signed in":"Angemeldet",
"Signed out":"Abgemeldet",
"Not found":"Nicht gefunden",
"Unconfigured":"Nicht eingerichtet",
"Stale":"Daten veraltet",
"BLE scan failed":"BLE-Suche fehlgeschlagen",
"Unsupported advertisement":"Nicht unterstütztes Bluetooth-Datenpaket",
"Encryption key mismatch":"Verschlüsselungsschlüssel stimmt nicht überein",
"Truncated or oversized record":"Datensatz unvollständig oder zu groß",
"AES decode failed":"AES-Entschlüsselung fehlgeschlagen",
"Record decode failed":"Datensatz konnte nicht dekodiert werden",
"Implausible decoded values":"Dekodierte Werte unplausibel",
"Receiving":"Datenempfang aktiv",
"Service portal opened":"Serviceportal geöffnet",
"Service portal closed":"Serviceportal geschlossen",
"Administrator provisioned":"Administrator eingerichtet",
"Orion identity and key erased":"Orion-Gerätedaten und Schlüssel gelöscht",
"Orion identity and key saved":"Orion-Gerätedaten und Schlüssel gespeichert",
"Password verification {ms} ms":"Passwortprüfung {ms} ms",
"Orion translation mode started":"Orion-Übersetzungsmodus gestartet",
"Waiting for Orion advertisement":"Warte auf Bluetooth-Datenpaket des Orion",
"Orion identity and key required":"Orion-Gerätedaten und Schlüssel erforderlich",
"Orion data stale":"Orion-Daten veraltet",
"Orion state {state}, output {voltage} V {current} A":"Orion-Status {state}, Ausgang {voltage} V {current} A",
"PGN {pgn}; sent {sent}, failed {failed}":"PGN {pgn}; gesendet {sent}, fehlgeschlagen {failed}",
"; values unavailable":"; Werte nicht verfügbar",
"NMEA submissions accepted":"Akzeptierte NMEA-Sendeaufträge",
"Enter or paste 12 hexadecimal characters. Colons are added automatically.":"12 hexadezimale Zeichen eingeben oder einfügen. Doppelpunkte werden automatisch ergänzt.",
"Your local access is ready":"Dein lokaler Zugang ist bereit",
"You are already connected and signed in. Continue with the Orion details in the next step.":"Du bist bereits verbunden und angemeldet. Fahre im nächsten Schritt mit den Orion-Daten fort.",
"For first connection instructions before joining the dongle, open or save docs/erstverbindung.md from the project README.":"Öffne oder speichere vor der ersten Verbindung die Anleitung docs/erstverbindung.md aus der Projekt-README.",
"Reconnect later":"Später erneut verbinden",
"Access ready":"Zugang bereit",
"Orion received parameters":"Vom Orion empfangene Parameter",
"Output power (calculated)":"Ausgangsleistung (berechnet)",
"Input power (calculated)":"Eingangsleistung (berechnet)",
"Charger state (code)":"Ladegerätstatus (Code)",
"Charger error (code)":"Ladegerätfehler (Code)",
"Off reason (bitmask)":"Abschaltgrund (Bitmaske)",
"Frame counter":"Paketzähler",
"Signal strength":"Signalstärke",
"Data freshness":"Aktualität",
"Orion / Bluetooth":"Orion / Bluetooth",
"Orion errors":"Orion-Fehler",
"Rejected records":"Abgelehnte Datensätze",
"Queue drops":"Verluste durch volle Warteschlange",
"Startup failures":"Startfehler",
"Duplicate frames (ignored)":"Doppelte Pakete (ignoriert)",
"NMEA 2000":"NMEA 2000",
"NMEA errors":"NMEA-Fehler",
"Parameter dashboard.":"Parameter-Dashboard.",
"All decoded Orion parameters and the latest NMEA telemetry submissions, updated automatically.":"Alle dekodierten Orion-Parameter und die letzten NMEA-Telemetrie-Sendeaufträge, automatisch aktualisiert.",
"Counters start at boot. Orion errors include rejected records, queue drops and startup failures; duplicate advertisements are counted separately. NMEA errors count rejected send requests, not confirmations from Garmin.":"Die Zähler beginnen beim Start. Orion-Fehler umfassen abgelehnte Datensätze, Warteschlangenverluste und Startfehler. Doppelte Bluetooth-Pakete zählen separat. NMEA-Fehler zählen abgelehnte Sendeaufträge; eine Empfangsbestätigung von Garmin liegt nicht vor.",
"Resolution and availability":"Auflösung und Verfügbarkeit",
"Electrical values use three decimal places. Orion reports voltage in 0.01 V steps and current in 0.1 A steps; trailing zeros do not add precision. Power is calculated from voltage and current.":"Elektrische Werte erscheinen mit drei Nachkommastellen. Orion liefert Spannung in Schritten von 0,01 V und Strom in Schritten von 0,1 A. Ergänzte Nullen erhöhen die Präzision nicht. Die Leistung wird aus Spannung und Strom berechnet.",
"Codes, counters and instances are integers. Unavailable or stale Orion measurements appear as a dash.":"Codes, Zähler und Instanzen sind Ganzzahlen. Nicht verfügbare oder veraltete Orion-Messwerte erscheinen als Strich.",
"NMEA cards retain the last submission with its age and encoded values. An accepted request does not confirm delivery on the CAN bus. Network management messages are outside this telemetry view.":"Die NMEA-Karten zeigen den letzten Sendeauftrag mit seinem Alter und den kodierten Werten. Ein akzeptierter Auftrag bestätigt keine Zustellung auf dem CAN-Bus. Netzwerkverwaltungsmeldungen sind nicht Teil dieser Telemetrieansicht.",
"NMEA telemetry parameters":"NMEA-Telemetrieparameter",
"Sequence ID":"Sequenz-ID",
"Voltage":"Spannung",
"Current":"Strom",
"Temperature":"Temperatur",
"Battery instance":"Batterieinstanz",
"Charge state (code)":"Ladephase (Code)",
"Charger mode (code)":"Lademodus (Code)",
"Enabled (code)":"Aktiviert (Code)",
"Equalization pending (code)":"Ausgleichsladung anstehend (Code)",
"Equalization time remaining":"Restzeit Ausgleichsladung",
"DC type (code)":"DC-Typ (Code)",
"State of charge":"Ladezustand",
"State of health":"Batteriegesundheit",
"Time remaining":"Restzeit",
"Ripple voltage":"Restwelligkeit",
"Capacity":"Kapazität",
"No NMEA submission data available.":"Keine NMEA-Sendedaten verfügbar.",
"Instance":"Instanz",
"Not submitted yet":"Noch kein Sendeauftrag",
"Last submission accepted":"Letzter Sendeauftrag akzeptiert",
"Last submission failed":"Letzter Sendeauftrag fehlgeschlagen",
"Age":"Alter",
"Fresh":"Aktuell",
"Invalid BLE settings":"Ungültige BLE-Einstellungen",
"BLE queue allocation failed":"BLE-Warteschlange konnte nicht angelegt werden",
"PGN {pgn}; accepted {sent}, failed {failed}":"PGN {pgn}; akzeptiert {sent}, fehlgeschlagen {failed}",
"Input":"Eingang",
"Output":"Ausgang",
"Charger supply":"Versorgung des Ladegeräts",
"To the battery":"Zur Batterie",
"Power (calculated)":"Leistung (berechnet)",
"Settings":"Einstellungen",
"Orion settings.":"Orion-Einstellungen.",
"NMEA status":"NMEA-Status",
"OK":"OK",
"Warning":"Warnung",
"Error":"Fehler",
"Charger reports an error":"Ladegerät meldet einen Fehler",
"Charger switched off":"Ladegerät abgeschaltet",
"Some Orion values are unavailable":"Einige Orion-Werte sind nicht verfügbar",
"Receiving; earlier errors recorded":"Empfang aktiv; frühere Fehler vorhanden",
"NMEA submission failed":"NMEA-Sendeauftrag fehlgeschlagen",
"Waiting for NMEA submissions":"Warte auf NMEA-Sendeaufträge",
"NMEA update overdue":"NMEA-Aktualisierung überfällig",
"Submissions accepted; earlier errors recorded":"Sendeaufträge akzeptiert; frühere Fehler vorhanden",
"Bridge error":"Bridge-Fehler",
"Bridge warning":"Bridge-Warnung",
"Bridge ready":"Bridge bereit",
"Enter the Orion Bluetooth MAC address.":"Gib die Bluetooth-MAC-Adresse des Orion ein.",
"Use only hexadecimal characters (0–9 and A–F).":"Nur hexadezimale Zeichen verwenden: 0–9 und A–F.",
"MAC incomplete: {count} of 12 hexadecimal characters.":"MAC unvollständig: {count} von 12 hexadezimalen Zeichen.",
"The MAC address must contain exactly 12 hexadecimal characters.":"Die MAC-Adresse muss genau 12 hexadezimale Zeichen enthalten.",
"MAC address complete.":"MAC-Adresse vollständig.",
"Enter the 32-character Instant Readout key.":"Gib den 32-stelligen Instant-Readout-Schlüssel ein.",
"Key incomplete: {count} of 32 hexadecimal characters.":"Schlüssel unvollständig: {count} von 32 hexadezimalen Zeichen.",
"The readout key must contain exactly 32 hexadecimal characters.":"Der Readout-Schlüssel muss genau 32 hexadezimale Zeichen enthalten.",
"Readout key complete.":"Readout-Schlüssel vollständig.",
"Key present":"Schlüssel vorhanden",
"Enter the readout key for the new Orion.":"Gib den Readout-Schlüssel für den neuen Orion ein.",
"Leave this field empty to keep the stored key for this Orion. Enter all 32 hexadecimal characters to replace it. A different Orion MAC requires its own key.":"Lass dieses Feld leer, um den gespeicherten Schlüssel für diesen Orion zu behalten. Gib zum Ersetzen alle 32 hexadezimalen Zeichen ein. Eine andere Orion-MAC benötigt ihren eigenen Schlüssel.",
"Enter an integer from 0 to 252.":"Gib eine ganze Zahl von 0 bis 252 ein.",
"Instance valid.":"Instanz gültig.",
"Input · Charger supply":"Eingang · Versorgung des Orion",
"Output · Battery charging":"Ausgang · Batterieladung",
"The input supplies the Orion; the output charges the connected battery. Currents show only the Orion share, not all charging and consumption at each battery.":"Der Eingang versorgt den Orion; der Ausgang lädt die angeschlossene Batterie. Die Ströme zeigen nur den Anteil des Orion, nicht sämtliche Lade- und Verbrauchsströme der jeweiligen Batterie.",
"Battery names":"Batterien benennen",
"Choose a name for each side to identify it in the overview.":"Benenne beide Seiten so, dass du sie in der Übersicht zuordnen kannst.",
"Input alias":"Name für den Eingang",
"Output alias":"Name für den Ausgang",
"Use 1–32 characters and different names for input and output.":"Verwende 1–32 Zeichen und unterschiedliche Namen für Eingang und Ausgang.",
"Save names":"Namen speichern",
"Names are saved immediately; the Orion connection stays active.":"Die Namen werden sofort gespeichert; die Orion-Verbindung bleibt aktiv.",
"Enter an alias with 1 to 32 characters.":"Gib einen Namen mit 1 bis 32 Zeichen ein.",
"Aliases must not contain control characters.":"Namen dürfen keine Steuerzeichen enthalten.",
"Choose different aliases for input and output.":"Wähle unterschiedliche Namen für Eingang und Ausgang.",
"Alias valid.":"Name gültig.",
"Saving aliases…":"Namen werden gespeichert…",
"Check channel names":"Batterienamen prüfen",
"Enter two different names with 1–32 characters and no control characters.":"Gib zwei unterschiedliche Namen mit 1–32 Zeichen und ohne Steuerzeichen ein.",
"Could not save channel names":"Batterienamen konnten nicht gespeichert werden",
"The names could not be saved. Try again.":"Die Namen konnten nicht gespeichert werden. Versuche es erneut.",
"Channel names saved":"Batterienamen gespeichert",
"Manage battery names, Orion connection details and NMEA battery instances.":"Lege Batterienamen, Orion-Verbindungsdaten und NMEA-Batterieinstanzen fest.",
"Device maintenance":"Gerätewartung",
"Firmware update":"Firmware-Update",
"Upload an application firmware .bin file already saved on your phone. No internet connection is needed.":"Lade eine bereits auf deinem Handy gespeicherte Anwendungsfirmware als .bin-Datei hoch. Eine Internetverbindung ist nicht nötig.",
"Installed version":"Installierte Version",
"Device target":"Gerätevariante",
"The device checks the product, processor, image structure, checksum and SHA-256 before activation. Use firmware from a trusted source; these checks do not verify the publisher.":"Das Gerät prüft vor der Aktivierung Produkt, Prozessor, Dateiaufbau, Prüfsumme und SHA-256. Verwende Firmware aus einer vertrauenswürdigen Quelle; diese Prüfungen bestätigen nicht den Herausgeber.",
"Keep the device powered and your phone connected to its Wi-Fi. Live data pauses during the update. The device restarts after successful installation.":"Lass das Gerät eingeschaltet und dein Handy mit seinem WLAN verbunden. Live-Daten pausieren während des Updates. Nach erfolgreicher Installation startet das Gerät neu.",
"Firmware file (.bin)":"Firmware-Datei (.bin)",
"No firmware file selected.":"Keine Firmware-Datei ausgewählt.",
"Reading firmware information…":"Firmware-Informationen werden gelesen…",
"Upload and install":"Hochladen und installieren",
"Cancel upload":"Upload abbrechen",
"Read device information again":"Geräteinformationen erneut lesen",
"Reopen portal":"Portal erneut öffnen",
"Sign in again before updating the firmware.":"Melde dich vor dem Firmware-Update erneut an.",
"Your session changed. Reopen the portal before updating.":"Deine Sitzung hat sich geändert. Öffne das Portal vor dem Update erneut.",
"The device is busy. Wait, then reopen the portal.":"Das Gerät ist beschäftigt. Warte kurz und öffne das Portal erneut.",
"Choose an application firmware .bin file.":"Wähle eine Anwendungsfirmware als .bin-Datei aus.",
"The firmware file is empty or too large for this device.":"Die Firmware-Datei ist leer oder zu groß für dieses Gerät.",
"OTA is unavailable with the current flash layout. A USB installation is required.":"Das aktuelle Flash-Layout unterstützt kein OTA-Update. Eine Installation über USB ist erforderlich.",
"The file is not a valid application firmware image.":"Die Datei ist keine gültige Anwendungsfirmware.",
"This firmware was built for a different product or processor.":"Diese Firmware wurde für ein anderes Produkt oder einen anderen Prozessor erstellt.",
"The firmware checksum is invalid. Download the file again.":"Die Firmware-Prüfsumme ist ungültig. Lade die Datei erneut herunter.",
"The firmware SHA-256 check failed. Download the file again.":"Die SHA-256-Prüfung der Firmware ist fehlgeschlagen. Lade die Datei erneut herunter.",
"The upload was incomplete. The current firmware remains selected.":"Der Upload war unvollständig. Die aktuelle Firmware bleibt ausgewählt.",
"The device could not write the firmware. The current firmware remains selected.":"Das Gerät konnte die Firmware nicht schreiben. Die aktuelle Firmware bleibt ausgewählt.",
"The device rejected the completed firmware. The current firmware remains selected.":"Das Gerät hat die vollständige Firmware abgelehnt. Die aktuelle Firmware bleibt ausgewählt.",
"The new firmware could not be selected for startup.":"Die neue Firmware konnte nicht für den nächsten Start ausgewählt werden.",
"{size} MiB maximum":"Maximal {size} MiB",
"{name} · {size} MiB":"{name} · {size} MiB",
"{percent}% transferred":"{percent}% übertragen",
"Select the firmware file saved on your phone.":"Wähle die auf deinem Handy gespeicherte Firmware-Datei aus.",
"Firmware information could not be read. Check the Wi-Fi connection and try again.":"Die Firmware-Informationen konnten nicht gelesen werden. Prüfe die WLAN-Verbindung und versuche es erneut.",
"Ready to upload. The device checks the complete firmware before activating it.":"Bereit zum Hochladen. Das Gerät prüft die vollständige Firmware vor der Aktivierung.",
"Preparing upload…":"Upload wird vorbereitet…",
"Uploading firmware. Keep this page open and the device powered.":"Firmware wird hochgeladen. Lass diese Seite geöffnet und das Gerät eingeschaltet.",
"Upload complete. The device is validating and installing the firmware…":"Upload abgeschlossen. Das Gerät prüft und installiert die Firmware…",
"The update result is unknown. Reconnect and reopen the portal to check the installed version before trying again.":"Das Update-Ergebnis ist unbekannt. Verbinde dich erneut und öffne das Portal, um vor einem weiteren Versuch die installierte Version zu prüfen.",
"Firmware verified and installed. The device is restarting. Reconnect to its Wi-Fi and reopen the portal.":"Firmware geprüft und installiert. Das Gerät startet neu. Verbinde dich erneut mit seinem WLAN und öffne das Portal.",
"The connection was interrupted. The update result is unknown. Reconnect and check the installed version before trying again.":"Die Verbindung wurde unterbrochen. Das Update-Ergebnis ist unbekannt. Verbinde dich erneut und prüfe vor einem weiteren Versuch die installierte Version.",
"Upload canceled. Reopen the portal and check the installed version before trying again.":"Upload abgebrochen. Öffne das Portal erneut und prüfe vor einem weiteren Versuch die installierte Version.",
"Local notifications · No charger control":"Lokale Benachrichtigungen · Keine Ladesteuerung",
"Insights":"Auswertung",
"Notifications":"Benachrichtigungen",
"Observation":"Beobachtung",
"Voltage and energy.":"Spannung und Energie.",
"Follow both Orion connections over time.":"Beobachte beide Orion-Anschlüsse im Zeitverlauf.",
"Orion input":"Orion-Eingang",
"Orion output":"Orion-Ausgang",
"Voltage history":"Spannungsverlauf",
"Recent voltage observations; gaps remain visible.":"Jüngste Spannungswerte; Datenlücken bleiben sichtbar.",
"Minimum voltage":"Niedrigste Spannung",
"Maximum voltage":"Höchste Spannung",
"Observed Orion charge":"Beobachtete Orion-Ladung",
"Observed Orion energy":"Beobachtete Orion-Energie",
"Values are measured at the Orion input and output. Charge and energy totals cover only the observed Orion flow, not all battery use. Missing data is excluded. Observations restart when the bridge restarts.":"Die Werte werden am Orion-Eingang und -Ausgang gemessen. Ladungs- und Energiesummen erfassen nur den beobachteten Orion-Stromfluss, nicht den gesamten Batterieverbrauch. Fehlende Daten werden ausgelassen. Nach einem Neustart beginnt die Beobachtung erneut.",
"Stay informed":"Informiert bleiben",
"Notifications.":"Benachrichtigungen.",
"Set voltage limits separately for each Orion connection.":"Lege für jeden Orion-Anschluss eigene Spannungsgrenzen fest.",
"Enable notifications":"Benachrichtigungen aktivieren",
"Warnings stay active during charging. Acknowledging a warning does not clear its cause.":"Spannungswarnungen gelten auch beim Laden. Das Bestätigen einer Warnung behebt ihre Ursache nicht.",
"Repeat unacknowledged warnings every (min)":"Unbestätigte Warnungen wiederholen nach (min)",
"Use 0 to turn off reminders.":"Mit 0 werden Wiederholungen ausgeschaltet.",
"Low voltage warning":"Unterspannung melden",
"High voltage warning":"Überspannung melden",
"Warn below (V)":"Warnen unter (V)",
"Clear above (V)":"Entwarnen über (V)",
"Warn above (V)":"Warnen über (V)",
"Clear below (V)":"Entwarnen unter (V)",
"Confirm warning for (s)":"Warnbedingung bestätigen für (s)",
"Confirm clear for (s)":"Entwarnung bestätigen für (s)",
"Notify when Orion data is missing":"Fehlende Orion-Daten melden",
"Confirm missing data for (s)":"Fehlende Daten bestätigen für (s)",
"Notify about Orion charger errors":"Orion-Ladefehler melden",
"Request Garmin notifications":"Garmin-Benachrichtigungen anfordern",
"Save notifications":"Benachrichtigungen speichern",
"Network time":"Netzwerkzeit",
"Estimated time":"Geschätzte Zeit",
"Backdated time":"Nachträglich zugeordnete Zeit",
"Device uptime":"Gerätelaufzeit",
"Acquiring network time":"Netzwerkzeit wird geprüft",
"Time source needs review":"Zeitquelle muss geprüft werden",
"Uptime {seconds} s":"Laufzeit {seconds} s",
"Voltage history from {min} to {max} V":"Spannungsverlauf von {min} bis {max} V",
"Waiting for observations":"Warte auf Beobachtungen",
"Observations since this start":"Beobachtungen seit diesem Start",
"Voltage trend: {rate} V/min over {minutes} min":"Spannungstrend: {rate} V/min über {minutes} min",
"Not enough observations for a voltage trend":"Noch nicht genug Werte für einen Spannungstrend",
"{coverage}% voltage coverage · {minutes} min of energy observations":"{coverage}% Spannungsabdeckung · {minutes} min Energiebeobachtung",
"Calendar time unavailable; observations use device uptime.":"Kalenderzeit nicht verfügbar; die Beobachtung verwendet die Gerätelaufzeit.",
"The clear voltage must be above the low threshold.":"Die Entwarnungsspannung muss über der Unterspannungsgrenze liegen.",
"The clear voltage must be below the high threshold.":"Die Entwarnungsspannung muss unter der Überspannungsgrenze liegen.",
"Waiting for saved settings…":"Gespeicherte Einstellungen werden geladen…",
"Saving notifications…":"Benachrichtigungen werden gespeichert…",
"Check the voltage thresholds and time values.":"Prüfe die Spannungsgrenzen und Zeitangaben.",
"Unsaved changes":"Ungespeicherte Änderungen",
"Settings are up to date":"Einstellungen sind aktuell",
"Notifications enabled":"Benachrichtigungen aktiv",
"Notifications disabled":"Benachrichtigungen ausgeschaltet",
"Garmin delivery available":"Garmin-Zustellung verfügbar",
"Garmin delivery is not yet verified. Local notifications remain available.":"Die Zustellung an Garmin ist noch nicht bestätigt. Lokale Benachrichtigungen bleiben verfügbar.",
"No active notifications":"Keine aktiven Benachrichtigungen",
"Notification":"Benachrichtigung",
"Input voltage low":"Unterspannung am Eingang",
"Output voltage low":"Unterspannung am Ausgang",
"Input voltage high":"Überspannung am Eingang",
"Output voltage high":"Überspannung am Ausgang",
"Orion data missing":"Orion-Daten fehlen",
"Acknowledged":"Bestätigt",
"Needs attention":"Bitte prüfen",
"Waiting for fresh data":"Warte auf aktuelle Daten",
"Acknowledge":"Bestätigen",
"Notification acknowledged":"Benachrichtigung bestätigt",
"Notification settings saved":"Benachrichtigungseinstellungen gespeichert",
"Events use UTC when a trusted network clock is available; otherwise they show device uptime. Earlier events from this start receive estimated calendar times once the clock is known.":"Ereignisse zeigen UTC, sobald eine geprüfte Netzwerkzeit verfügbar ist, sonst die Gerätelaufzeit. Frühere Ereignisse dieses Starts erhalten nachträglich geschätzte Kalenderzeiten.",
"Check notification settings":"Benachrichtigungseinstellungen prüfen",
"Enter valid voltage thresholds and durations. The clear thresholds must be on the safe side of the warning thresholds.":"Gib gültige Spannungsgrenzen und Zeitangaben ein. Die Entwarnungsgrenzen müssen auf der sicheren Seite der Warngrenzen liegen.",
"Could not save notifications":"Benachrichtigungen konnten nicht gespeichert werden",
"The notification settings could not be saved. Your previous settings are unchanged.":"Die Benachrichtigungseinstellungen konnten nicht gespeichert werden. Deine bisherigen Einstellungen bleiben unverändert.",
"Notification changed":"Benachrichtigung geändert",
"This notification is no longer active or has changed. Reload the portal.":"Diese Benachrichtigung ist nicht mehr aktiv oder wurde geändert. Lade das Portal neu.",
"Notifications saved":"Benachrichtigungen gespeichert",
"Review and save the notification settings.":"Prüfe und speichere die Benachrichtigungseinstellungen.",
"Garmin notifications are unavailable in this firmware. Local notifications remain available.":"Garmin-Benachrichtigungen sind in dieser Firmware nicht verfügbar. Lokale Benachrichtigungen bleiben verfügbar.",
"Garmin delivery needs a test on your chartplotter. Acknowledgement in this portal.":"Die Garmin-Zustellung muss an deinem Kartenplotter geprüft werden. Bestätige Benachrichtigungen in diesem Portal.",
"Input low voltage":"Unterspannung am Eingang",
"Output low voltage":"Unterspannung am Ausgang",
"Input high voltage":"Überspannung am Eingang",
"Output high voltage":"Überspannung am Ausgang",
"Orion data unavailable":"Orion-Daten nicht verfügbar",
"Orion charger error":"Orion-Ladefehler",
"Activated":"Ausgelöst",
"Cleared":"Entwarnt",
"Cancelled":"Aufgehoben",
"Reminder":"Erinnerung",
"System time synchronized":"Systemzeit synchronisiert",
"System time holdover":"Systemzeit wird fortgeführt",
"System time unavailable":"Systemzeit nicht verfügbar",
"System time conflict":"Konflikt der Systemzeit",
"The low clear voltage must be below the high clear voltage.":"Die untere Entwarnungsspannung muss unter der oberen Entwarnungsspannung liegen.",
"Alerts":"Meldungen",
"This bridge forwards Orion telemetry and can warn about configured limits. It does not estimate battery state of charge or control the charger.":"Die Bridge überträgt Orion-Messwerte und kann bei eingestellten Grenzwerten warnen. Sie schätzt keinen Batterie-Ladezustand und steuert das Ladegerät nicht.",
"Observed time below {voltage} V":"Beobachtete Zeit unter {voltage} V",
"Notification status unavailable. Reconnect to check warnings.":"Meldungsstatus nicht verfügbar. Verbinde dich erneut, um Warnungen zu prüfen.",
"Active warnings: {count} · unacknowledged: {pending}":"Aktive Meldungen: {count} · unbestätigt: {pending}",
"Some Garmin notifications are waiting. Check active warnings in this portal.":"Einige Garmin-Meldungen warten auf Zustellung. Prüfe aktive Warnungen in diesem Portal.",
"Withdrawal of earlier Garmin warnings is unconfirmed. Check the chartplotter; an old warning may remain.":"Das Zurücknehmen früherer Garmin-Warnungen ist unbestätigt. Prüfe den Kartenplotter; eine alte Warnung kann noch angezeigt werden.",
"View notifications":"Meldungen öffnen"
};</script>)I18N";

} // namespace bs::ui
