Weisni/BatterySentinel-N2K/tools/altium_3d.py

"""Editable Altium extruded component models for the Orion carrier.

These are locally generated package/assembly envelopes, not supplier STEP files.
Colours, markings and the SuperMini on-board parts are illustrative.  PCB pad
locations and selected package outlines come from the shared design model.
All lengths are millimetres; Z=0 is the carrier's top surface.

The binary body layout is verified against Altium's installed example PcbLibs.
No geometry or third-party model payload is copied from those libraries.
"""
from __future__ import annotations

from dataclasses import asdict, dataclass
import argparse
import json
import math
from pathlib import Path
import struct
import subprocess
import uuid

from altium_pcb import footprint, mil, transform, record, base
from altium_libraries import read_cfb_streams, write_cfb_streams

MODEL_NAMESPACE = uuid.UUID('2bbf8d9d-7543-4f7b-ae2f-9a5e8754113e')
SILVER = (179, 188, 198)
DARK = (40, 43, 47)
GOLD = (207, 163, 58)
CERAMIC = (180, 146, 100)
GREEN = (27, 91, 77)


@dataclass(frozen=True)
class Body:
    name: str
    outline: tuple[tuple[float, float], ...]
    z0: float
    z1: float
    rgb: tuple[int, int, int]


def rectangle(name, x, y, width, depth, z0, z1, colour):
    return Body(name, ((x-width/2, y-depth/2), (x+width/2, y-depth/2),
                       (x+width/2, y+depth/2), (x-width/2, y+depth/2)),
                z0, z1, colour)


def cylinder(name, x, y, radius, z0, z1, colour, segments=32):
    return Body(name, tuple((x+radius*math.cos(i*2*math.pi/segments),
                            y+radius*math.sin(i*2*math.pi/segments)) for i in range(segments)),
                z0, z1, colour)


def bodies_for(part):
    """Return component-local extrusions, including recognisable leads/details."""
    if part.get('bodies_3d'):
        return [Body(b['name'],tuple(tuple(p) for p in b['outline']),b['z0'],b['z1'],tuple(b['rgb']))
                for b in part['bodies_3d']]
    ref = part['ref']
    fp = footprint(part)
    w, d = fp.body
    h = max(fp.height, .1)
    bodies = []
    if ref == 'MCU1':
        # Nologo top view: USB at +Y, antenna at -Y.  Direct-soldered 2.54 mm
        # headers, not sockets. Module/component Z is an assembly assumption.
        for side, x in [('left', -7.62), ('right', 7.62)]:
            ys = [p.y for p in fp.pads if abs(p.x-x) < .05]
            bodies.append(rectangle(side+' header insulator', x, (min(ys)+max(ys))/2,
                                    2.54, max(ys)-min(ys)+2.54, .1, 2.6, DARK))
        for p in fp.pads:
            bodies.append(rectangle('header '+p.number, p.x, p.y, .64, .64,
                                    -2.5, 4.0, GOLD))
        bodies += [rectangle('module PCB', 0, 0, w, d, 2.6, 3.6, GREEN),
                   rectangle('ESP32-C3 package envelope', 0, -1.5, 5, 5, 3.6, 4.55, DARK),
                   rectangle('USB-C shell top', 0, d/2-3.1, 8.8, 7.2, 6.35, 6.7, SILVER),
                   rectangle('USB-C shell bottom', 0, d/2-3.1, 8.8, 7.2, 3.6, 3.95, SILVER),
                   rectangle('USB-C shell left', -4.25, d/2-3.1, .3, 7.2, 3.95, 6.35, SILVER),
                   rectangle('USB-C shell right', 4.25, d/2-3.1, .3, 7.2, 3.95, 6.35, SILVER),
                   rectangle('USB-C tongue', 0, d/2-1.6, 6.5, 3.6, 5.0, 5.35, DARK),
                   rectangle('ceramic antenna envelope', 0, -d/2+1.2, 3.2, 1.6, 3.6, 4.65, (196, 173, 125)),
                   rectangle('reset switch base', -5.8, 2.3, 3.3, 3.3, 3.6, 4.2, SILVER),
                   rectangle('reset switch cap', -5.8, 2.3, 1.6, 1.6, 4.2, 4.7, DARK),
                   rectangle('boot switch base', 5.8, 2.3, 3.3, 3.3, 3.6, 4.2, SILVER),
                   rectangle('boot switch cap', 5.8, 2.3, 1.6, 1.6, 4.2, 4.7, DARK)]
        # At least 3 mm clear space under the module for carrier passives.
        # Pins retain their penetration through the carrier; only the module
        # and its components move up with the taller insulating spacers.
        raised = []
        for body in bodies:
            if body.name.endswith('header insulator'):
                raised.append(Body(body.name, body.outline, body.z0, 3.1, body.rgb))
            elif body.name.startswith('header '):
                raised.append(Body(body.name, body.outline, body.z0, 4.5, body.rgb))
            else:
                raised.append(Body(body.name, body.outline, body.z0+.5, body.z1+.5, body.rgb))
        return raised
    if ref == 'J1':
        # J1 is a soldered pigtail, never imply a selected connector housing.
        colours = [(145, 151, 162), (184, 46, 47), (38, 40, 45), (226, 225, 213), (62, 108, 175)]
        for p, colour in zip(fp.pads, colours):
            bodies += [cylinder('wire '+p.number+' conductor', p.x, p.y, .35, -1.8, 1.8, SILVER),
                       cylinder('wire '+p.number+' insulation', p.x, p.y, .8, 1.8, 6, colour)]
        return bodies
    if ref.startswith('TP'):
        return [cylinder('exposed test pad', 0, 0, 1, 0, .035, GOLD)]
    if ref == 'JP1':
        bodies.append(rectangle('header insulator', 0, 0, w, d, .1, 2.6, DARK))
        for p in fp.pads:
            bodies.append(rectangle('header '+p.number, p.x, p.y, .64, .64, -2.5, 6, GOLD))
        # A removable shunt fitted in normal operation. No assumed exact MPN.
        bodies += [rectangle('removable shunt', 0, 0, 5.1, 2.5, 3.2, 6.8, (42, 83, 128)),
                   rectangle('shunt grip', 0, 0, 4.2, 2.3, 6.8, 7.2, (49, 95, 143))]
        return bodies
    if ref in {'C1', 'C6'}:
        model = part.get('model_3d', {})
        smd = model.get('style') == 'smd_electrolytic'
        diameter = model.get('can_diameter_nominal', w)
        bodies += [cylinder('aluminium can' if smd else 'electrolytic sleeve', 0, 0, diameter/2,
                            .6 if smd else .3, h-.3, SILVER if smd else (35, 49, 59)),
                   cylinder('aluminium top', 0, 0, max(.1, diameter/2-.25), h-.3, h, SILVER),
                   rectangle('vent groove X', 0, 0, diameter*.55, .08, h, h+.015, DARK),
                   rectangle('vent groove Y', 0, 0, .08, diameter*.55, h, h+.015, DARK),
                   rectangle('negative polarity stripe', diameter/2-.15, 0, .3, diameter*.3,
                             .7 if smd else .5, h-.5, DARK if smd else (155, 167, 179))]
        if any(p.drill for p in fp.pads):
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
