Weisni/BatterySentinel-N2K/(commit log)

2026-08-27 Initialize BatterySentinel N2K project
2026-08-27 Add V1 battery and hardware configuration
2026-08-27 Add platform-independent battery model API
2026-08-27 Add deterministic battery scenario simulator
2026-08-27 Add INA238 measurement driver interface
2026-08-27 Implement INA238 raw voltage and shunt-current measurement
2026-08-27 Implement dual battery NMEA 2000 PGN publishing
2026-08-27 Add ESP32-C3 V1 firmware application
2026-08-27 Add CI for TDD, simulator and ESP32-C3 firmware
2026-08-27 Use tested INA238 scaling and auto-recover missing sensors
    [Ina238.cpp]
2026-08-27 Optimize V1 power tree with low-cost isolated bow supply
2026-08-27 Update architecture for cost-optimized isolated power tree
2026-08-27 Harden NMEA SOC clamping for ESP32 Arduino macros
2026-08-27 Fix simulator standard library includes
    [main.cpp]
2026-08-27 Clear stale measurement alarms on sensor fault
2026-08-28 Correct system battery spec from GTIN and retain 500A shunts
    [config.h]
2026-08-28 Define diagnostics portal, OTA, logging and power-loss behavior
2026-08-28 Update architecture for diagnostics, logging and corrected system battery
2026-08-28 Refresh README for DA80 battery, diagnostics and logging
2026-08-28 Add configurable battery chemistry profiles
2026-08-28 Use runtime battery profiles and boot diagnostics portal
2026-08-28 Add TDD coverage for configurable battery profiles
2026-08-28 Add 8 MB dual-slot OTA partition table
    [partitions_8mb_ota.csv]
2026-08-28 Configure 8 MB flash and dual-slot OTA
2026-08-28 Fix charger-voltage SOC test semantics
2026-08-28 Add native ESP32-C3 TWAI NMEA2000 backend
2026-08-28 Implement ESP32-C3 TWAI NMEA2000 backend
2026-08-28 Use native ESP32-C3 TWAI NMEA backend
2026-08-28 Remove legacy ESP32 CAN driver and enforce C++17
2026-08-28 Make OCV correction configurable per battery chemistry
2026-08-28 Add dual-slot I2C FRAM state store
2026-08-28 Implement dual-slot I2C FRAM state store
2026-08-28 Document configurable battery profiles and optional second channel
2026-08-28 Add initial interactive BatterySentinel browser simulator
2026-08-28 Style BatterySentinel browser simulator
2026-08-28 Add BatterySentinel Lab browser simulator UI
2026-08-28 Style BatterySentinel Lab browser simulator
2026-08-28 Implement interactive BatterySentinel Lab simulation
2026-08-28 Implement interactive Wokwi INA238 I2C model
2026-08-28 Add GitHub Pages deployment for BatterySentinel Lab
2026-08-28 Fix Wokwi INA238 C99 bool include
    [ina238.chip.c]
2026-08-28 Add runnable Wokwi ESP32-C3 circuit
2026-08-28 Validate Wokwi circuit in CI
2026-08-28 Add ignition switch to Wokwi circuit
2026-08-28 Fix Wokwi GPIO21 pin alias
2026-09-20 initial test
    [partitions_4mb_ota.csv]
2026-09-20 Add Orion NMEA 2000 hardware reference
    [orion-dongle-bom.csv]
2026-10-10 Capture current Orion-R5 project and accept Wi-Fi heating behavior
    Include the current bridge firmware, authenticated OTA and portal diagnostics,
    native and integration checks, Altium hardware, enclosure deliverables, assembly
    documentation and German manual with device-specific service-Wi-Fi QR generation.
    Record the user's final Wi-Fi heating assessment and slow cooling. Retain normal
    Wi-Fi settings and discard the reduced-power experiment from the project snapshot.
    Preserve the existing two-second OLED page cadence and align its tests and guide.
    Refresh standard/debug firmware artifacts and checksums. Exclude temporary QA
    dependencies, editor caches and private device access documents.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
